wuzipu123/software/Electronic/battery_charger/parts.xlsx

ref | value5 | footprint | part | Link
C1 | 220pF | Capacitors_SMD:C_0805 | C | DigiKey
C10 | 4,7µF | Capacitors_SMD:C_0805 | C | Lagernd (geringe Anzahl)
C11 | 47nF | Capacitors_SMD:C_0805 | C | Schukat
C12 | 10nF | Capacitors_SMD:C_0805 | C | Schukat
C13 | 22pF | Capacitors_SMD:C_0805 | C | DigiKey
C14 | 1,8nF | Capacitors_SMD:C_0805 | C | DigiKey
C15 | 47nF | Capacitors_SMD:C_0805 | C | Schukat
C16 | 10nF | Capacitors_SMD:C_0805 | C | Schukat
C17 | 0,1µF | Capacitors_SMD:C_0805 | C | Lagernd
C18 | 0,1µF | Capacitors_SMD:C_0805 | C | Lagernd
C19 | 22µF | Capacitors_SMD:C_0805 | C | DigiKey
C2 | 1μF | Capacitors_SMD:C_0805 | C | Lagernd
C20 | 22µF | Capacitors_SMD:C_0805 | C | DigiKey
C21 | 10µF | Capacitors_SMD:C_0805 | C | Lagernd
C22 | 10µF | Capacitors_SMD:C_0805 | C | Lagernd
C23 | 22µF | Capacitors_SMD:C_0805 | C | DigiKey
C24 | 22µF | Capacitors_SMD:C_0805 | C | DigiKey
C3 | 0,47μF | Capacitors_SMD:C_0805 | C | DigiKey
C4 | 10µF | Capacitors_SMD:C_0805 | C | Lagernd
C5 | 10μF | Capacitors_SMD:C_0805 | C | Lagernd
C6 | 10μF | Capacitors_SMD:C_0805 | C | Lagernd
C7 | 0,33μF | Capacitors_SMD:C_0805 | C | DigiKey
C8 | 1μF | Capacitors_SMD:C_0805 | C | Lagernd
C9 | 22µF | Capacitors_SMD:C_0805 | C | DigiKey
D1 | MBRS340T3 | Diodes_SMD:D_SMC | D_Schottky | https://at.rs-online.com/web/p/gleichrichterdioden-und-schottky-dioden/5452080/
D2 | MBRS340T3 | Diodes_SMD:D_SMC | D_Schottky | https://at.rs-online.com/web/p/gleichrichterdioden-und-schottky-dioden/5452080/
D3 | MBRS340T3 | Diodes_SMD:D_SMC | D_Schottky | https://at.rs-online.com/web/p/gleichrichterdioden-und-schottky-dioden/5452080/
D4 | MBRS340T3 | Diodes_SMD:D_SMC | D_Schottky | https://at.rs-online.com/web/p/gleichrichterdioden-und-schottky-dioden/5452080/
D5 | LED | LEDs:LED_0603 | LED | Lagernd
D6 | LED | LEDs:LED_0603 | LED | Lagernd
D7 | LED | LEDs:LED_0603 | LED | Lagernd
D8 | LED | LEDs:LED_0603 | LED | Lagernd
D9 | BAT-54 | Diodes_SMD:D_SOT-23_ANK | D_Schottky | https://www.digikey.at/product-detail/de/diodes-incorporated/BAT54-7-F/BAT54-FDICT-ND/717819
J1 | Conn_01x02_Female | Connectors_Phoenix:PhoenixContact_MCV-G_02x5.08mm_Vertical | Conn_01x02_Female | Lagernd
J2 | Conn_01x04_Female | Connectors_Phoenix:PhoenixContact_MCV-G_04x5.08mm_Vertical | Conn_01x04_Female | Lagernd (2 Stück 01x02)
J3 | Conn_01x02_Female | Connectors_Phoenix:PhoenixContact_MCV-G_02x5.08mm_Vertical | Conn_01x02_Female | https://at.rs-online.com/web/p/leiterplatten-printklemmen/1930564/
L1 | 20μH | Inductors_SMD:L_Wuerth_WE-PDF_Handsoldering | L | https://at.rs-online.com/web/p/drahtgewickelte-smd-induktivitaten/7896962/
L2 | 3,3µH | Footprints:L_Wuerth_WE-PD-6033_Handsoldering | L | https://at.rs-online.com/web/p/products/7981552/
Q1 | Q_NMOS_GDS | TO_SOT_Packages_SMD:SOT-223-3_TabPin2 | Q_NMOS_GDS | https://at.rs-online.com/web/p/products/7931055/
R1 | 2,7k | Resistors_SMD:R_0805 | R | DigiKey
R10 | 220Ω | Resistors_SMD:R_0805 | R | Lagernd
R11 | 1k | Resistors_SMD:R_0805 | R | Lagernd
R12 | 820R | Resistors_SMD:R_0805 | R | DigiKey
R13 | 330Ω | Resistors_SMD:R_0805 | R | Lagernd
R14 | 4,7k | Resistors_SMD:R_0805 | R | Schukat
R15 | 47k | Resistors_SMD:R_0805 | R | Schukat
R16 | 0R | Resistors_SMD:R_0805 | R | Schukat
R17 | 330k | Resistors_SMD:R_0805 | R | Schukat
R18 | DNP | Resistors_SMD:R_0805 | R
R19 | 39k | Resistors_SMD:R_0805 | R | Schukat
R2 | 4,7k | Resistors_SMD:R_0805 | R | Schukat
R20 | 100k | Resistors_SMD:R_0805 | R | Lagernd
R21 | 390k | Resistors_SMD:R_0805 | R | Schukat
R22 | 820R | Resistors_SMD:R_0805 | R | DigiKey
R23 | 820R | Resistors_SMD:R_0805 | R | DigiKey
R24 | 820R | Resistors_SMD:R_0805 | R | DigiKey
R25 | 270k | Resistors_SMD:R_0805 | R | Lagernd
R26 | 56k | Resistors_SMD:R_0805 | R | Schukat
R27 | 100k | Resistors_SMD:R_0805 | R | Lagernd
R28 | 0R | Resistors_SMD:R_0805 | R | Schukat
R29 | 0R | Resistors_SMD:R_0805 | R | Schukat
R3 | 470Ω | Resistors_SMD:R_0805 | R | Lagernd
R30 | 0R | Resistors_SMD:R_0805 | R | Schukat
R31 | DNP | Resistors_SMD:R_0805 | R
R32 | 0,100Ω | Resistors_SMD:R_1206 | R | https://at.rs-online.com/web/p/products/0566058/
R33 | 0,100Ω | Resistors_SMD:R_1206 | R | https://at.rs-online.com/web/p/products/0566058/
R34 | 0,100Ω | Resistors_SMD:R_1206 | R | https://at.rs-online.com/web/p/products/0566058/
R35 | 0,100Ω | Resistors_SMD:R_1206 | R | https://at.rs-online.com/web/p/products/0566058/
R4 | 0,100Ω | Resistors_SMD:R_1206 | R | https://at.rs-online.com/web/p/products/0566058/
R5 | 180k | Resistors_SMD:R_0805 | R | Schukat
R6 | 0,100Ω | Resistors_SMD:R_1206 | R | https://at.rs-online.com/web/p/products/0566058/
R7 | 120k | Resistors_SMD:R_0805 | R | Schukat
R8 | 220Ω | Resistors_SMD:R_0805 | R | Lagernd
R9 | 220k | Resistors_SMD:R_0805 | R | Schukat
U1 | LT1511 | Footprints:TSOP-II-32_21.0x10.2mm_Pitch1.27mm | LT1511 | https://www.digikey.at/product-detail/de/linear-technology-analog-devices/LT1511CSW-PBF/LT1511CSW-PBF-ND/891021
U2 | LTC3118 | Housings_SSOP:TSSOP-28-1EP_4.4x9.7mm_Pitch0.65mm | LTC3118 | https://www.digikey.at/product-detail/de/linear-technology-analog-devices/LTC3118EFE-PBF/LTC3118EFE-PBF-ND/5171464
