wuzipu123/software/Electronic/Sensor_Node_LoRa_SPS30/BOM.xlsx

Sheet: SensMat_LoRa_SPS30_15Pcs.
Source: | SensMat/Electronic/Sensor_Node_LoRa_SPS30/Sensor_Node_LoRa_SPS30.sch
Date: | Do 10 May 2021 10:51:11
Tool: | Eeschema 5.1.8
Generator: | /usr/share/kicad/plugins/bom_csv_grouped_by_value_with_fp.py
Component Count: | 111
Ref | Qnty | Order | Value | Cmp name | Footprint | Description | Digikey Nr. | Digikey-Link
BT1, | 1 |  | Battery_Cell | Battery_Cell | Battery:BatteryHolder_Keystone_2998_1x6.8mm | Single-cell battery holder | 36-2998-ND | https://www.digikey.at/products/de?keywords=36-2998-ND
C1, C7, C8, C9, C10, C13, C14, C15, C16, C17, C18, C19, C20, C21, C23, C28, C29, C32, C33, | 19 |  | 100nF | C | Capacitor_SMD:C_0603_1608Metric_Pad1.05x0.95mm_HandSolder | Unpolarized capacitor | 1276-1857-1-ND | https://www.digikey.at/products/de?keywords=1276-1857-1-ND
C2, C3, C4, C5, | 4 |  | 15pF | C | Capacitor_SMD:C_0603_1608Metric_Pad1.05x0.95mm_HandSolder | Unpolarized capacitor | 1276-1296-1-ND | https://www.digikey.at/products/de?keywords=1276-1296-1-ND
C6, C11, | 2 |  | 4.7µF | C | Capacitor_SMD:C_0603_1608Metric_Pad1.05x0.95mm_HandSolder | Unpolarized capacitor | 1276-1907-1-ND | https://www.digikey.at/products/de?keywords=1276-1907-1-ND
C12, C34, C35, | 3 |  | 1uF | C | Capacitor_SMD:C_0603_1608Metric_Pad1.05x0.95mm_HandSolder | Unpolarized capacitor | 1276-1182-1-ND | https://www.digikey.at/products/de?keywords=1276-1182-1-ND
C22, | 1 |  | 0.47uF | C | Capacitor_SMD:C_0603_1608Metric_Pad1.05x0.95mm_HandSolder | Unpolarized capacitor | 1276-1895-1-ND | https://www.digikey.at/products/de?keywords=1276-1895-1-ND
C24, C36, C37, | 3 |  | 22uF | C | Capacitor_SMD:C_0603_1608Metric_Pad1.05x0.95mm_HandSolder | Unpolarized capacitor | 445-9077-1-ND | https://www.digikey.at/products/de?keywords=445-9077-1-ND
C25, C26, C27, | 3 |  | 10uF | C | Capacitor_SMD:C_0603_1608Metric_Pad1.05x0.95mm_HandSolder | Unpolarized capacitor | 587-6023-1-ND | https://www.digikey.at/products/de?keywords=587-6023-1-ND
C30, C31, | 2 |  | 6.8pF | C | Capacitor_SMD:C_0603_1608Metric_Pad1.05x0.95mm_HandSolder | Unpolarized capacitor | 1276-1793-1-ND | https://www.digikey.at/products/de?keywords=1276-1793-1-ND
D1, D2, D3, | 3 |  | LED (green) | LED | LED_SMD:LED_0603_1608Metric_Pad1.05x0.95mm_HandSolder | Light emitting diode green | 732-4980-1-ND | https://www.digikey.at/products/de?keywords=732-4980-1-ND
D4, | 1 |  | LED_Dual_red_green | LED_Dual_CCAA | LED_SMD:LED_WUERTH_WL-SBCD_0805 | Dual LED, cathodes on pins 1 and 2 | 732-150080RV54050CT-ND | https://www.digikey.at/products/de?keywords=732-150080RV54050CT-ND
D5, | 1 |  | LED (yellow) | LED | LED_SMD:LED_0603_1608Metric_Pad1.05x0.95mm_HandSolder | Light emitting diode yellow | 732-4981-6-ND | https://www.digikey.at/products/de?keywords=732-4981-6-ND
D6, D7, | 2 |  | B330 | B330 | Diode_SMD:D_SMB-SMC_Universal_Handsoldering | 30V 3A Schottky Barrier Rectifier Diode, SMC | B330-FDICT-ND | https://www.digikey.at/products/de?keywords=B330-FDICT-ND
D8, | 1 |  | SMAJ8.5A | 5KPxxA | Diode_SMD:D_SMA | 5000W unidirectional Transient Voltage Suppressor, P-600 | SMAJ8.5A-FDICT-ND | https://www.digikey.at/products/de?keywords=SMAJ8.5A-FDICT-ND
FB1, | 1 |  | Ferrite_Bead | Ferrite_Bead | Inductor_SMD:L_0805_2012Metric_Pad1.15x1.40mm_HandSolder | Ferrite bead | 541-4362-1-ND | https://www.digikey.at/products/de?keywords=541-4362-1-ND
J1, | 1 |  | Conn_01x06_Male | Conn_01x06_Male | Connector_PinHeader_2.54mm:PinHeader_1x06_P2.54mm_Vertical | Generic connector, single row, 01x06, |  | https://www.digikey.at/products/de?keywords=
J2, | 1 |  | Conn_01x03_Male | Conn_01x03_Male | Connector_PinHeader_2.54mm:PinHeader_1x03_P2.54mm_Vertical | Generic connector, single row, 01x03, |  | https://www.digikey.at/products/de?keywords=
J3, | 1 |  | USB_B_Micro | USB_B_Micro | Connector_USB:USB_Micro-B_GCT_USB3076-30-A | USB Micro Type B connector | 2073-USB3076-30-ACT-ND | https://www.digikey.at/products/de?keywords=2073-USB3076-30-ACT-ND
J4, | 1 |  | Conn_01x05 | Conn_01x05 | Connector_JST:JST_ZH_B5B-ZH-R_1x05_P1.50mm_Vertical | Generic connector, single row, 01x05, | 455-1660-ND | https://www.digikey.at/products/de?keywords=455-1660-ND
J5, | 1 |  | Micro_SD_Card_Det | Micro_SD_Card_Det | Connector_Card:microSD_HC_Hirose_DM3AT-SF-PEJM5 | Micro SD Card Socket with card detection pins | HR1964CT-ND | https://www.digikey.at/products/de?keywords=HR1964CT-ND
J6, | 1 |  | Barrel_Jack_Switch | Barrel_Jack_Switch | Connector_BarrelJack:BarrelJack_CUI_PJ-051A_Horizontal | DC Barrel Jack with an internal switch | CP-051A-ND | https://www.digikey.at/products/de?keywords=CP-051A-ND
J7, | 1 |  | Conn_01x02_Male | Conn_01x02_Male | Connector_PinSocket_2.54mm:PinSocket_1x02_P2.54mm_Vertical | Generic connector, single row, 01x02, | 900-0022053021-ND | https://www.digikey.at/products/de?keywords=900-0022053021-ND
JP1, JP2, JP3, | 3 |  | SolderJumper_2_Open | SolderJumper_2_Open | Jumper:SolderJumper-2_P1.3mm_Open_TrianglePad1.0x1.5mm | Solder Jumper, 2-pole, open |  | https://www.digikey.at/products/de?keywords=
L1, | 1 |  | 6.8uH | L | Inductor_SMD:L_Wuerth_LQS-6045 | Inductor | 732-5547-1-ND | https://www.digikey.at/products/de?keywords=732-5547-1-ND
L2, L3, | 2 |  | 10uH | L | Inductor_SMD:L_Wuerth_LQS-5040 | Inductor | 732-5519-1-ND | https://www.digikey.at/products/de?keywords=732-5519-1-ND
Q1, | 1 |  | BSS138 | BSS138 | Package_TO_SOT_SMD:SOT-23 | 50V Vds, 0.22A Id, N-Channel MOSFET, SOT-23 | BSS138CT-ND | https://www.digikey.at/products/de?keywords=BSS138CT-ND
Q2, Q3, | 2 |  | Si2343CDS | Si2343CDS | Package_TO_SOT_SMD:SOT-23 | -3.6A Id, -30V Vds, P-Channel MOSFET, SOT-23 | SI2343CDS-T1-GE3CT-ND | https://www.digikey.at/products/de?keywords=SI2343CDS-T1-GE3CT-ND
R1, R2, R3, | 3 |  | DNP | R | Resistor_SMD:R_0603_1608Metric_Pad1.05x0.95mm_HandSolder | Resistor |  | https://www.digikey.at/products/de?keywords=
R4, R8, R12, R18, R19, R20, R25, | 7 |  | 10k | R | Resistor_SMD:R_0603_1608Metric_Pad1.05x0.95mm_HandSolder | Resistor | 311-10.0KHRCT-ND | https://www.digikey.at/products/de?keywords=311-10.0KHRCT-ND
R5, R6, R7, R13, | 4 |  | 470R | R | Resistor_SMD:R_0603_1608Metric_Pad1.05x0.95mm_HandSolder | Resistor | 311-470HRCT-ND | https://www.digikey.at/products/de?keywords=311-470HRCT-ND
R9, R10, R11, | 3 |  | 22R | R | Resistor_SMD:R_0603_1608Metric_Pad1.05x0.95mm_HandSolder | Resistor | 311-22.0HRCT-ND | https://www.digikey.at/products/de?keywords=311-22.0HRCT-ND
R14, | 1 |  | 1k | R | Resistor_SMD:R_0603_1608Metric_Pad1.05x0.95mm_HandSolder | Resistor | 311-1.00KHRCT-ND | https://www.digikey.at/products/de?keywords=311-1.00KHRCT-ND
R15, R16, R17, | 3 |  | 4.7k | R | Resistor_SMD:R_0603_1608Metric_Pad1.05x0.95mm_HandSolder | Resistor | YAG3613CT-ND | https://www.digikey.at/products/de?keywords=YAG3613CT-ND
R21, R22, | 2 |  | 2.2k | R | Resistor_SMD:R_0603_1608Metric_Pad1.05x0.95mm_HandSolder | Resistor | 311-2.20KHRCT-ND | https://www.digikey.at/products/de?keywords=311-2.20KHRCT-ND
R23, R30, R32, R35, | 4 |  | 100k | R | Resistor_SMD:R_0603_1608Metric_Pad1.05x0.95mm_HandSolder | Resistor | 311-100KHRCT-ND | https://www.digikey.at/products/de?keywords=311-100KHRCT-ND
R24, | 1 |  | 20k | R | Resistor_SMD:R_0603_1608Metric_Pad1.05x0.95mm_HandSolder | Resistor | 311-20.0KHRCT-ND | https://www.digikey.at/products/de?keywords=311-20.0KHRCT-ND
R26, | 1 |  | 100m | R | Resistor_SMD:R_1206_3216Metric_Pad1.42x1.75mm_HandSolder | Resistor 1W, RS: ERJ8BWFR100V | P.10AUCT-ND | https://www.digikey.at/products/de?keywords=P.10AUCT-ND
R27, | 1 |  | 560k | R | Resistor_SMD:R_0603_1608Metric_Pad1.05x0.95mm_HandSolder | Resistor | 311-560KHRCT-ND | https://www.digikey.at/products/de?keywords=311-560KHRCT-ND
R28, | 1 |  | 130k | R | Resistor_SMD:R_0603_1608Metric_Pad1.05x0.95mm_HandSolder | Resistor | 311-130KHRCT-ND | https://www.digikey.at/products/de?keywords=311-130KHRCT-ND
R29, | 1 |  | 6.8M | R | Resistor_SMD:R_0603_1608Metric_Pad1.05x0.95mm_HandSolder | Resistor | 541-6.80MHCT-ND | https://www.digikey.at/products/de?keywords=541-6.80MHCT-ND
R31, | 1 |  | 560k | R | Resistor_SMD:R_0603_1608Metric_Pad1.05x0.95mm_HandSolder | Resistor | 311-560KHRCT-ND | https://www.digikey.at/products/de?keywords=311-560KHRCT-ND
R33, | 1 |  | 820k | R | Resistor_SMD:R_0603_1608Metric_Pad1.05x0.95mm_HandSolder | Resistor | 311-820KHRCT-ND | https://www.digikey.at/products/de?keywords=311-820KHRCT-ND
R34, | 1 |  | 91k | R | Resistor_SMD:R_0603_1608Metric_Pad1.05x0.95mm_HandSolder | Resistor | 311-91.0KHRCT-ND | https://www.digikey.at/products/de?keywords=311-91.0KHRCT-ND
SW1, SW2, | 2 |  | SW_Push | SW_Push | Button_Switch_THT:SW_Tactile_SPST_Angled_PTS645Vx58-2LFS | Push button switch, generic, two pins | SW410-ND | https://www.digikey.at/products/de?keywords=SW410-ND
SW3, | 1 |  | SW_SPDT | SW_SPDT | Button_Switch_THT:SW_CK_SK-12F17-G_7_SPDT_Angled | Switch, single pole double throw | CKN10393-ND | https://www.digikey.at/products/de?keywords=CKN10393-ND
TH1, | 1 |  | NTC 10k | Thermistor_NTC | Resistor_SMD:R_1206_3216Metric_Pad1.42x1.75mm_HandSolder | Temperature dependent resistor, negative temperature coefficient | 541-1150-1-ND | https://www.digikey.at/products/de?keywords=541-1150-1-ND
U1, | 1 |  | STM32L476RGTx | STM32L476RGTx | Package_QFP:LQFP-64_10x10mm_P0.5mm | ARM Cortex-M4 MCU, 1024KB flash, 128KB RAM, 80MHz, 1.71-3.6V, 51 GPIO, LQFP-64 | 497-19382-1-ND | https://www.digikey.at/products/de?keywords=497-19382-1-ND
U2, | 1 |  | USBLC6-2SC6 | USBLC6-2SC6 | Package_TO_SOT_SMD:SOT-23-6_Handsoldering | Very low capacitance ESD protection diode, 2 data-line, SOT-23-6 | 497-5235-1-ND | https://www.digikey.at/products/de?keywords=497-5235-1-ND
U3, | 1 |  | BME280 | BME280 | Package_LGA:Bosch_LGA-8_2.5x2.5mm_P0.65mm_ClockwisePinNumbering | 3-in-1 sensor, humidity, pressure, temperature, I2C and SPI interface, 1.71-3.6V, LGA-8 | 828-1063-1-ND | https://www.digikey.at/products/de?keywords=828-1063-1-ND
U4, | 1 |  | Lambda62-8S | Lambda62-8S | RF_Module:Lambda62-8S |  | LAMBDA62-8D-ND | https://www.digikey.at/products/de?keywords=LAMBDA62-8D-ND
U5, | 1 |  | LTC4002ES8-8.4 | LTC4002ES8-8.4 | Package_SO:SOIC-8_3.9x4.9mm_P1.27mm | Standalone Li-Ion Switch Mode Battery Charger, 8.9-22V input, double cell, SOIC-8 | LTC4002ES8-8.4#TRPBFCT-ND | https://www.digikey.at/products/de?keywords=LTC4002ES8-8.4#TRPBFCT-ND
U6, | 1 |  | TPS62050DGS | TPS62050DGS | Package_SO:MSOP-10_3x3mm_P0.5mm |  | 296-14392-1-ND | https://www.digikey.at/products/de?keywords=296-14392-1-ND
U7, | 1 |  | TPS62051DGS | TPS62051DGS | Package_SO:MSOP-10_3x3mm_P0.5mm |  | 296-41755-1-ND | https://www.digikey.at/products/de?keywords=296-41755-1-ND
Y1, | 1 |  | 32.768kHz | Crystal | Crystal:Crystal_SMD_3215-2Pin_3.2x1.5mm_HandSoldering | Two pin crystal | XC2127CT-ND | https://www.digikey.at/products/de?keywords=XC2127CT-ND
Y2, | 1 |  | 8MHz | Crystal | Crystal:Crystal_SMD_5032-2Pin_5.0x3.2mm_HandSoldering | Two pin crystal | 1253-1373-1-ND | https://www.digikey.at/products/de?keywords=1253-1373-1-ND
 | 5 |  |  | SLP3-150-250-R |  | Light Pipe | 492-2517-ND | https://www.digikey.at/products/de?keywords=492-2517-ND
 | 2 |  |  | B32-2010 |  | Cap for Button (black) | SW1139-ND | https://www.digikey.at/products/de?keywords=SW1139-ND
 | 1 |  |  | 1591CSBK |  | Case Hammond 1591CSBK | HM104-ND | https://www.digikey.at/products/de?keywords=HM104-ND
 | 1 |  |  | 1052620002 |  | PCB Antenna Molex 100mm wire | WM9669-ND | https://www.digikey.at/products/de?keywords=WM9669-ND
 | 1 |  |  | SPS30 |  | Particle Sensor SPS30 | 1649-1106-ND | https://www.digikey.at/products/de?keywords=1649-1106-ND
 | 1 |  |  | 377-376TZ |  | Coin cell battery | N110-ND | https://www.digikey.at/products/de?keywords=N110-ND
 | 1 |  |  | 22013027 |  | Battery Conn Case | 900-0022013027-ND | https://www.digikey.at/products/de?keywords=900-0022013027-ND
 | 2 |  |  | 8650804 |  | Battery Conn Crimp Contact | WM2756CT-ND | https://www.digikey.at/products/de?keywords=WM2756CT-ND
 | 1 |  |  | A05ZR05ZR28H102A |  | SPS30 Cable crossed 100mm | 455-4306-ND | https://www.digikey.at/products/de?keywords=455-4306-ND
 | 1 |  |  | 2337019-1 |  | U.FL Micro-Coax Connector | A144746CT-ND | https://www.digikey.at/products/de?keywords=A144746CT-ND
 | 3 |  |  | V5618A |  | Heatsink Assmann | AE10819-ND | https://www.digikey.at/products/de?keywords=AE10819-ND
 | 1 |  |  |  |  | Micro SD Card 8 GB | 1282-AF8GUD3-WAAIX-ND | https://www.digikey.at/products/de?keywords=1282-AF8GUD3-WAAIX-ND
 |  |  |  | SGA60E18-P1J |  | Netzteil 18V: SGA60E18-P1J | 1866-4545-ND | https://www.digikey.at/products/de?keywords=1866-4545-ND
 | 1 |  |  | PCB Board + 1 Stencil TOP | Multi-cb, 1 piece = 39.40€, 25 pcs. = 166.40€ | File: Sensor_Node_LoRa_SPS30.kicad_pcb |  | https://www.multi-circuit-boards.eu/index.html
 | 1 |  |  | Akkupack | Conrad, Ansmann: 25€ inkl. | Ansmann 2447-3030-03 |  | https://www.conrad.at/de/p/ansmann-2s1p-akkupack-2x-18650-kabel-li-ion-7-4-v-2600-mah-2227110.html
 |  |  |  | 8329TFS-25ML |  | Heatsink 2 component epoxy glue | 473-1363-ND | https://www.digikey.at/products/de?keywords=473-1363-ND
Number of different components: |  | 0

Sheet: SensMat_LoRa_SPS30
Source: | SensMat/Electronic/Sensor_Node_LoRa_SPS30/Sensor_Node_LoRa_SPS30.sch
Date: | Do 17 Dez 2020 10:51:11
Tool: | Eeschema 5.1.8
Generator: | /usr/share/kicad/plugins/bom_csv_grouped_by_value_with_fp.py
Component Count: | 111
Ref | Qnty | Qnty (x15) | existing | Value | Cmp name | Footprint | Description | Digikey Nr. | Link
BT1, | 1 | 15 |  | Battery_Cell | Battery_Cell | Battery:BatteryHolder_Keystone_2998_1x6.8mm | Single-cell battery holder | 36-2998-ND | https://www.digikey.at/products/de?keywords=36-2998-ND
C1, C7, C8, C9, C10, C13, C14, C15, C16, C17, C18, C19, C20, C21, C23, C28, C29, C32, C33, | 19 | 285 |  | 100nF | C | Capacitor_SMD:C_0603_1608Metric_Pad1.05x0.95mm_HandSolder | Unpolarized capacitor | 1276-1857-1-ND | https://www.digikey.at/products/de?keywords=1276-1857-1-ND
C2, C3, C4, C5, | 4 | 60 | 6 | 15pF | C | Capacitor_SMD:C_0603_1608Metric_Pad1.05x0.95mm_HandSolder | Unpolarized capacitor | 1276-1296-1-ND | https://www.digikey.at/products/de?keywords=1276-1296-1-ND
C6, C11, | 2 | 50 | 9 | 4.7µF | C | Capacitor_SMD:C_0603_1608Metric_Pad1.05x0.95mm_HandSolder | Unpolarized capacitor | 1276-1907-1-ND | https://www.digikey.at/products/de?keywords=1276-1907-1-ND
C12, C34, C35, | 3 |  |  | 1uF | C | Capacitor_SMD:C_0603_1608Metric_Pad1.05x0.95mm_HandSolder | Unpolarized capacitor | 1276-1182-1-ND | https://www.digikey.at/products/de?keywords=1276-1182-1-ND
C22, | 1 | 15 | 2 | 0.47uF | C | Capacitor_SMD:C_0603_1608Metric_Pad1.05x0.95mm_HandSolder | Unpolarized capacitor | 1276-1895-1-ND | https://www.digikey.at/products/de?keywords=1276-1895-1-ND
C24, C36, C37, | 3 | 50 | 2 | 22uF | C | Capacitor_SMD:C_0603_1608Metric_Pad1.05x0.95mm_HandSolder | Unpolarized capacitor | 445-9077-1-ND | https://www.digikey.at/products/de?keywords=445-9077-1-ND
C25, C26, C27, | 3 | 50 | 2 | 10uF | C | Capacitor_SMD:C_0603_1608Metric_Pad1.05x0.95mm_HandSolder | Unpolarized capacitor | 311-3494-1-ND | https://www.digikey.at/products/de?keywords=311-3494-1-ND
C30, C31, | 2 | 50 | 5 | 6.8pF | C | Capacitor_SMD:C_0603_1608Metric_Pad1.05x0.95mm_HandSolder | Unpolarized capacitor | 1276-1793-1-ND | https://www.digikey.at/products/de?keywords=1276-1793-1-ND
D1, D2, D3, | 3 | 50 | 1 | LED (green) | LED | LED_SMD:LED_0603_1608Metric_Pad1.05x0.95mm_HandSolder | Light emitting diode green | 732-4980-1-ND | https://www.digikey.at/products/de?keywords=732-4980-1-ND
D4, | 1 | 15 | 1 | LED_Dual_red_green | LED_Dual_CCAA | LED_SMD:LED_WUERTH_WL-SBCD_0805 | Dual LED, cathodes on pins 1 and 2 | 732-150080RV54050CT-ND | https://www.digikey.at/products/de?keywords=732-150080RV54050CT-ND
D5, | 1 | 15 | 1 | LED (yellow) | LED | LED_SMD:LED_0603_1608Metric_Pad1.05x0.95mm_HandSolder | Light emitting diode yellow | 732-4981-1-ND | https://www.digikey.at/products/de?keywords=732-4981-1-ND
D6, D7, | 2 | 30 | 2 | B330 | B330 | Diode_SMD:D_SMB-SMC_Universal_Handsoldering | 30V 3A Schottky Barrier Rectifier Diode, SMC | B330-FDICT-ND | https://www.digikey.at/products/de?keywords=B330-FDICT-ND
D8, | 1 |  | 49 | SMAJ8.5A | 5KPxxA | Diode_SMD:D_SMA | 5000W unidirectional Transient Voltage Suppressor, P-600 | SMAJ8.5A-FDICT-ND | https://www.digikey.at/products/de?keywords=SMAJ8.5A-FDICT-ND
FB1, | 1 | 15 | 1 | Ferrite_Bead | Ferrite_Bead | Inductor_SMD:L_0805_2012Metric_Pad1.15x1.40mm_HandSolder | Ferrite bead | 541-4362-1-ND | https://www.digikey.at/products/de?keywords=541-4362-1-ND
J1, | 1 |  |  | Conn_01x06_Male | Conn_01x06_Male | Connector_PinHeader_2.54mm:PinHeader_1x06_P2.54mm_Vertical | Generic connector, single row, 01x06, |  | https://www.digikey.at/products/de?keywords=
J2, | 1 |  |  | Conn_01x03_Male | Conn_01x03_Male | Connector_PinHeader_2.54mm:PinHeader_1x03_P2.54mm_Vertical | Generic connector, single row, 01x03, |  | https://www.digikey.at/products/de?keywords=
J3, | 1 | 15 |  | USB_B_Micro | USB_B_Micro | Connector_USB:USB_Micro-B_GCT_USB3076-30-A | USB Micro Type B connector | 2073-USB3076-30-ACT-ND | https://www.digikey.at/products/de?keywords=2073-USB3076-30-ACT-ND
J4, | 1 | 15 | 3 | Conn_01x05 | Conn_01x05 | Connector_JST:JST_ZH_B5B-ZH-R_1x05_P1.50mm_Vertical | Generic connector, single row, 01x05, | 455-1660-ND | https://www.digikey.at/products/de?keywords=455-1660-ND
J5, | 1 | 15 |  | Micro_SD_Card_Det | Micro_SD_Card_Det | Connector_Card:microSD_HC_Hirose_DM3AT-SF-PEJM5 | Micro SD Card Socket with card detection pins | HR1964CT-ND | https://www.digikey.at/products/de?keywords=HR1964CT-ND
J6, | 1 | 15 |  | Barrel_Jack_Switch | Barrel_Jack_Switch | Connector_BarrelJack:BarrelJack_CUI_PJ-051A_Horizontal | DC Barrel Jack with an internal switch | CP-051A-ND | https://www.digikey.at/products/de?keywords=CP-051A-ND
J7, | 1 | 15 | 4 | Conn_01x02_Male | Conn_01x02_Male | Connector_PinSocket_2.54mm:PinSocket_1x02_P2.54mm_Vertical | Generic connector, single row, 01x02, | 900-0022053021-ND | https://www.digikey.at/products/de?keywords=900-0022053021-ND
JP1, JP2, JP3, | 3 |  |  | SolderJumper_2_Open | SolderJumper_2_Open | Jumper:SolderJumper-2_P1.3mm_Open_TrianglePad1.0x1.5mm | Solder Jumper, 2-pole, open |  | https://www.digikey.at/products/de?keywords=
L1, | 1 | 15 |  | 6.8uH | L | Inductor_SMD:L_Wuerth_LQS-6045 | Inductor | 732-5547-1-ND | https://www.digikey.at/products/de?keywords=732-5547-1-ND
L2, L3, | 2 | 30 |  | 10uH | L | Inductor_SMD:L_Wuerth_LQS-5040 | Inductor | 732-5519-1-ND | https://www.digikey.at/products/de?keywords=732-5519-1-ND
Q1, | 1 | 15 | 1 | BSS138 | BSS138 | Package_TO_SOT_SMD:SOT-23 | 50V Vds, 0.22A Id, N-Channel MOSFET, SOT-23 | BSS138CT-ND | https://www.digikey.at/products/de?keywords=BSS138CT-ND
Q2, Q3, | 2 | 20 | 18 | Si2343CDS | Si2343CDS | Package_TO_SOT_SMD:SOT-23 | -3.6A Id, -30V Vds, P-Channel MOSFET, SOT-23 | SI2343CDS-T1-GE3CT-ND | https://www.digikey.at/products/de?keywords=SI2343CDS-T1-GE3CT-ND
R1, R2, R3, | 3 |  |  | DNP | R | Resistor_SMD:R_0603_1608Metric_Pad1.05x0.95mm_HandSolder | Resistor |  | https://www.digikey.at/products/de?keywords=
R4, R8, R12, R18, R19, R20, R25, | 7 |  |  | 10k | R | Resistor_SMD:R_0603_1608Metric_Pad1.05x0.95mm_HandSolder | Resistor | 311-10.0KHRCT-ND | https://www.digikey.at/products/de?keywords=311-10.0KHRCT-ND
R5, R6, R7, R13, | 4 |  |  | 470R | R | Resistor_SMD:R_0603_1608Metric_Pad1.05x0.95mm_HandSolder | Resistor | 311-470HRCT-ND | https://www.digikey.at/products/de?keywords=311-470HRCT-ND
R9, R10, R11, | 3 |  |  | 22R | R | Resistor_SMD:R_0603_1608Metric_Pad1.05x0.95mm_HandSolder | Resistor | 311-22.0HRCT-ND | https://www.digikey.at/products/de?keywords=311-22.0HRCT-ND
R14, | 1 |  |  | 1k | R | Resistor_SMD:R_0603_1608Metric_Pad1.05x0.95mm_HandSolder | Resistor | 311-1.00KHRCT-ND | https://www.digikey.at/products/de?keywords=311-1.00KHRCT-ND
R15, R16, R17, | 3 |  |  | 4.7k | R | Resistor_SMD:R_0603_1608Metric_Pad1.05x0.95mm_HandSolder | Resistor | YAG3613CT-ND | https://www.digikey.at/products/de?keywords=YAG3613CT-ND
R21, R22, | 2 |  |  | 2.2k | R | Resistor_SMD:R_0603_1608Metric_Pad1.05x0.95mm_HandSolder | Resistor | 311-2.20KHRCT-ND | https://www.digikey.at/products/de?keywords=311-2.20KHRCT-ND
R23, R30, R32, R35, | 4 | 100 |  | 100k | R | Resistor_SMD:R_0603_1608Metric_Pad1.05x0.95mm_HandSolder | Resistor | 311-100KHRCT-ND | https://www.digikey.at/products/de?keywords=311-100KHRCT-ND
R24, | 1 | 15 | 5 | 20k | R | Resistor_SMD:R_0603_1608Metric_Pad1.05x0.95mm_HandSolder | Resistor | 311-20.0KHRCT-ND | https://www.digikey.at/products/de?keywords=311-20.0KHRCT-ND
R26, | 1 | 15 | 5 | 100m | R | Resistor_SMD:R_1206_3216Metric_Pad1.42x1.75mm_HandSolder | Resistor 1W, RS: ERJ8BWFR100V | P.10AUCT-ND | https://www.digikey.at/products/de?keywords=P.10AUCT-ND
R27, | 1 |  | 49 | 510k | R | Resistor_SMD:R_0603_1608Metric_Pad1.05x0.95mm_HandSolder | Resistor | 311-510KHRCT-ND | https://www.digikey.at/products/de?keywords=311-510KHRCT-ND
R28, | 1 | 15 | 5 | 130k | R | Resistor_SMD:R_0603_1608Metric_Pad1.05x0.95mm_HandSolder | Resistor | 311-130KHRCT-ND | https://www.digikey.at/products/de?keywords=311-130KHRCT-ND
R29, | 1 |  | 49 | 3.9M | R | Resistor_SMD:R_0603_1608Metric_Pad1.05x0.95mm_HandSolder | Resistor | 541-3.90MHCT-ND | https://www.digikey.at/products/de?keywords=541-3.90MHCT-ND
R31, | 1 | 15 | 5 | 560k | R | Resistor_SMD:R_0603_1608Metric_Pad1.05x0.95mm_HandSolder | Resistor | 311-560KHRCT-ND | https://www.digikey.at/products/de?keywords=311-560KHRCT-ND
R33, | 1 | 15 | 5 | 820k | R | Resistor_SMD:R_0603_1608Metric_Pad1.05x0.95mm_HandSolder | Resistor | 311-820KHRCT-ND | https://www.digikey.at/products/de?keywords=311-820KHRCT-ND
R34, | 1 | 15 | 5 | 91k | R | Resistor_SMD:R_0603_1608Metric_Pad1.05x0.95mm_HandSolder | Resistor | 311-91.0KHRCT-ND | https://www.digikey.at/products/de?keywords=311-91.0KHRCT-ND
SW1, SW2, | 2 | 30 |  | SW_Push | SW_Push | Button_Switch_THT:SW_Tactile_SPST_Angled_PTS645Vx58-2LFS | Push button switch, generic, two pins | SW410-ND | https://www.digikey.at/products/de?keywords=SW410-ND
SW3, | 1 | 15 |  | SW_SPDT | SW_SPDT | Button_Switch_THT:SW_CK_SK-12F17-G_7_SPDT_Angled | Switch, single pole double throw | CKN10393-ND | https://www.digikey.at/products/de?keywords=CKN10393-ND
TH1, | 1 | 15 | 1 | NTC 10k | Thermistor_NTC | Resistor_SMD:R_1206_3216Metric_Pad1.42x1.75mm_HandSolder | Temperature dependent resistor, negative temperature coefficient | 541-1150-1-ND | https://www.digikey.at/products/de?keywords=541-1150-1-ND
U1, | 1 | 15 |  | STM32L476RGTx | STM32L476RGTx | Package_QFP:LQFP-64_10x10mm_P0.5mm | ARM Cortex-M4 MCU, 1024KB flash, 128KB RAM, 80MHz, 1.71-3.6V, 51 GPIO, LQFP-64 | 497-19382-1-ND | https://www.digikey.at/products/de?keywords=497-19382-1-ND
U2, | 1 | 16 |  | USBLC6-2SC6 | USBLC6-2SC6 | Package_TO_SOT_SMD:SOT-23-6_Handsoldering | Very low capacitance ESD protection diode, 2 data-line, SOT-23-6 | 497-5235-1-ND | https://www.digikey.at/products/de?keywords=497-5235-1-ND
U3, | 1 | 15 |  | BME280 | BME280 | Package_LGA:Bosch_LGA-8_2.5x2.5mm_P0.65mm_ClockwisePinNumbering | 3-in-1 sensor, humidity, pressure, temperature, I2C and SPI interface, 1.71-3.6V, LGA-8 | 828-1063-1-ND | https://www.digikey.at/products/de?keywords=828-1063-1-ND
U4, | 1 | 9 | 6 | Lambda62-8S | Lambda62-8S | RF_Module:Lambda62-8S |  | LAMBDA62-8D-ND | https://www.digikey.at/products/de?keywords=LAMBDA62-8D-ND
U5, | 1 | 25 | 2 | LTC4002ES8-8.4 | LTC4002ES8-8.4 | Package_SO:SOIC-8_3.9x4.9mm_P1.27mm | Standalone Li-Ion Switch Mode Battery Charger, 8.9-22V input, double cell, SOIC-8 | LTC4002ES8-8.4#PBF-ND | https://www.digikey.at/products/de?keywords=LTC4002ES8-8.4#PBF-ND
U6, | 1 | 16 |  | TPS62050DGS | TPS62050DGS | Package_SO:MSOP-10_3x3mm_P0.5mm |  | 296-14392-1-ND | https://www.digikey.at/products/de?keywords=296-14392-1-ND
U7, | 1 | 15 | 1 | TPS62051DGS | TPS62051DGS | Package_SO:MSOP-10_3x3mm_P0.5mm |  | 296-41755-1-ND | https://www.digikey.at/products/de?keywords=296-41755-1-ND
Y1, | 1 | 16 |  | 32.768kHz | Crystal | Crystal:Crystal_SMD_3215-2Pin_3.2x1.5mm_HandSoldering | Two pin crystal | XC2127CT-ND | https://www.digikey.at/products/de?keywords=XC2127CT-ND
Y2, | 1 | 16 |  | 8MHz | Crystal | Crystal:Crystal_SMD_5032-2Pin_5.0x3.2mm_HandSoldering | Two pin crystal | 1253-1373-1-ND | https://www.digikey.at/products/de?keywords=1253-1373-1-ND
 | 5 | 100 |  |  | SLP3-150-250-R |  | Light Pipe | 492-2517-ND | https://www.digikey.at/products/de?keywords=492-2517-ND
 | 2 | 32 |  |  | B32-2010 |  | Cap for Button (black) | SW1139-ND | https://www.digikey.at/products/de?keywords=SW1139-ND
 | 1 | 15 |  |  | 1591CSBK |  | Case Hammond 1591CSBK | HM104-ND | https://www.digikey.at/products/de?keywords=HM104-ND
 | 1 | 15 |  |  | 1052620002 |  | PCB Antenna Molex 100mm wire | WM9669-ND | https://www.digikey.at/products/de?keywords=WM9669-ND
 | 1 | 15 |  |  | SPS30 |  | Particle Sensor SPS30 | 1649-1106-ND | https://www.digikey.at/products/de?keywords=1649-1106-ND
 | 1 | 15 |  |  | 377-376TZ |  | Coin cell battery | N110-ND | https://www.digikey.at/products/de?keywords=N110-ND
 | 1 | 15 | 1 |  | 22013027 |  | Battery Conn Case | 900-0022013027-ND | https://www.digikey.at/products/de?keywords=900-0022013027-ND
 | 2 | 40 |  |  | 8650804 |  | Battery Conn Crimp Contact | WM2756CT-ND | https://www.digikey.at/products/de?keywords=WM2756CT-ND
 | 1 | 15 |  |  | A05ZR05ZR28H102A |  | SPS30 Cable crossed 100mm | 455-4306-ND | https://www.digikey.at/products/de?keywords=455-4306-ND
 | 1 | 15 | 1 |  | 2337019-1 |  | U.FL Micro-Coax Connector | A144746CT-ND | https://www.digikey.at/products/de?keywords=A144746CT-ND
 | 3 | 45 | 2 |  | V5618A |  | Heatsink Assmann | AE10819-ND | https://www.digikey.at/products/de?keywords=AE10819-ND
 | 1 | 15 |  |  |  |  | Micro SD Card 8 GB | 1282-AF8GUD3-WAAIX-ND | https://www.digikey.at/products/de?keywords=1282-AF8GUD3-WAAIX-ND
 | 1 | 15 |  |  | PCB Board + 1 Stencil TOP | Multi-cb, 1 piece = 39.40€, 25 pcs. = 166.40€ | File: Sensor_Node_LoRa_SPS30.kicad_pcb
 | 1 | 15 |  |  | Akkupack | Conrad, Ansmann: 25€ inkl. | Ansmann 2447-3030-03 |  | https://www.conrad.at/de/p/ansmann-2s1p-akkupack-2x-18650-kabel-li-ion-7-4-v-2600-mah-2227110.html
 |  |  |  |  | 8329TFS-25ML |  | Heatsink 2 component epoxy glue | 473-1363-ND | https://www.digikey.at/products/de?keywords=473-1363-ND
Number of different items: |  | 55

Sheet: Costs
Digikey | €2021.02
multi-cb | €177.85 | incl. delivery
Conrad | €520.62 | Ansmann battery pack, netto
 | €2719.49
per Node (netto): | €108.78
per Node (brutto): | €130.54

Sheet: Tabelle3
Menge | Herst.Teile-Nr. | RS Best.-Nr. | Link
10 Stk. (2 Pkg.) | ERJ8BWFR100V | 566-058 | https://at.rs-online.com/web/p/smd-widerstande/0566058/
50 Stk. (1 Pkg.) | CRCW06033M90FKEA | 679-0358 | https://at.rs-online.com/web/p/smd-widerstande/6790358/
50 Stk. (1 Pkg.) | CRCW0603510KFKEA | 679-0500 | https://at.rs-online.com/web/p/smd-widerstande/6790500/
20 Stk. (1 Pkg.) | SI2343CDS-T1-GE3 | 812-3120 | https://at.rs-online.com/web/p/mosfet/8123120/
20 Stk. (1 Pkg.) | PMEG6010CEH,115 | 508-933 | https://at.rs-online.com/web/p/gleichrichterdioden-und-schottky-dioden/0508933/
TVS Dioden
 | SMBJ8.5A-E3/52 | 710-3535 | https://at.rs-online.com/web/p/suppressordioden-tvs/7103535/
 | SMBJ8.0A-E3/52 | 819-3737 | https://at.rs-online.com/web/p/suppressordioden-tvs/8193737/
 | SMAJ8.5A-13-F | 822-8607 | https://at.rs-online.com/web/p/suppressordioden-tvs/8228607/ | smallest size, only 10uA Rest-Sperrstrom
