wuzipu123/software/Electronic/DC2045A/DC2045A-2-CF.XLS

Item | Qty | Reference | Part Description | Manufacturer / Part #
 |  | REQUIRED CIRCUIT COMPONENTS:
1 | 2 | C1, C4 | CAP CER 22UF 25V 20% X7R 1812 | TDK, C4532X7R1E226M
2 | 3 | C2, C5, C9 | CAP CER 1UF 25V 10% X7R 0603 | Ttdk, C1608X7R1E105K
3 | 2 | C7, C8 | CAP., 47UF, X5R, 10V, 20% 1812 | TDK, C4532X5R1A476M280KA | X
4 | 1 | C10 | CAP CER 1800PF 50V 5% C0G 0603 | TDK, CGJ3E2C0G1H182J080AA
5 | 1 | C11 | CAP., 22PF, NPO, 25V, 10% 0603 | KEMET, C0603C220K3GACTU | X
6 | 2 | C12, C13, | CAP CER 0.1UF 25V 10% X7R 0603 | TDK, C1608X7R1E104K
7 | 2 | C14, C17 | CAP CER 0.047UF 50V 10% X7R 0603 | TDK, C1608X7R1E473K | X
8 | 2 | C15, C16 | CAP CER 10000PF 25V 10% X7R 0603 | TDK, C1608X7R1E103K080AA
9 | 1 | C18 | CAP CER 4.7uF 6.3V X5R 20% 0603 | TDK, C1608X5R0J475M
10 | 1 | D1 | DIODE SCHOTTKY 30V 0.2A SOD523F | FAIRCHILD SEMI., BAT54XV2
11 | 1 | L1 | INDUCTOR, PWR., SHIELED, 3.3uH. XAL 40xx Series | COILCRAFT, XAL4030-332ME
12 | 1 | R1 | RES 402K OHM 1/16W 1% 0402 SMD | VISHAY, CRCW0402402KFKED
13 | 1 | R2 | RES 100K OHM 1/16W 1% 0402 SMD | VISHAY, CRCW0402100KFKED
14 | 1 | R3 | RES RES 40.2K OHM 1/16W 1% 0402 SMD | VISHAY, CRCW040240K2FKED
15 | 5 | R4, R6, R8, R9, R10 | RES, 1.00M OHM 1/16W 1% 0402 SMD | VISHAY, CRCW04021M00FKED
16 | 1 | R5 | RES 715K OHM 1/16W 1% 0402 SMD | VISHAY, CRCW0402715KFKED
17 | 1 | R7 | RES 374K OHM 1/16W 1% 0402 SMD | VISHAY, CRCW0402374KFKED
18 | 1 | R11 | RES 49.9 OHM 1/16W 1% 0402 SMD | VISHAY, CRCW040249R9FKED
19 | 1 | U1 | 18V, 2A BUCK-BOOST DC/DC CONVERTER WITH LOW-LOSS DUAL INPUT POWERPATH | LINEAR TECHNOLOGY, LTC3118EUFD
 |  | ADDITIONAL DEMO BOARD CIRCUIT COMPONENTS:
1 | 0 | C3, C6 | CAP ALUM 150uF 50V 20% RADIAL (OPT) | PANASONIC, EEU-FM1H151
2 | 0 | C19, C20,C21 | CAP CER 25V 10% X7R 0603 (OPT)
3 | 0 | R12 | RES 0402 (OPT)
 |  | HARDWARE-FOR DEMO BOARD ONLY:
1 | 12 | E1-E12 | TP, TURRET, 0.094", MTG. HOLE | MILL-MAX, 2501-2-00-80-00-00-07-0
2 | 2 | JP1, JP2 | JMP, 3PIN 1 ROW .079CC | SAMTEC, TMM-103-02-L-S
3 | 2 | XJP1,XJP2 | SHUNT, 2mm | SAMTEC, 2SN-BK-G
4 | 4 | STAND OFF | STAND-OFF, NYLON 0.625" TALL | KEYSTONE, 8834 (SNAP ON)
