wuzipu123/software/Docs/Sensorhub_Bauteile.xlsx

Sheet: Mutterplatine
Bezeichnung | Bauteil | Anzahl | Package | RS Best.-Nr. | DigiKey-Link
LTC3118-UFD | DC/DC Schaltregler | 1 | 24-QFN |  | https://www.digikey.at/products/de?keywords=LTC3118EUFD%23PBF-ND%20
MAX13432EESD+ | RS485 Treiber | 1 | 14-SOIC |  | https://www.digikey.at/products/de?keywords=MAX13432EESD%2B-ND
TPD2S017DBVR | ESD Protection | 1 | SOT-23-6 |  | https://www.digikey.at/product-detail/de/texas-instruments/TPD2S017DBVR/296-25216-1-ND/2172703
BAT54XV2T1G | Diode | 1 | SOD-523 |  | https://www.digikey.at/product-detail/de/on-semiconductor/BAT54XV2T1G/BAT54XV2T1GOSCT-ND/917815
PCMB053T-3R3MS | Spule | 1 | 1919 (4848 M) |  | https://www.digikey.at/product-detail/de/susumu/PCMB053T-3R3MS/408-1520-1-ND/3671988
USB - Micro-B | USB - Micro-B | 1 |  |  | https://www.digikey.at/product-detail/de/amphenol-icc-fci/10118192-0001LF/609-4613-1-ND/2785378
TERM BLOCK PLUG | Stecker | 1 | 6POS STR 5.08MM |  | https://www.digikey.at/products/de/connectors-interconnects/terminal-blocks-headers-plugs-and-sockets/370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
TERM BLOCK HDR | Header | 1 | 6POS VERT 5.08MM |  | https://www.digikey.at/products/de?keywords=1755778
MBRS340T3G | Diode | 3 | DO-214AB | 545-2080 | https://www.digikey.at/product-detail/de/on-semiconductor/MBRS340T3G/MBRS340T3GOSCT-ND/918009
Micro SD-Card Holder | Micro SD-Card Holder | 1 |  | 720-6072
NX3225GD-8MHZ | Quartz | 1 | 2 Pin 3,2 x 2,5 |  | https://www.digikey.at/product-detail/de/ndk-america-inc/NX3225GD-8MHZ-STD-CRA-3/644-1178-1-ND/3125567
QTC232.76812B2R | Quartz | 1 | 2 Pin 2 x 1,2 | 814-9346
SHT31 | Temp. & Feuchtesens. | 1 | 8-DFN | 876-5061 | https://www.digikey.at/product-detail/de/sensirion-ag/SHT31-ARP-B/1649-1012-1-ND/5872293
MAX3221ECPWR | RS-232 Transceiver | 1 | 16-TSSOP | 527-019 | https://www.digikey.at/product-detail/de/texas-instruments/MAX3221IPWR/296-9596-1-ND/379778
BQ7791500PWR | Battery Balancer | 1 | 24-TSSOP |  | https://www.digikey.at/product-detail/de/texas-instruments/BQ7791500PWR/296-50995-1-ND/9745359
MAX9063EUK+T | Komparator | 1 | SOT-23-5 |  | https://www.digikey.at/product-detail/de/maxim-integrated/MAX9063EUK-T/MAX9063EUK-TCT-ND/5821429
LT1511CSW#PBF | Power Charger | 1 | 24-SOIC | 545-6846 | https://www.digikey.at/product-detail/de/linear-technology-analog-devices/LT1511CSW-PBF/LT1511CSW-PBF-ND/891021
TPS22929DDBVT | Power Switch/Driver | 6 | SOT-23-6 |  | https://www.digikey.at/product-detail/de/texas-instruments/TPS22929DDBVT/296-30174-1-ND/2812728
LDK130M33RY | Spannungsregler | 1 | SOT-23-5 | 175-1743
STM32L476RGT6 | Mikrocontroller | 1 | 64-LQFP | 896-7692 | https://www.digikey.at/product-detail/de/stmicroelectronics/STM32L476RGT6/497-15877-ND/5344353
Battery Holder | Battery Holder | 1 |  | 364-4222
CSD18534Q5A | Transistor | 2 | 8-VSONP |  | https://www.digikey.at/product-detail/de/texas-instruments/CSD18534Q5A/296-35583-1-ND/3830024
7447714220 | Spule | 1 | 1010 M | 789-6962
Printklemme / Buchse | Stecker | 1 |  | 897-1219
Printklemme / Stecker | Header | 1 |  | 897-1238

Sheet: Tochterplatine OPC-N3
Bezeichnung | Bauteil | Anzahl | Package | RS Best.-Nr. | DigiKey-Link
LDK130M33RY | Spannungsregler | 1 | SOT-23-5 | 175-1743
MAX13432EESD+ | RS485 Treiber | 1 | 14-SOIC | 786-0893 | https://www.digikey.at/products/de?keywords=MAX13432EESD%2B-ND
74LVC1T45GW,125 | ESD-Schutz | 4 | 6-TSSOP | 816-8791 | https://www.digikey.at/product-detail/de/nexperia-usa-inc/74LVC1T45GW,125/1727-4560-1-ND/2530939
STM32L051K8T6 | Mikrocontroller | 1 | 32-LQFP |  | https://www.digikey.at/product-detail/de/stmicroelectronics/STM32L051K8T6/497-14901-ND/4935250

Sheet: Tochterplatine SPS30
Bezeichnung | Bauteil | Anzahl | Package | RS Best.-Nr. | DigiKey-Link
LDK130M33RY | Spannungsregler | 1 | SOT-23-5 | 175-1743
MAX13432EESD+ | RS485 Treiber | 1 | 14-SOIC | 786-0893 | https://www.digikey.at/products/de?keywords=MAX13432EESD%2B-ND
PESD2CAN,215 | ESD-Schutz | 4 | TO-236-3 | 508-462 | https://www.digikey.at/product-detail/de/nexperia-usa-inc/PESD2CAN215/1727-3891-1-ND/1589996
STM32L051K8T6 | Mikrocontroller | 1 | 32-LQFP |  | https://www.digikey.at/product-detail/de/stmicroelectronics/STM32L051K8T6/497-14901-ND/4935250

Sheet: Gehäuse & Komponenten
Bezeichnung | Teil | Anzahl | Link
Alubos ABP 1680-0150 | Gehäuseprofil | 1 | https://www.bopla.de/gehaeusetechnik/product/alubos/alubos-1680-gehaeuseprofile/abp-1680-0150.html
Alubos ABD 1680 | Abschlussdeckel | 2 | https://www.bopla.de/gehaeusetechnik/product/alubos/alubos-zubehoer/abd-1680.html
GQ16F-10/J/S | Drucktaster | 2 | https://www.conrad.at/de/p/tru-components-gq16f-10-j-s-vandalismusgeschuetzter-drucktaster-48-v-dc-2-a-1-x-aus-ein-ip65-tastend-1-st-701816.html
HR10-10R-C | Schutzkappe | 5 | https://at.rs-online.com/web/p/staubkappen-rundsteckverbinder/7645060/
HR10A-10P-12S(73) | Buchse (Kabel) | 2 | https://at.rs-online.com/web/p/industrie-automation-steckverbinder/5364905/
HR10-10R-12P(73) | Stecker (Panel) | 5 | https://at.rs-online.com/web/p/industrie-automation-steckverbinder/6080248/
721AFMS | DC Power Jack | 1 | https://www.mouser.at/ProductDetail/502-721AFMS
Q6F7BXXG02E | LED Grün | 1 | https://www.mouser.at/ProductDetail/Apem/Q6F7BXXG02E
Q6F7BXXR02 | LED Rot | 1 | https://www.mouser.at/ProductDetail/Apem/Q6F7BXXR02
Q6F7BXXY02E | LED Gelb | 1 | https://www.mouser.at/ProductDetail/Apem/Q6F7BXXY02E
H8800VAAAB | Wippschalter | 1 | https://www.mouser.at/ProductDetail/167-H8800VAAAB
