wuzipu123/software/Docs/Tutorials/Material_Git_Programming_mbed.txt

Git:
https://rogerdudler.github.io/git-guide/

C:
https://www.win.tue.nl/~mholende/automotive/introduction_to_c.pdf

C++:
https://www.kth.se/social/files/552f8783f2765478ba210e15/DH2323%202%20CppIntro.pdf

mbed:
https://os.mbed.com/docs/mbed-os/v5.12/introduction/index.html
