wuzipu123/software/Mechanical/Housing/Box.SLDASM

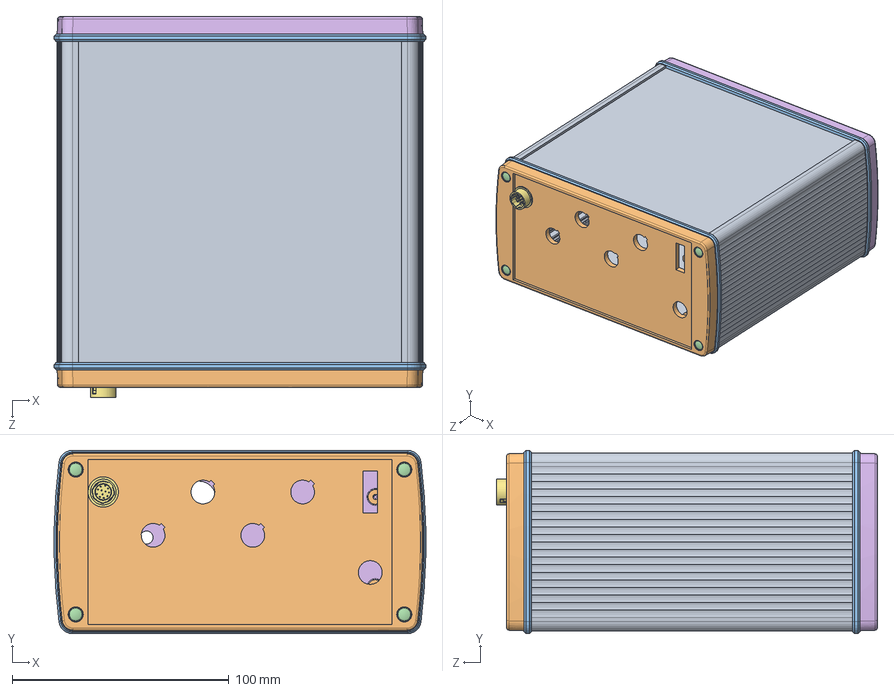
[picture p31: CAD file, 2024-06-28]
Mechanical/Housing/Box.SLDASM
171.4 x 84.6 x 175.8 mm
84680150_ABP-1680-0150
ABD 1680_1009800_3D_back
DI 1680_1008097_3DSYM x 2
1009410_3D x 8
SHR Z KT30X10 WN 1452 OG_3DSYM x 8
ABD 1680_1009800_3D_front
HR10-10R-12P
