wuzipu123/software/Electronic/Mutterplatine_V2/Components/usb_609-4613-1-ND.stp

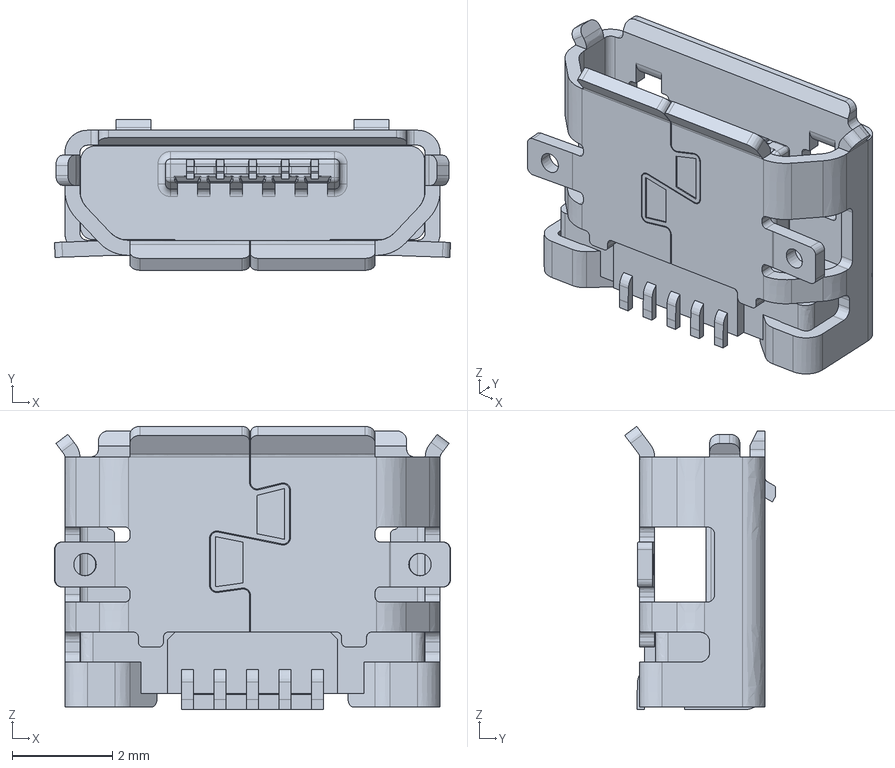
[picture p32: CAD file, 2024-06-28]
Electronic/Mutterplatine_V2/Components/usb_609-4613-1-ND.stp
7.91 x 3.01 x 5.66 mm
