wuzipu123/software/Mechanical/3D_printed/akkuholder.SLDPRT

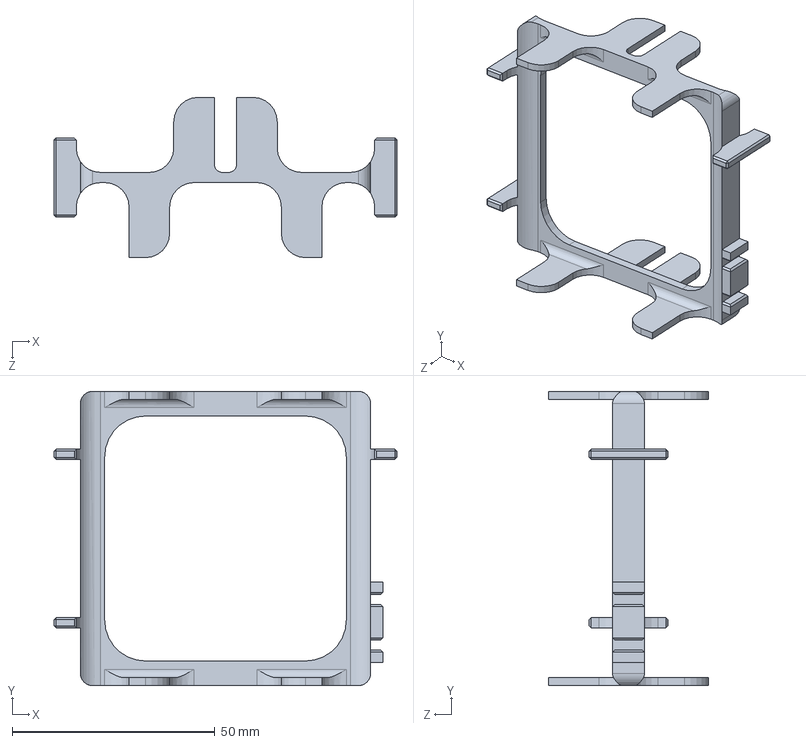
[picture p33: CAD file, 2024-06-28]
Mechanical/3D_printed/akkuholder.SLDPRT
84.5 x 72.5 x 39.5 mm
