wuzipu123/software/Mechanical/Connectors/HR10-10R-12P.SLDPRT

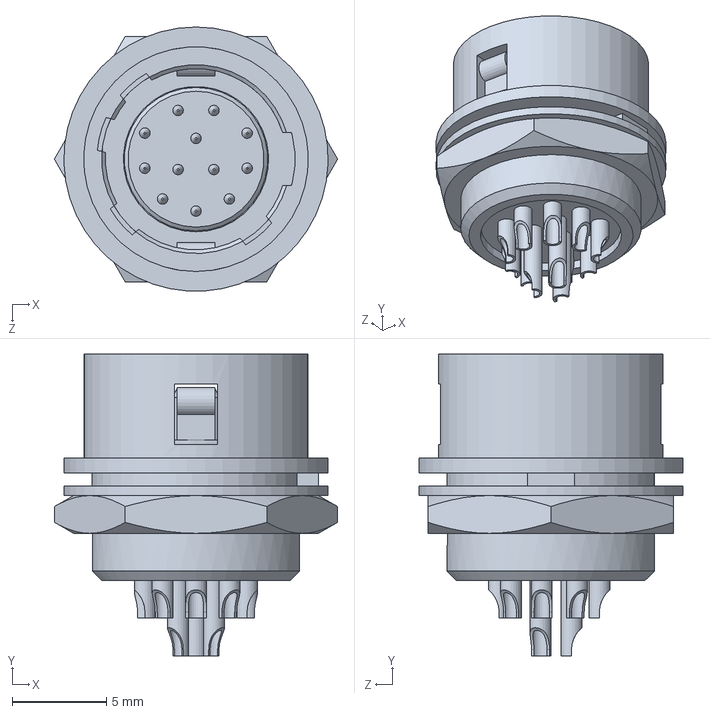
[picture p34: CAD file, 2024-06-28]
Mechanical/Connectors/HR10-10R-12P.SLDPRT
15.0 x 16.0 x 14.0 mm
