wuzipu123/software/Mechanical/Particle_Sensor/downloaded_3D_models/Inductor_WE-LQS-5040.stp

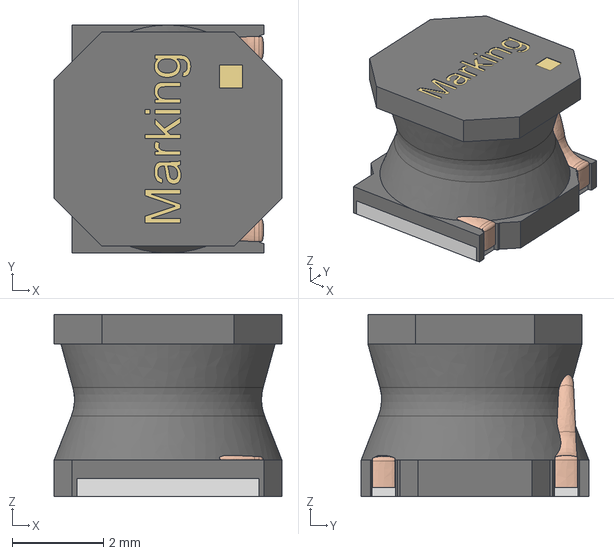
[picture p35: CAD file, 2024-06-28]
Mechanical/Particle_Sensor/downloaded_3D_models/Inductor_WE-LQS-5040.stp
5.00 x 5.00 x 4.00 mm
