wuzipu123/software/Simulation/CETMA/Simple_case/geometry.stp

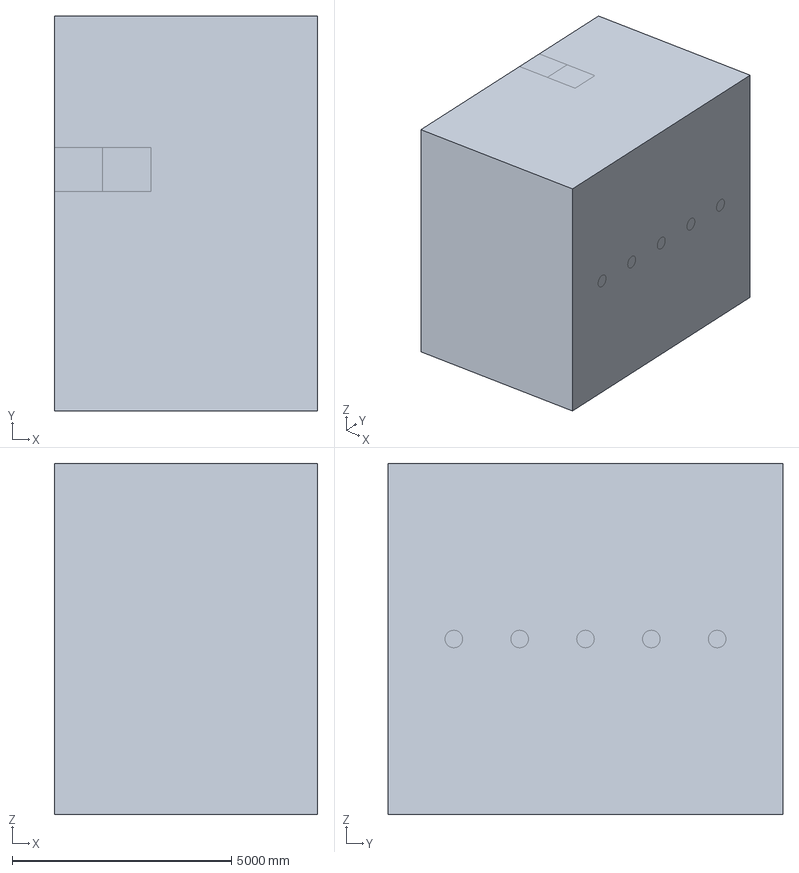
[picture p36: CAD file, 2024-06-28]
Simulation/CETMA/Simple_case/geometry.stp
6000.0 x 9000.0 x 8000.0 mm
