wuzipu123/software/Simulation/IUAV/SIM 01.dxf

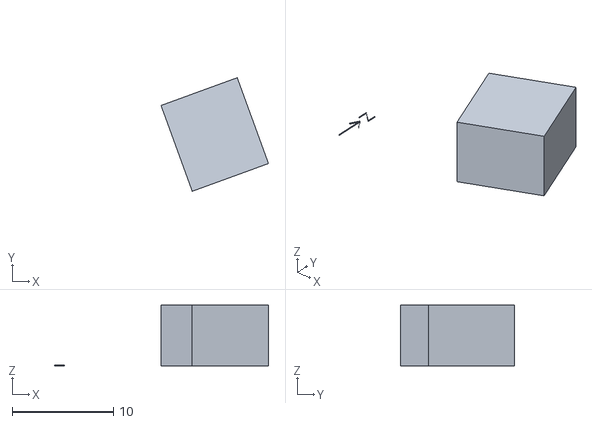
[picture p37: CAD file, 2024-06-28]
Simulation/IUAV/SIM 01.dxf
21.1 x 11.2 x 6.00
