wuzipu123/software/Mechanical/3D_printed/akkuholder_endpart.SLDPRT

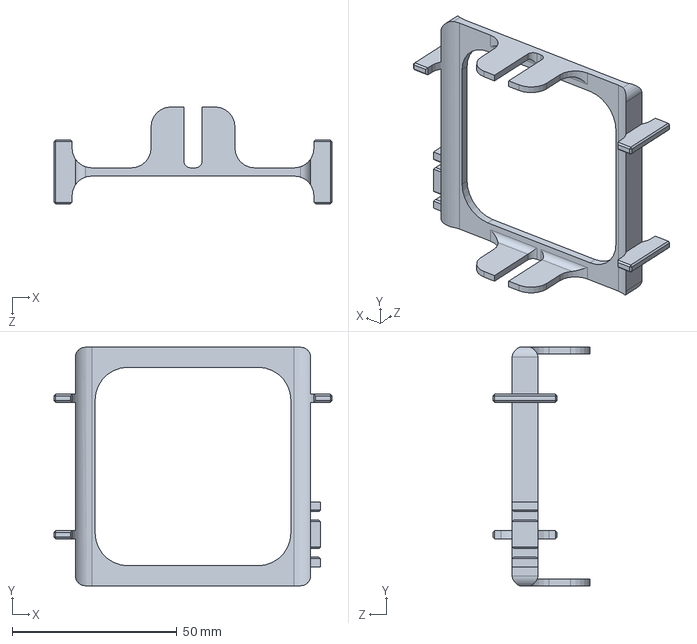
[picture p38: CAD file, 2024-06-28]
Mechanical/3D_printed/akkuholder_endpart.SLDPRT
84.5 x 72.5 x 29.5 mm
