wuzipu123/software/Mechanical/Particle_Sensor/downloaded_3D_models/Inductor_WE-LQS-6045.stp

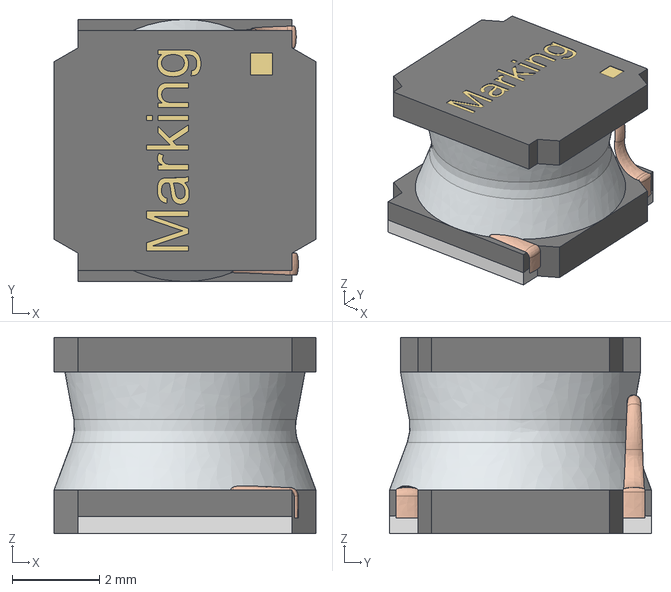
[picture p39: CAD file, 2024-06-28]
Mechanical/Particle_Sensor/downloaded_3D_models/Inductor_WE-LQS-6045.stp
6.00 x 6.00 x 4.50 mm
