wuzipu123/software/Mechanical/3D_printed/connector_plug.SLDPRT

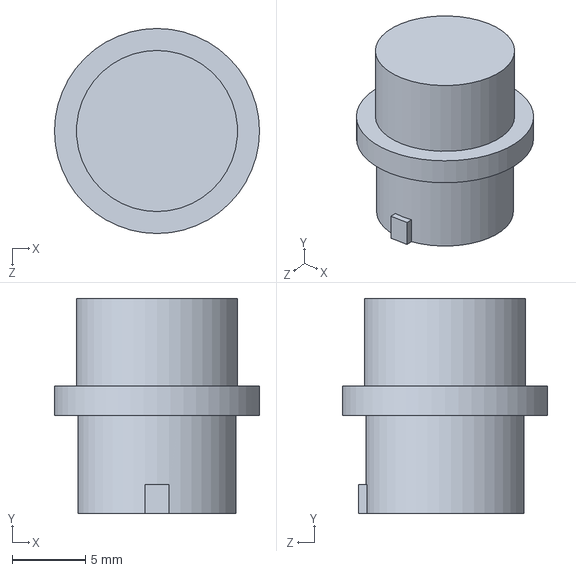
[picture p40: CAD file, 2024-06-28]
Mechanical/3D_printed/connector_plug.SLDPRT
14.0 x 14.7 x 14.0 mm
