wuzipu123/software/Mechanical/Particle_Sensor/downloaded_3D_models/Case_1591CSBK.stp

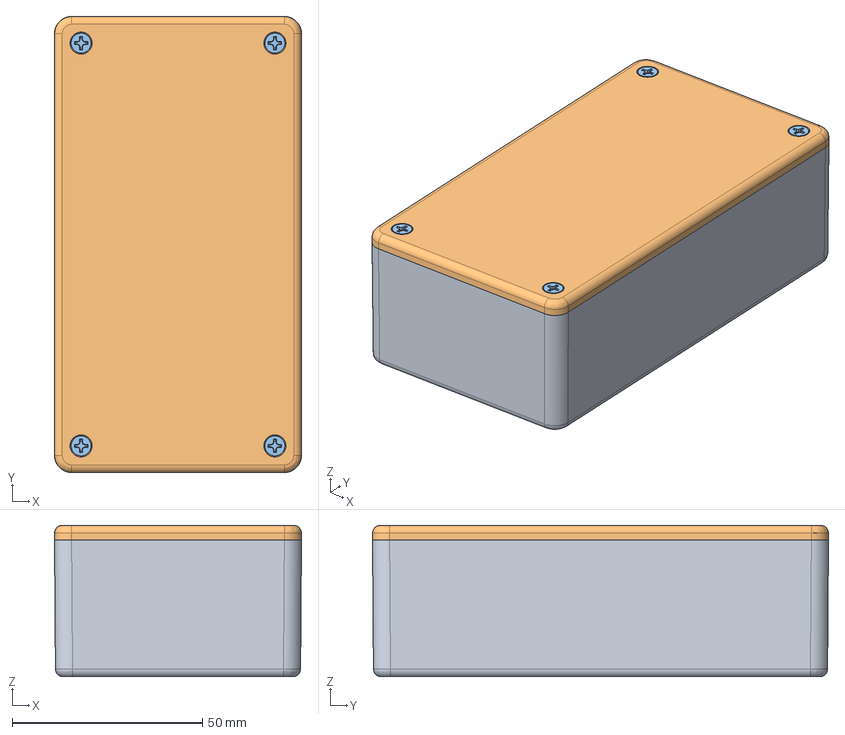
[picture p41: CAD file, 2024-06-28]
Mechanical/Particle_Sensor/downloaded_3D_models/Case_1591CSBK.stp
65.0 x 120.0 x 39.8 mm
1591CS Box
1591C Lid
