wuzipu123/software/Mechanical/3D_printed/sdcard_panel.SLDPRT

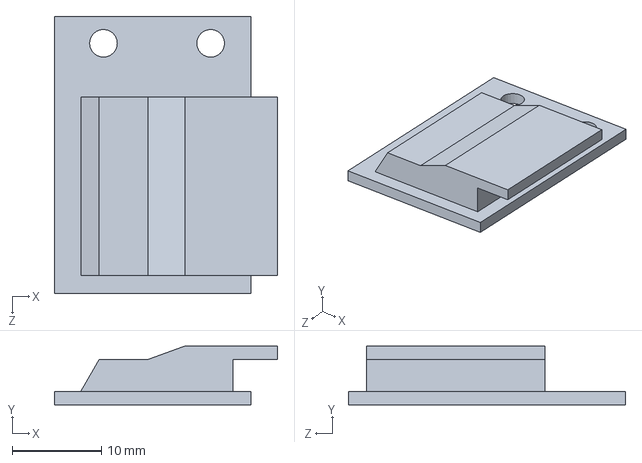
[picture p42: CAD file, 2024-06-28]
Mechanical/3D_printed/sdcard_panel.SLDPRT
25.0 x 6.60 x 31.0 mm
