wuzipu123/software/Mechanical/Particle_Sensor/downloaded_3D_models/Micro_USB_Connector_USB3076-30-A.stp

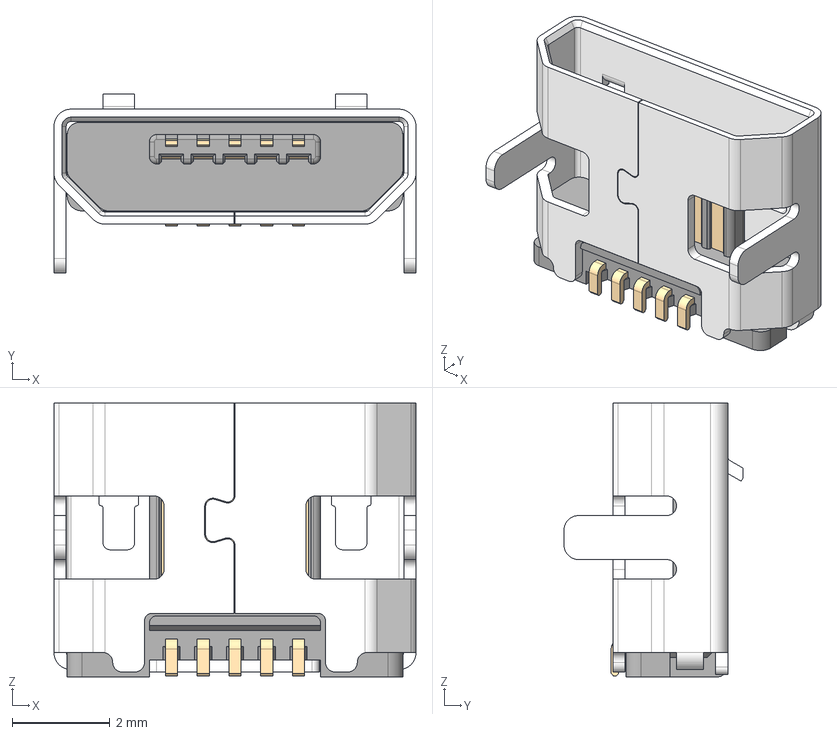
[picture p43: CAD file, 2024-06-28]
Mechanical/Particle_Sensor/downloaded_3D_models/Micro_USB_Connector_USB3076-30-A.stp
7.40 x 3.66 x 5.60 mm
圆角1
Imported1
