wuzipu123/software/Mechanical/Particle_Sensor/downloaded_3D_models/Push_button_B3F_3152.step

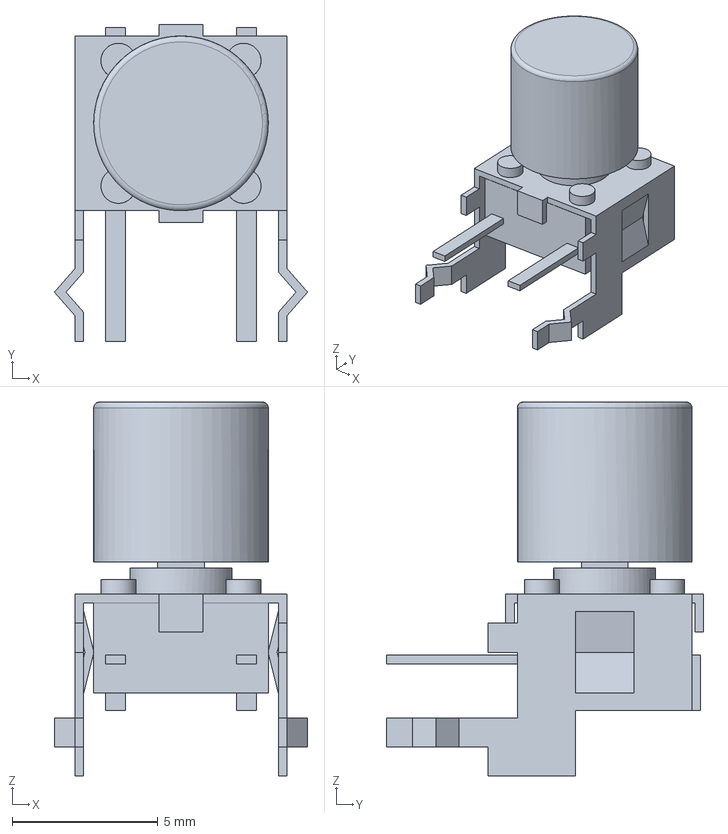
[picture p44: CAD file, 2024-06-28]
Mechanical/Particle_Sensor/downloaded_3D_models/Push_button_B3F_3152.step
8.70 x 10.9 x 12.9 mm
