wuzipu123/software/Mechanical/Particle_Sensor/downloaded_3D_models/Power_Connector_CUI_PJ-051A.step

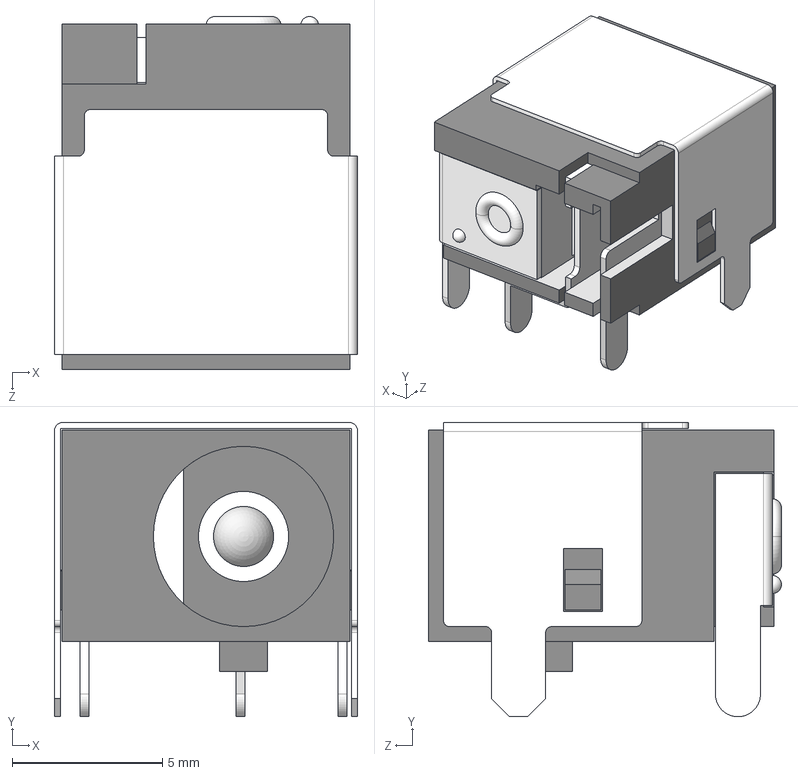
[picture p46: CAD file, 2024-06-28]
Mechanical/Particle_Sensor/downloaded_3D_models/Power_Connector_CUI_PJ-051A.step
10.1 x 9.80 x 11.8 mm
