wuzipu123/software/Mechanical/Particle_Sensor/downloaded_3D_models/Light_Pipe_SLP3-150-250-F.IGS

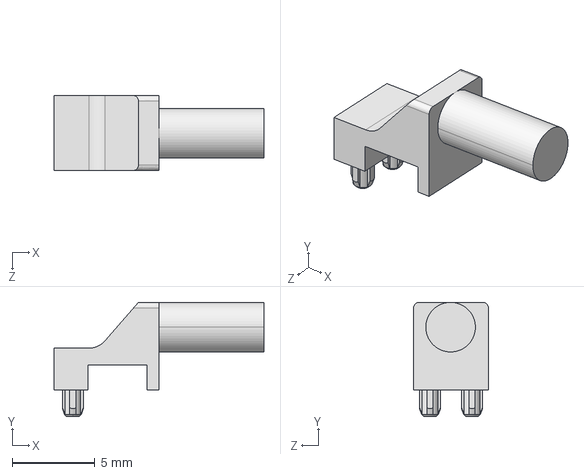
[picture p47: CAD file, 2024-06-28]
Mechanical/Particle_Sensor/downloaded_3D_models/Light_Pipe_SLP3-150-250-F.IGS
12.7 x 6.91 x 4.52 mm
