wuzipu123/software/Mechanical/Housing/ABD 1680_1009800_3D_back.sldprt

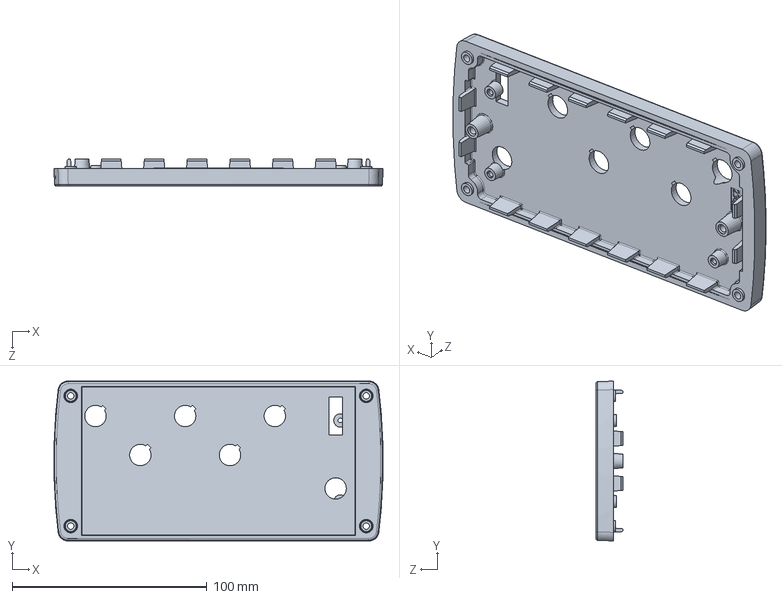
[picture p48: CAD file, 2024-06-28]
Mechanical/Housing/ABD 1680_1009800_3D_back.sldprt
168.8 x 82.0 x 14.0 mm
