wuzipu123/software/Mechanical/Particle_Sensor/downloaded_3D_models/Battery_Connector_Molex_022053021.stp

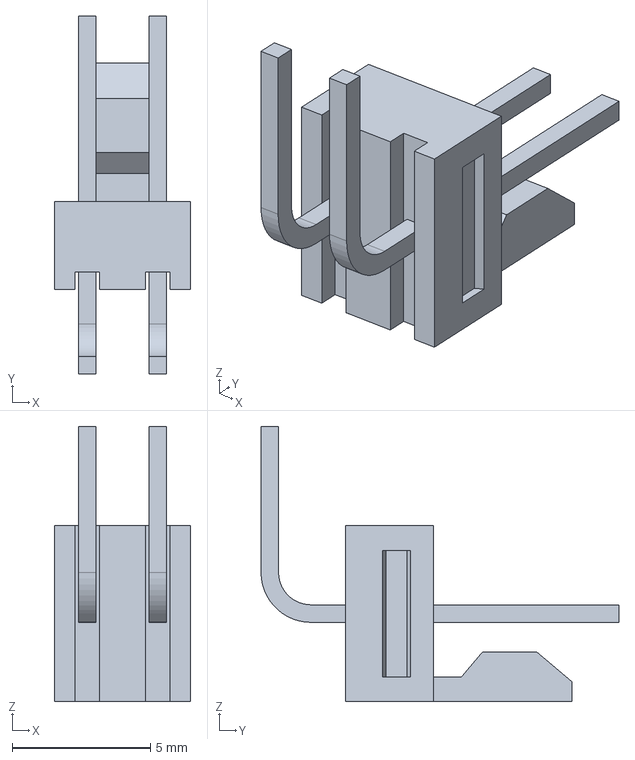
[picture p49: CAD file, 2024-06-28]
Mechanical/Particle_Sensor/downloaded_3D_models/Battery_Connector_Molex_022053021.stp
4.93 x 12.9 x 9.93 mm
