wuzipu123/software/Mechanical/Particle_Sensor/downloaded_3D_models/Power_Switch_SK-12F17-G_7.stp

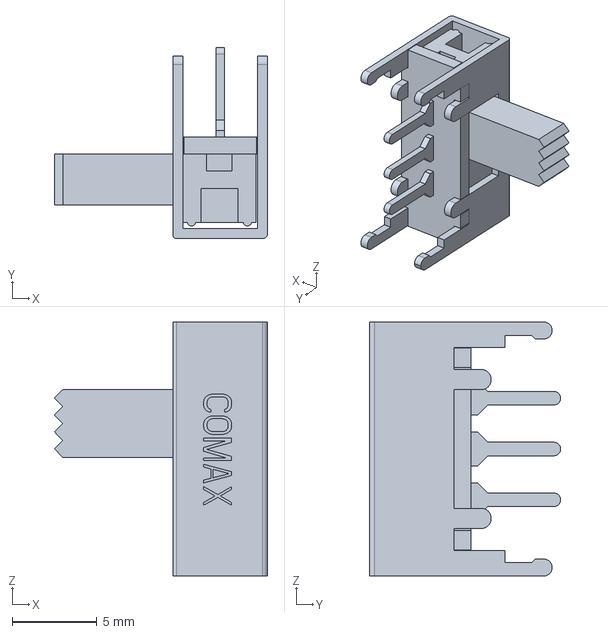
[picture p50: CAD file, 2024-06-28]
Mechanical/Particle_Sensor/downloaded_3D_models/Power_Switch_SK-12F17-G_7.stp
12.6 x 11.3 x 15.0 mm
