wuzipu123/software/Mechanical/Particle_Sensor/downloaded_3D_models/SD_Card_Slot_DM3AT-SF-PEJM5.stp

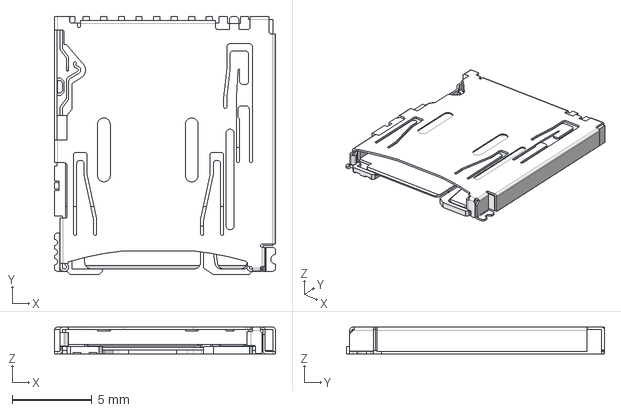
[picture p51: CAD file, 2024-06-28]
Mechanical/Particle_Sensor/downloaded_3D_models/SD_Card_Slot_DM3AT-SF-PEJM5.stp
13.8 x 16.2 x 1.68 mm
