wuzipu123/software/(list of files, cad)

Other CAD files:
Mechanical/Housing/SHR Z KT30X10 WN 1452 OG_3DSYM.sldprt
Mechanical/Particle_Sensor/Holders/SolidWorks_files/All_holder_parts.sldprt
Mechanical/Particle_Sensor/Holders/SolidWorks_files/Battery_Sensor_Holder.sldprt
Mechanical/Particle_Sensor/Holders/SolidWorks_files/Sensor_Holder.sldprt
Mechanical/Housing/DI 1680_1008097_3DSYM.sldprt
Mechanical/Particle_Sensor/Holders/SolidWorks_files/Edge_BME280_not_covered.sldprt
Mechanical/Particle_Sensor/Holders/SolidWorks_files/Edge_Coin_Cell.sldprt
Mechanical/Particle_Sensor/Holders/SolidWorks_files/Edge_BME280.sldprt
Mechanical/Particle_Sensor/Holders/SolidWorks_files/Battery_Holder.sldprt
Mechanical/Particle_Sensor/Holders/SolidWorks_files/Edge_LEDs.sldprt
Mechanical/Particle_Sensor/Holders/SolidWorks_files/Edge_Power_Switch.sldprt
Mechanical/3D_printed/akkuholder.STL
Mechanical/3D_printed/akkuholder_endpart.STL
Mechanical/3D_printed/connector_plug.STL
Mechanical/3D_printed/sdcard_panel.STL
Mechanical/Housing/1009410_3D.sldprt
Mechanical/Housing/84168100_ABD-1680_back.SLDASM
Mechanical/Housing/84168100_ABD-1680_front.SLDASM
Mechanical/Housing/84680150_ABP-1680-0150.SLDPRT
Mechanical/Housing/ABD 1680_1009800_3D_back.SLDDRW
Mechanical/Housing/ABD 1680_1009800_3D_front.SLDDRW
Mechanical/Particle_Sensor/Holders/stl_files/Battery_Holder.stl
Mechanical/Particle_Sensor/Holders/stl_files/Battery_Sensor_Holder.stl
Mechanical/Particle_Sensor/Holders/stl_files/Edge_BME280.stl
Mechanical/Particle_Sensor/Holders/stl_files/Edge_BME280_not_covered.stl
Mechanical/Particle_Sensor/Holders/stl_files/Edge_Coin_Cell.stl
Mechanical/Particle_Sensor/Holders/stl_files/Edge_LEDs.stl
Mechanical/Particle_Sensor/Holders/stl_files/Edge_Power_Switch.stl
Mechanical/Particle_Sensor/Holders/stl_files/Sensor_Holder.stl
