wuzipu123/software/Measurement/Sensorboxen_Start_Zeit_und_Ort_fuer_jede_Messung.xlsx

 |  | Sensor |  |  | Real
Messung | Sensor | Datum Start | Zeit Start | Matlab Format | Datum Start | Zeit Start | Matlab Format | Ort
Zeughaus | 1 | 2019-12-10 | 12:56:54 | 2019,12,10,12,56,54 | 2019-12-30 | 11:53:00 | 2019,30,12,11,53,00 | Zeughaus Graz, 1. Stock nahe dem Aufgang, ca. 2 m Höhe zwischen den Gewehren.
 | 2 | 2019-12-10 | 12:56:54 | 2019,12,10,12,56,54 | 2019-12-30 | 12:00:00 | 2019,30,12,12,00,00 | Zeughaus Graz, 2. Stock nahe einem Fenster zur Herrengasse auf ca. 2 m Höhe zwischen zwei Helmen
 | 3 | 2019-12-10 | 12:56:54 | 2019,12,10,12,56,54 | 2019-12-30 | 12:07:00 | 2019,30,12,12,07,00 | Zeughaus Graz, 3. Stock in der Mitte des Raumes auf ca. 20 cm Höhe
Kalibration Weiz 1 | alle | 2019-12-10 | 12:59:15 | 2019,12,10,12,59,15 | 2020-02-27 | 11:40:00 | 2020,02,27,11,40,00 | Bahnhof Weiz, Dach
Kalibration Weiz 2 | alle | 2019-12-10 | 12:56:54 | 2019,12,10,12,56,54 | 2020-03-10 | 10:40:00 | 2020,03,10,10,40,00 | Bahnhof Weiz, Dach
