wuzipu123/software/Docs/Sensors/OPC_N3/calibration_sheet_OPCN3.csv

Bin number | Particle Size | Average volume [æm3] | Density/weighting [g/cm3] | Respiratory Factor PM 1 | Respiratory Factor PM 2.5 | Respiratory Factor PM 10 | Volume Particle more accurately
0 | 0.35-0.46 | 0.04 | 1.65 | 97.53 | 98.8 | 98.8 | 0.0348
1 | 0.46-0.66 | 0.09 | 1.65 | 90.84 | 98.8 | 98.35 | 0.092
2 | 0.66-1.0 | 0.3 | 1.65 | 66.06 | 97.25 | 97.57 | 0.2994
3 | 1.0-1.3 | 0.8 | 1.65 | 35.3 | 93.99 | 96.67 | 0.7963
4 | 1.3-1.7 | 1.77 | 1.65 | 15.18 | 85.76 | 95.7 | 18
5 | 1.7-2.3 | 4.19 | 1.65 | 4.12 | 66.89 | 94.34 | 42
6 | 2.3-3.0 | 9.74 | 1.65 | 0.75 | 41.03 | 92.6 | 9.744
7 | 3.0-4.0 | 22.45 | 1.65 | 0.09 | 18.41 | 90.09 | 22.4493
8 | 4.0-5.2 | 50.97 | 1.65 | 7.88E-03 | 5.83 | 85.5 | 50.965
9 | 5.2-6.5 | 104.83 | 1.65 | 7.11E-04 | 1.53 | 77.27 | 104.8253
10 | 6.5-8 | 199.53 | 1.65 | 7.25E-05 | 0.36 | 64.75 | 199.532
11 | 8.0-10 | 381.7 | 1.65 | 6.72E-06 | 0.06 | 47.68 | 381.7035
12 | 10-12 | 696.91 | 1.65 | 7.18E-07 | 0.01 | 30.87 | 696.91
13 | 12-14 | 1150.35 | 1.65 | 1.12E-07 | 2.00E-03 | 18.87 | 1150.3465
14 | 14-16 | 1767.15 | 1.65 | 2.30E-08 | 4.53E-04 | 11.16 | 1767.1459
15 | 16-18 | 2572.44 | 1.65 | 7.37E-11 | 3.98E-05 | 1.21 | 2572.4408
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
