wuzipu123/software/Measurement/Data/Weiz_Kalibrierung_200227_200310/Sensor 1/Data_SPS30_10_12_2019_12_58.csv

Data Measurement of Sensor: SPS30
Start Time: 10.12.2019 12:58:40
Sensortype: Particle Sensor
Timestamp |  | Mass PM1.0 [ug/m^3] | Mass PM2.5 [ug/m^3] | Mass PM4.0 [ug/m^3] | Mass PM10.0 [ug/m^3] | Number PM0.5 [#/cm^3] | Number PM1.0 [#/cm^3] | Number PM2.5 [#/cm^3] | Number PM4.0 [#/cm^3] | Number PM10.0 [#/cm^3] | Typical Particle Size [um]
10.12.2019 | 12:59:15 | 7.802478671e-01 | 1.504842520e+00 | 2.019999027e+00 | 2.126955748e+00 | 3.514829874e+00 | 5.287180901e+00 | 6.023615360e+00 | 6.115545750e+00 | 6.130840778e+00 | 7.768992186e-01
10.12.2019 | 13:14:15 | 9.177218080e-01 | 1.907523632e+00 | 2.615144491e+00 | 2.762061119e+00 | 3.728638411e+00 | 6.001967430e+00 | 7.009890079e+00 | 7.136121273e+00 | 7.157107353e+00 | 1.033767104e+00
10.12.2019 | 13:29:15 | 1.015702367e+00 | 2.415485144e+00 | 3.423661947e+00 | 3.632979631e+00 | 3.229602098e+00 | 6.163146496e+00 | 7.592267513e+00 | 7.772031307e+00 | 7.801886559e+00 | 1.095246553e+00
10.12.2019 | 13:44:15 | 2.309199095e+00 | 5.258965015e+00 | 7.379037380e+00 | 7.819208145e+00 | 8.028346062e+00 | 1.437858009e+01 | 1.738794899e+01 | 1.776601791e+01 | 1.782882881e+01 | 1.275184274e+00
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
