wuzipu123/software/Measurement/Data/Weiz_Kalibrierung_200227_200310/Sensor 2/Data_SPS30_10_12_2019_12_57.csv

Data Measurement of Sensor: SPS30
Start Time: 10.12.2019 12:57:46
Sensortype: Particle Sensor
Timestamp |  | Mass PM1.0 [ug/m^3] | Mass PM2.5 [ug/m^3] | Mass PM4.0 [ug/m^3] | Mass PM10.0 [ug/m^3] | Number PM0.5 [#/cm^3] | Number PM1.0 [#/cm^3] | Number PM2.5 [#/cm^3] | Number PM4.0 [#/cm^3] | Number PM10.0 [#/cm^3] | Typical Particle Size [um]
10.12.2019 | 12:58:28 | 8.117274046e-01 | 1.868729949e+00 | 2.686436176e+00 | 2.849976540e+00 | 3.470213890e+00 | 5.473925114e+00 | 6.412683487e+00 | 6.589421749e+00 | 6.615941048e+00 | 9.071673155e-01
10.12.2019 | 13:13:28 | 1.051211119e+00 | 1.469789982e+00 | 1.759668708e+00 | 1.817644477e+00 | 6.488927364e+00 | 8.009047508e+00 | 8.366303444e+00 | 8.431695938e+00 | 8.442658424e+00 | 4.093976915e-01
10.12.2019 | 13:28:28 | 1.193161130e+00 | 1.457538009e+00 | 1.616015911e+00 | 1.647711277e+00 | 7.807527065e+00 | 9.294590950e+00 | 9.509723663e+00 | 9.547689438e+00 | 9.554948807e+00 | 5.043266416e-01
10.12.2019 | 13:43:28 | 6.657416224e-01 | 1.136950254e+00 | 1.487349272e+00 | 1.557428956e+00 | 3.676791430e+00 | 4.872616291e+00 | 5.285074711e+00 | 5.361950397e+00 | 5.373964310e+00 | 6.917297840e-01
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
