wuzipu123/software/Measurement/Data/Weiz_Kalibrierung_200227_200310/Sensor 3/Data_OPC-N3_10_12_2019_12_57.csv

Data Measurement of Sensor: OPC-N3
Start Time: 10.12.2019 12:57:31
Sensortype: Particle Sensor
Timestamp |  | Bin0 350nm [#/s] | Bin1 460nm [#/s] | Bin2 660nm [#/s] | Bin3 1000nm [#/s] | Bin4 1300nm [#/s] | Bin5 1700nm [#/s] | Bin6 2300nm [#/s] | Bin7 3000nm [#/s] | Bin8 4000nm [#/s] | Bin9 5200nm [#/s] | Bin10 6500nm [#/s] | Bin11 8000nm [#/s] | Bin12 10000nm [#/s] | Bin13 12000nm [#/s] | Bin14 14000nm [#/s] | Bin15 16000nm [#/s] | Bin16 18000nm [#/s] | Bin17 20000nm [#/s] | Bin18 22000nm [#/s] | Bin19 25000nm [#/s] | Bin20 28000nm [#/s] | Bin21 31000nm [#/s] | Bin22 34000nm [#/s] | Bin23 37000nm [#/s] | t [C_raw] | h [%_raw] | flow rate [ml/s]
10.12.2019 | 12:58:08 | 5.400000000e+01 | 7.000000000e+00 | 6.000000000e+00 | 3.000000000e+00 | 4.000000000e+00 | 0.000000000e+00 | 0.000000000e+00 | 0.000000000e+00 | 0.000000000e+00 | 0.000000000e+00 | 0.000000000e+00 | 0.000000000e+00 | 0.000000000e+00 | 0.000000000e+00 | 0.000000000e+00 | 0.000000000e+00 | 0.000000000e+00 | 0.000000000e+00 | 0.000000000e+00 | 0.000000000e+00 | 0.000000000e+00 | 0.000000000e+00 | 0.000000000e+00 | 0.000000000e+00 | 2.162100000e+04 | 1.444500000e+04 | 3.000000000e+02
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
