wuzipu123/software/Measurement/Data/Weiz_Kalibrierung_200227_200310/Sensor 3/Data_SPS30_10_12_2019_12_57.csv

Data Measurement of Sensor: SPS30
Start Time: 10.12.2019 12:57:31
Sensortype: Particle Sensor
Timestamp |  | Mass PM1.0 [ug/m^3] | Mass PM2.5 [ug/m^3] | Mass PM4.0 [ug/m^3] | Mass PM10.0 [ug/m^3] | Number PM0.5 [#/cm^3] | Number PM1.0 [#/cm^3] | Number PM2.5 [#/cm^3] | Number PM4.0 [#/cm^3] | Number PM10.0 [#/cm^3] | Typical Particle Size [um]
10.12.2019 | 12:58:08 | 2.471965551e+00 | 2.712502718e+00 | 2.792215824e+00 | 2.808158159e+00 | 1.685058022e+01 | 1.954803467e+01 | 1.972198486e+01 | 1.974810219e+01 | 1.975588036e+01 | 4.053077996e-01
10.12.2019 | 13:13:08 | 1.641089678e+00 | 3.330842257e+00 | 4.622074604e+00 | 4.880320549e+00 | 7.982939720e+00 | 1.148315144e+01 | 1.299371433e+01 | 1.327006054e+01 | 1.331408978e+01 | 9.380556941e-01
10.12.2019 | 13:28:07 | 8.374833465e-01 | 1.722663403e+00 | 2.400110006e+00 | 2.535600185e+00 | 4.023962498e+00 | 5.837767601e+00 | 6.629486084e+00 | 6.774381161e+00 | 6.797432899e+00 | 7.469890714e-01
10.12.2019 | 13:43:08 | 7.744191289e-01 | 1.296246648e+00 | 1.682558656e+00 | 1.759821177e+00 | 4.346819401e+00 | 5.687952995e+00 | 6.149533272e+00 | 6.233293056e+00 | 6.247071743e+00 | 7.489730716e-01
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
