wuzipu123/software/Simulation/Results/Outside stream/BeispielraumStreamOutsideStreamline1.png

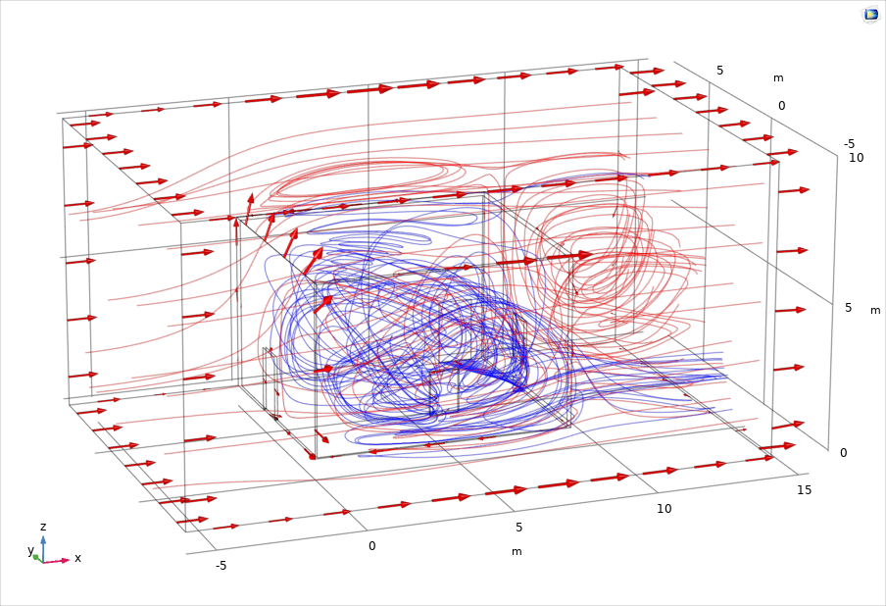
Simulation/Results/Outside stream/BeispielraumStreamOutsideStreamline1.png
