wuzipu123/software/Simulation/Results/Outside stream/BeispielraumStreamOutsideStreamline2.png

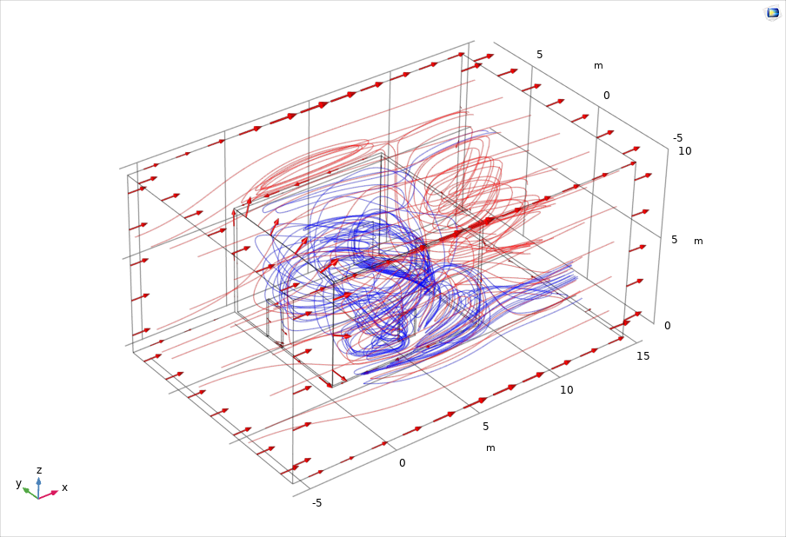
Simulation/Results/Outside stream/BeispielraumStreamOutsideStreamline2.png
