wuzipu123/software/Simulation/Results/Outside stream/BeispielraumStreamOutsideStreamline.png

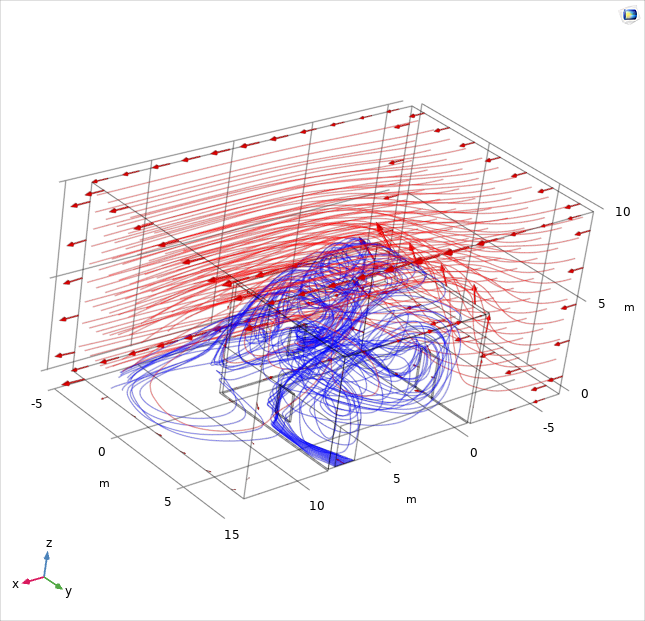
Simulation/Results/Outside stream/BeispielraumStreamOutsideStreamline.png
