wuzipu123/software/Simulation/Results/Outside stream/BeispielraumStreamOutsideStreamlinexy.png

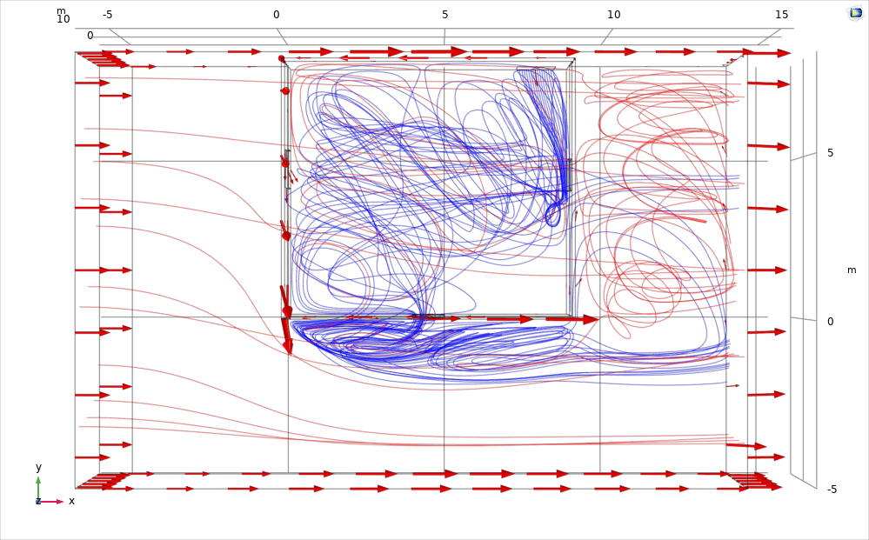
Simulation/Results/Outside stream/BeispielraumStreamOutsideStreamlinexy.png
