wuzipu123/software/Simulation/Results/Outside stream/BeispielraumStreamOutsideStreamlinexz.png

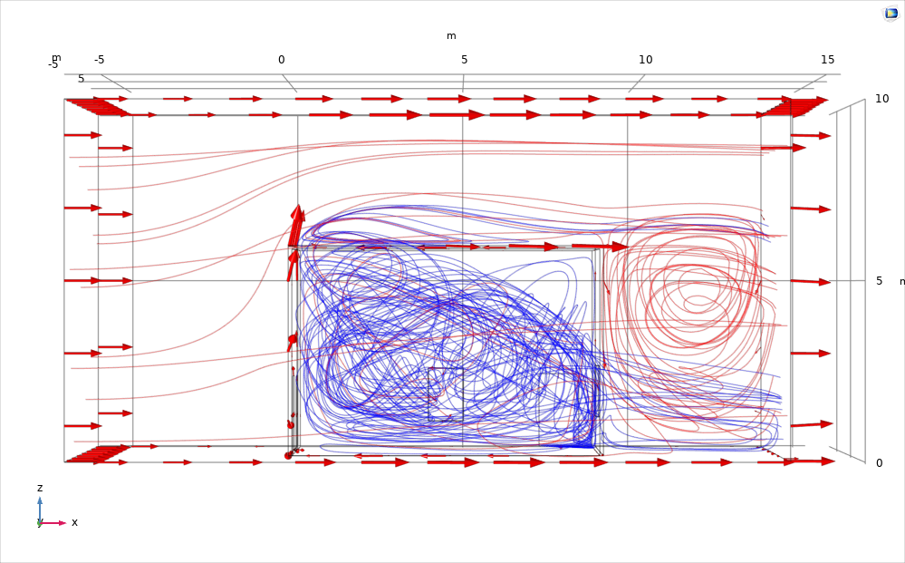
Simulation/Results/Outside stream/BeispielraumStreamOutsideStreamlinexz.png
