wuzipu123/software/Simulation/Results/Outside stream/BeispielraumStreamOutsideStreamlineyz.png

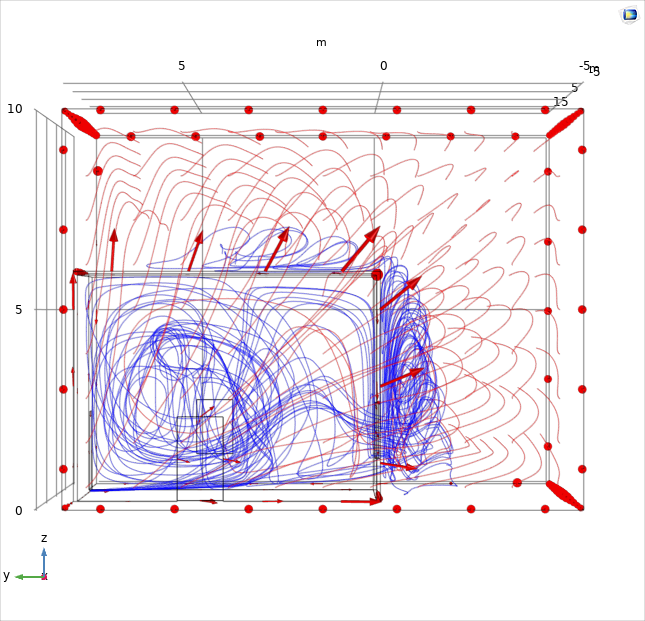
Simulation/Results/Outside stream/BeispielraumStreamOutsideStreamlineyz.png
