wuzipu123/software/Simulation/Results/Sample room/Doors closed/Inlet Velocity 0,04 ms/DP 0,1/Particles 0.png

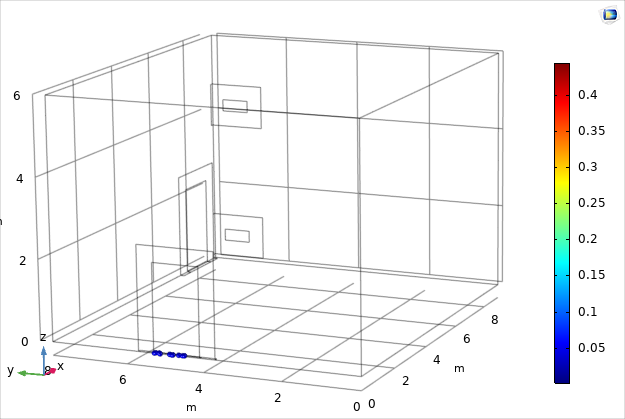
Simulation/Results/Sample room/Doors closed/Inlet Velocity 0,04 ms/DP 0,1/Particles 0.png
