wuzipu123/software/Simulation/Results/Sample room/Doors closed/Inlet Velocity 0,04 ms/DP 1/Particles 3000.png

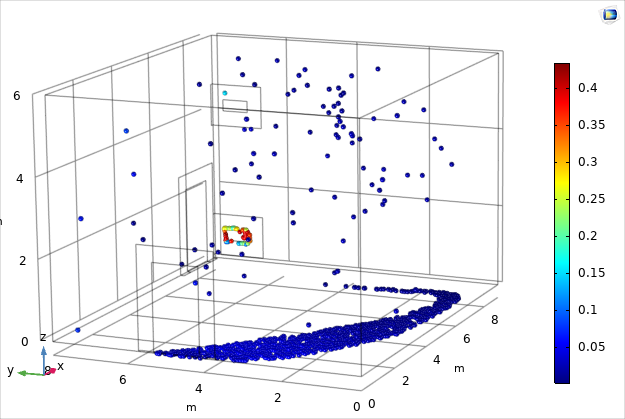
Simulation/Results/Sample room/Doors closed/Inlet Velocity 0,04 ms/DP 1/Particles 3000.png
