wuzipu123/software/Simulation/Results/Sample room/Doors closed/Inlet Velocity 0,8 ms/DP 0,1/Particles 200.png

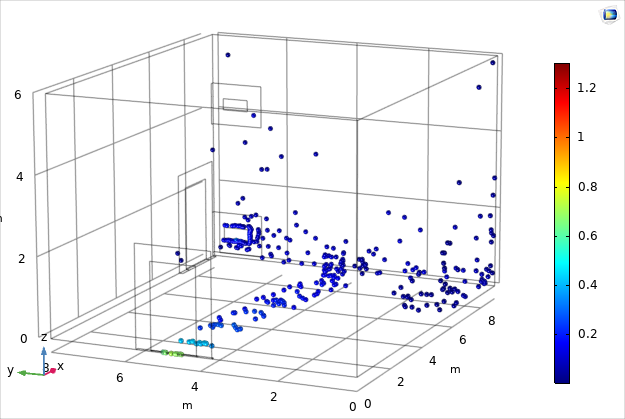
Simulation/Results/Sample room/Doors closed/Inlet Velocity 0,8 ms/DP 0,1/Particles 200.png
