wuzipu123/software/Simulation/Results/Sample room/Doors closed/Inlet Velocity 0,8 ms/DP 1/Particles 2200.png

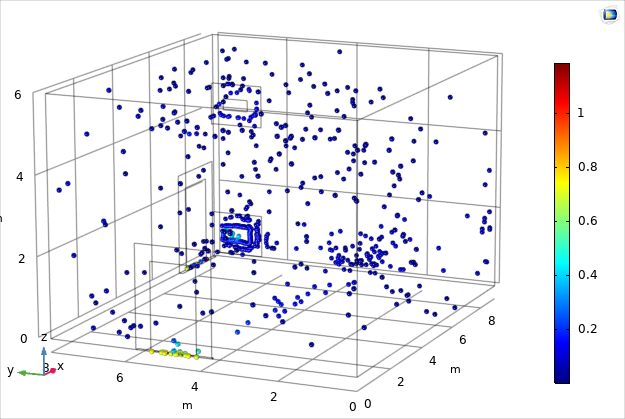
Simulation/Results/Sample room/Doors closed/Inlet Velocity 0,8 ms/DP 1/Particles 2200.png
