wuzipu123/software/Simulation/Results/Sample room/Doors closed/Inlet Velocity 0,8 ms/Velocity_yz.png

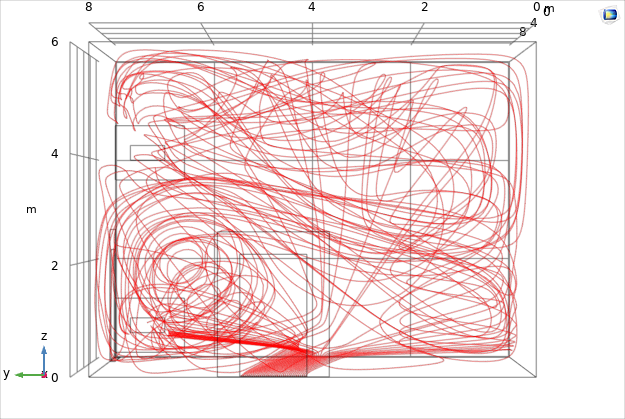
Simulation/Results/Sample room/Doors closed/Inlet Velocity 0,8 ms/Velocity_yz.png
