wuzipu123/software/Simulation/Results/Sample room/Doors open/Inlet Velocity 0,04 ms/DP 1/Particles 1000.png

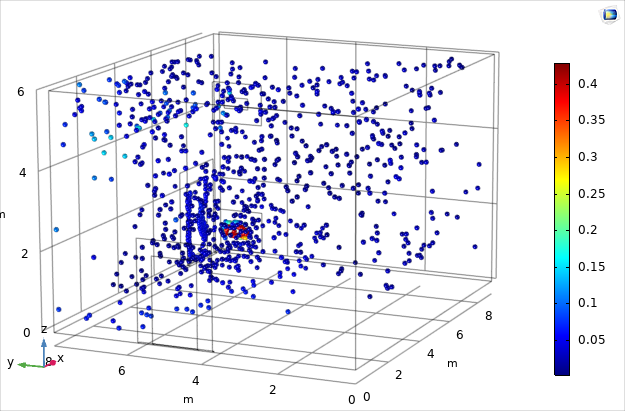
Simulation/Results/Sample room/Doors open/Inlet Velocity 0,04 ms/DP 1/Particles 1000.png
