wuzipu123/software/Simulation/Results/Sample room/Doors open/Inlet Velocity 0,04 ms/DP 2,5/Particles 2500.png

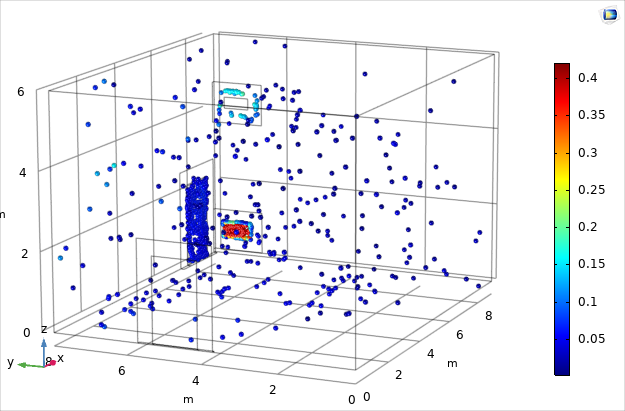
Simulation/Results/Sample room/Doors open/Inlet Velocity 0,04 ms/DP 2,5/Particles 2500.png
