wuzipu123/software/Simulation/Results/Sample room/Doors open/Inlet Velocity 0,04 ms/DP 10/Particles 200.png

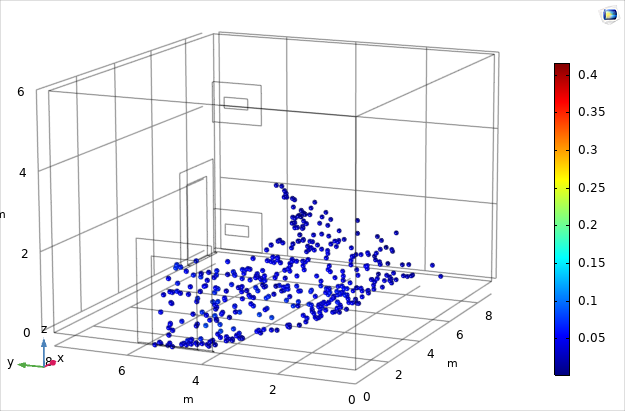
Simulation/Results/Sample room/Doors open/Inlet Velocity 0,04 ms/DP 10/Particles 200.png
