wuzipu123/software/Simulation/Results/Sample room/Doors open/Inlet Velocity 0,04 ms/Velocity_yz.png

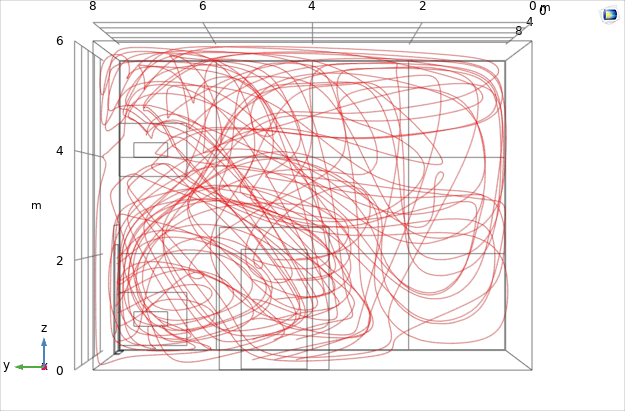
Simulation/Results/Sample room/Doors open/Inlet Velocity 0,04 ms/Velocity_yz.png
