wuzipu123/software/Simulation/Results/Sample room/Doors open/Inlet Velocity 0,8 ms/DP 10/Particles 600.png

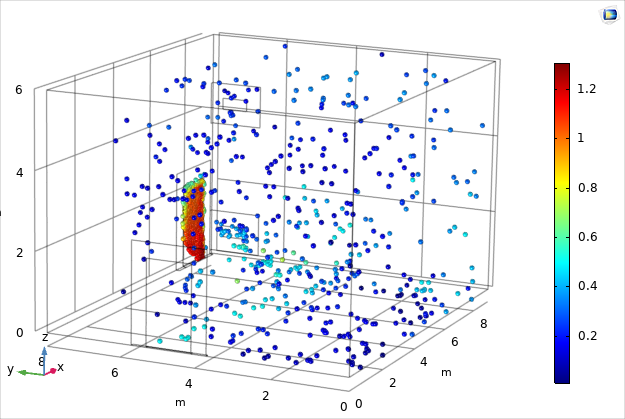
Simulation/Results/Sample room/Doors open/Inlet Velocity 0,8 ms/DP 10/Particles 600.png
