wuzipu123/software/Simulation/Results/Sample room/Doors open/Inlet Velocity 0,8 ms/Velocity_xz.png

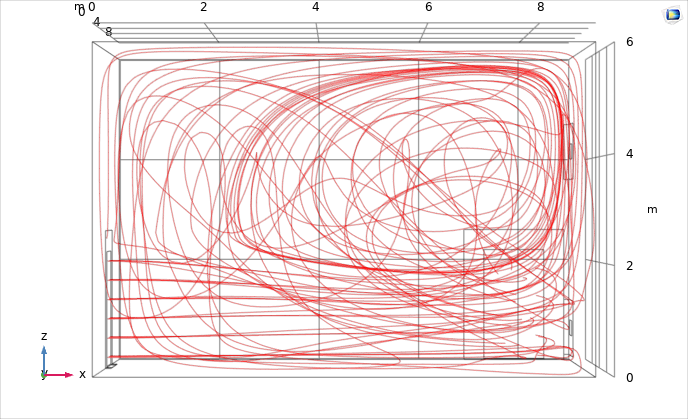
Simulation/Results/Sample room/Doors open/Inlet Velocity 0,8 ms/Velocity_xz.png
