wuzipu123/software/Simulation/Results/Sample room/Geometry.png

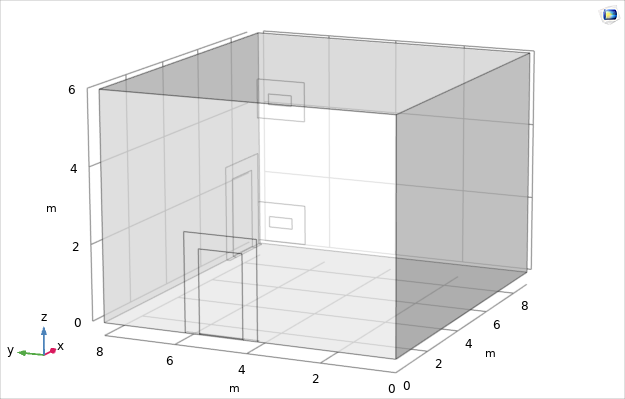
Simulation/Results/Sample room/Geometry.png
