wuzipu123/software/Simulation/Results/Ventilation floor doors changed/Doors closed/Velocity 0,04/PM 1/Particles 600.png

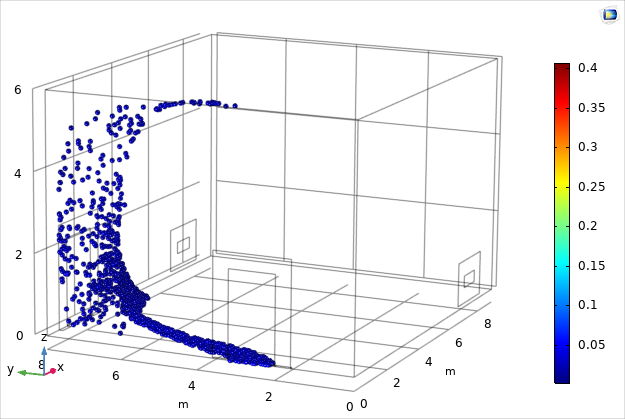
Simulation/Results/Ventilation floor doors changed/Doors closed/Velocity 0,04/PM 1/Particles 600.png
