wuzipu123/software/Simulation/Results/Ventilation floor doors changed/Doors closed/Velocity 0,8/Particles 1800.png

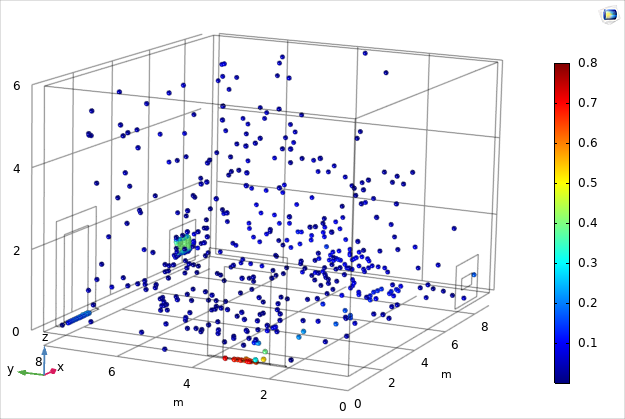
Simulation/Results/Ventilation floor doors changed/Doors closed/Velocity 0,8/Particles 1800.png
