wuzipu123/software/Simulation/Results/Ventilation floor doors changed/Doors closed/Velocity 0,8/Velocity_xy.png

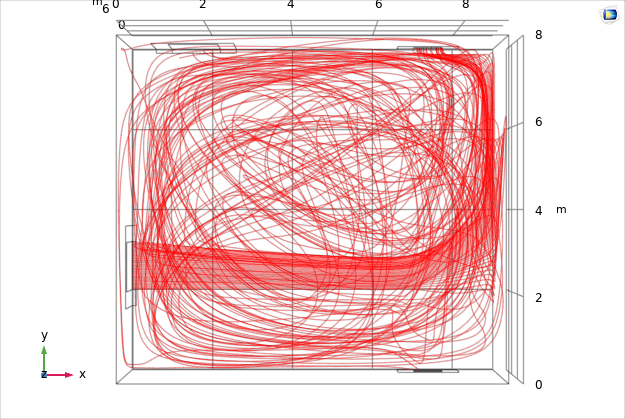
Simulation/Results/Ventilation floor doors changed/Doors closed/Velocity 0,8/Velocity_xy.png
