wuzipu123/software/Simulation/Results/Ventilation floor/Doors closed/Velocity 0,04/Particles 0.png

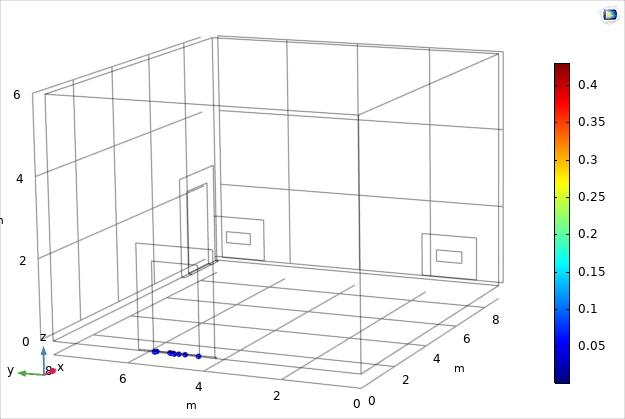
Simulation/Results/Ventilation floor/Doors closed/Velocity 0,04/Particles 0.png
