wuzipu123/software/Simulation/Results/Ventilation floor/Doors closed/Velocity 0,04/Velocity_xz.png

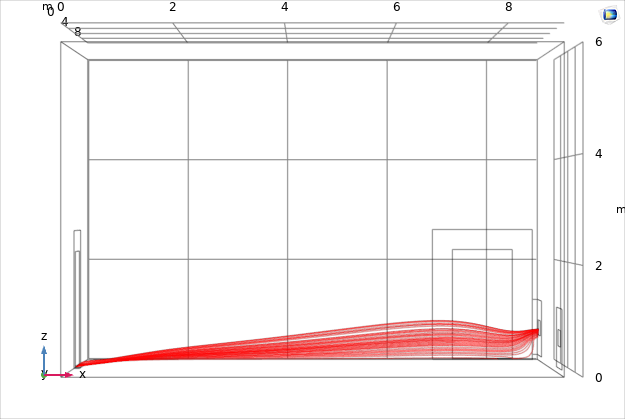
Simulation/Results/Ventilation floor/Doors closed/Velocity 0,04/Velocity_xz.png
