wuzipu123/software/Simulation/Results/Ventilation floor/Doors closed/Velocity 0,8/Particles 3000.png

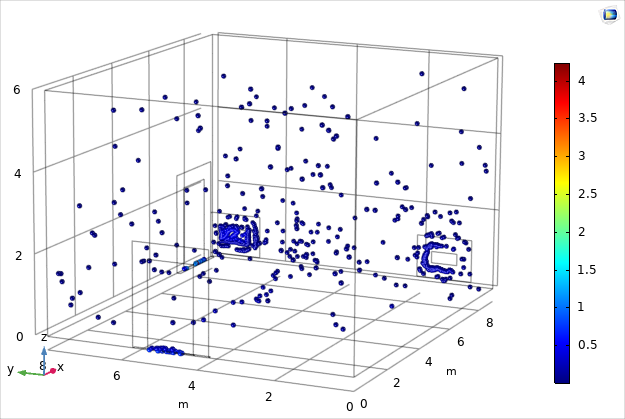
Simulation/Results/Ventilation floor/Doors closed/Velocity 0,8/Particles 3000.png
