wuzipu123/software/Simulation/Results/Ventilation floor/Doors open/Velocity 0,04/Particles 200_other_view.png

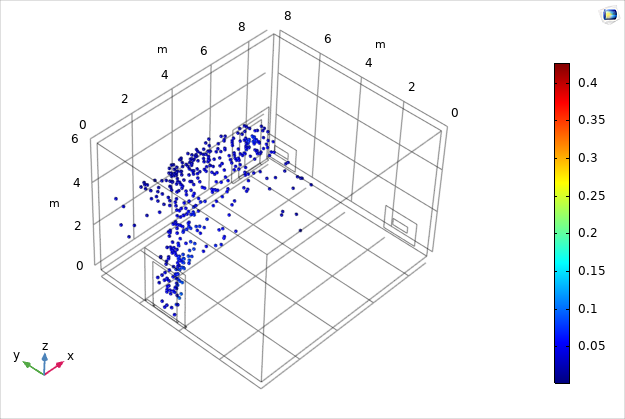
Simulation/Results/Ventilation floor/Doors open/Velocity 0,04/Particles 200_other_view.png
