wuzipu123/software/Simulation/Results/Ventilation floor/Doors open/Velocity 0,04/Particles 600.png

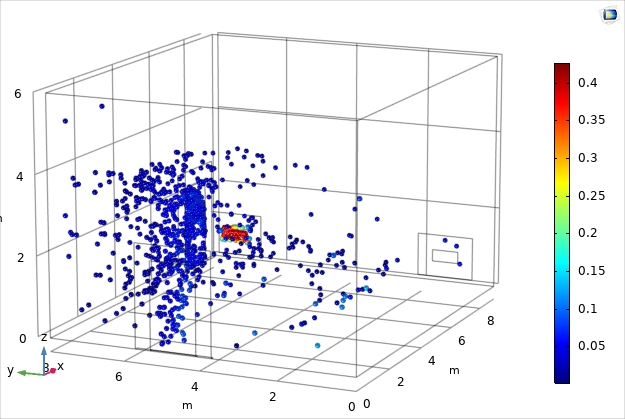
Simulation/Results/Ventilation floor/Doors open/Velocity 0,04/Particles 600.png
