wuzipu123/software/Simulation/Results/Ventilation floor/Doors open/Velocity 0,04/Particles 1200.png

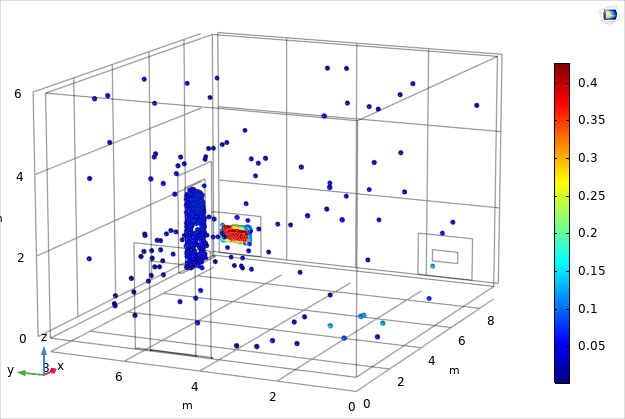
Simulation/Results/Ventilation floor/Doors open/Velocity 0,04/Particles 1200.png
