wuzipu123/software/Simulation/Results/Ventilation floor/Doors open/Velocity 0,04/Velocity_yz.png

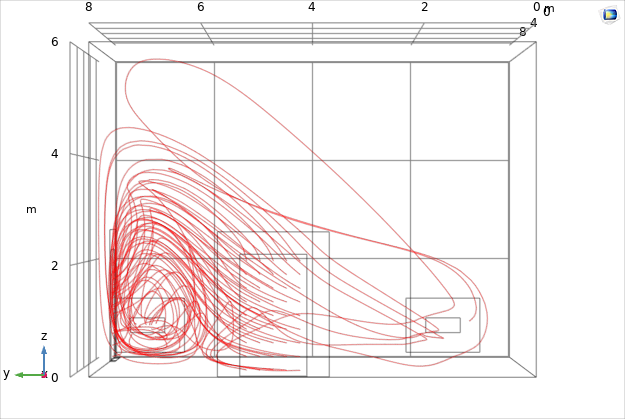
Simulation/Results/Ventilation floor/Doors open/Velocity 0,04/Velocity_yz.png
