wuzipu123/software/Simulation/Results/Windows/Doors closed/Velocity 0.8/Particles 200.png

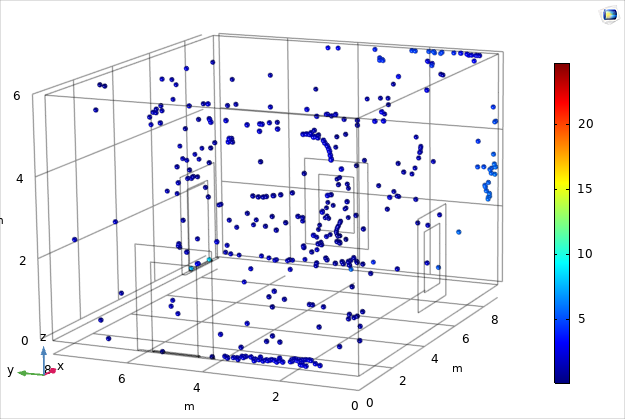
Simulation/Results/Windows/Doors closed/Velocity 0.8/Particles 200.png
