wuzipu123/software/Simulation/Results/Windows/Doors closed/Velocity 0.8/Particles 400.png

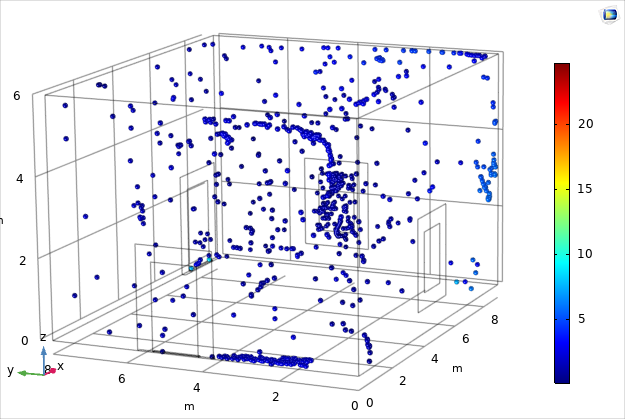
Simulation/Results/Windows/Doors closed/Velocity 0.8/Particles 400.png
