wuzipu123/software/Simulation/Results/Windows/Doors closed/Velocity 0.8/Velocity_xz.png

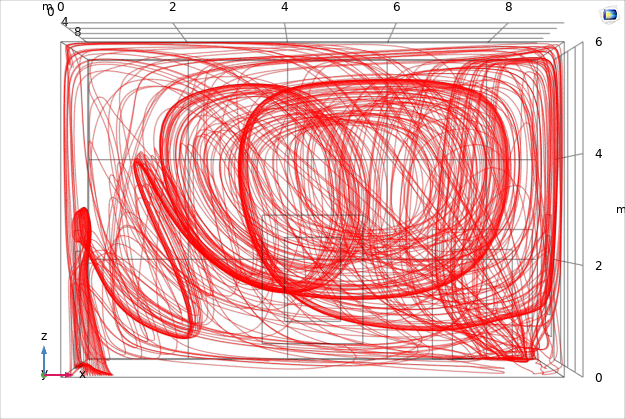
Simulation/Results/Windows/Doors closed/Velocity 0.8/Velocity_xz.png
