wuzipu123/software/Simulation/Results/Windows/Doors open/Velocity 0,8/Velocity_xz.png

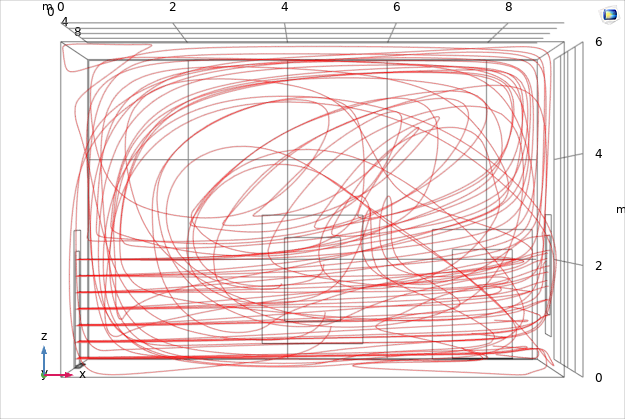
Simulation/Results/Windows/Doors open/Velocity 0,8/Velocity_xz.png
