wuzipu123/software/Docs/Software/Flow Chart Programm.pdf

### Power ON

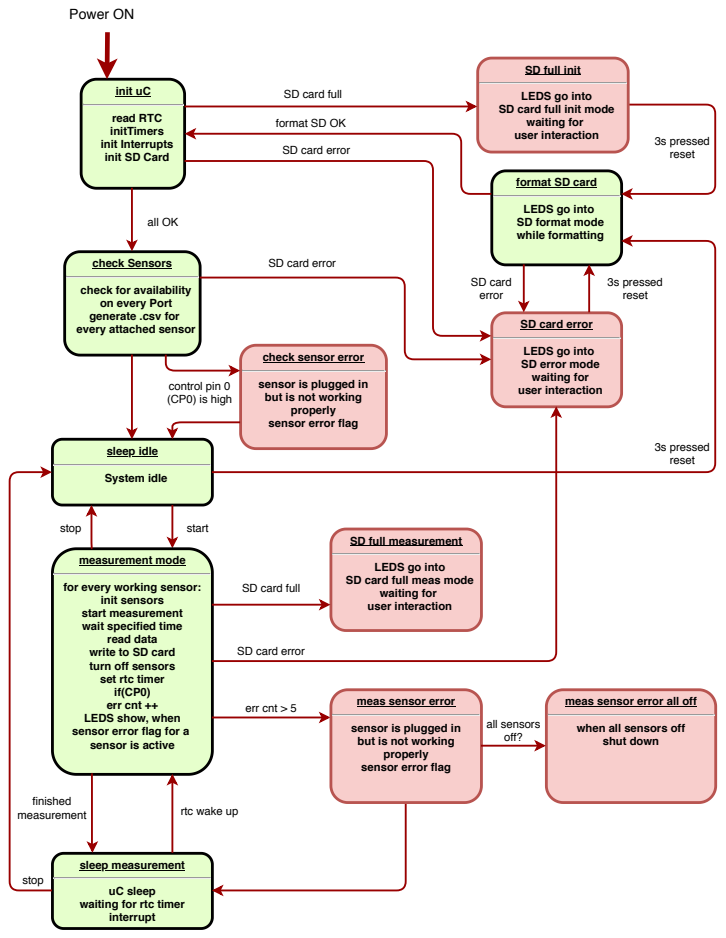
[picture p212: page 1]
init uC; check Sensors; sleep measurement; sleep idle; System idle; control pin 0 (CP0) is high; 3s pressed; start; measurement mode; stop; SD card error; 3s pressed reset; finished measurement; all OK; err cnt > 5; meas sensor error; waiting for user interaction; all sensors off?

SD full init

SD card full

LEDS go into
SD card full init mode
waiting for
user interaction

read RTC
initTimers
init Interrupts
init SD Card

format SD OK

reset SD card error

format SD card

SD format mode
while formatting

SD card error

check for availability
on every Port
generate .csv for
every attached sensor

check sensor error

SD error mode

sensor is plugged in
but is not working
properly
sensor error flag

SD full measurement

SD card full meas mode

for every working sensor:

init sensors
start measurement
wait specified time
read data
write to SD card
turn off sensors
set rtc timer
err cnt ++
LEDS show, when
sensor error flag for a
sensor is active

meas sensor error all off

when all sensors off
shut down

rtc wake up

uC sleep
waiting for rtc timer
interrupt

states | LED red | LED green
init controller | off | on
check sensors | off | on
sleep idle | off/blink | blink every 5 s
measurement mode | off/blink | blink every 15 s
sleep measurement | off/blink | blink every 15 s
sensor errors | set from off to blink | x
SD card error | blink every second | off
format SD card | toggle every second | !toggle every second
SD full init | on | off
SD full measurement | blink every second | blink every second
