wuzipu123/software/Electronic/DC2045A/DC2045A-2-PDF/DC2045A-2-BOTT ASSY.pdf

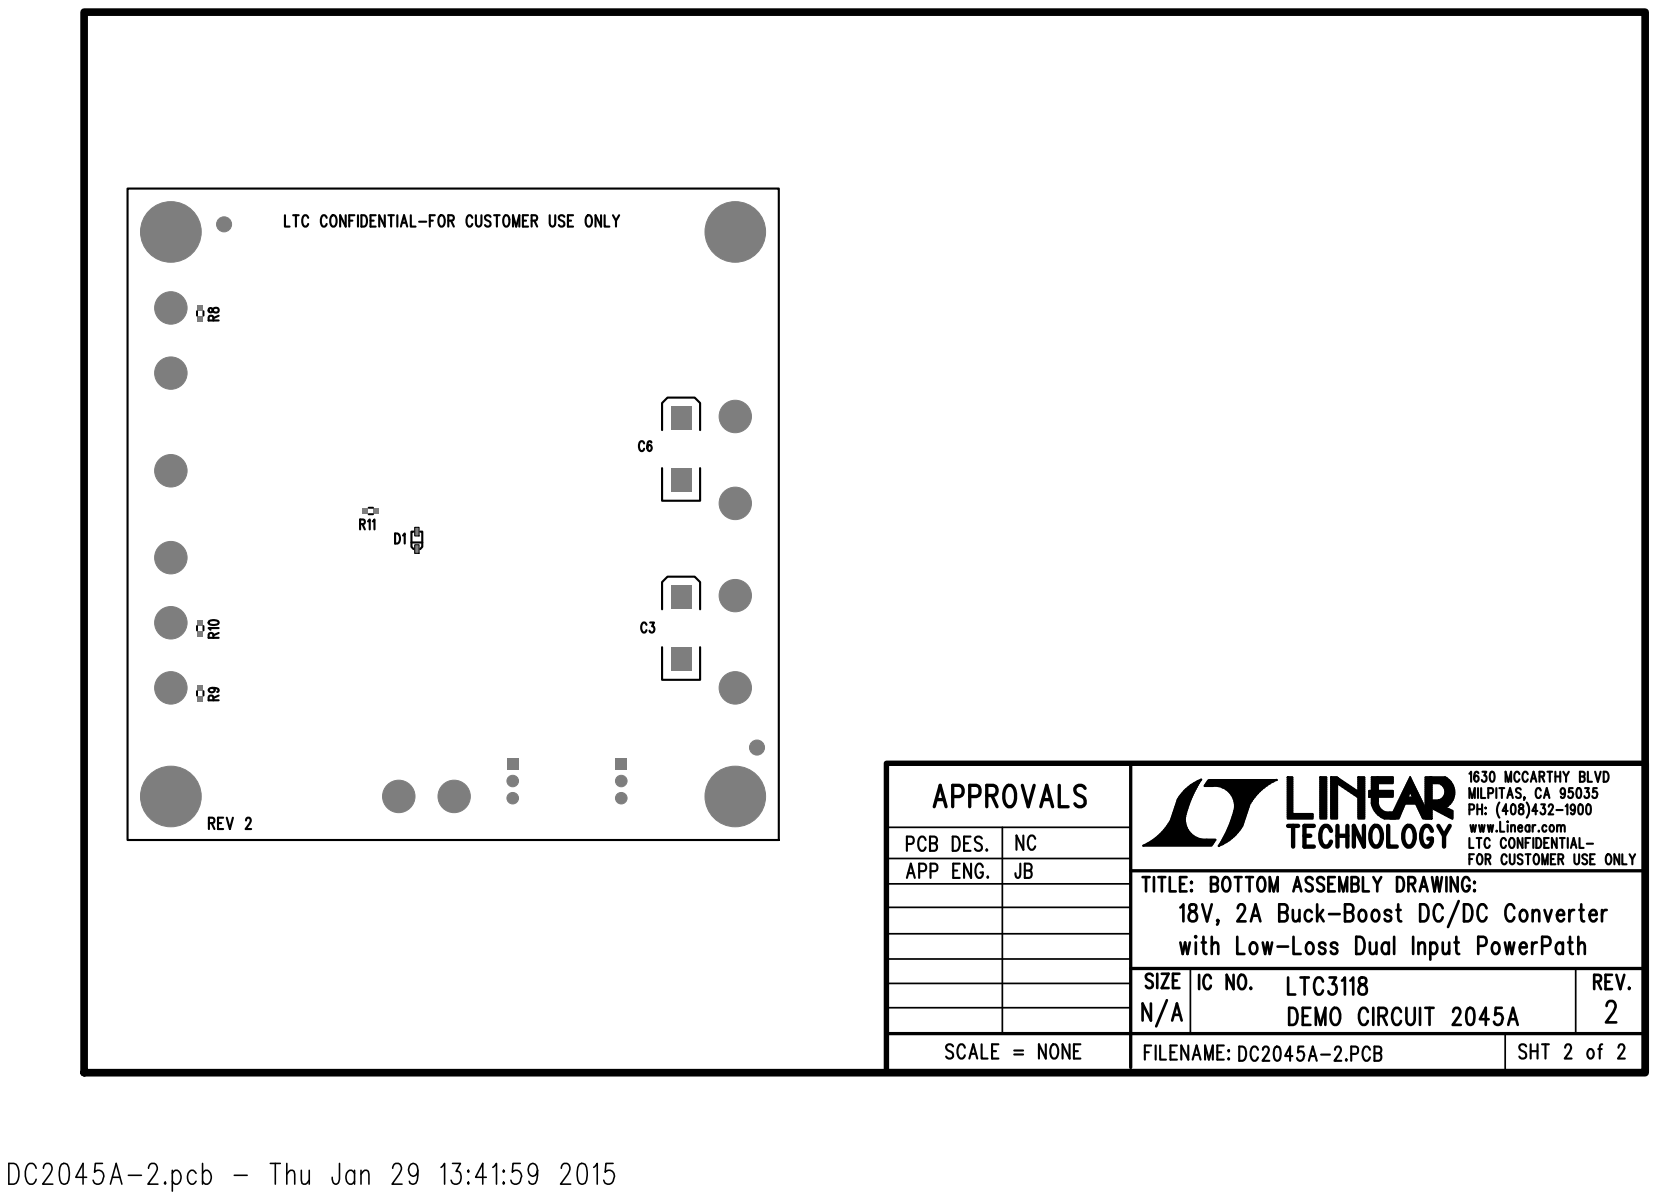
[picture p213: page 1]
