wuzipu123/software/Electronic/DC2045A/DC2045A-2-PDF/DC2045A-2-BOTT PMASK.pdf

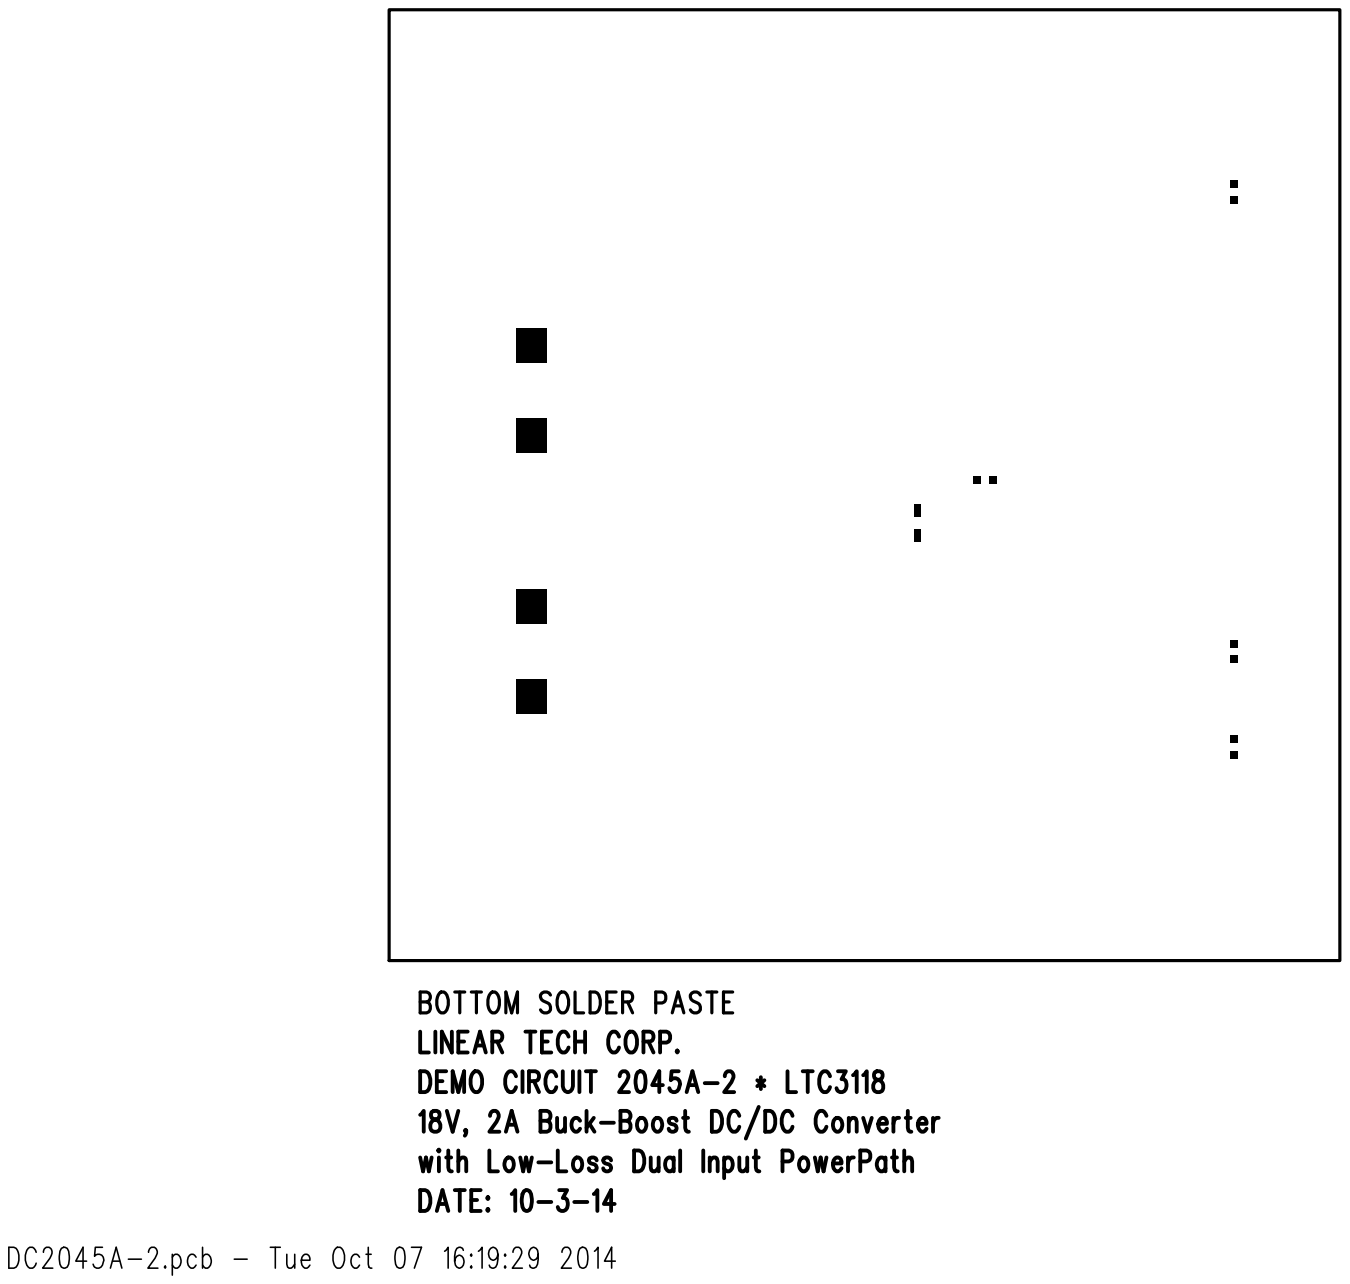
[picture p214: page 1]
