wuzipu123/software/Electronic/DC2045A/DC2045A-2-PDF/DC2045A-2-BOTT SILK.pdf

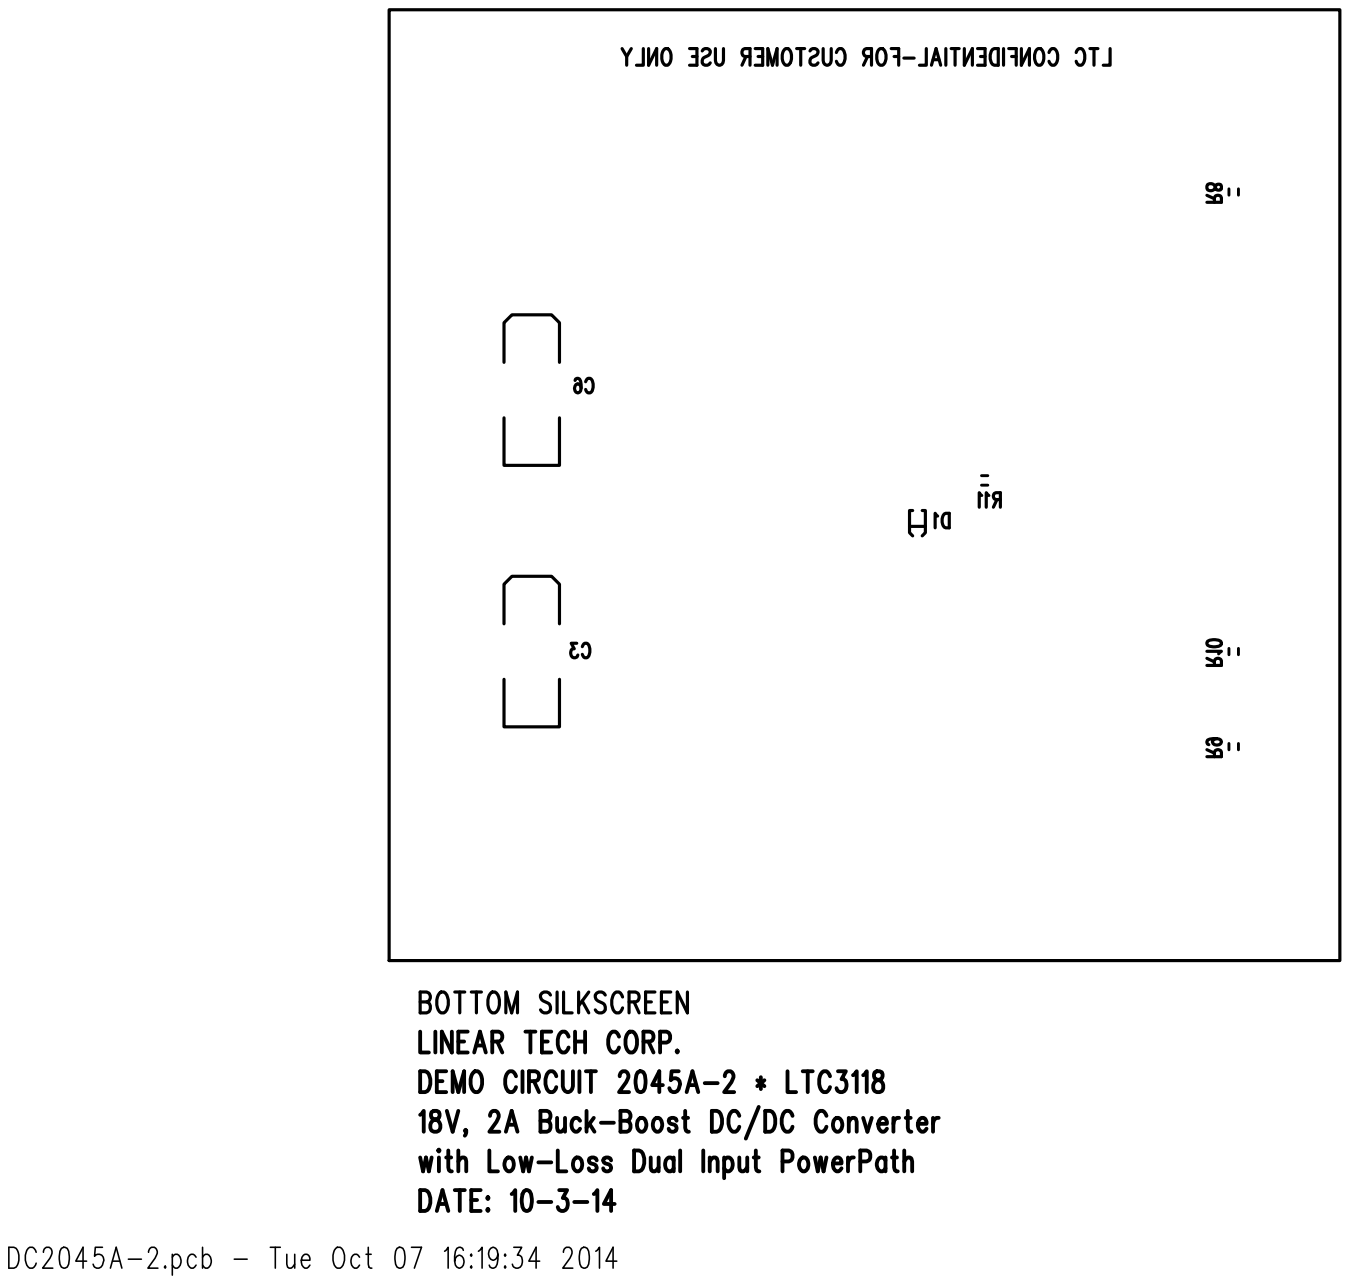
[picture p215: page 1]
