wuzipu123/software/Electronic/DC2045A/DC2045A-2-PDF/DC2045A-2-BOTT SMASK.pdf

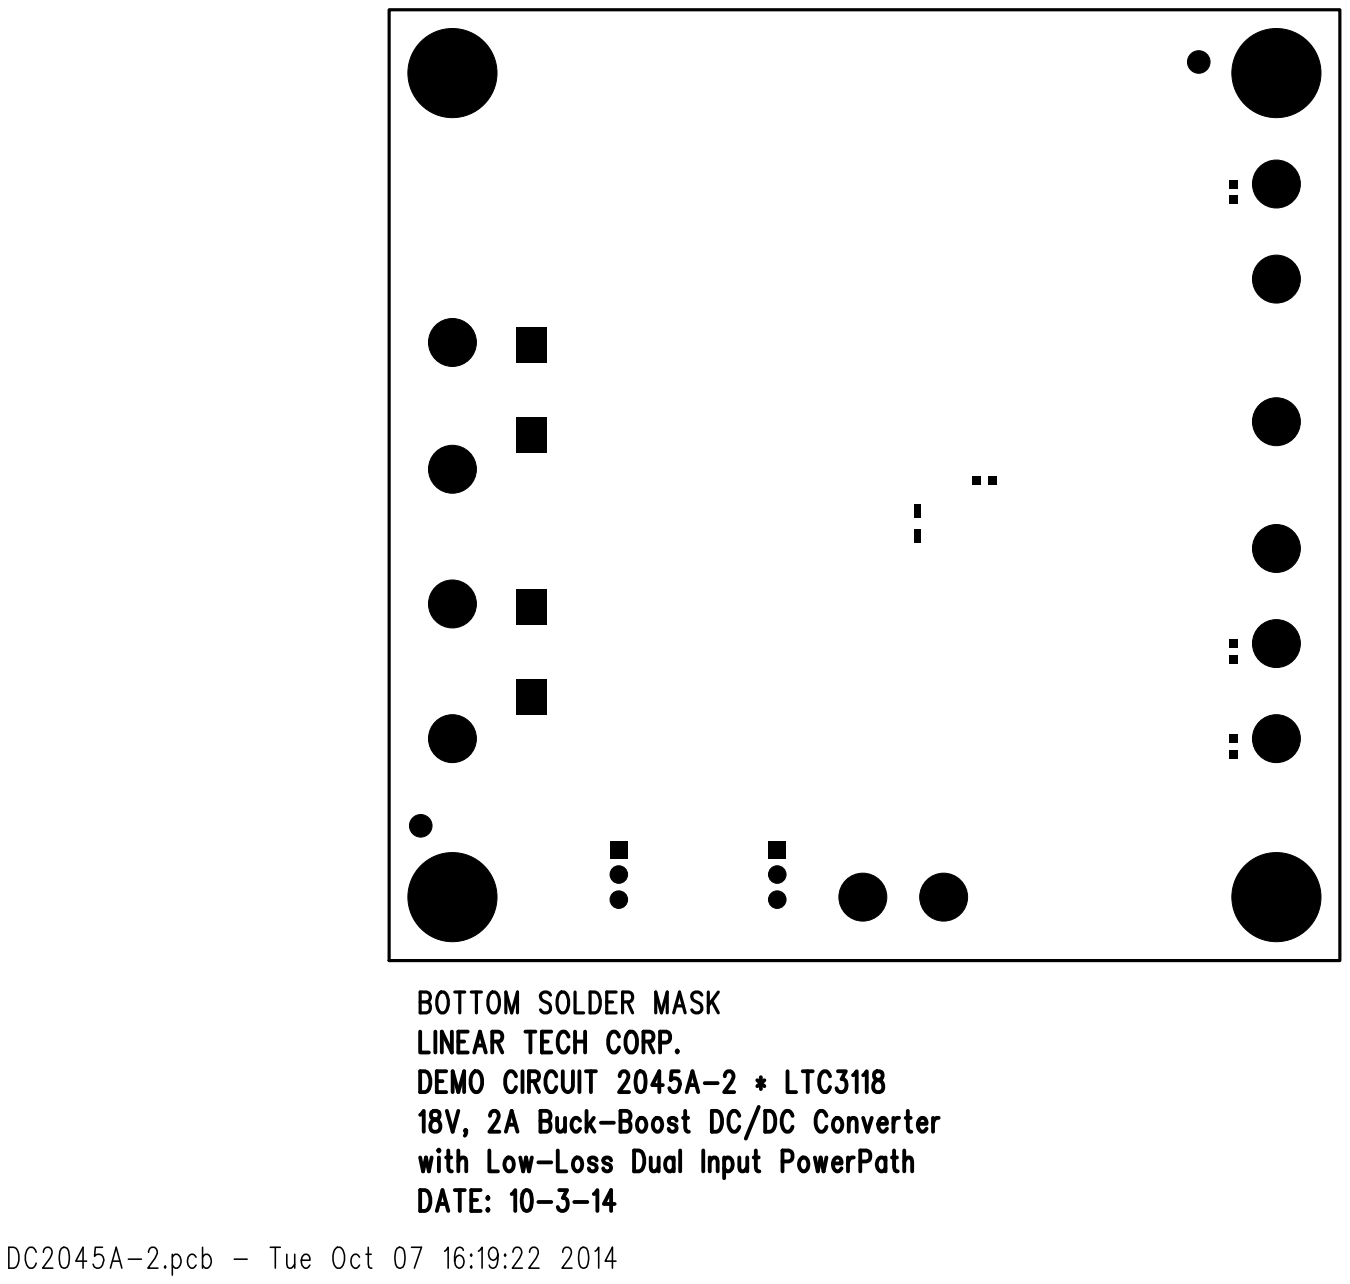
[picture p216: page 1]
