wuzipu123/software/Electronic/DC2045A/DC2045A-2-PDF/DC2045A-2-FAB DRW.pdf

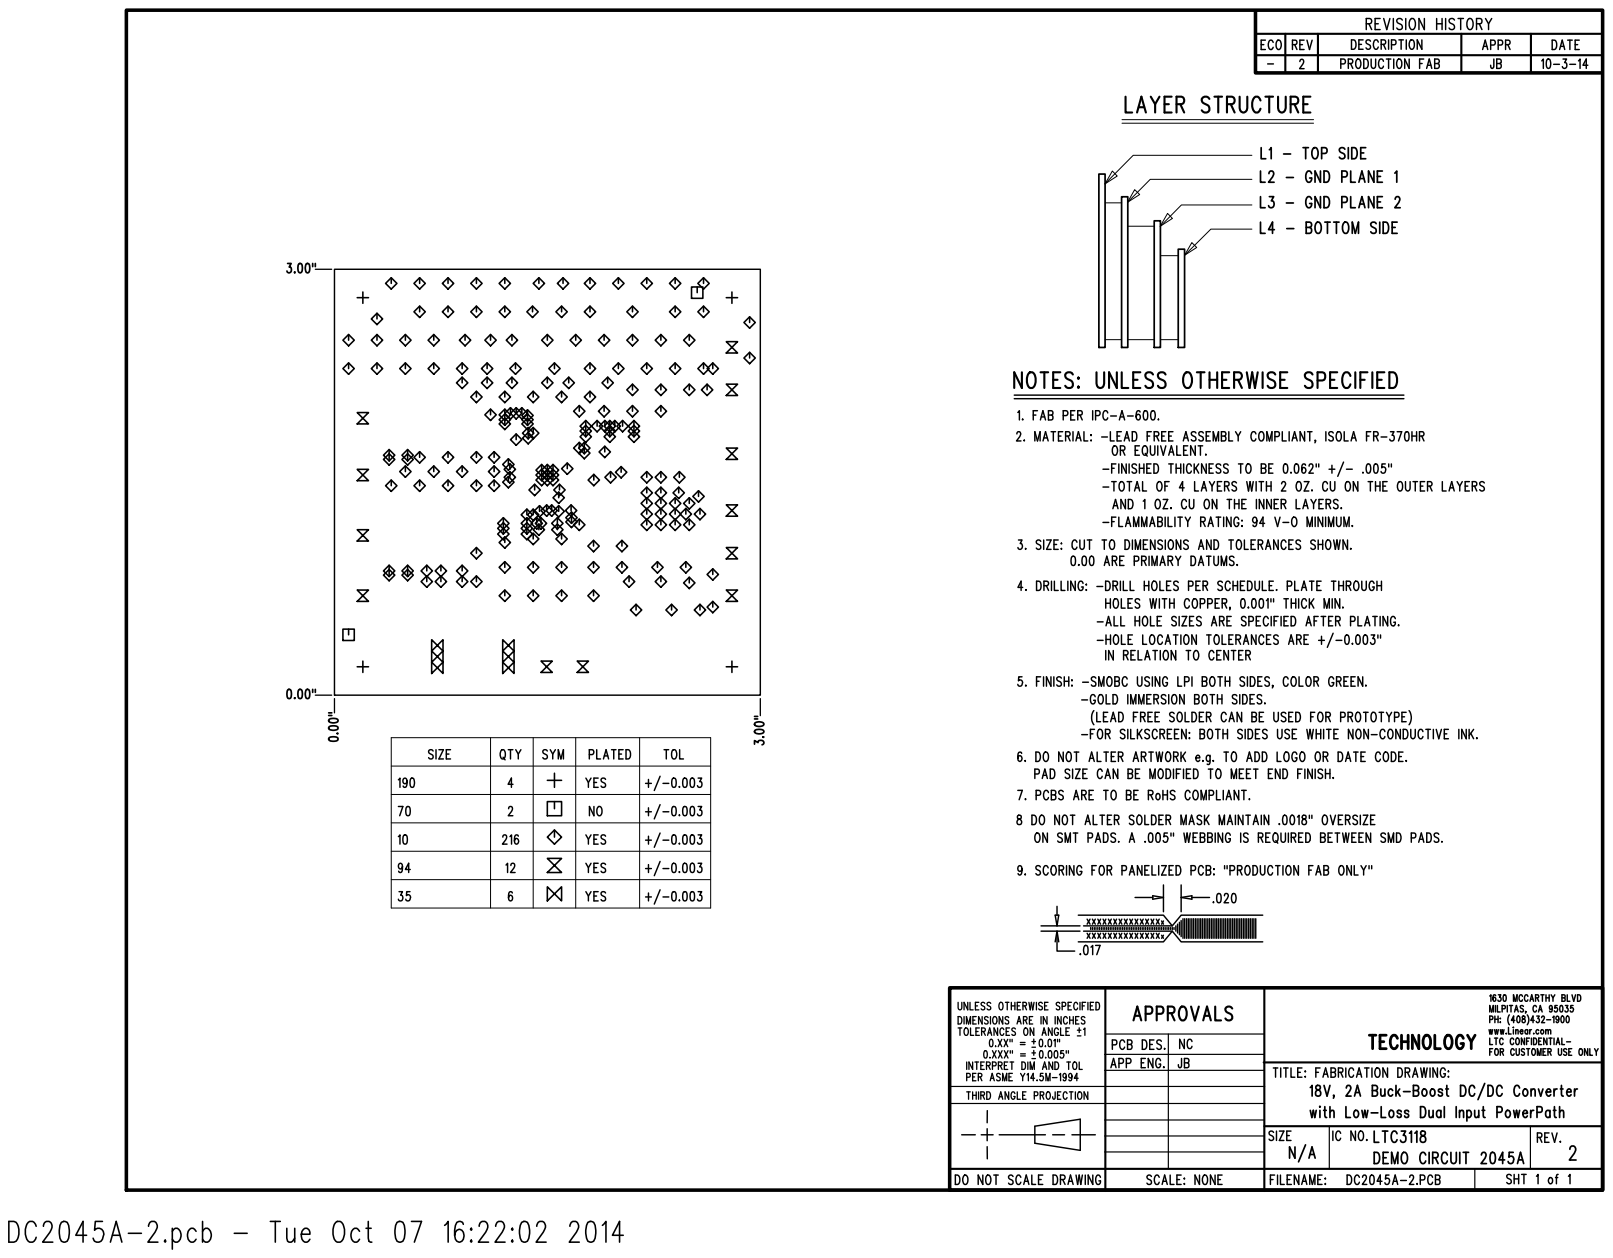
[picture p217: page 1]
