wuzipu123/software/Electronic/DC2045A/DC2045A-2-PDF/DC2045A-2-L1.pdf

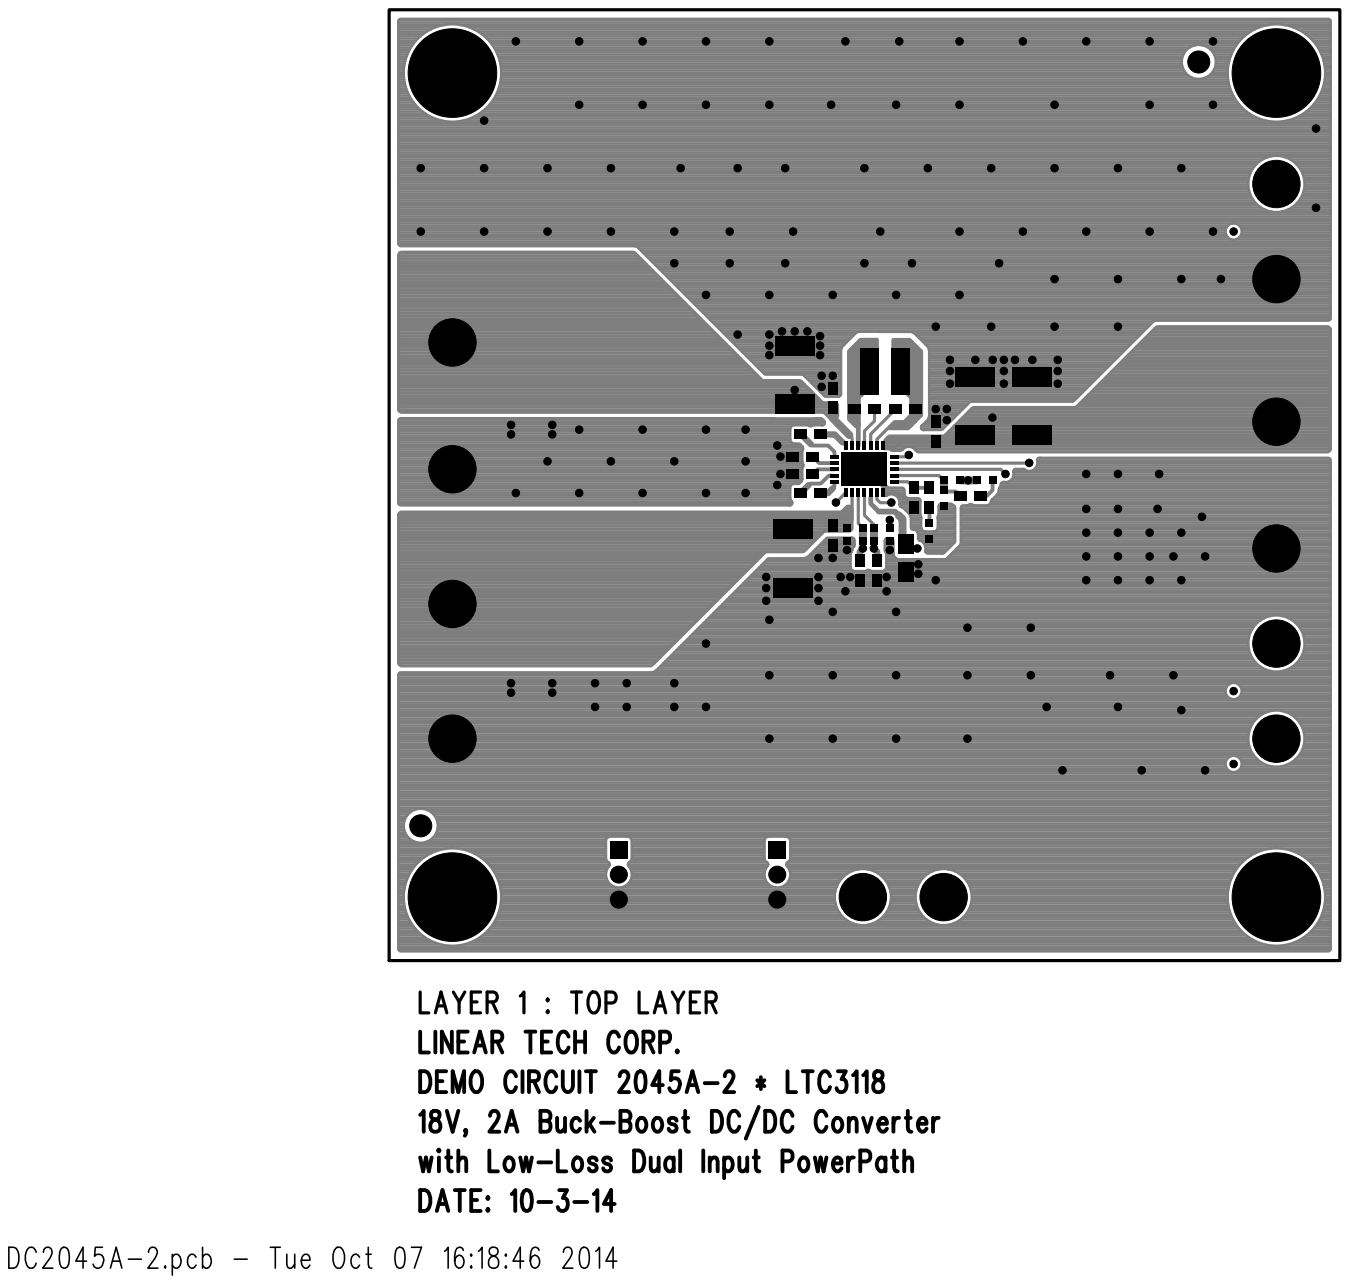
[picture p218: page 1]
