wuzipu123/software/Electronic/DC2045A/DC2045A-2-PDF/DC2045A-2-L2.pdf

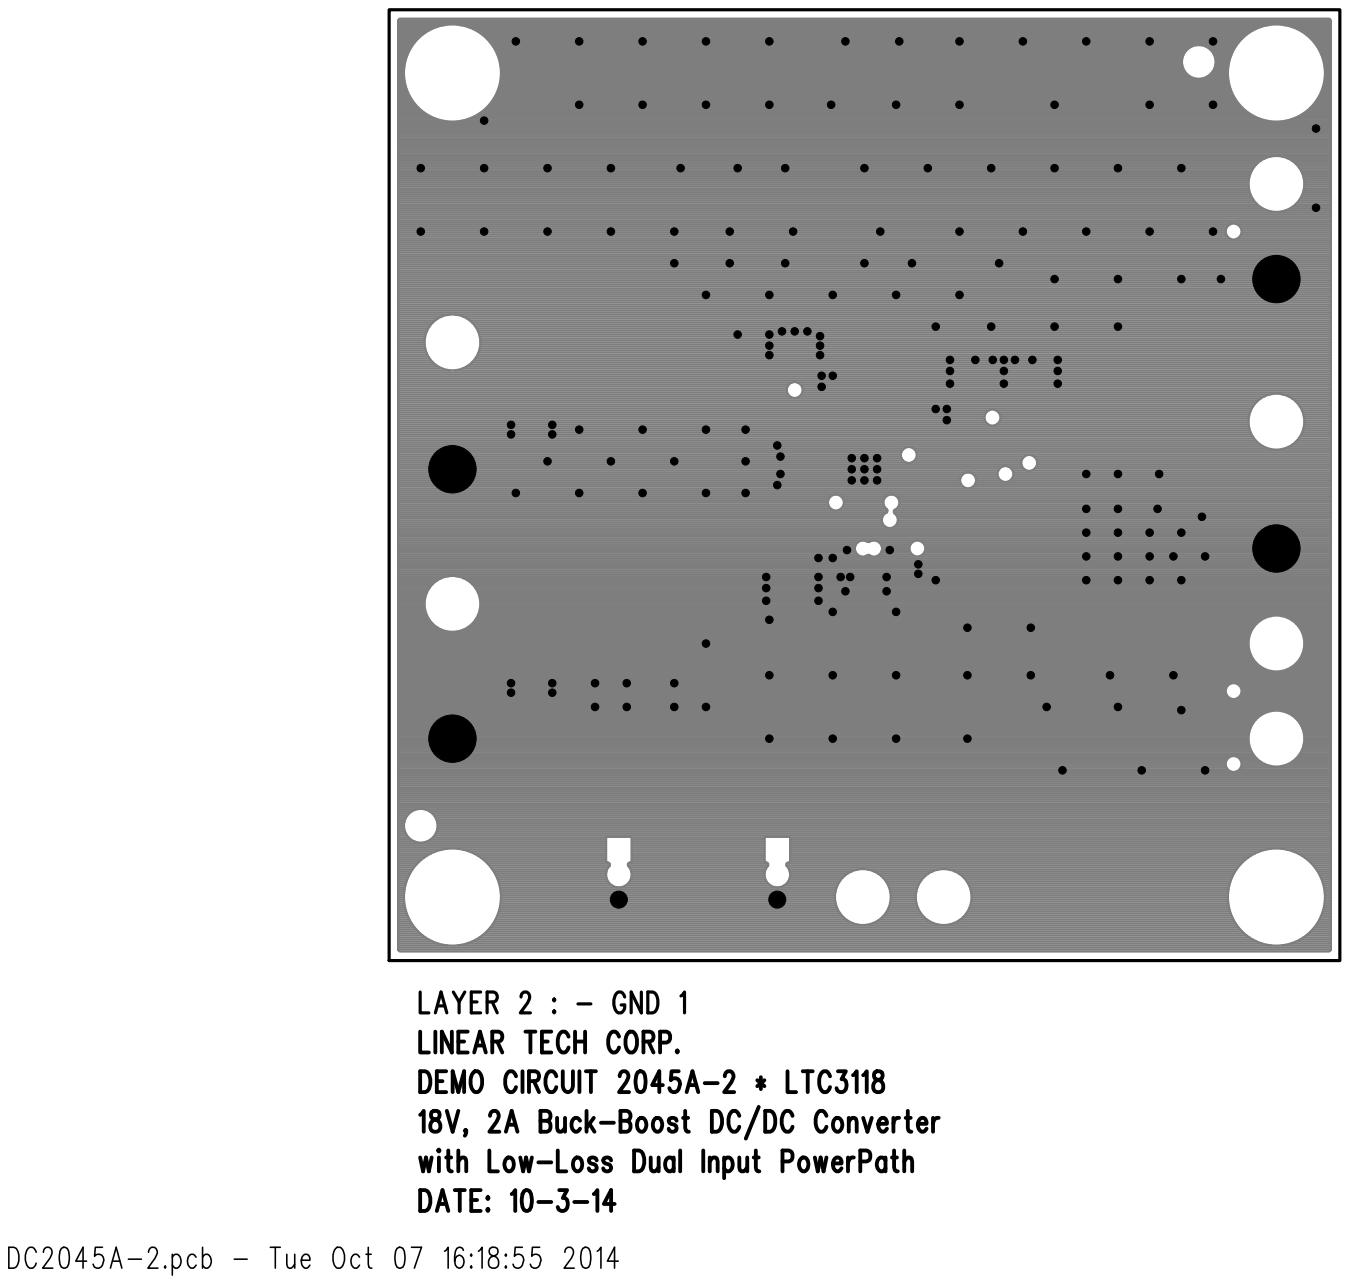
[picture p219: page 1]
