wuzipu123/software/Electronic/DC2045A/DC2045A-2-PDF/DC2045A-2-L3.pdf

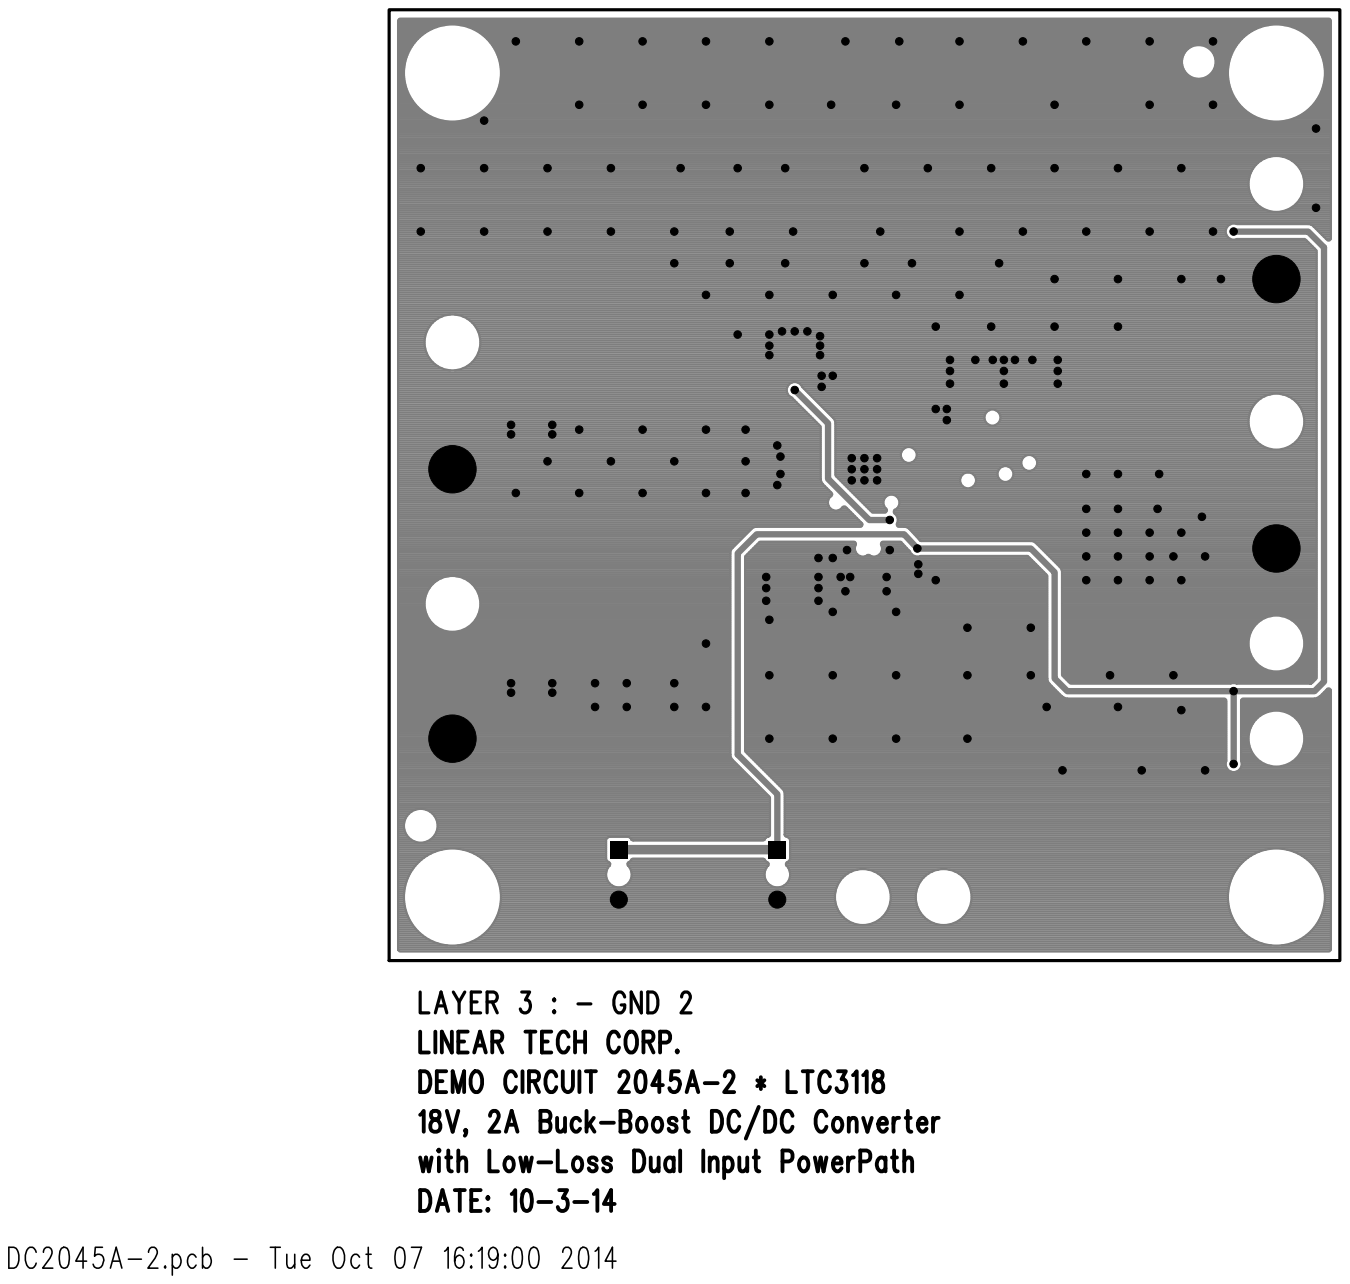
[picture p220: page 1]
