wuzipu123/software/Electronic/DC2045A/DC2045A-2-PDF/DC2045A-2-L4.pdf

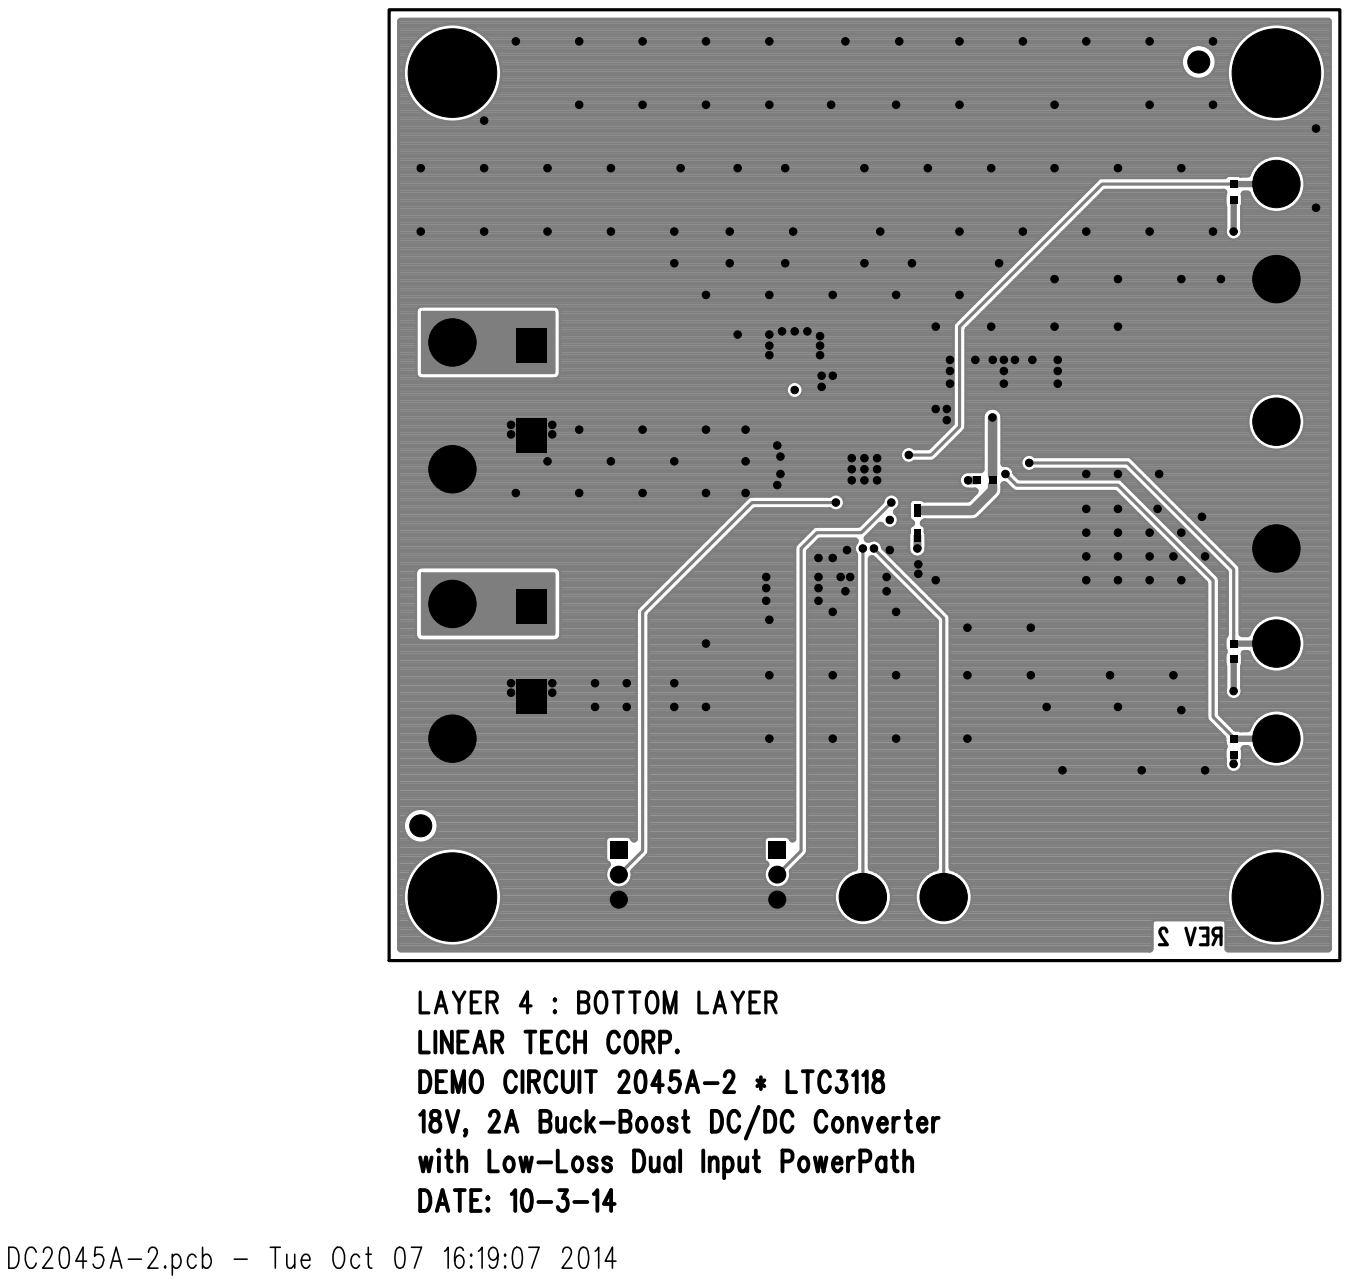
[picture p221: page 1]
