wuzipu123/software/Electronic/DC2045A/DC2045A-2-PDF/DC2045A-2-TOP ASSY.pdf

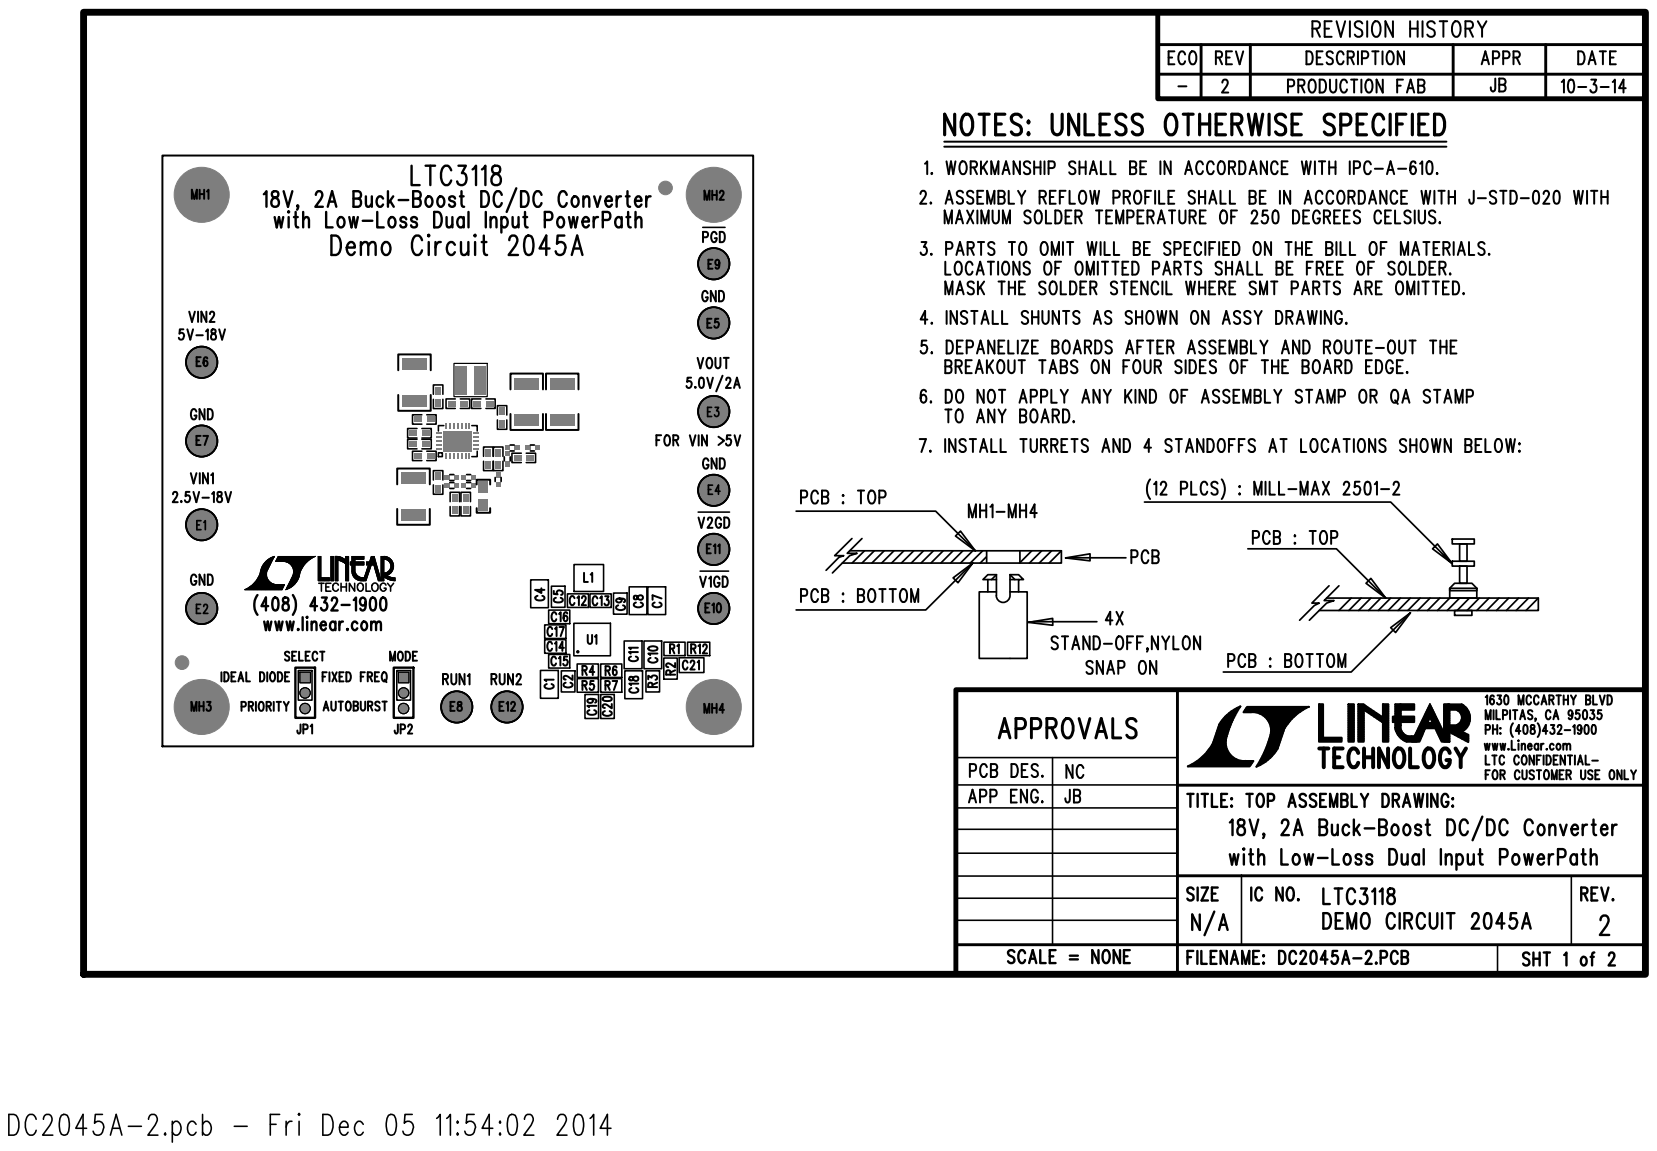
[picture p222: page 1]
