wuzipu123/software/Electronic/DC2045A/DC2045A-2-PDF/DC2045A-2-TOP PMASK.pdf

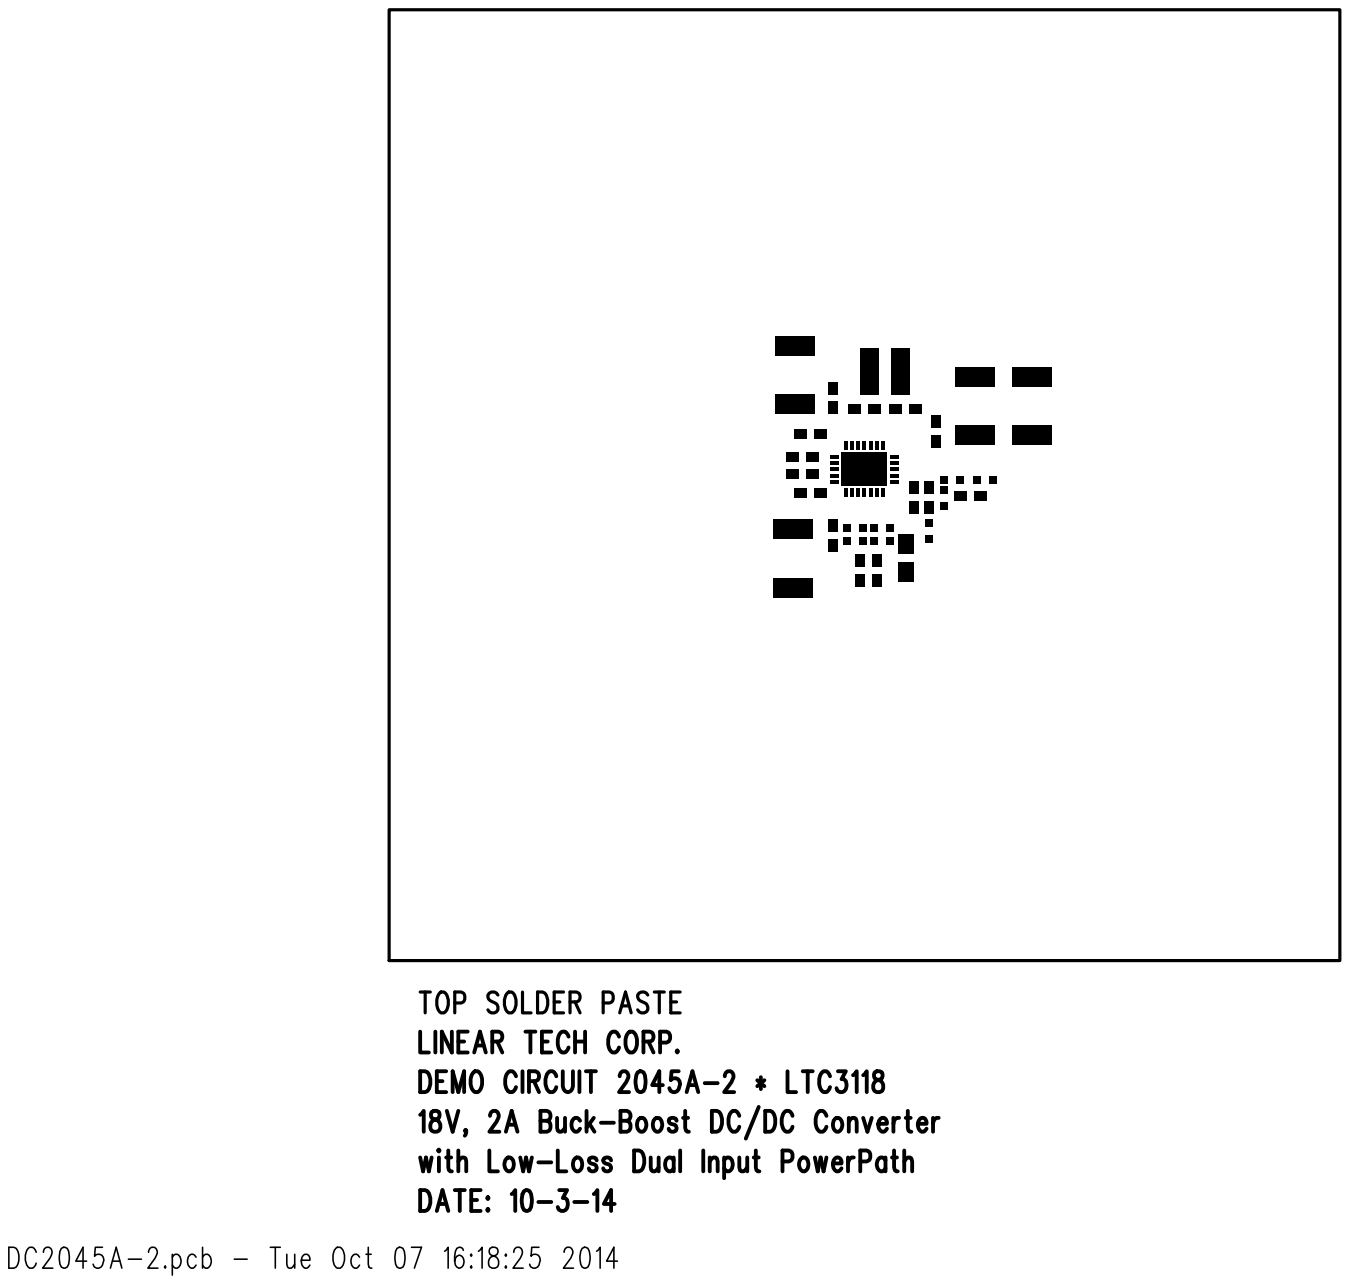
[picture p223: page 1]
