wuzipu123/software/Electronic/DC2045A/DC2045A-2-PDF/DC2045A-2-TOP SILK.pdf

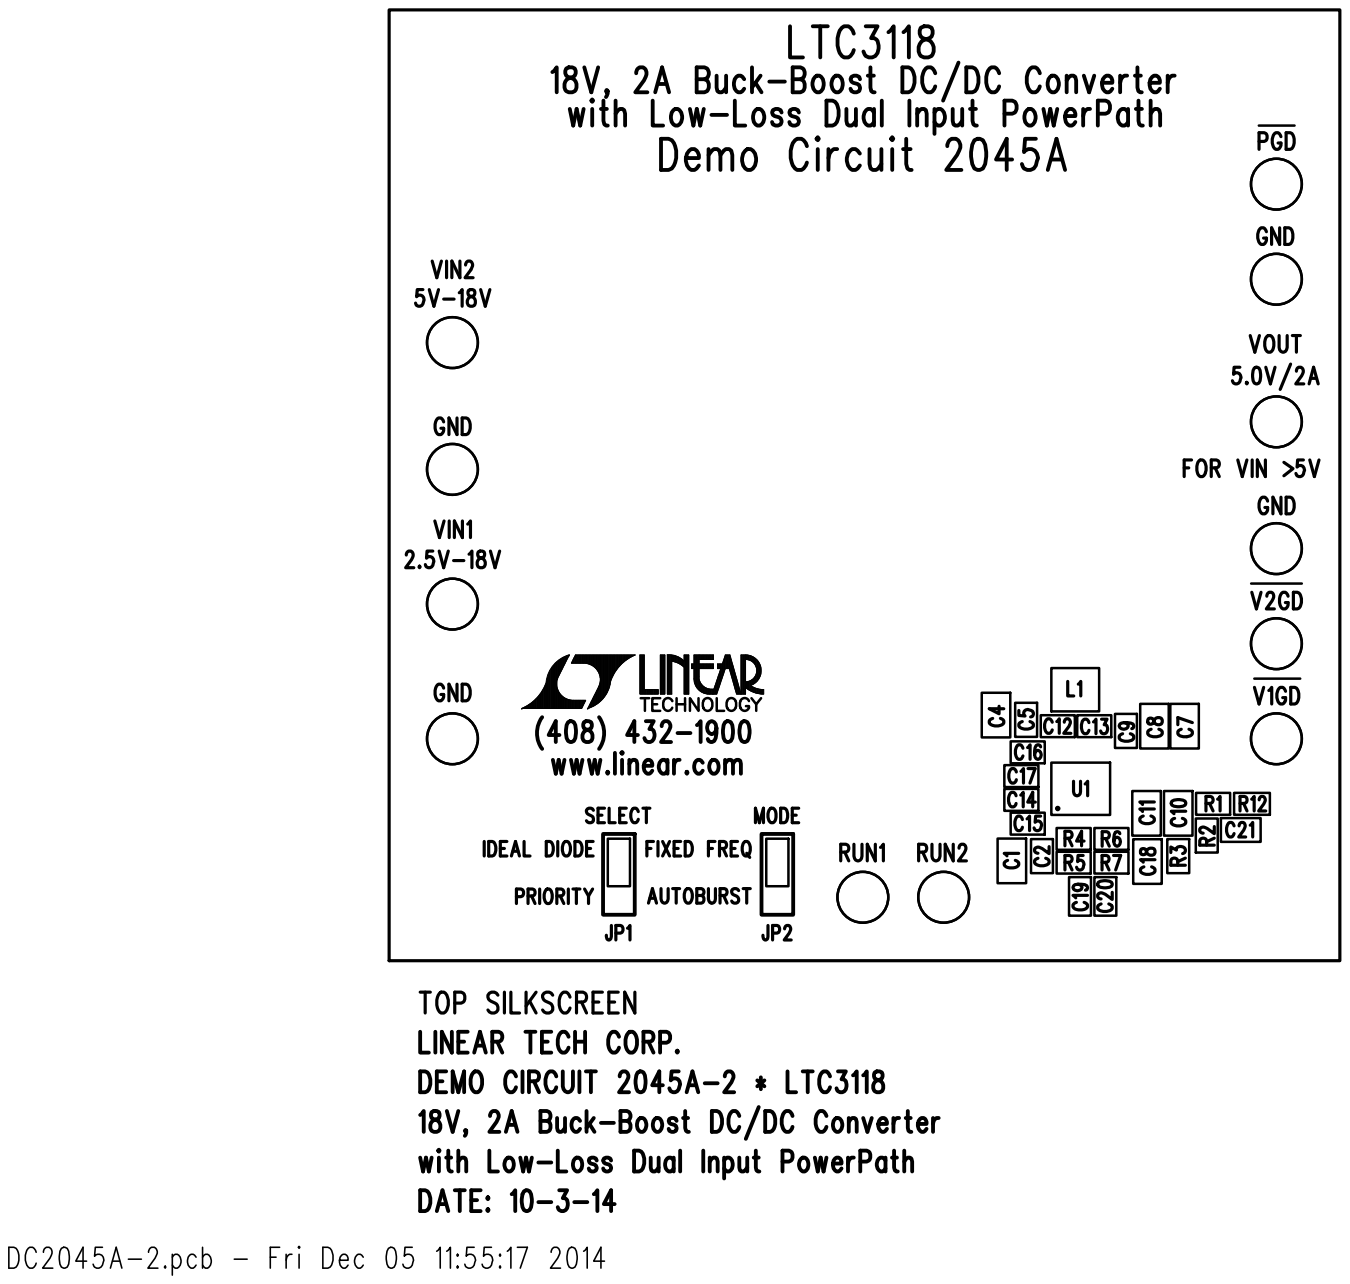
[picture p224: page 1]
