wuzipu123/software/Electronic/DC2045A/DC2045A-2-PDF/DC2045A-2-TOP SMASK.pdf

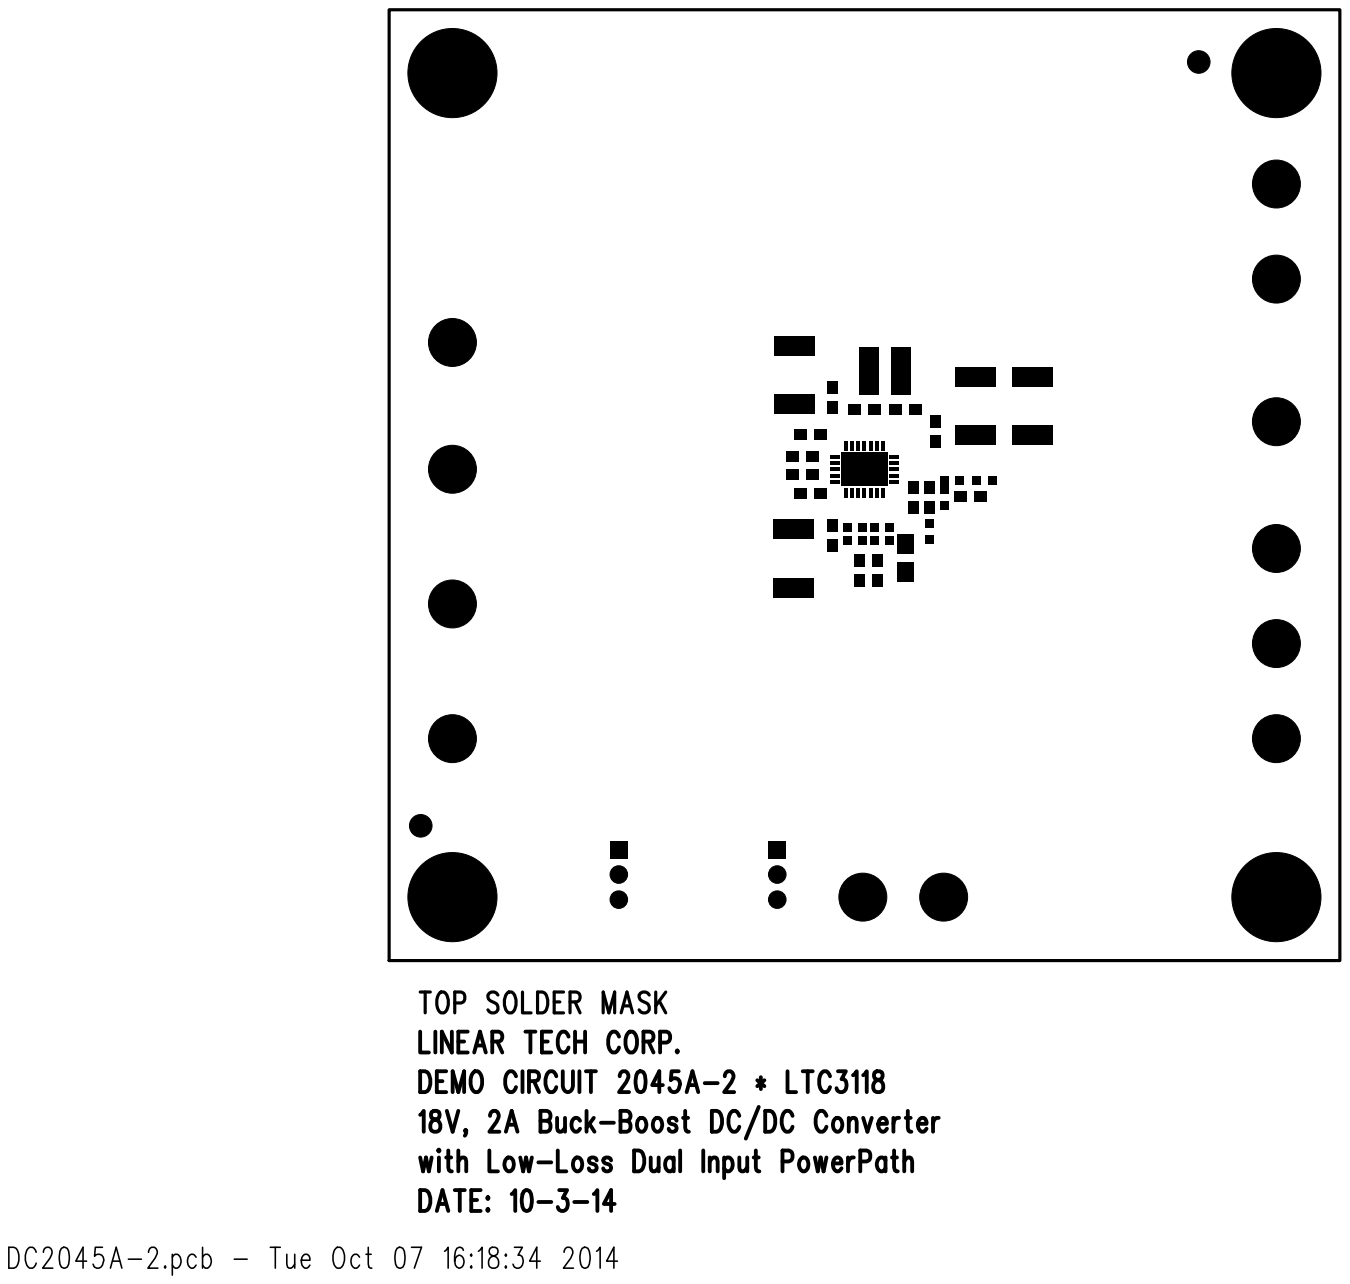
[picture p225: page 1]
