wuzipu123/software/Mechanical/Particle_Sensor/Cutouts_2D_drawings/SensMat_Particle_Sensor_Case_Drawing.pdf

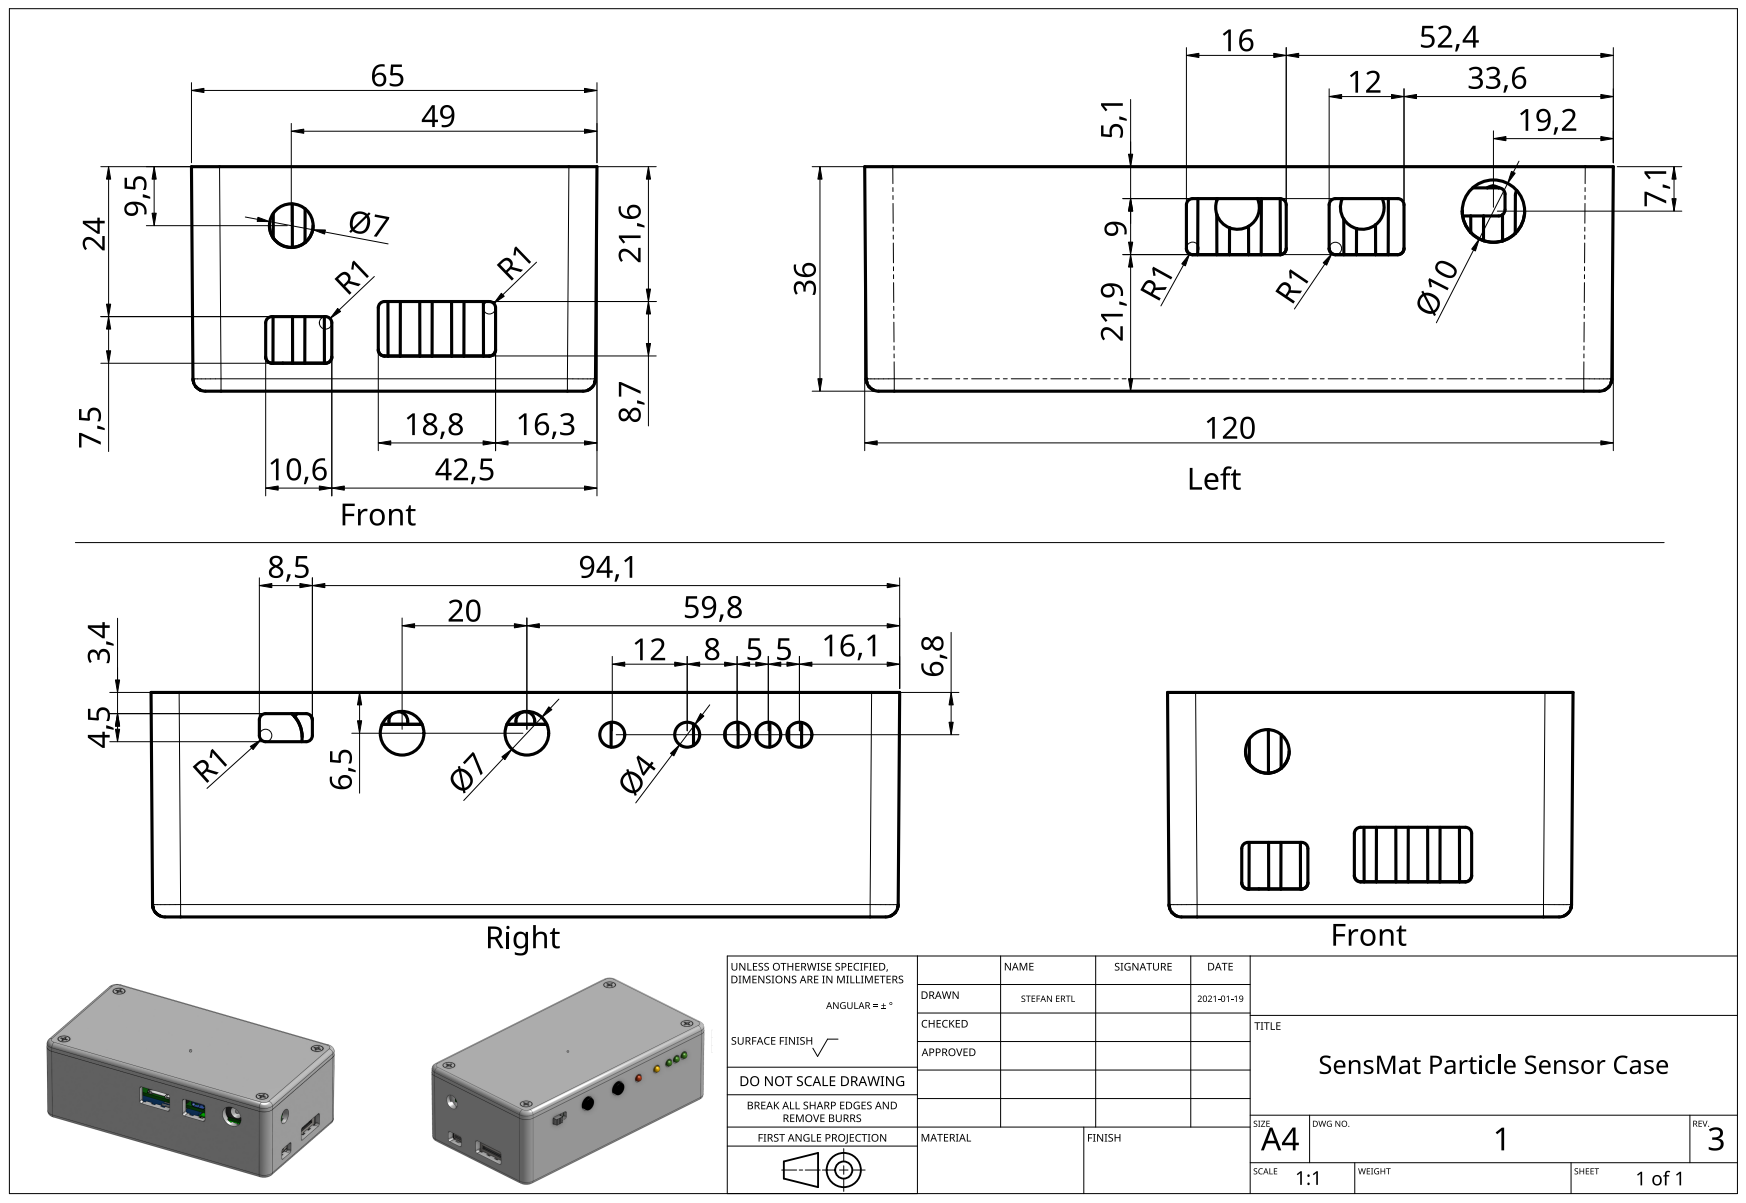
[picture p226: page 1]
