wuzipu123/software/(list of files, drawings)

Other design files:
Electronic/DC2045A/DC2045A-2.DSN
Electronic/DC2045A/DC2045A-2.PCB
