wuzipu123/software/Electronic/RF_LoRa_Mini_V1/RF_LoRa/RF_LoRa.kicad_pcb

## KiCad design Electronic/RF_LoRa_Mini_V1/RF_LoRa/RF_LoRa.kicad_pcb (2024-06-28)

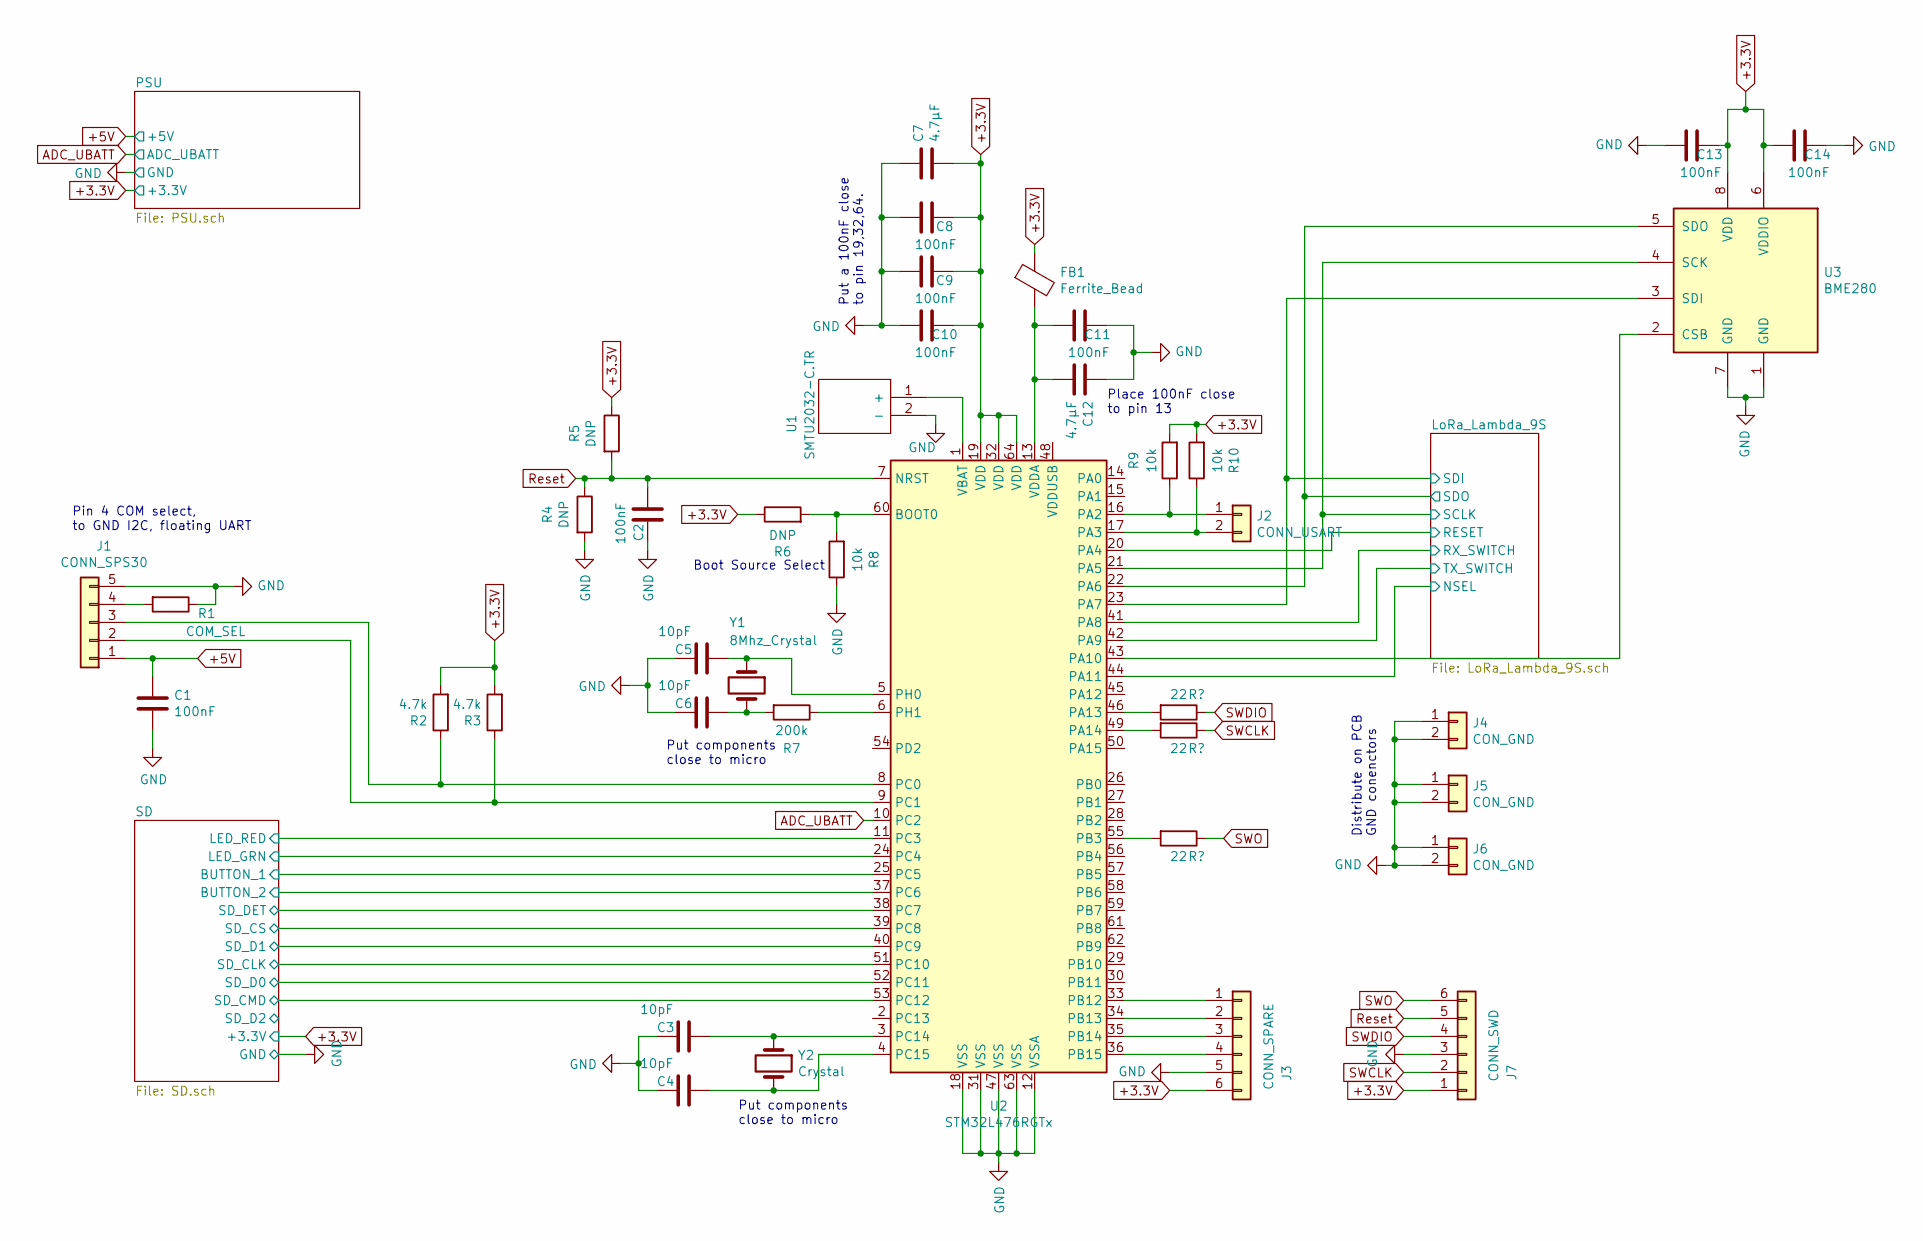
[picture p227: schematic RF_LoRa.sch]

Parts:
C1: 100nF; C_0201_0603Metric
C2, C8, C9, C10, C11, C13, C14: 100nF; C_0603_1608Metric
C3, C4, C5, C6: 10pF; C_0603_1608Metric
C7: 4.7µF; R_0201_0603Metric
C12: 4.7µF; C_0805_2012Metric
FB1: Ferrite_Bead; L_0201_0603Metric
J1: CONN_SPS30; JST_XH_B05B-XH-A_1x05_P2.50mm_Vertical
J2: CONN_USART; JST_XH_B02B-XH-A_1x02_P2.50mm_Vertical
J3: CONN_SPARE; JST_XH_B06B-XH-A_1x06_P2.50mm_Vertical
J4, J5, J6: CON_GND; JST_XH_B02B-XH-A_1x02_P2.50mm_Vertical
J7: CONN_SWD; JST_XH_B06B-XH-A_1x06_P2.50mm_Vertical
R1: COM_SEL; R_0603_1608Metric
R2, R3: 4.7k; R_0603_1608Metric
R4, R5, R6: DNP; R_0603_1608Metric
R7: 200k; R_0603_1608Metric
R8, R9, R10: 10k; R_0603_1608Metric
U1: SMTU2032-C.TR; SMTU2032CTR; Mouser Part Number 614-SMTU2032-C.TR
U2: STM32L476RGTx; LQFP-64_10x10mm_P0.5mm
U3: BME280; Bosch_LGA-8_2.5x2.5mm_P0.65mm_ClockwisePinNumbering
Y1: 8Mhz_Crystal; Crystal_SMD_0603-2Pin_6.0x3.5mm_HandSoldering
Y2: Crystal; Crystal_SMD_0603-2Pin_6.0x3.5mm_HandSoldering

Connections:
+3.3V: C7.1, C8.2, C9.2, C10.2, C13.2, C14.1, FB1.1, J3.6, J7.1, R2.2, R3.2, R5.1, R6.1, R9.2, R10.2, U2.19 (VDD), U2.32 (VDD), U2.64 (VDD), U3.6 (VDDIO), U3.8 (VDD); also elsewhere on the board
+5V: C1.1, J1.1; also elsewhere on the board
/LoRa_Lambda_9S/NSEL: U2.44 (PA11); also elsewhere on the board
/LoRa_Lambda_9S/RESET: U2.20 (PA4); also elsewhere on the board
/LoRa_Lambda_9S/RX_SWITCH: U2.41 (PA8); also elsewhere on the board
/LoRa_Lambda_9S/SCLK: U2.21 (PA5), U3.4 (SCK); also elsewhere on the board
/LoRa_Lambda_9S/SDI: U2.23 (PA7), U3.3 (SDI); also elsewhere on the board
/LoRa_Lambda_9S/SDO: U2.22 (PA6), U3.5 (SDO); also elsewhere on the board
/LoRa_Lambda_9S/TX_SWITCH: U2.42 (PA9); also elsewhere on the board
/SD/BUTTON_1: U2.25 (PC5); also elsewhere on the board
/SD/BUTTON_2: U2.37 (PC6); also elsewhere on the board
/SD/LED_GRN: U2.24 (PC4); also elsewhere on the board
/SD/LED_RED: U2.11 (PC3); also elsewhere on the board
/SD/SD_CLK: U2.51 (PC10); also elsewhere on the board
/SD/SD_CMD: U2.53 (PC12); also elsewhere on the board
/SD/SD_CS: U2.39 (PC8); also elsewhere on the board
/SD/SD_D0: U2.52 (PC11); also elsewhere on the board
/SD/SD_D1: U2.40 (PC9); also elsewhere on the board
/SD/SD_DET: U2.38 (PC7); also elsewhere on the board
ADC_UBATT: U2.10 (PC2); also elsewhere on the board
GND: C1.2, C2.2, C3.2, C4.2, C5.2, C6.2, C7.2, C8.1, C9.1, C10.1, C11.2, C12.2, C13.1, C14.2, J1.5, J3.5, J4.1, J4.2, J5.1, J5.2, J6.1, J6.2, J7.3, R1.1, R4.2, R8.1, U1.2 (-), U2.12 (VSSA), U2.18 (VSS), U2.31 (VSS), U2.47 (VSS), U2.63 (VSS), U3.1 (GND), U3.7 (GND); also elsewhere on the board
unnamed: C3.1, U2.3 (PC14), Y2.1
unnamed: C4.1, U2.4 (PC15), Y2.2
unnamed: C5.1, U2.5 (PH0), Y1.1
unnamed: C6.1, R7.2, Y1.2
unnamed: C11.1, C12.1, FB1.2, U2.13 (VDDA)
unnamed: J1.2, R3.1, U2.9 (PC1)
unnamed: J1.3, R2.1, U2.8 (PC0)
unnamed: J1.4, R1.2
unnamed: J2.1, R9.1, U2.16 (PA2)
unnamed: J2.2, R10.1, U2.17 (PA3)
unnamed: J3.1, U2.33 (PB12)
unnamed: J3.2, U2.34 (PB13)
unnamed: J3.3, U2.35 (PB14)
unnamed: J3.4, U2.36 (PB15)
unnamed: R6.2, R8.2, U2.60 (BOOT0)
unnamed: R7.1, U2.6 (PH1)
unnamed 53: U2.46 (PA13); also elsewhere on the board
unnamed 54: U2.49 (PA14); also elsewhere on the board
unnamed 55: U2.55 (PB3); also elsewhere on the board
unnamed: U1.1 (+), U2.1 (VBAT)
unnamed: U2.43 (PA10), U3.2 (CSB)
Reset: C2.1, J7.5, R4.1, R5.2, U2.7 (NRST)
SWCLK: J7.2; also elsewhere on the board
SWDIO: J7.4; also elsewhere on the board
SWO: J7.6; also elsewhere on the board

Notes on the sheet:
Put a 100nF close to pin 19,32,64.
Put components close to micro
Boot Source Select
Place 100nF close to pin 13
Distribute on PCB GND conenctors
Pin 4 COM select, to GND I2C, floating UART

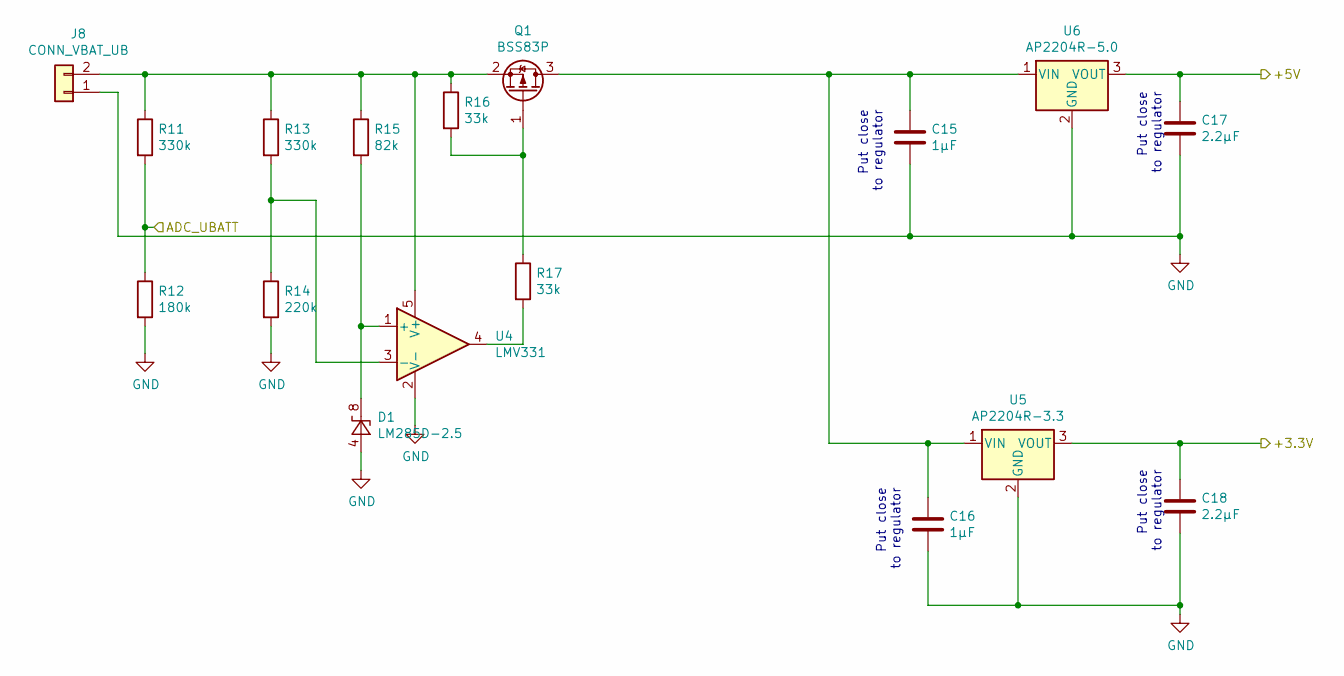
[picture p228: schematic PSU.sch]

Parts:
C15, C16: 1µF; C_0603_1608Metric
C17, C18: 2.2µF; C_0603_1608Metric
D1: LM285D-2.5; SOIC-8_3.9x4.9mm_P1.27mm
J8: CONN_VBAT_UB; JST_XH_B02B-XH-A_1x02_P2.50mm_Vertical
Q1: BSS83P; SOT-23
R11, R13: 330k; R_0603_1608Metric
R12: 180k; R_0603_1608Metric
R14: 220k; R_0603_1608Metric
R15: 82k; R_0603_1608Metric
R16, R17: 33k; R_0603_1608Metric
U4: LMV331; SOT-23-5_HandSoldering
U5: AP2204R-3.3; SOT-89-3
U6: AP2204R-5.0; SOT-89-3

Connections:
+3.3V: C18.1, U5.3 (VOUT); also elsewhere on the board
+5V: C17.1, U6.3 (VOUT); also elsewhere on the board
ADC_UBATT: R11.2, R12.1; also elsewhere on the board
GND: C15.2, C16.2, C17.2, C18.2, D1.4 (A), J8.1, R12.2, R14.2, U4.2 (V-), U5.2 (GND), U6.2 (GND); also elsewhere on the board
unnamed: C15.1, C16.1, Q1.3 (D), U5.1 (VIN), U6.1 (VIN)
unnamed: D1.8 (K), R15.2, U4.1 (+)
unnamed: J8.2, Q1.2 (S), R11.1, R13.1, R15.1, R16.1, U4.5 (V+)
unnamed: Q1.1 (G), R16.2, R17.1
unnamed: R13.2, R14.1, U4.3 (-)
unnamed: R17.2, U4.4

Notes on the sheet:
Put close to regulator
Put close to regulator

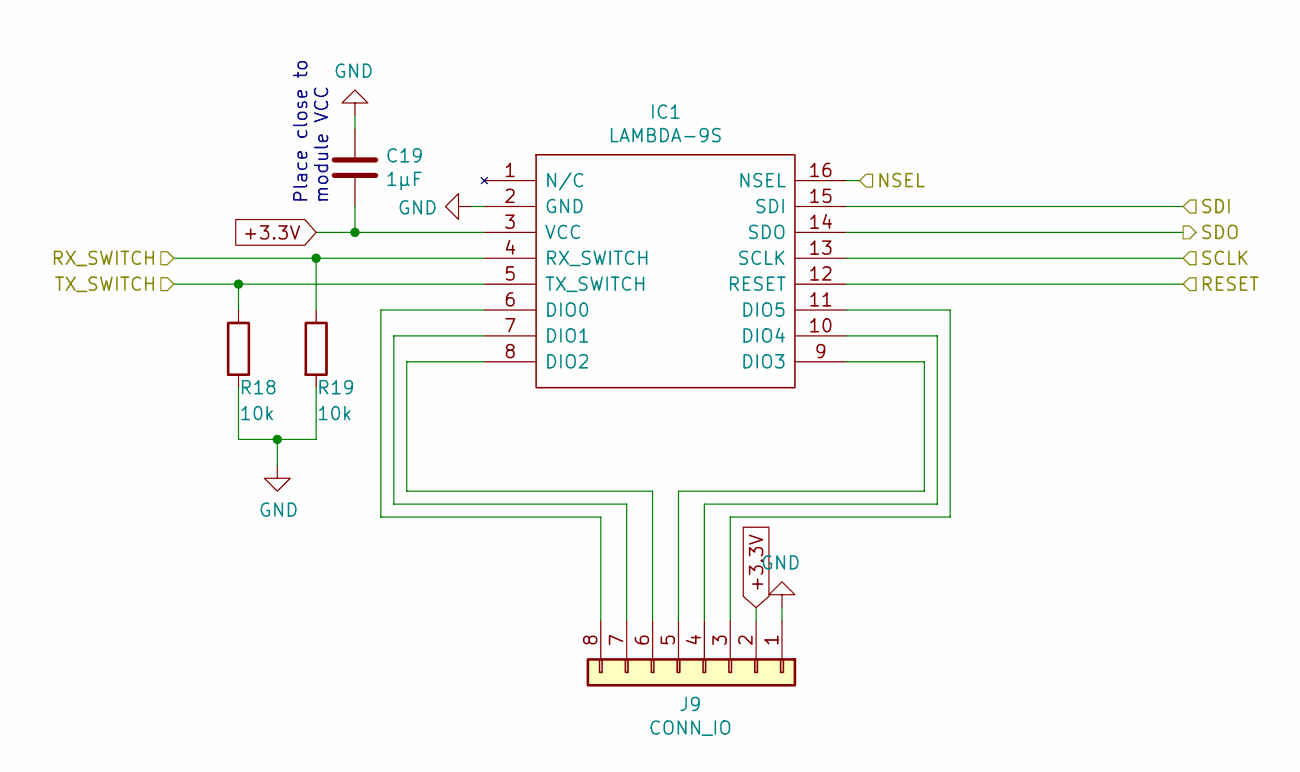
[picture p229: schematic LoRa_Lambda_9S.sch]

Parts:
C19: 1µF; C_0603_1608Metric
IC1: LAMBDA-9S; LAMBDA9S; Mouser Part Number 223-LAMBDA-9S
J9: CONN_IO; JST_XH_B08B-XH-A_1x08_P2.50mm_Vertical
R18, R19: 10k; R_0603_1608Metric

Connections:
+3.3V: C19.2, IC1.3 (VCC), J9.2; also elsewhere on the board
/LoRa_Lambda_9S/NSEL: IC1.16 (NSEL); also elsewhere on the board
/LoRa_Lambda_9S/RESET: IC1.12 (RESET); also elsewhere on the board
/LoRa_Lambda_9S/RX_SWITCH: IC1.4 (RX_SWITCH), R19.1; also elsewhere on the board
/LoRa_Lambda_9S/SCLK: IC1.13 (SCLK); also elsewhere on the board
/LoRa_Lambda_9S/SDI: IC1.15 (SDI); also elsewhere on the board
/LoRa_Lambda_9S/SDO: IC1.14 (SDO); also elsewhere on the board
/LoRa_Lambda_9S/TX_SWITCH: IC1.5 (TX_SWITCH), R18.1; also elsewhere on the board
GND: C19.1, IC1.2 (GND), J9.1, R18.2, R19.2; also elsewhere on the board
unnamed: IC1.6 (DIO0), J9.8
unnamed: IC1.7 (DIO1), J9.7
unnamed: IC1.8 (DIO2), J9.6
unnamed: IC1.9 (DIO3), J9.5
unnamed: IC1.10 (DIO4), J9.4
unnamed: IC1.11 (DIO5), J9.3

Notes on the sheet:
Place close to module VCC

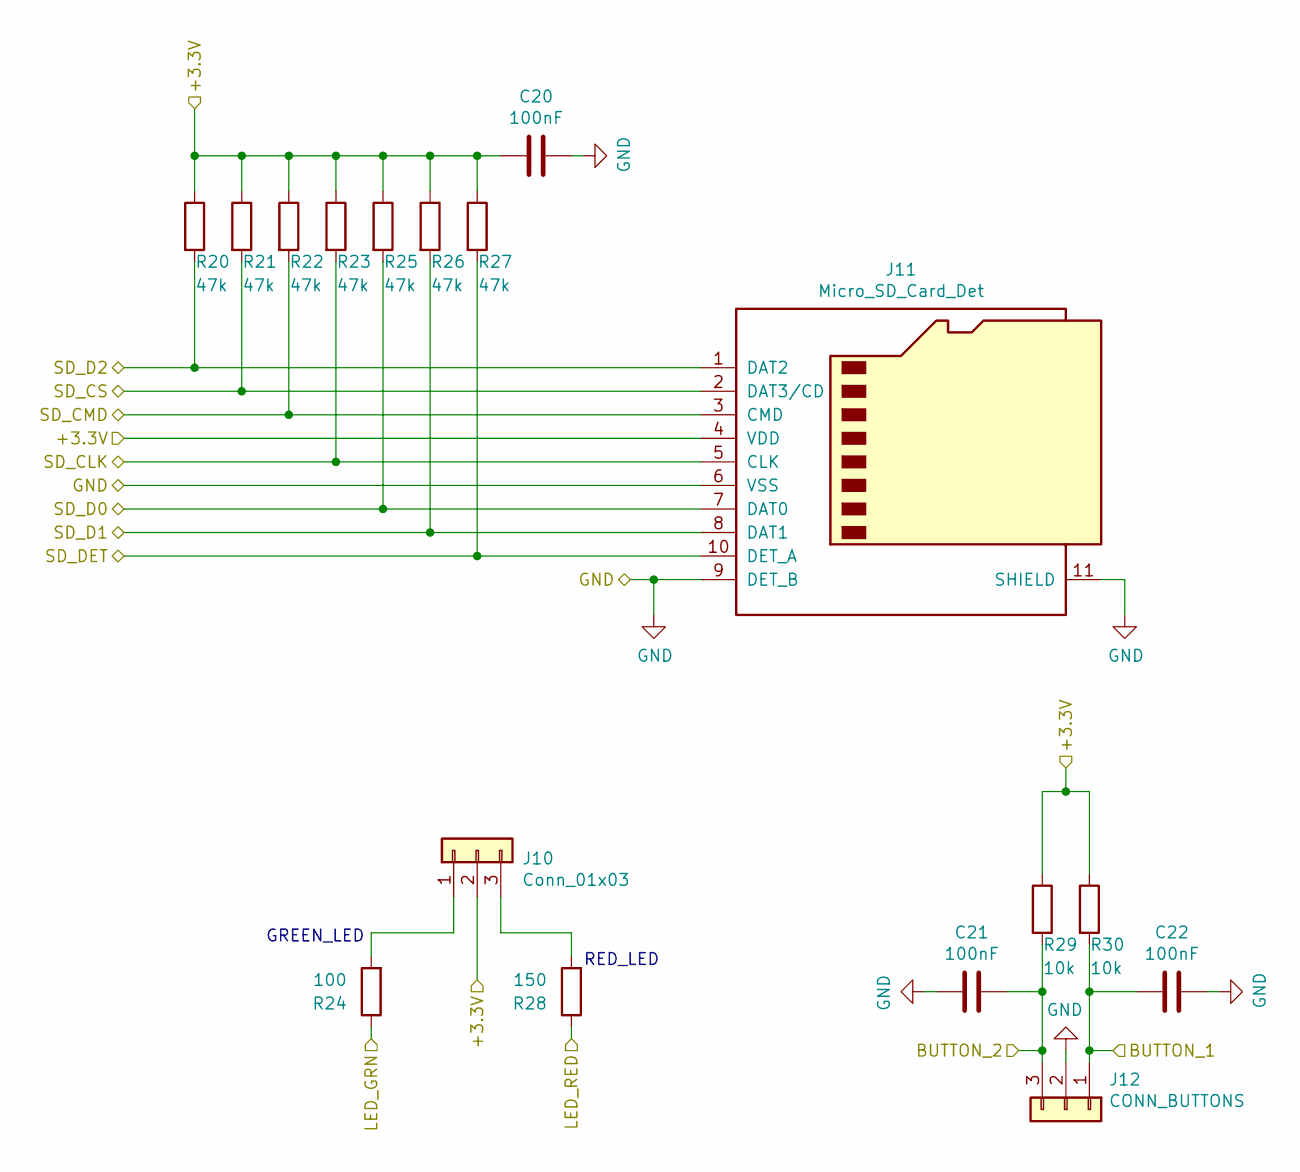
[picture p230: schematic SD.sch]

Parts:
C20, C21, C22: 100nF; C_0201_0603Metric
J10: Conn_01x03; JST_XH_B03B-XH-AM_1x03_P2.50mm_Vertical
J11: Micro_SD_Card_Det; microSD_HC_Hirose_DM3AT-SF-PEJM5
J12: CONN_BUTTONS; JST_XH_B03B-XH-A_1x03_P2.50mm_Vertical
R20, R21, R22, R23, R25, R26, R27: 47k; R_0603_1608Metric
R24: 100; R_0603_1608Metric
R28: 150; R_0603_1608Metric
R29, R30: 10k; R_0603_1608Metric

Connections:
+3.3V: C20.2, J10.2, J11.4 (VDD), R20.1, R21.1, R22.1, R23.1, R25.1, R26.1, R27.1, R29.1, R30.1; also elsewhere on the board
/SD/BUTTON_1: C22.2, J12.1, R30.2; also elsewhere on the board
/SD/BUTTON_2: C21.1, J12.3, R29.2; also elsewhere on the board
/SD/LED_GRN: R24.1; also elsewhere on the board
/SD/LED_RED: R28.1; also elsewhere on the board
/SD/SD_CLK: J11.5 (CLK), R23.2; also elsewhere on the board
/SD/SD_CMD: J11.3 (CMD), R22.2; also elsewhere on the board
/SD/SD_CS: J11.2 (DAT3/CD), R21.2; also elsewhere on the board
/SD/SD_D0: J11.7 (DAT0), R25.2; also elsewhere on the board
/SD/SD_D1: J11.8 (DAT1), R26.2; also elsewhere on the board
/SD/SD_D2: J11.1 (DAT2), R20.2
/SD/SD_DET: J11.10 (DET_A), R27.2; also elsewhere on the board
GND: C20.1, C21.2, C22.1, J11.6 (VSS), J11.9 (DET_B), J11.11 (SHIELD), J12.2; also elsewhere on the board
unnamed: J10.1, R24.2
unnamed: J10.3, R28.2

Notes on the sheet:
RED_LED
GREEN_LED

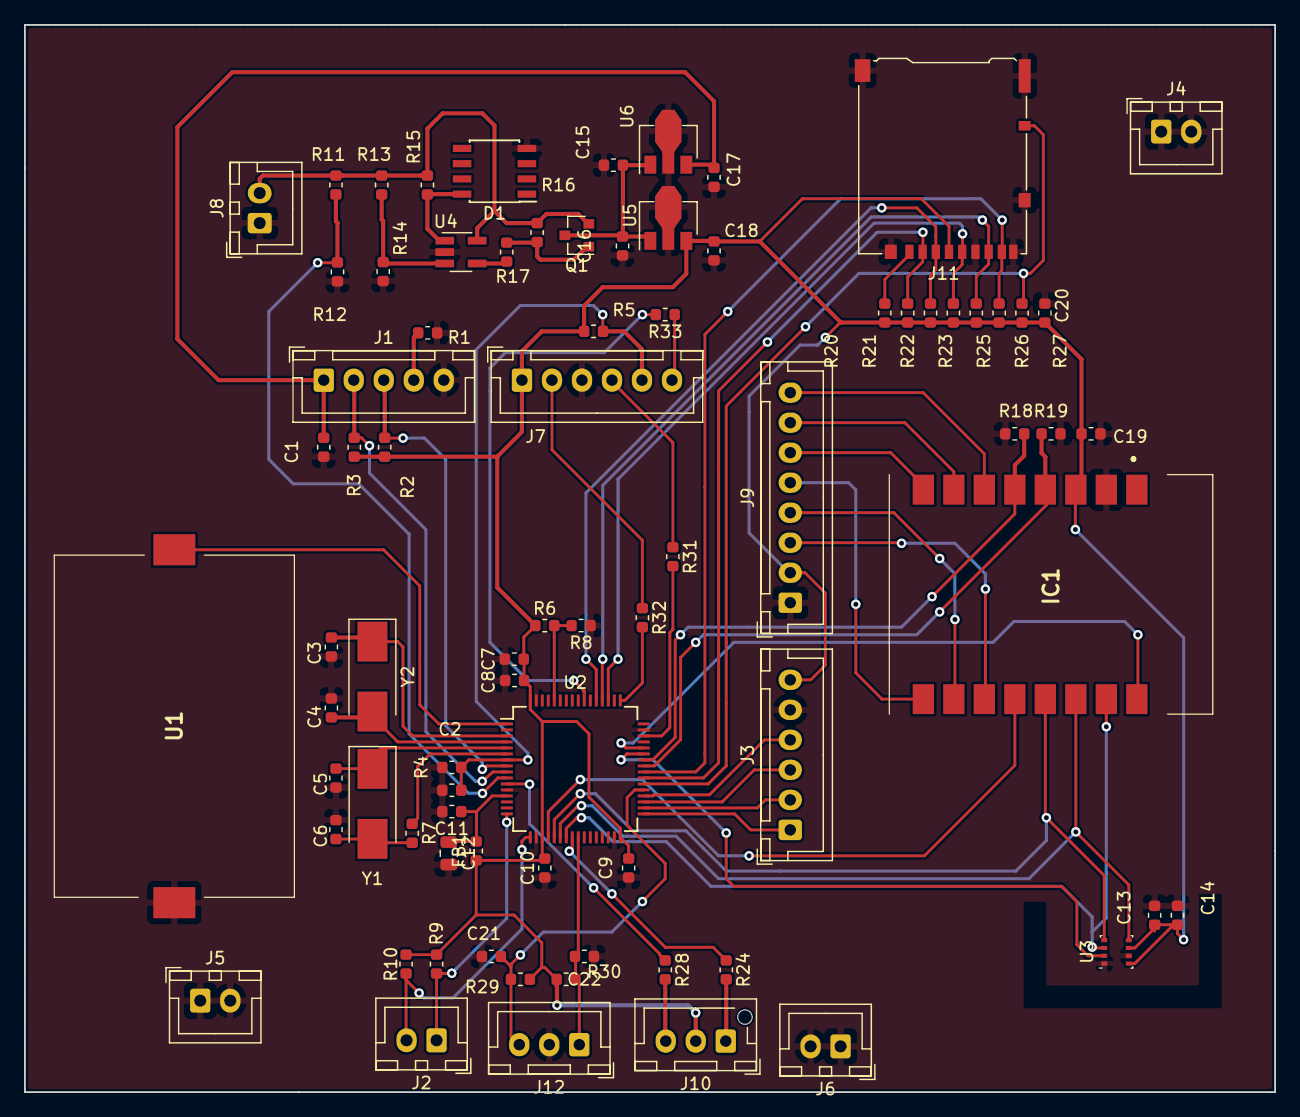
[picture p231: board RF_LoRa.kicad_pcb from above]

Board: 2 copper layers, 104.1 x 88.9 mm, 79 parts (0 on the bottom side), 61 nets.

Other parts of the board:
R31, R32, R33: 22; R_0603_1608Metric

Their connections:
unnamed 53: R31.2; also elsewhere on the board
unnamed 54: R32.2; also elsewhere on the board
unnamed 55: R33.2; also elsewhere on the board
SWCLK: R32.1; also elsewhere on the board
SWDIO: R31.1; also elsewhere on the board
SWO: R33.1; also elsewhere on the board
