wuzipu123/software/Electronic/Tochterplatine_BME280/Tochterplatine_BME280.kicad_pcb

## KiCad design Electronic/Tochterplatine_BME280/Tochterplatine_BME280.kicad_pcb (2024-06-28)

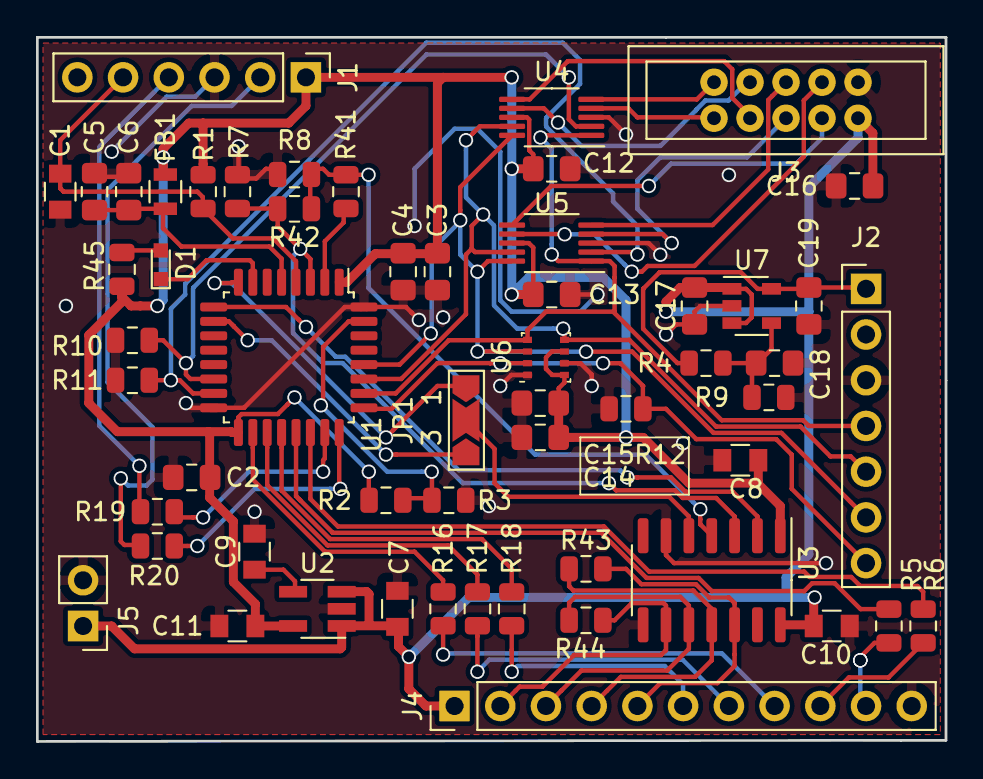
[picture p232: board Tochterplatine_BME280.kicad_pcb from above]

Board: 2 copper layers, 50.5 x 39.1 mm, 56 parts (0 on the bottom side), 50 nets.

Parts:
C1, C8, C10: 100n; C_0805
C2, C3, C5, C12, C13, C14, C15, C16, C17: 100n; C_0805_2012Metric_Pad1.15x1.40mm_HandSolder
C4, C6: 1u; C_0805_2012Metric_Pad1.15x1.40mm_HandSolder
C7, C11: 1u; C_0805
C9: 10n; C_0805
C18: 470pF; C_0805_2012Metric_Pad1.15x1.40mm_HandSolder
C19: 2.2uF; C_0805_2012Metric_Pad1.15x1.40mm_HandSolder
D1: LED; LED_0603
FB1: Ferrite_Bead; L_0805
J1: Conn_01x06_Male; PinHeader_1x06_P2.54mm_Vertical
J2: Conn_01x07; PinHeader_1x07_P2.54mm_Vertical
J3: Conn_02x05_Row_Letter_First; TOBYA05
J4: Conn_01x11; PinHeader_1x11_P2.54mm_Vertical
J5: Conn_01x02; PinHeader_1x02_P2.54mm_Vertical
JP1: SolderJumper_3_Open; SolderJumper-3_P2.0mm_Open_TrianglePad1.0x1.5mm_NumberLabels
R1, R2, R7, R41, R42: DNP; R_0805_2012Metric
R3, R8, R10, R11, R12: 10k; R_0805_2012Metric
R4: 360k; R_0805_2012Metric
R5, R6, R19, R20: 22R; R_0805_2012Metric
R9: 180k; R_0805_2012Metric
R16, R17, R18: 100R; R_0805_2012Metric
R43, R44: 120R; R_0805_2012Metric
R45: 480R; R_0805_2012Metric
U1: STM32L021K4Tx; LQFP-32_7x7mm_P0.8mm
U2: LDK130-33_SOT23_SOT353; SOT-23-5_HandSoldering
U3: MAX13432EESD; SOIC-14_3.9x8.7mm_P1.27mm
U4, U5: ADS1118IDGS; VSSOP-10_3x3mm_P0.5mm
U6: BME280; Bosch_LGA-8_2.5x2.5mm_P0.65mm_ClockwisePinNumbering
U7: MIC5205YM5; SOT-23-5

Connections:
+3V3: C2.1, C3.1, C4.1, C8.2, C11.2, C12.1, C13.1, C14.1, C15.1, FB1.1, J1.1, R1.1, R2.1, R45.1, U1.1, U1.17, U2.5, U3.1, U4.8, U5.8, U6.6, U6.8
+5V: C7.2, C10.1, C16.1, C17.1, J3.a5, J4.1, J5.1, U2.1, U2.3, U3.14, U7.1, U7.3
/3.8V: C19.1, J2.1, R4.2, U7.5
/AIN0_0: J3.a1, U4.4
/AIN0_1: J3.a3, U5.4
/AIN1_0: J3.b1, U4.5
/AIN1_1: J3.b3, U5.5
/AIN2_0: J3.a2, U4.6
/AIN2_1: J3.a4, U5.6
/AIN3_0: J3.b2, U4.7
/AIN3_1: J3.b4, U5.7
/Adr0: J4.8, R16.1
/Adr1: J4.7, R17.1
/Adr2: J4.6, R18.1
/CP0: J4.10, R5.2
/CP1: J4.9, R6.2
/LPUART1_TX_STM32L021: JP1.3, U1.10
/Main_Connection/RS485_A: J4.2, R44.1, U3.9
/Main_Connection/RS485_B: J4.3, R44.2, U3.10
/Main_Connection/RS485_Y: J4.5, R43.1, U3.12
/Main_Connection/RS485_Z: J4.4, R43.2, U3.11
/NRST: C1.1, J1.5, R1.2, U1.4
/SPI_MISO: J2.5, U1.27, U4.9, U5.9, U6.5
/SPI_MOSI: J2.6, U1.28, U4.10, U5.10, U6.3
/SPI_NSS_ADC_1: R10.1, U1.14, U4.2
/SPI_NSS_ADC_2: R11.1, U1.15, U5.2
/SPI_NSS_BME280: J2.7, R12.1, U1.25, U6.2
/SPI_SCK: J2.4, U1.26, U4.1, U5.1, U6.4
/SWCLK: J1.2, R20.1
/SWDIO: J1.4, R19.1
/UART_DE: R7.1, R42.1, U1.3, U3.3
/UART_RE: R41.1, U1.2
/UART_RX: U1.9, U3.2
/UART_TX: JP1.2, U3.5
/USART2_TX_STM32L051: JP1.1, U1.8
GND: C1.2, C2.2, C3.2, C4.2, C5.2, C6.2, C7.1, C8.1, C9.1, C10.2, C11.1, C12.2, C13.2, C14.2, C15.2, C16.2, C17.2, C18.2, C19.2, J1.3, J2.3, J3.b5, J4.11, J5.2, R3.2, R7.2, R8.2, R9.2, R10.2, R11.2, R12.2, U1.16, U1.32, U2.2, U3.6, U3.8, U4.3, U5.3, U6.1, U6.7, U7.2
unnamed: C5.1, C6.1, FB1.2, U1.5
unnamed: C9.2, U2.4
unnamed: C18.1, R4.1, R9.1, U7.4
unnamed: D1.1, U1.7
unnamed: D1.2, R45.2
unnamed: R2.2, R3.1, U1.31
unnamed: R5.1, U1.21
unnamed: R6.1, U1.22
unnamed: R16.2, U1.18
unnamed: R17.2, U1.19
unnamed: R18.2, U1.20
unnamed: R19.2, U1.23
unnamed: R20.2, U1.24
unnamed: R8.1, R41.2, R42.2, U3.4
