wuzipu123/software/Electronic/Mutterplatine/Mutterplatine.kicad_pcb

## KiCad design Electronic/Mutterplatine/Mutterplatine.kicad_pcb (2024-06-28)

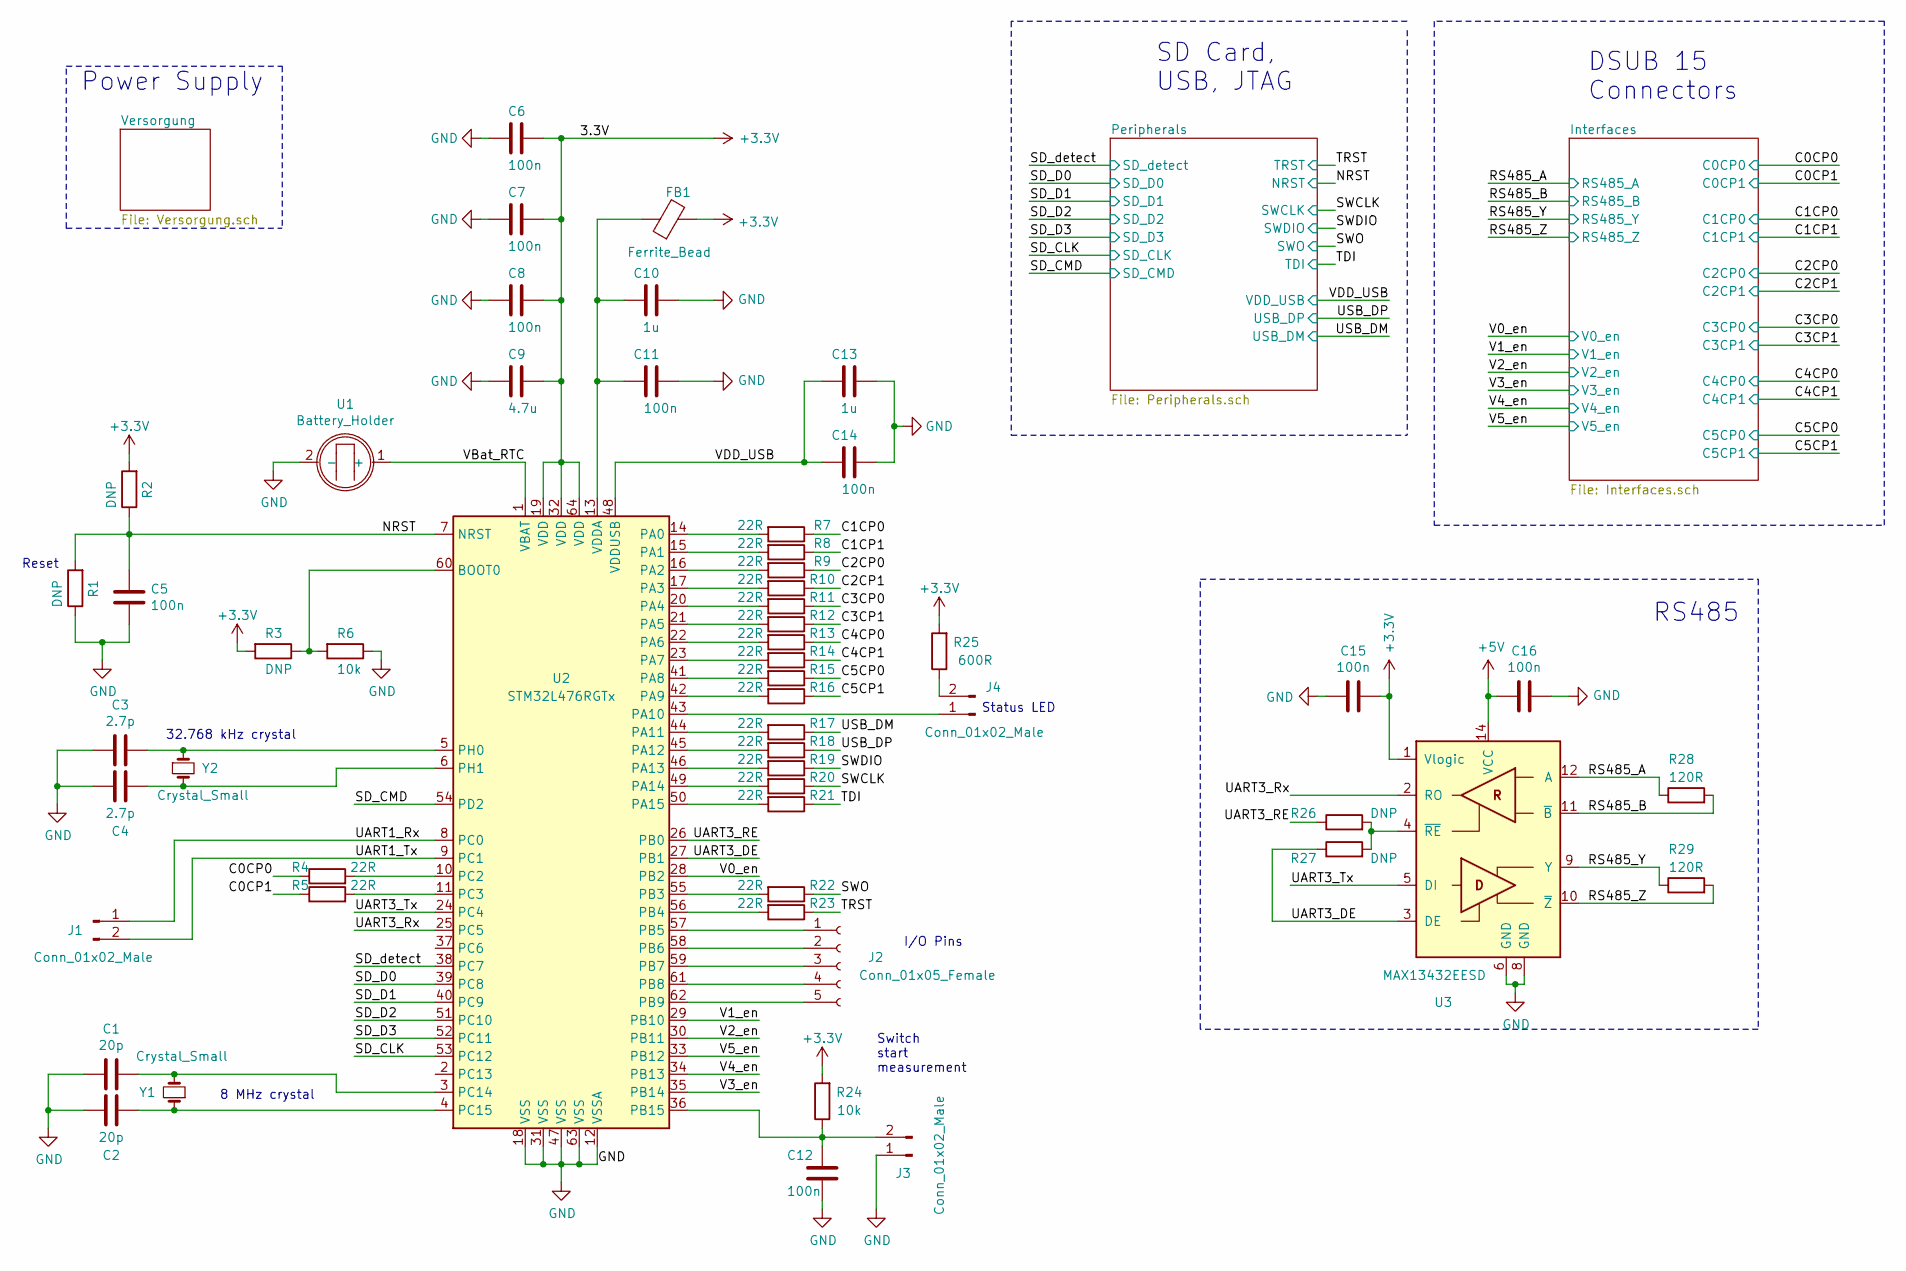
[picture p233: schematic Mutterplatine.sch]

Parts:
C1, C2: 20p; C_0805_2012Metric_Pad1.15x1.40mm_HandSolder
C3, C4: 2.7p; C_0805_2012Metric_Pad1.15x1.40mm_HandSolder
C5, C6, C7, C8, C11, C12, C14, C15, C16: 100n; C_0805_2012Metric_Pad1.15x1.40mm_HandSolder
C9: 4.7u; C_0805_2012Metric_Pad1.15x1.40mm_HandSolder
C10, C13: 1u; C_0805_2012Metric_Pad1.15x1.40mm_HandSolder
FB1: Ferrite_Bead; L_0805_2012Metric_Pad1.15x1.40mm_HandSolder
J1, J3, J4: Conn_01x02_Male; PinHeader_1x02_P2.54mm_Vertical
J2: Conn_01x05_Female; PinSocket_1x05_P2.54mm_Vertical
R1, R2, R3, R26, R27: DNP; R_0805_2012Metric_Pad1.15x1.40mm_HandSolder
R4, R5, R7, R8, R9, R10, R11, R12, R13, R14, R15, R16, R17, R18, R19, R20, R21, R22, R23: 22R; R_0805_2012Metric_Pad1.15x1.40mm_HandSolder
R6, R24: 10k; R_0805_2012Metric_Pad1.15x1.40mm_HandSolder
R25: 600R; R_0805_2012Metric_Pad1.15x1.40mm_HandSolder
R28, R29: 120R; R_0805_2012Metric_Pad1.15x1.40mm_HandSolder
U1: Battery_Holder; BatteryHolder_Keystone_1060_1x2032
U2: STM32L476RGTx; LQFP-64_10x10mm_P0.5mm
U3: MAX13432EESD; SOIC-14_3.9x8.7mm_P1.27mm
Y1: Crystal_Small; Crystal_SMD_3225-4Pin_3.2x2.5mm_HandSoldering
Y2: Crystal_Small; Crystal_SMD_2012-2Pin_2.0x1.2mm_HandSoldering

Connections:
+3V3: C6.2, C7.2, C8.2, C9.2, C15.2, FB1.2, R2.2, R3.2, R24.2, R25.2, U2.19 (VDD), U2.32 (VDD), U2.64 (VDD), U3.1 (Vlogic); also elsewhere on the board
+5V: C16.1, U3.14 (VCC); also elsewhere on the board
/C0CP0: R4.1; also elsewhere on the board
/C0CP1: R5.1; also elsewhere on the board
/C1CP1: R8.1; also elsewhere on the board
/C2CP1: R10.1; also elsewhere on the board
/C3CP0: R11.1; also elsewhere on the board
/C3CP1: R12.1; also elsewhere on the board
/C4CP0: R13.1; also elsewhere on the board
/C4CP1: R14.1; also elsewhere on the board
/C5CP0: R15.1; also elsewhere on the board
/C5CP1: R16.1; also elsewhere on the board
/NRST: C5.1, R1.2, R2.1, U2.7 (NRST); also elsewhere on the board
/RS485_A: R28.1, U3.12 (A); also elsewhere on the board
/RS485_B: R28.2, U3.11 (~B); also elsewhere on the board
/RS485_Y: R29.1, U3.9 (Y); also elsewhere on the board
/RS485_Z: R29.2, U3.10 (~Z~); also elsewhere on the board
/SD_CLK: U2.53 (PC12); also elsewhere on the board
/SD_CMD: U2.54 (PD2); also elsewhere on the board
/SD_D0: U2.39 (PC8); also elsewhere on the board
/SD_D1: U2.40 (PC9); also elsewhere on the board
/SD_D2: U2.51 (PC10); also elsewhere on the board
/SD_D3: U2.52 (PC11); also elsewhere on the board
/SD_detect: U2.38 (PC7); also elsewhere on the board
/SWCLK: R20.1; also elsewhere on the board
/SWDIO: R19.1; also elsewhere on the board
/SWO: R22.1; also elsewhere on the board
/TDI: R21.1; also elsewhere on the board
/TRST: R23.1; also elsewhere on the board
/UART1_Rx: J1.1, U2.8 (PC0)
/UART1_Tx: J1.2, U2.9 (PC1)
/UART3_DE: R27.1, U2.27 (PB1), U3.3 (DE)
/UART3_RE: R26.1, U2.26 (PB0)
/UART3_Rx: U2.25 (PC5), U3.2 (RO)
/UART3_Tx: U2.24 (PC4), U3.5 (DI)
/USB_DM: R17.1; also elsewhere on the board
/USB_DP: R18.1; also elsewhere on the board
/V0_en: U2.28 (PB2); also elsewhere on the board
/V1_en: U2.29 (PB10); also elsewhere on the board
/V2_en: U2.30 (PB11); also elsewhere on the board
/V3_en: U2.35 (PB14); also elsewhere on the board
/V4_en: U2.34 (PB13); also elsewhere on the board
/V5_en: U2.33 (PB12); also elsewhere on the board
/VBat_RTC: U1.1 (+), U2.1 (VBAT)
/VDD_USB: C13.2, C14.2, U2.48 (VDDUSB); also elsewhere on the board
unnamed: C1.2, U2.3 (PC14), Y1.2
unnamed: C2.2, U2.4 (PC15), Y1.1
unnamed: C3.2, U2.5 (PH0), Y2.1
unnamed: C10.2, C11.2, FB1.1, U2.13 (VDDA)
unnamed: C12.1, J3.2, R24.1, U2.36 (PB15)
unnamed: J2.1, U2.57 (PB5)
unnamed: J2.2, U2.58 (PB6)
unnamed: J2.3, U2.59 (PB7)
unnamed: J2.4, U2.61 (PB8)
unnamed: J2.5, U2.62 (PB9)
unnamed: J4.1, U2.43 (PA10)
unnamed: J4.2, R25.1
unnamed: R3.1, R6.2, U2.60 (BOOT0)
unnamed: R4.2, U2.10 (PC2)
unnamed: R5.2, U2.11 (PC3)
unnamed: R8.2, U2.15 (PA1)
unnamed: R10.2, U2.17 (PA3)
unnamed: R11.2, U2.20 (PA4)
unnamed: R12.2, U2.21 (PA5)
unnamed: R13.2, U2.22 (PA6)
unnamed: R14.2, U2.23 (PA7)
unnamed: R15.2, U2.41 (PA8)
unnamed: R16.2, U2.42 (PA9)
unnamed: R17.2, U2.44 (PA11)
unnamed: R18.2, U2.45 (PA12)
unnamed: R19.2, U2.46 (PA13)
unnamed: R20.2, U2.49 (PA14)
unnamed: R21.2, U2.50 (PA15)
unnamed: R22.2, U2.55 (PB3)
unnamed: R23.2, U2.56 (PB4)
unnamed: R26.2, R27.2, U3.4 (~RE)

Notes on the sheet:
32.768 kHz crystal
8 MHz crystal
Reset
RS485
DSUB 15 Connectors
SD Card, USB, JTAG
Power Supply
Status LED
Switch start measurement
I/O Pins

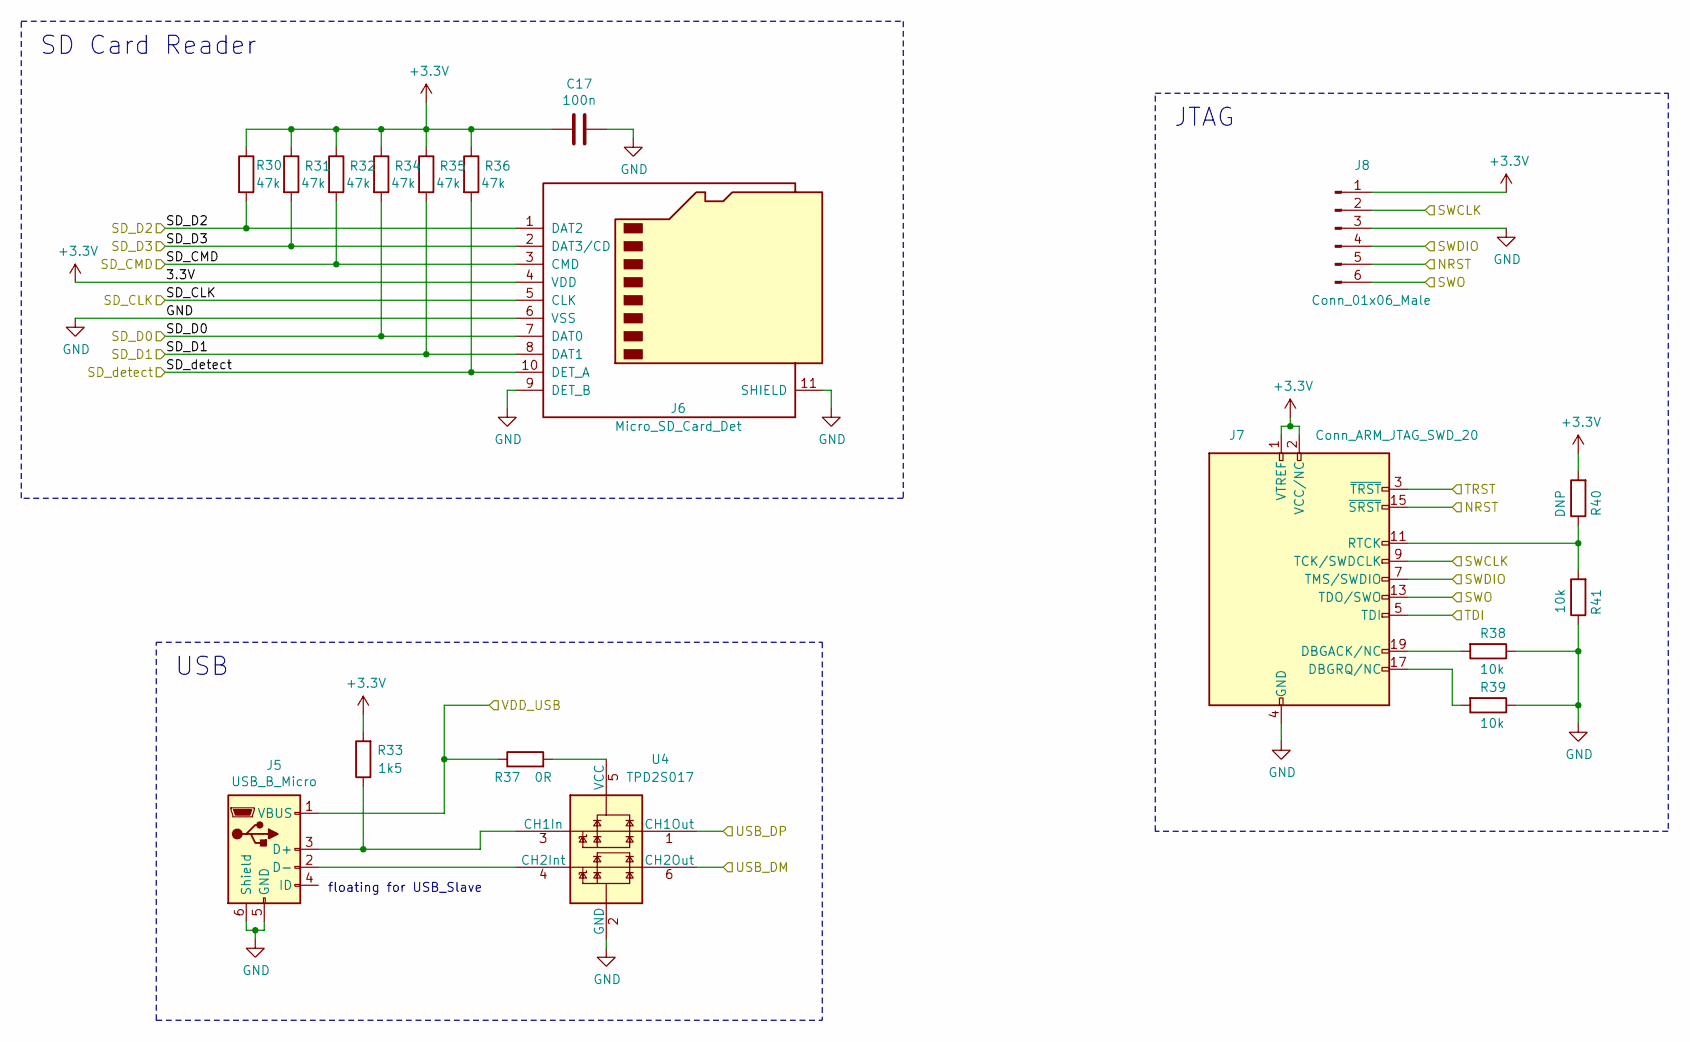
[picture p234: schematic Peripherals.sch]

Parts:
C17: 100n; C_0805_2012Metric_Pad1.15x1.40mm_HandSolder
J5: USB_B_Micro; USB_Micro-B_GCT_USB3076-30-A
J6: Micro_SD_Card_Det; microSD_HC_Hirose_DM3D-SF
J7: Conn_ARM_JTAG_SWD_20; PinHeader_2x10_P2.54mm_Vertical
J8: Conn_01x06_Male; PinHeader_1x06_P2.54mm_Vertical
R30, R31, R32, R34, R35, R36: 47k; R_0805_2012Metric_Pad1.15x1.40mm_HandSolder
R33: 1k5; R_0805_2012Metric_Pad1.15x1.40mm_HandSolder
R37: 0R; R_0805_2012Metric_Pad1.15x1.40mm_HandSolder
R38, R39, R41: 10k; R_0805_2012Metric_Pad1.15x1.40mm_HandSolder
R40: DNP; R_0805_2012Metric_Pad1.15x1.40mm_HandSolder
U4: TPD2S017; SOT-23-6

Connections:
+3V3: C17.2, J6.4 (VDD), J7.1 (VTREF), J7.2 (VCC/NC), J8.1, R30.1, R31.1, R32.1, R33.2, R34.1, R35.1, R36.1, R40.2; also elsewhere on the board
/NRST: J7.15 (~SRST~), J8.5; also elsewhere on the board
/SD_CLK: J6.5 (CLK); also elsewhere on the board
/SD_CMD: J6.3 (CMD), R32.2; also elsewhere on the board
/SD_D0: J6.7 (DAT0), R34.2; also elsewhere on the board
/SD_D1: J6.8 (DAT1), R35.2; also elsewhere on the board
/SD_D2: J6.1 (DAT2), R30.2; also elsewhere on the board
/SD_D3: J6.2 (DAT3/CD), R31.2; also elsewhere on the board
/SD_detect: J6.10 (DET_A), R36.2; also elsewhere on the board
/SWCLK: J7.9 (TCK/SWDCLK), J8.2; also elsewhere on the board
/SWDIO: J7.7 (TMS/SWDIO), J8.4; also elsewhere on the board
/SWO: J7.13 (TDO/SWO), J8.6; also elsewhere on the board
/TDI: J7.5 (TDI); also elsewhere on the board
/TRST: J7.3 (~TRST~); also elsewhere on the board
/USB_DM: U4.6 (CH2Out); also elsewhere on the board
/USB_DP: U4.1 (CH1Out); also elsewhere on the board
/VDD_USB: J5.1 (VBUS), R37.1; also elsewhere on the board
unnamed: J5.2 (D-), U4.4 (CH2Int)
unnamed: J5.3 (D+), R33.1, U4.3 (CH1In)
unnamed: J7.11 (RTCK), R40.1, R41.2
unnamed: J7.17 (DBGRQ/NC), R39.2
unnamed: J7.19 (DBGACK/NC), R38.2
unnamed: R37.2, U4.5 (VCC)

Notes on the sheet:
floating for USB_Slave
SD Card Reader
JTAG
USB
