wuzipu123/software/Electronic/Mutterplatine/Mutterplatine.kicad_pcb

## KiCad design Electronic/Mutterplatine/Mutterplatine.kicad_pcb (continued)

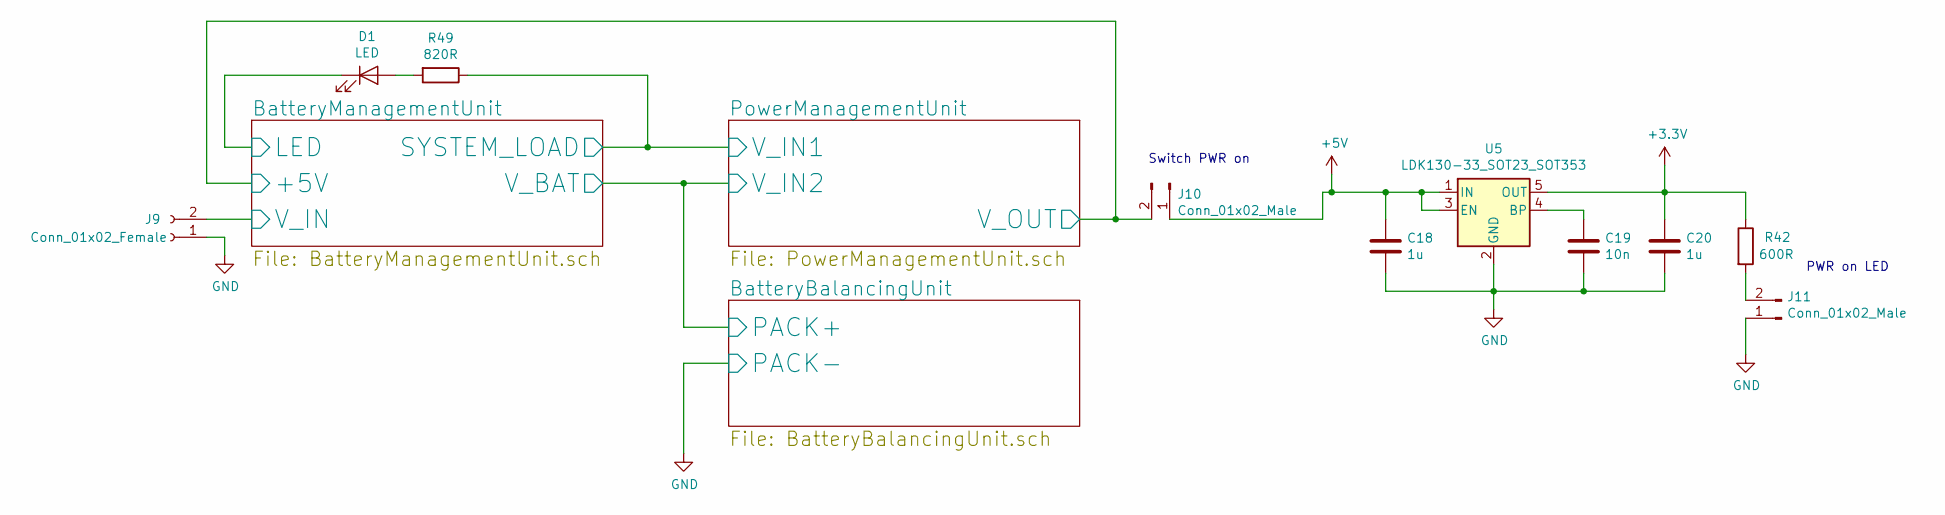
[picture p235: schematic Versorgung.sch]

Parts:
C18, C20: 1u; C_0805_2012Metric_Pad1.15x1.40mm_HandSolder
C19: 10n; C_0805_2012Metric_Pad1.15x1.40mm_HandSolder
D1: LED; Pin_Header_Straight_1x02_Pitch2.54mm
J9: Conn_01x02_Female; PhoenixContact_MCV-G_02x5.08mm_Vertical
J10, J11: Conn_01x02_Male; PinHeader_1x02_P2.54mm_Vertical
R42: 600R; R_0805_2012Metric_Pad1.15x1.40mm_HandSolder
R49: 820R; R_0805
U5: LDK130-33_SOT23_SOT353; SOT-23-5_HandSoldering

Connections:
+3V3: C20.2, R42.1, U5.5 (OUT); also elsewhere on the board
+5V: C18.2, J10.1, U5.1 (IN), U5.3 (EN); also elsewhere on the board
/Versorgung/BatteryManagementUnit/+5V: J10.2; also elsewhere on the board
/Versorgung/BatteryManagementUnit/LED: D1.1 (K); also elsewhere on the board
/Versorgung/BatteryManagementUnit/V_IN: J9.2; also elsewhere on the board
unnamed: C19.2, U5.4 (BP)
unnamed: D1.2 (A), R49.2
unnamed: J11.2, R42.2

Notes on the sheet:
PWR on LED
Switch PWR on

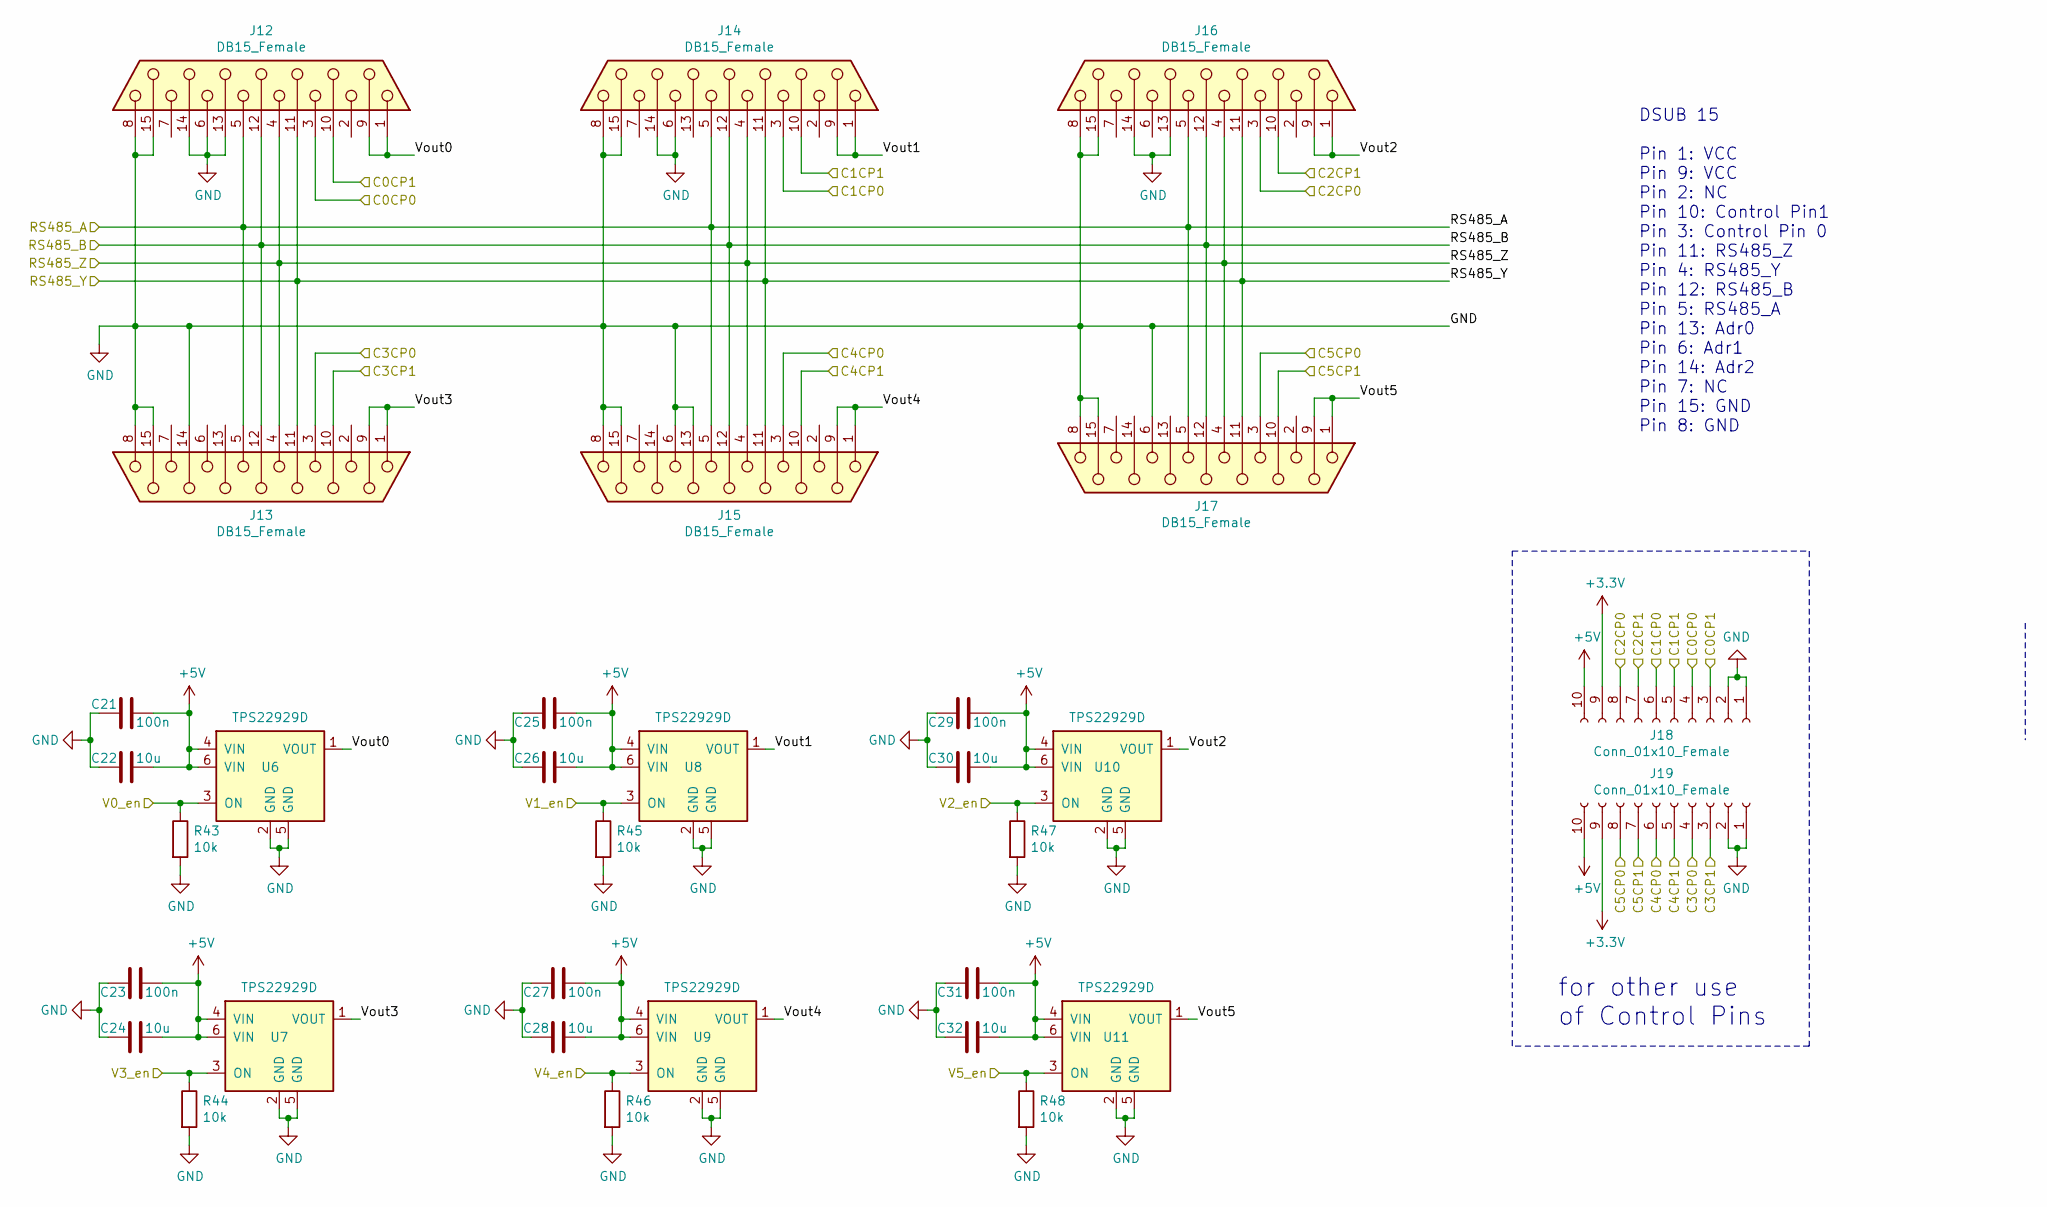
[picture p236: schematic Interfaces.sch]

Parts:
C21, C23, C25, C27, C29, C31: 100n; C_0805_2012Metric_Pad1.15x1.40mm_HandSolder
C22, C24, C26, C28, C30, C32: 10u; C_0805_2012Metric_Pad1.15x1.40mm_HandSolder
J12, J13, J14, J15, J16, J17: DB15_Female; DSUB-15_Female_Vertical_P2.77x2.84mm_MountingHoles
J18, J19: Conn_01x10_Female; PinSocket_1x10_P2.54mm_Vertical
R43, R44, R45, R46, R47, R48: 10k; R_0805_2012Metric_Pad1.15x1.40mm_HandSolder
U6, U7, U8, U9, U10, U11: TPS22929D; SOT-23-6

Connections:
+3V3: J18.9, J19.9; also elsewhere on the board
+5V: C21.2, C22.2, C23.2, C24.2, C25.2, C26.2, C27.2, C28.2, C29.2, C30.2, C31.2, C32.2, J18.10, J19.10, U6.4 (VIN), U6.6 (VIN), U7.4 (VIN), U7.6 (VIN), U8.4 (VIN), U8.6 (VIN), U9.4 (VIN), U9.6 (VIN), U10.4 (VIN), U10.6 (VIN), U11.4 (VIN), U11.6 (VIN); also elsewhere on the board
/C0CP0: J12.3, J18.4; also elsewhere on the board
/C0CP1: J12.10, J18.3; also elsewhere on the board
/C1CP1: J14.10, J18.5; also elsewhere on the board
/C2CP1: J16.10, J18.7; also elsewhere on the board
/C3CP0: J13.3, J19.4; also elsewhere on the board
/C3CP1: J13.10, J19.3; also elsewhere on the board
/C4CP0: J15.3, J19.6; also elsewhere on the board
/C4CP1: J15.10, J19.5; also elsewhere on the board
/C5CP0: J17.3, J19.8; also elsewhere on the board
/C5CP1: J17.10, J19.7; also elsewhere on the board
/Interfaces/Vout0: J12.1, J12.9, U6.1 (VOUT)
/Interfaces/Vout1: J14.1, J14.9, U8.1 (VOUT)
/Interfaces/Vout2: J16.1, J16.9, U10.1 (VOUT)
/Interfaces/Vout3: J13.1, J13.9, U7.1 (VOUT)
/Interfaces/Vout4: J15.1, J15.9, U9.1 (VOUT)
/Interfaces/Vout5: J17.1, J17.9, U11.1 (VOUT)
/RS485_A: J12.5, J13.5, J14.5, J15.5, J16.5, J17.5; also elsewhere on the board
/RS485_B: J12.12, J13.12, J14.12, J15.12, J16.12, J17.12; also elsewhere on the board
/RS485_Y: J12.11 (P111), J13.11 (P111), J14.11 (P111), J15.11 (P111), J16.11 (P111), J17.11 (P111); also elsewhere on the board
/RS485_Z: J12.4, J13.4, J14.4, J15.4, J16.4, J17.4; also elsewhere on the board
/V0_en: R43.1, U6.3 (ON); also elsewhere on the board
/V1_en: R45.1, U8.3 (ON); also elsewhere on the board
/V2_en: R47.1, U10.3 (ON); also elsewhere on the board
/V3_en: R44.1, U7.3 (ON); also elsewhere on the board
/V4_en: R46.1, U9.3 (ON); also elsewhere on the board
/V5_en: R48.1, U11.3 (ON); also elsewhere on the board

Notes on the sheet:
DSUB 15 Pin 1: VCC Pin 9: VCC Pin 2: NC Pin 10: Control Pin1 Pin 3: Control Pin 0 Pin 11: RS485_Z Pin 4: RS485_Y Pin 12: RS485_B Pin 5: RS485_A Pin 13: Adr0 Pin 6: Adr1 Pin 14: Adr2 Pin 7: NC Pin 15: GND Pin 8: GND
for other use of Control Pins

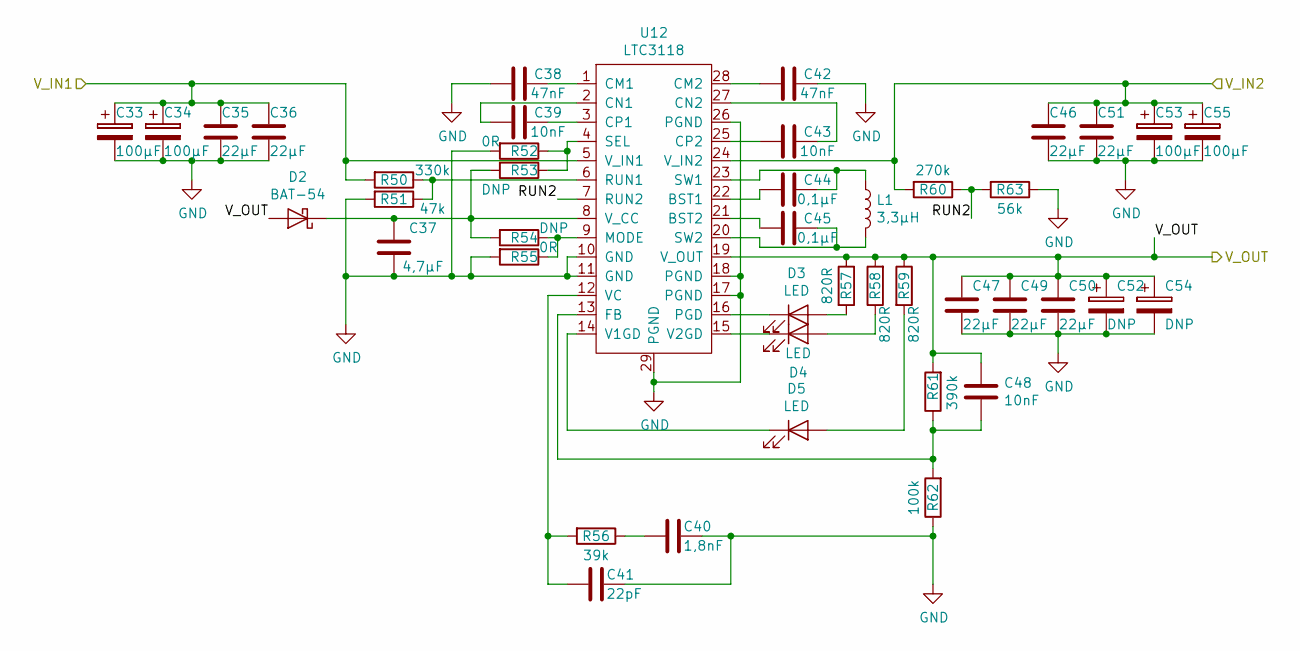
[picture p237: schematic PowerManagementUnit.sch]

Parts:
C33, C34, C53, C55: 100µF; CP_Tantalum_Case-X_EIA-7343-43_Wave
C35, C36, C46, C47, C49, C50, C51: 22µF; C_0805
C37: 4,7µF; C_0805
C38, C42: 47nF; C_0805
C39, C43, C48: 10nF; C_0805
C40: 1,8nF; C_0805
C41: 22pF; C_0805
C44, C45: 0,1µF; C_0805
C52, C54: DNP; CP_Tantalum_Case-D_EIA-7343-31_Wave
D2: BAT-54; D_SOT-23_ANK
D3, D4, D5: LED; LED_0603
L1: 3,3µH; L_Wuerth_WE-PD-6033_Handsoldering
R50: 330k; R_0805
R51: 47k; R_0805
R52, R55: 0R; R_0805
R53, R54: DNP; R_0805
R56: 39k; R_0805
R57, R58, R59: 820R; R_0805
R60: 270k; R_0805
R61: 390k; R_0805
R62: 100k; R_0805
R63: 56k; R_0805
U12: LTC3118; TSSOP-28-1EP_4.4x9.7mm_Pitch0.65mm

Connections:
/Versorgung/BatteryManagementUnit/+5V: C47.1, C48.1, C49.1, C50.1, C52.1, C54.1, D2.2 (A), R57.1, R58.2, R59.1, R61.2, U12.19 (V_OUT); also elsewhere on the board
/Versorgung/PowerManagementUnit/RUN2: R60.1, R63.2, U12.7 (RUN2)
unnamed: C37.2, D2.1 (K), R53.2, R54.2, U12.8 (V_CC)
unnamed: C38.1, U12.1 (CM1)
unnamed: C39.1, U12.3 (CP1)
unnamed: C39.2, U12.2 (CN1)
unnamed: C40.2, R56.1
unnamed: C41.2, R56.2, U12.12 (VC)
unnamed: C42.2, U12.28 (CM2)
unnamed: C43.1, U12.27 (CN2)
unnamed: C43.2, U12.25 (CP2)
unnamed: C44.1, U12.22 (BST1)
unnamed: C44.2, L1.1, U12.23 (SW1)
unnamed: C45.1, L1.2, U12.20 (SW2)
unnamed: C45.2, U12.21 (BST2)
unnamed: C48.2, R61.1, R62.2, U12.13 (FB)
unnamed 94: D3.1 (K), U12.16 (PGD); also elsewhere on the board
unnamed 95: D3.2 (A), R57.2; also elsewhere on the board
unnamed 96: D4.1 (K), U12.15 (V2GD); also elsewhere on the board
unnamed 97: D4.2 (A), R58.1; also elsewhere on the board
unnamed 98: D5.1 (K), U12.14 (V1GD); also elsewhere on the board
unnamed 99: D5.2 (A), R59.2; also elsewhere on the board
unnamed: R50.1, R51.1, U12.6 (RUN1)
unnamed: R52.1, R53.1, U12.4 (SEL)
unnamed: R54.1, R55.1, U12.9 (MODE)

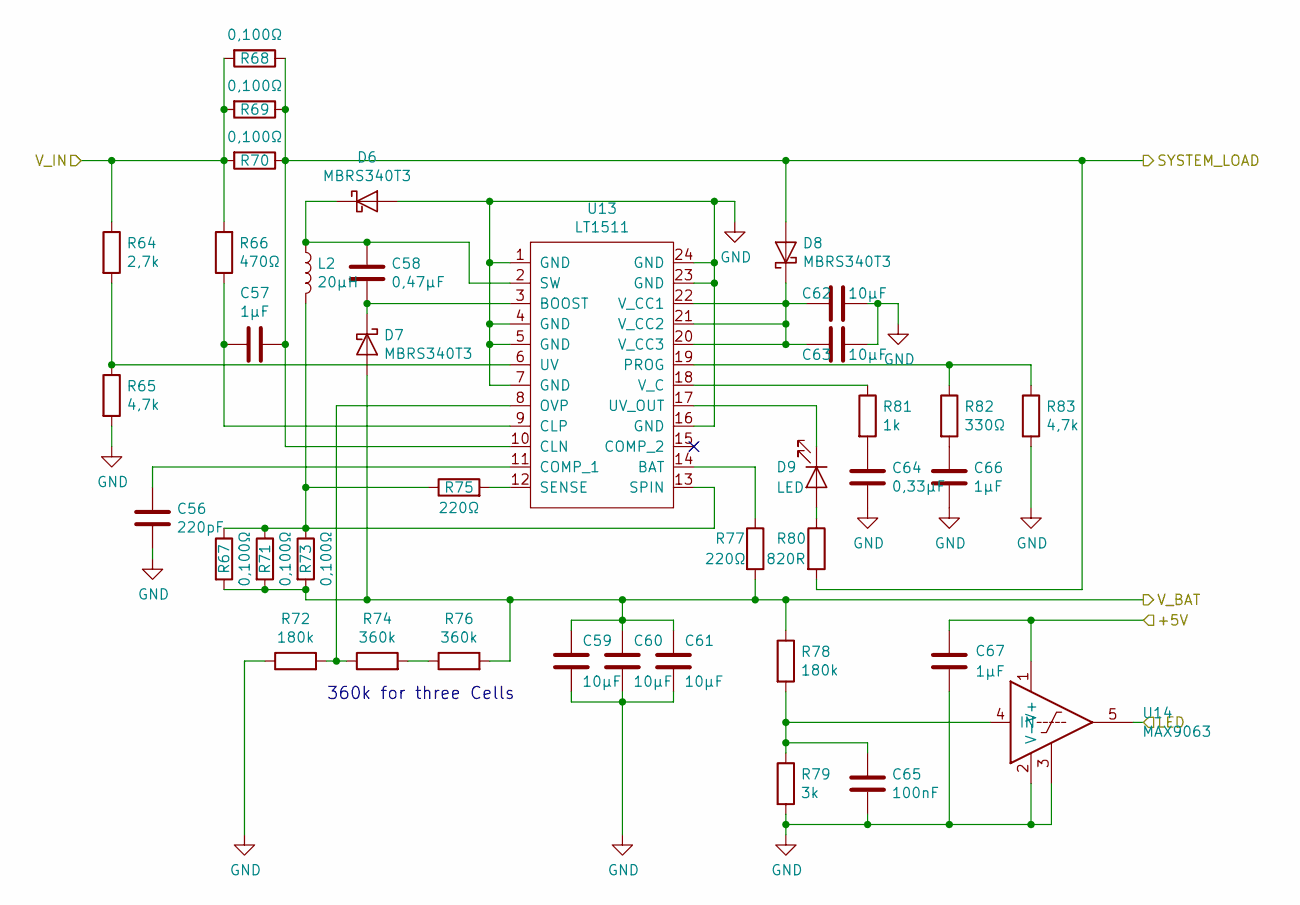
[picture p238: schematic BatteryManagementUnit.sch]

Parts:
C56: 220pF; C_0805
C57, C66: 1μF; C_0805
C58: 0,47μF; C_0805
C59, C60, C61: 10µF; C_0805
C62, C63: 10μF; C_0805
C64: 0,33μF; C_0805
C65: 100nF; C_0805
C67: 1µF; C_0805
D6, D7, D8: MBRS340T3; D_SMC
D9: LED; LED_0603
L2: 20μH; L_Wuerth_WE-PDF_Handsoldering
R7, R9: 360k; R_0805
R64: 2,7k; R_0805
R65, R83: 4,7k; R_0805
R66: 470Ω; R_0805
R67, R68, R69, R70, R71, R73: 0,100Ω; R_1206
R72, R78: 180k; R_0805
R75, R77: 220Ω; R_0805
R79: 3k; R_0805
R80: 820R; R_0805
R81: 1k; R_0805
R82: 330Ω; R_0805
U13: LT1511; TSOP-II-32_21.0x10.2mm_Pitch1.27mm
U14: MAX9063; SOT-23-5

Connections:
/Versorgung/BatteryManagementUnit/+5V: C67.2, U14.1 (V+); also elsewhere on the board
/Versorgung/BatteryManagementUnit/LED: U14.5; also elsewhere on the board
/Versorgung/BatteryManagementUnit/V_IN: R64.1, R66.2, R68.2, R69.2, R70.2; also elsewhere on the board
unnamed: C56.2, U13.11 (COMP_1)
unnamed: C57.1, R66.1, U13.9 (CLP)
unnamed: C58.1, D7.1 (K), U13.3 (BOOST)
unnamed: C58.2, D6.1 (K), L2.1, U13.2 (SW)
unnamed: C62.2, C63.2, D8.1 (K), U13.20 (V_CC3), U13.21 (V_CC2), U13.22 (V_CC1)
unnamed: C64.2, R81.2
unnamed: C65.1, R78.2, R79.1, U14.4 (IN)
unnamed: C66.2, R82.2
unnamed 100: D9.1 (K), U13.17 (UV_OUT); also elsewhere on the board
unnamed 101: D9.2 (A), R80.1; also elsewhere on the board
unnamed: L2.2, R67.1, R71.1, R73.1, R75.1, U13.13 (SPIN)
unnamed: R64.2, R65.1, U13.6 (UV)
unnamed: R75.2, U13.12 (SENSE)
unnamed: R77.1, U13.14 (BAT)
unnamed: R81.1, U13.18 (V_C)
unnamed: R82.1, R83.1, U13.19 (PROG)

Notes on the sheet:
360k for three Cells

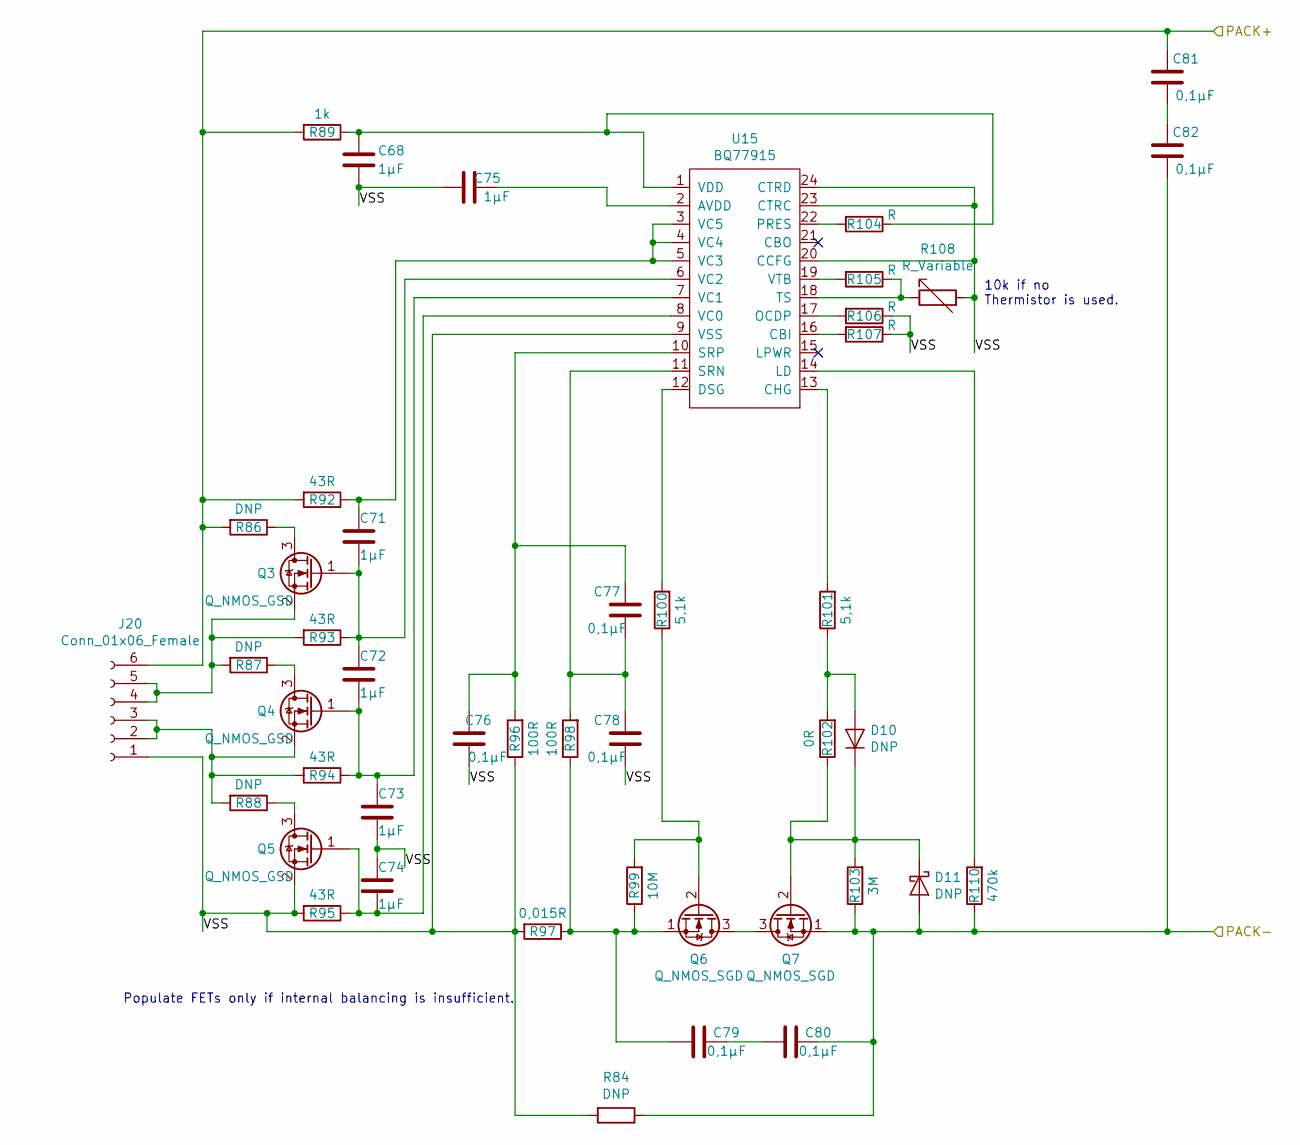
[picture p239: schematic BatteryBalancingUnit.sch]

Parts:
C4, C68, C72, C73, C74, C75: 1µF; C_0805
C76, C77, C78, C79, C80, C81, C82: 0,1µF; C_0805
D10, D11: DNP; D_0805
J20: Conn_01x06_Female; PhoenixContact_MCV-G_06x5.08mm_Vertical
Q3, Q4, Q5: Q_NMOS_GSD; TSOT-23
Q6, Q7: Q_NMOS_SGD; VSONP-8-1EP_5x6_Pitch1.27mm
R84: DNP; R_1206
R86, R87, R88: DNP; R_0805
R89: 1k; R_0805
R92, R93, R94, R95: 43R; R_0805
R96, R98: 100R; R_0805
R97: 0,015R; R_1206
R99: 10M; R_0805
R100, R101: 5,1k; R_0805
R102: 0R; R_0805
R103: 3M; R_0805
R104, R105, R106, R107: R; R_0805
R108: R_Variable; R_0805
R110: 470k; R_0805
U15: BQ77915; TSSOP-24_4.4x7.8mm_Pitch0.65mm

Connections:
/Versorgung/BatteryBalancingUnit/VSS: C68.1, C73.1, C74.2, C75.2, C76.1, C78.1, J20.1, Q5.2 (S), R84.2, R95.2, R96.1, R97.2, R106.1, R107.1, R108.2, U15.9 (VSS), U15.20 (CCFG), U15.23 (CTRC), U15.24 (CTRD)
unnamed: C68.2, R89.1, R104.1, U15.1 (VDD)
unnamed: C72.1, C73.2, Q4.1 (G), R94.1, U15.7 (VC1)
unnamed: C74.1, Q5.1 (G), R95.1, U15.8 (VC0)
unnamed: C75.1, U15.2 (AVDD)
unnamed: C76.2, C77.2, R96.2, U15.10 (SRP)
unnamed: C77.1, C78.2, R98.2, U15.11 (SRN)
unnamed: C79.1, C80.2
unnamed: C79.2, Q6.1 (S), R97.1, R98.1, R99.1
unnamed: C81.1, C82.2
unnamed: D10.1 (K), D11.1 (K), Q7.2 (G), R102.1, R103.2
unnamed: D10.2 (A), R101.1, R102.2
unnamed: J20.2, J20.3, Q4.2 (S), R88.2, R94.2
unnamed: J20.4, J20.5, Q3.2 (S), R87.2, R93.2
unnamed: Q3.3 (D), R86.1
unnamed: Q4.3 (D), R87.1
unnamed: Q5.3 (D), R88.1
unnamed: Q6.2 (G), R99.2, R100.1
unnamed: Q6.3 (D), Q7.3 (D)
unnamed: R100.2, U15.12 (DSG)
unnamed: R101.2, U15.13 (CHG)
unnamed: R104.2, U15.22 (PRES)
unnamed: R105.1, R108.1, U15.18 (TS)
unnamed: R105.2, U15.19 (VTB)
unnamed: R106.2, U15.17 (OCDP)
unnamed: R107.2, U15.16 (CBI)
unnamed: R110.2, U15.14 (LD)

Notes on the sheet:
Populate FETs only if internal balancing is insufficient.
10k if no Thermistor is used.

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
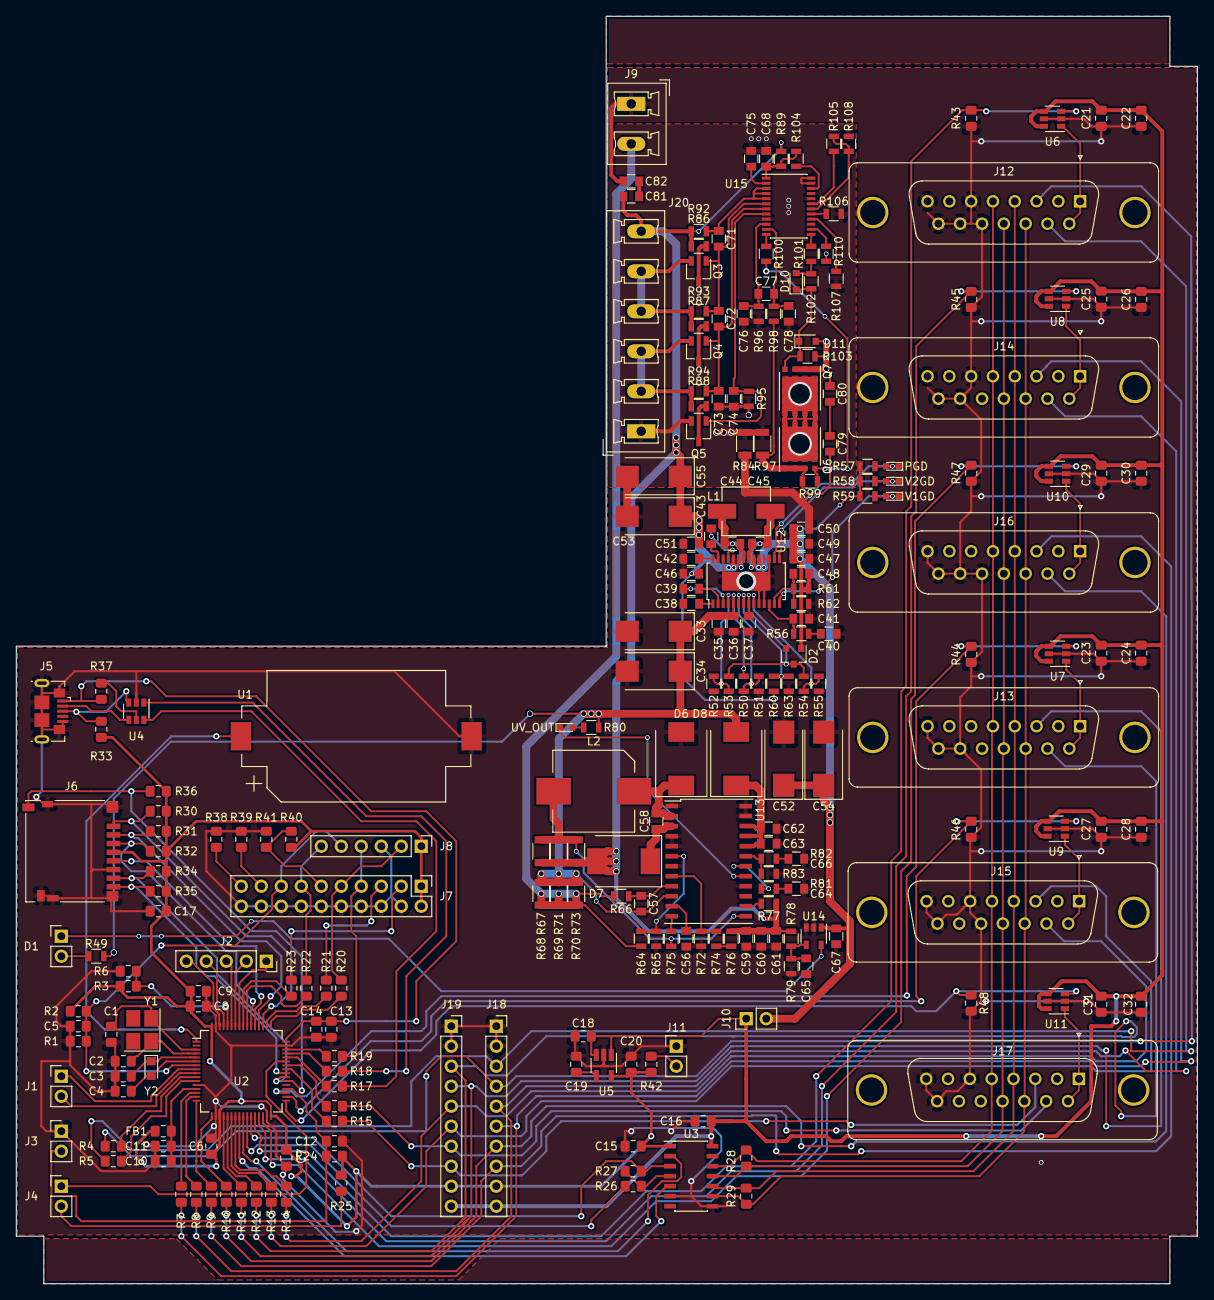
[picture p240: board Mutterplatine.kicad_pcb from above]

Board: 2 copper layers, 150.0 x 161.0 mm, 242 parts (0 on the bottom side), 173 nets.

Other parts of the board:
C71: 1µF; C_0805
PGD: LED; LED_0603
R74, R76: 360k; R_0805
UV_OUT: LED; LED_0603
V1GD, V2GD: LED; LED_0603

Their connections:
unnamed 94: PGD.1; also elsewhere on the board
unnamed 95: PGD.2; also elsewhere on the board
unnamed 96: V2GD.1; also elsewhere on the board
unnamed 97: V2GD.2; also elsewhere on the board
unnamed 98: V1GD.1; also elsewhere on the board
unnamed 99: V1GD.2; also elsewhere on the board
unnamed 100: UV_OUT.1; also elsewhere on the board
unnamed 101: UV_OUT.2; also elsewhere on the board
unnamed: R74.2, R76.1
