wuzipu123/software/Electronic/battery_charger/battery_charger.kicad_pcb

## KiCad design Electronic/battery_charger/battery_charger.kicad_pcb (2024-06-28)

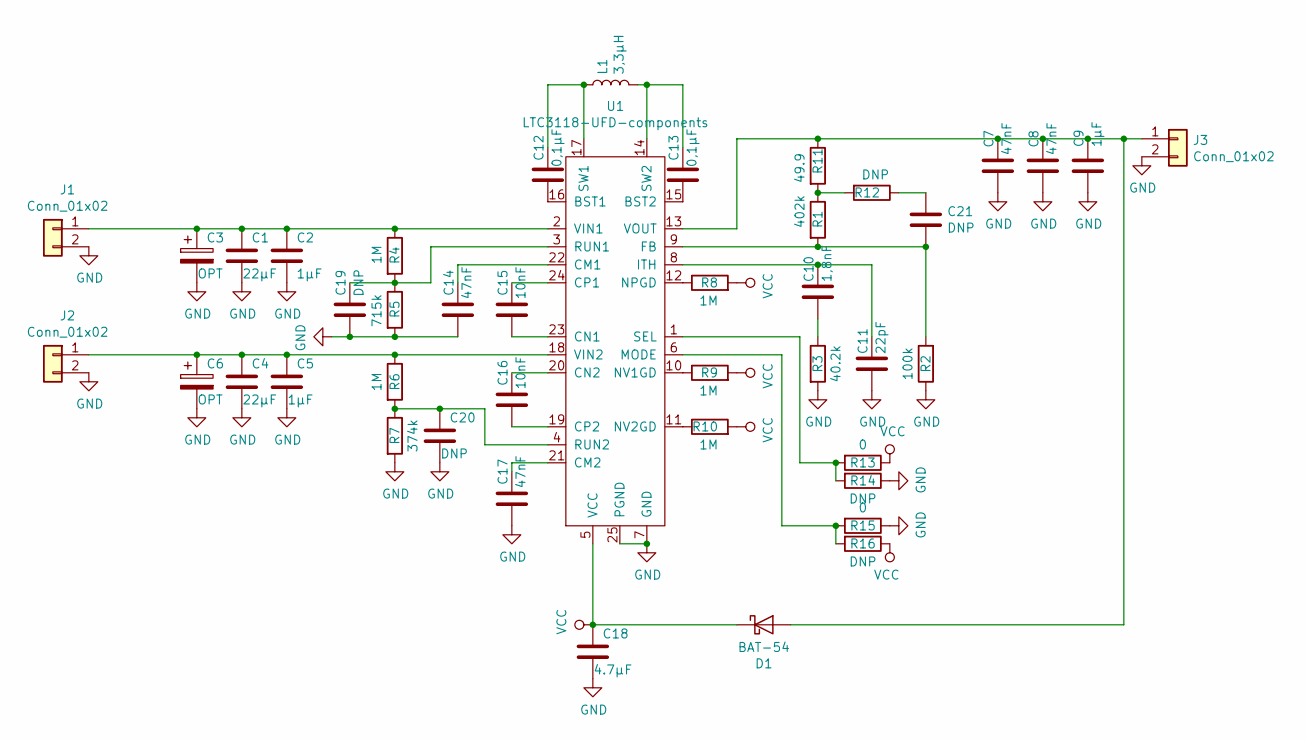
[picture p241: schematic battery_charger.sch]

Parts:
C1, C4: 22µF; C_1812_4532Metric
C2, C5, C9: 1µF; C_0603_1608Metric_Pad1.05x0.95mm_HandSolder
C3, C6: OPT; C_0603_1608Metric_Pad1.05x0.95mm_HandSolder
C7, C8: 47nF; C_1812_4532Metric
C10: 1,8nF; C_0603_1608Metric_Pad1.05x0.95mm_HandSolder
C11: 22pF; C_0603_1608Metric_Pad1.05x0.95mm_HandSolder
C12, C13: 0,1µF; C_0603_1608Metric_Pad1.05x0.95mm_HandSolder
C14, C17: 47nF; C_0603_1608Metric
C15, C16: 10nF; C_0603_1608Metric
C18: 4.7µF; C_0805_2012Metric_Pad1.15x1.40mm_HandSolder
C19, C20, C21: DNP; C_0603_1608Metric_Pad1.05x0.95mm_HandSolder
D1: BAT-54; D_SOD-523
J1, J2, J3: Conn_01x02; PinHeader_1x02_P2.54mm_Vertical
L1: 3,3µH; L_Wuerth_WE-PD-6033_Handsoldering
R1: 402k; R_0603_1608Metric
R2: 100k; R_0603_1608Metric
R3: 40.2k; R_0603_1608Metric
R4, R6, R8, R9, R10: 1M; R_0603_1608Metric
R5: 715k; R_0603_1608Metric
R7: 374k; R_0603_1608Metric
R11: 49.9; R_0603_1608Metric
R12, R14, R16: DNP; R_0603_1608Metric
R13, R15: 0; R_0603_1608Metric
U1: LTC3118-UFD-components; QFN-24-1EP_4x5mm_P0.5mm_EP2.65x3.65mm_ThermalVias

Connections:
GND: C1.2, C2.1, C3.2, C4.2, C5.2, C6.2, C7.2, C8.2, C9.2, C11.2, C14.2, C17.2, C18.2, C19.1, C20.2, J1.2, J2.2, J3.2, R2.1, R3.2, R5.2, R7.2, R14.1, R15.1, U1.7 (GND), U1.25 (PGND)
unnamed: C1.1, C2.2, C3.1, J1.1, R4.1, U1.2 (VIN1)
unnamed: C4.1, C5.1, C6.1, J2.1, R6.1, U1.18 (VIN2)
unnamed: C7.1, C8.1, C9.1, D1.2 (A), J3.1, R11.1, U1.13 (VOUT)
unnamed: C10.1, C11.1, U1.8 (ITH)
unnamed: C10.2, R3.1
unnamed: C12.1, U1.16 (BST1)
unnamed: C12.2, L1.1, U1.17 (SW1)
unnamed: C13.1, L1.2, U1.14 (SW2)
unnamed: C13.2, U1.15 (BST2)
unnamed: C14.1, U1.22 (CM1)
unnamed: C15.1, U1.24 (CP1)
unnamed: C15.2, U1.23 (CN1)
unnamed: C16.1, U1.20 (CN2)
unnamed: C16.2, U1.19 (CP2)
unnamed: C17.1, U1.21 (CM2)
unnamed: C19.2, R4.2, R5.1, U1.3 (RUN1)
unnamed: C20.1, R6.2, R7.1, U1.4 (RUN2)
unnamed: C21.1, R12.1
unnamed: C21.2, R1.2, R2.2, U1.9 (FB)
unnamed: R1.1, R11.2, R12.2
unnamed: R8.1, U1.12 (NPGD)
unnamed: R9.1, U1.10 (NV1GD)
unnamed: R10.1, U1.11 (NV2GD)
unnamed: R13.2, R14.2, U1.1 (SEL)
unnamed: R15.2, R16.2, U1.6 (MODE)
VCC: C18.1, D1.1 (K), R8.2, R9.2, R10.2, R13.1, R16.1, U1.5 (VCC)

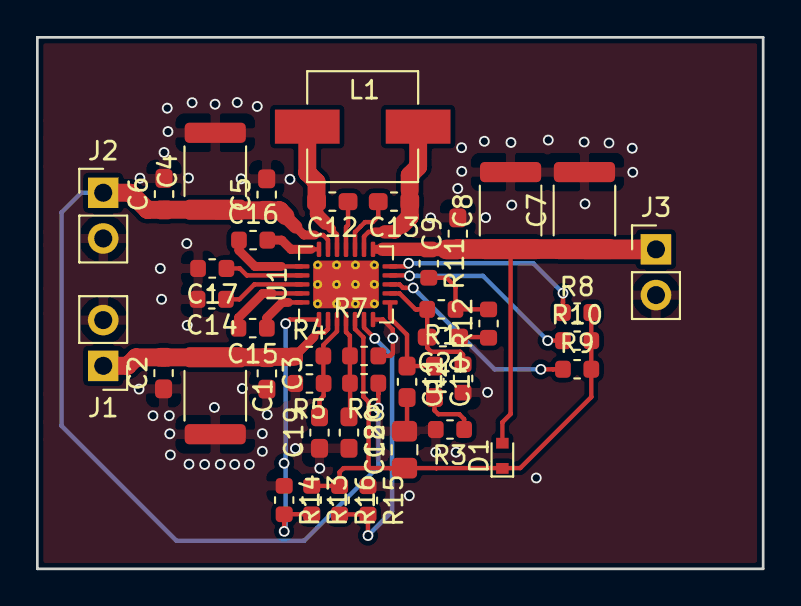
[picture p242: board battery_charger.kicad_pcb from above]

Board: 2 copper layers, 40.3 x 29.5 mm, 43 parts (0 on the bottom side), 27 nets.
