wuzipu123/software/Electronic/Tochterplatine_sensirion_SPS30/Tochterplatine_sensirion_SPS30.kicad_pcb

## KiCad design Electronic/Tochterplatine_sensirion_SPS30/Tochterplatine_sensirion_SPS30.kicad_pcb (2024-06-28)

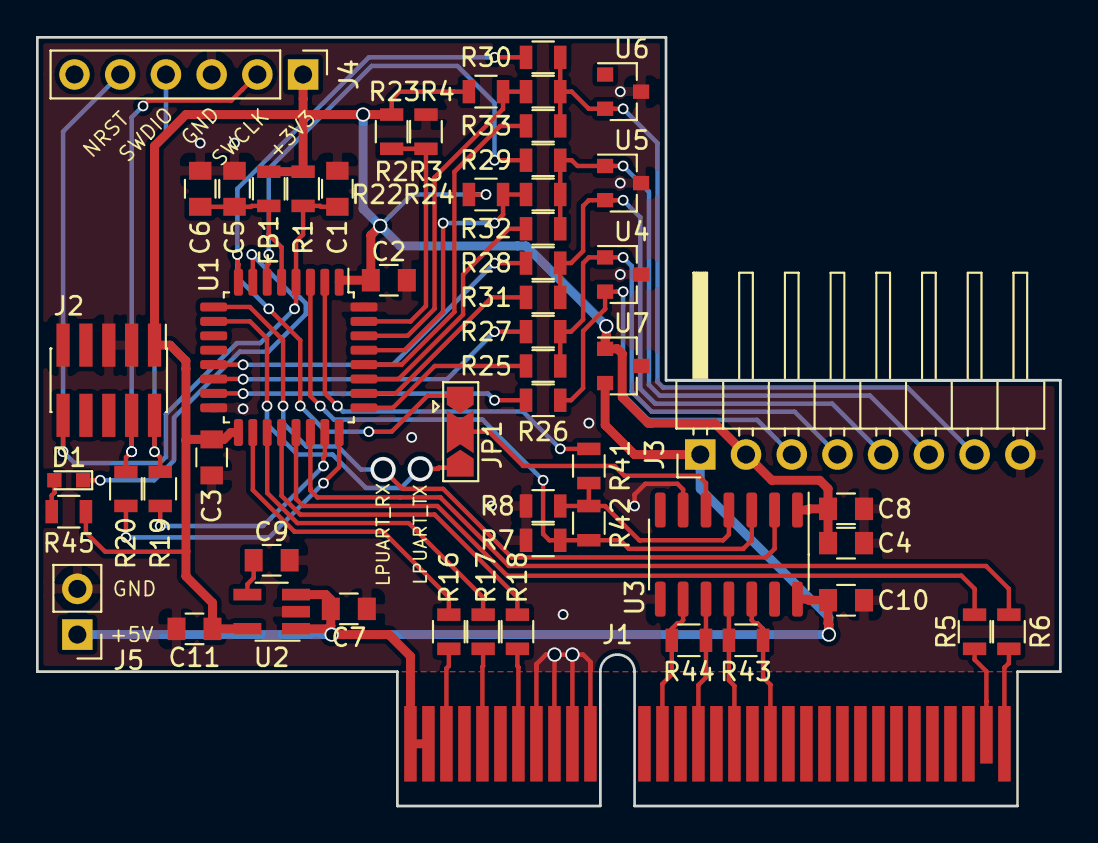
[picture p243: board Tochterplatine_sensirion_SPS30.kicad_pcb from above]

Board: 2 copper layers, 56.8 x 42.7 mm, 56 parts (0 on the bottom side), 49 nets.

Parts:
C1, C2, C3, C5, C8, C10: 100n; C_0805
C4, C6, C7, C11: 1u; C_0805
C9: 10n; C_0805
D1: LED; LED_0603
FB1: Ferrite_Bead; L_0805
J1: PCIE-064-02-F-D-TH-tochter; SAMTEC_PCIE_064-02-F-D-TH-Tochter
J2: Conn_ARM_JTAG_SWD_10; PinHeader_2x05_P1.27mm_Vertical_SMD
J3: Conn_01x08_Male; PinHeader_1x08_P2.54mm_Horizontal
J4: Conn_01x06_Male; PinHeader_1x06_P2.54mm_Vertical
J5: Conn_01x02_Male; PinHeader_1x02_P2.54mm_Vertical
JP1: SolderJumper_3_Open; SolderJumper-3_P2.0mm_Open_TrianglePad1.0x1.5mm
R1, R2, R25, R26, R27, R28, R29, R30, R31, R32, R33, R41, R42: DNP; R_0805
R3, R7, R8: 10k; R_0805
R4, R5, R6, R19, R20, R24: 22R; R_0805
R16, R17, R18: 100R; R_0805
R22, R23: 4k7; R_0805
R43, R44: 120R; R_0805
R45: 480R; R_0805
U1: STM32L021K4Tx; LQFP-32_7x7mm_P0.8mm
U2: LDK130-33_SOT23_SOT353; SOT-23-5_HandSoldering
U3: MAX13432EESD; SOIC-14_3.9x8.7mm_P1.27mm
U4, U5, U6, U7: PESD2CAN; SOT-23

Connections:
+3V3: C2.1, C3.1, C4.1, C8.2, C11.2, FB1.1, J2.1, J3.2, J4.1, R1.1, R2.1, R22.1, R23.1, R45.1, U1.1, U1.17, U2.5, U3.1, U7.1
+5V: C7.2, C10.1, J1.B1, J1.B2, J3.1, J5.1, U2.1, U2.3, U3.14, U7.2
/Adr0: J1.B3, R16.1
/Adr1: J1.B5, R17.1
/Adr2: J1.B7, R18.1
/CP0: J1.B31, R5.2
/CP1: J1.B32, R6.2
/I2C_SCL: R22.2, R24.1, U1.29
/I2C_SDA: R4.1, R23.2, U1.30
/LPUART1_DE: R7.1, R42.1, U1.3, U3.3
/LPUART1_RE: R41.1, U1.2
/LPUART1_RX: U1.9, U3.2
/LPUART1_TX: JP1.2, U3.5
/LPUART1_TX_STM32L04: JP1.3, U1.10
/Main_Connection/RS485_A: J1.B19, R43.1, U3.12
/Main_Connection/RS485_B: J1.B17, R43.2, U3.11
/Main_Connection/RS485_Y: J1.B13, R44.1, U3.9
/Main_Connection/RS485_Z: J1.B15, R44.2, U3.10
/NRST: C1.1, J2.10, J4.5, R1.2, U1.4
/SPI_MISO: R32.1, U1.27
/SPI_MOSI: R33.1, U1.28
/SPI_NSS: R25.1, U1.25
/SPI_SCK: R31.1, U1.26
/SWCLK: J2.4, J4.2, R20.1
/SWDIO: J2.2, J4.4, R19.1
/USART2_CK: R26.1, U1.15
/USART2_CTS: R28.1, U1.13
/USART2_RTS_DE: R27.1, U1.14
/USART2_RX: R29.1, U1.6
/USART2_TX_STM32L051: JP1.1, R30.1, U1.8
GND: C1.2, C2.2, C3.2, C4.2, C5.2, C6.2, C7.1, C8.1, C9.1, C10.2, C11.1, J1.B8, J1.B9, J1.B10, J1.B11, J2.3, J2.5, J2.9, J3.8, J4.3, J5.2, R3.2, R7.2, R8.2, U1.16, U1.32, U2.2, U3.6, U3.8, U4.3, U5.3, U6.3, U7.3
unnamed: C5.1, C6.1, FB1.2, U1.5
unnamed: C9.2, U2.4
unnamed: D1.1, U1.7
unnamed: D1.2, R45.2
unnamed: J3.3, R26.2, U4.2
unnamed: J3.4, R25.2, R27.2, U4.1
unnamed: J3.5, R28.2, R31.2, U5.2
unnamed: J3.6, R24.2, R29.2, R32.2, U5.1
unnamed: J3.7, R4.2, R30.2, R33.2, U6.2
unnamed: R2.2, R3.1, U1.31
unnamed: R5.1, U1.21
unnamed: R6.1, U1.22
unnamed: R16.2, U1.18
unnamed: R17.2, U1.19
unnamed: R18.2, U1.20
unnamed: R19.2, U1.23
unnamed: R20.2, U1.24
unnamed: R8.1, R41.2, R42.2, U3.4
