wuzipu123/software/Electronic/Sensor_Node_LoRa_SPS30/Sensor_Node_LoRa_SPS30.kicad_pcb

## KiCad design Electronic/Sensor_Node_LoRa_SPS30/Sensor_Node_LoRa_SPS30.kicad_pcb (2024-06-28)

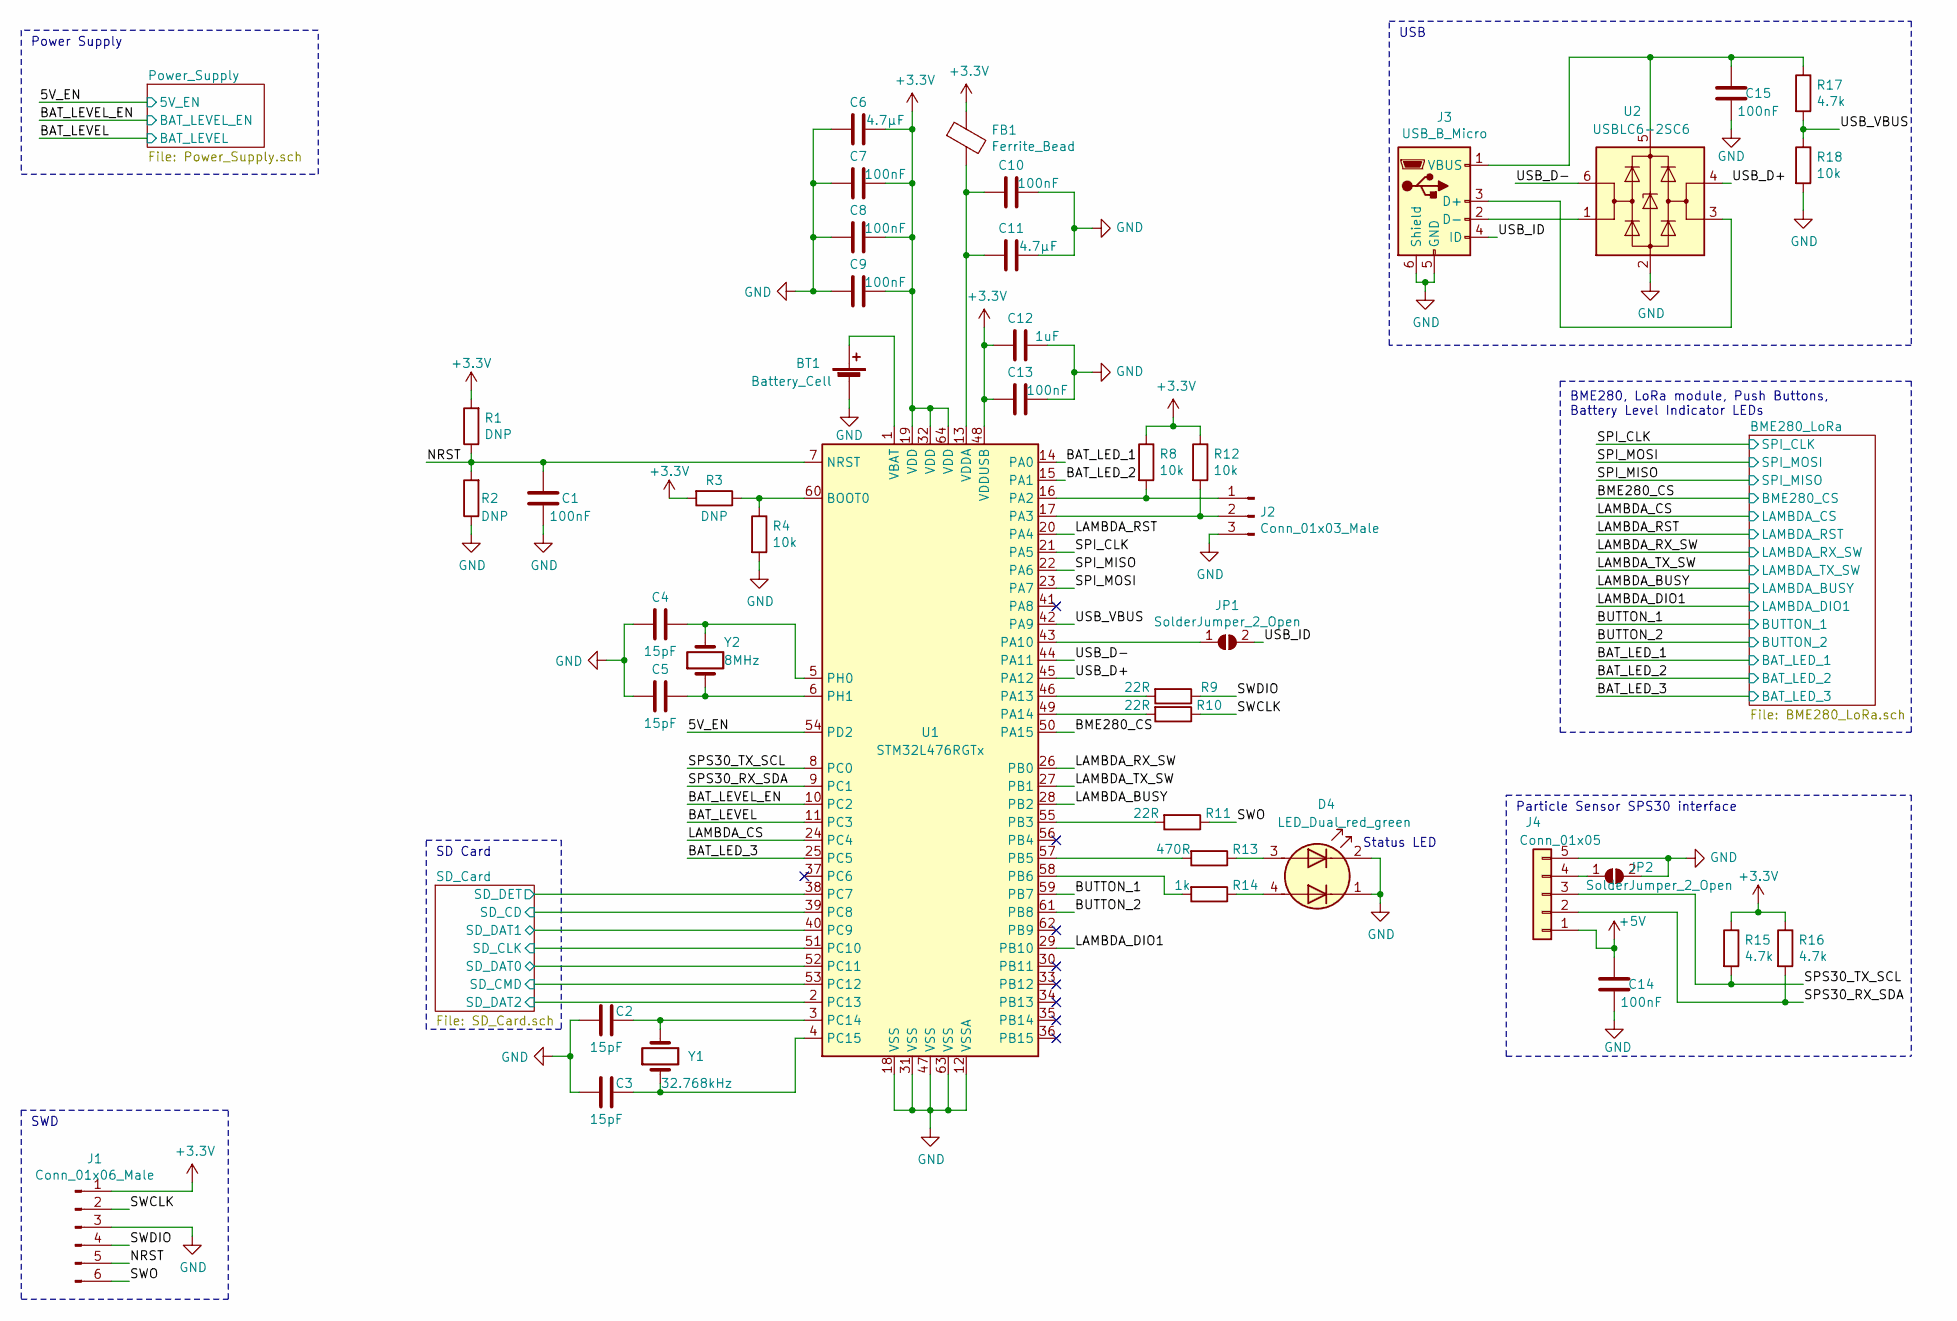
[picture p244: schematic Sensor_Node_LoRa_SPS30.sch, SensMat Particle Sensor]

Parts:
BT1: Battery_Cell; BatteryHolder_Keystone_2998_1x6.8mm
C1, C7, C8, C9, C13, C14, C15: 100nF; C_0603_1608Metric_Pad1.05x0.95mm_HandSolder
C2, C3, C4, C5: 15pF; C_0603_1608Metric_Pad1.05x0.95mm_HandSolder
C6, C11: 4.7µF; C_0603_1608Metric_Pad1.05x0.95mm_HandSolder
C10: 100nF; C_0603_1608Metric_Pad1.05x0.95mm_HandSolder; Digi-Key_PN test
C12: 1uF; C_0603_1608Metric_Pad1.05x0.95mm_HandSolder
D4: LED_Dual_red_green; LED_WUERTH_WL-SBCD_0805
FB1: Ferrite_Bead; L_0805_2012Metric_Pad1.15x1.40mm_HandSolder
J1: Conn_01x06_Male; PinHeader_1x06_P2.54mm_Vertical
J2: Conn_01x03_Male; PinHeader_1x03_P2.54mm_Vertical
J3: USB_B_Micro; USB_Micro-B_GCT_USB3076-30-A
J4: Conn_01x05; JST_ZH_B5B-ZH-R_1x05_P1.50mm_Vertical
JP1, JP2: SolderJumper_2_Open; SolderJumper-2_P1.3mm_Open_TrianglePad1.0x1.5mm
R1, R2, R3: DNP; R_0603_1608Metric_Pad1.05x0.95mm_HandSolder
R4, R8, R12, R18: 10k; R_0603_1608Metric_Pad1.05x0.95mm_HandSolder
R9, R10, R11: 22R; R_0603_1608Metric_Pad1.05x0.95mm_HandSolder
R13: 470R; R_0603_1608Metric_Pad1.05x0.95mm_HandSolder
R14: 1k; R_0603_1608Metric_Pad1.05x0.95mm_HandSolder
R15, R16, R17: 4.7k; R_0603_1608Metric_Pad1.05x0.95mm_HandSolder
U1: STM32L476RGTx; LQFP-64_10x10mm_P0.5mm
U2: USBLC6-2SC6; SOT-23-6_Handsoldering
Y1: 32.768kHz; Crystal_SMD_3215-2Pin_3.2x1.5mm_HandSoldering
Y2: 8MHz; Crystal_SMD_5032-2Pin_5.0x3.2mm_HandSoldering

Connections:
+3V3: C6.1, C7.1, C8.1, C9.1, C12.2, C13.2, FB1.1, J1.1, R1.2, R3.2, R8.1, R12.1, R15.1, R16.1, U1.19 (VDD), U1.32 (VDD), U1.48 (VDDUSB), U1.64 (VDD); also elsewhere on the board
+5V: C14.2, J4.1; also elsewhere on the board
/5V_EN: U1.54 (PD2); also elsewhere on the board
/BAT_LED_1: U1.14 (PA0); also elsewhere on the board
/BAT_LED_2: U1.15 (PA1); also elsewhere on the board
/BAT_LED_3: U1.25 (PC5); also elsewhere on the board
/BAT_LEVEL: U1.11 (PC3); also elsewhere on the board
/BAT_LEVEL_EN: U1.10 (PC2); also elsewhere on the board
/BME280_CS: U1.50 (PA15); also elsewhere on the board
/BUTTON_1: U1.59 (PB7); also elsewhere on the board
/BUTTON_2: U1.61 (PB8); also elsewhere on the board
/LAMBDA_BUSY: U1.28 (PB2); also elsewhere on the board
/LAMBDA_CS: U1.24 (PC4); also elsewhere on the board
/LAMBDA_DIO1: U1.29 (PB10); also elsewhere on the board
/LAMBDA_RST: U1.20 (PA4); also elsewhere on the board
/LAMBDA_RX_SW: U1.26 (PB0); also elsewhere on the board
/LAMBDA_TX_SW: U1.27 (PB1); also elsewhere on the board
/NRST: C1.2, J1.5, R1.1, R2.2, U1.7 (NRST)
/SD_Card/SD_CD: U1.39 (PC8); also elsewhere on the board
/SD_Card/SD_CLK: U1.51 (PC10); also elsewhere on the board
/SD_Card/SD_CMD: U1.53 (PC12); also elsewhere on the board
/SD_Card/SD_DAT0: U1.52 (PC11); also elsewhere on the board
/SD_Card/SD_DAT1: U1.40 (PC9); also elsewhere on the board
/SD_Card/SD_DAT2: U1.2 (PC13); also elsewhere on the board
/SD_Card/SD_DET: U1.38 (PC7); also elsewhere on the board
/SPI_CLK: U1.21 (PA5); also elsewhere on the board
/SPI_MISO: U1.22 (PA6); also elsewhere on the board
/SPI_MOSI: U1.23 (PA7); also elsewhere on the board
/SPS30_RX_SDA: J4.2, R16.2, U1.9 (PC1)
/SPS30_TX_SCL: J4.3, R15.2, U1.8 (PC0)
/SWCLK: J1.2, R10.1
/SWDIO: J1.4, R9.1
/SWO: J1.6, R11.1
/USB_D+: U1.45 (PA12), U2.4 (I/O2)
/USB_D-: U1.44 (PA11), U2.6 (I/O1)
/USB_ID: J3.4 (ID), JP1.2 (B)
/USB_VBUS: R17.2, R18.1, U1.42 (PA9)
GND: BT1.2 (-), C1.1, C2.1, C3.1, C4.1, C5.1, C6.2, C7.2, C8.2, C9.2, C10.1, C11.1, C12.1, C13.1, C14.1, C15.1, D4.1 (K2), D4.2 (K1), J1.3, J2.3, J3.5 (GND), J3.6 (Shield), J4.5, JP2.2 (B), R2.1, R4.2, R18.2, U1.12 (VSSA), U1.18 (VSS), U1.31 (VSS), U1.47 (VSS), U1.63 (VSS), U2.2 (GND); also elsewhere on the board
unnamed: BT1.1 (+), U1.1 (VBAT)
unnamed: C2.2, U1.3 (PC14), Y1.2
unnamed: C3.2, U1.4 (PC15), Y1.1
unnamed: C4.2, U1.5 (PH0), Y2.2
unnamed: C5.2, U1.6 (PH1), Y2.1
unnamed: C10.2, C11.2, FB1.2, U1.13 (VDDA)
unnamed: C15.2, J3.1 (VBUS), R17.1, U2.5 (VBUS)
unnamed: D4.3 (A1), R13.1
unnamed: D4.4 (A2), R14.1
unnamed: J2.1, R8.2, U1.16 (PA2)
unnamed: J2.2, R12.2, U1.17 (PA3)
unnamed: J3.2 (D-), U2.1 (I/O1)
unnamed: J3.3 (D+), U2.3 (I/O2)
unnamed: J4.4, JP2.1 (A)
unnamed: JP1.1 (A), U1.43 (PA10)
unnamed: R3.1, R4.1, U1.60 (BOOT0)
unnamed: R9.2, U1.46 (PA13)
unnamed: R10.2, U1.49 (PA14)
unnamed: R11.2, U1.55 (PB3)
unnamed: R13.2, U1.57 (PB5)
unnamed: R14.2, U1.58 (PB6)

Notes on the sheet:
SWD
BME280, LoRa module, Push Buttons, Battery Level Indicator LEDs
SD Card
Particle Sensor SPS30 interface
USB
Power Supply
Status LED

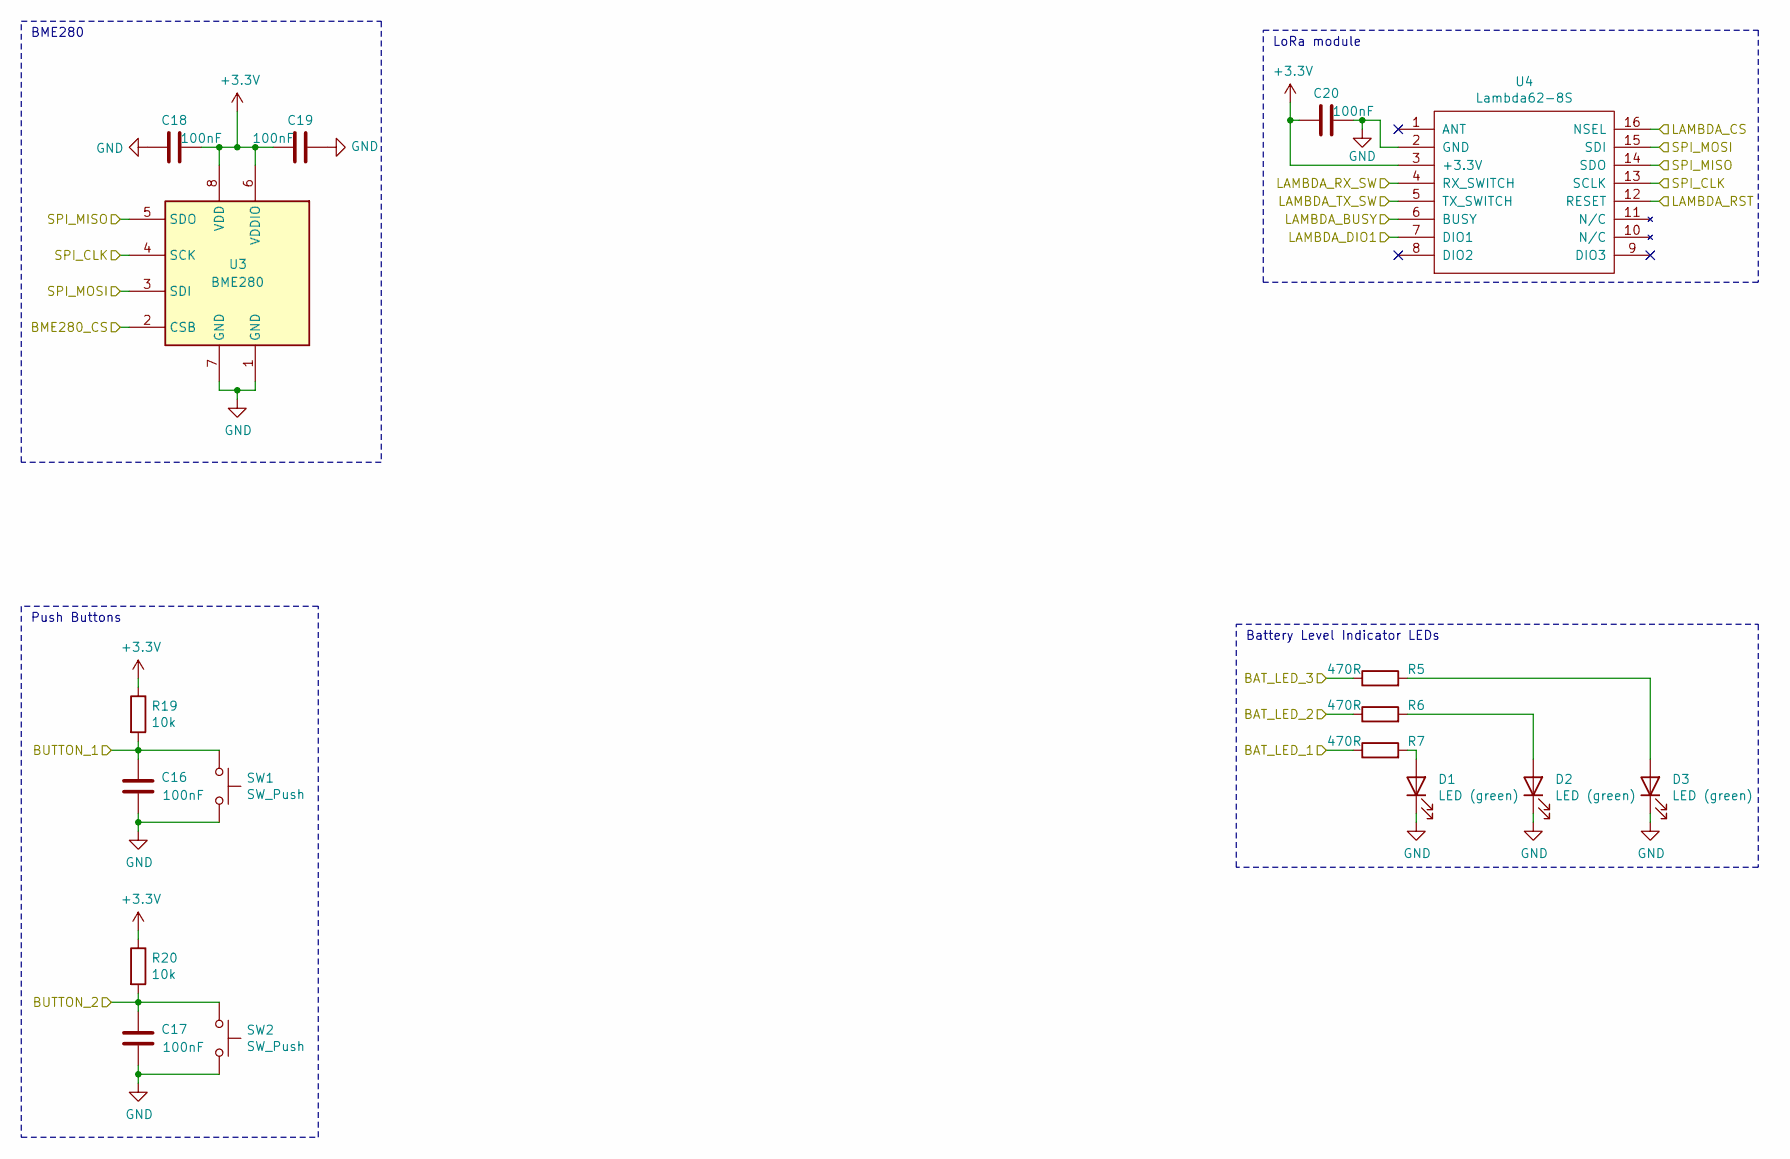
[picture p245: schematic BME280_LoRa.sch, SensMat Particle Sensor]

Parts:
C16, C17, C18, C19, C20: 100nF; C_0603_1608Metric_Pad1.05x0.95mm_HandSolder
D1, D2, D3: LED (green); LED_0603_1608Metric_Pad1.05x0.95mm_HandSolder
R5, R6, R7: 470R; R_0603_1608Metric_Pad1.05x0.95mm_HandSolder
R19, R20: 10k; R_0603_1608Metric_Pad1.05x0.95mm_HandSolder
SW1, SW2: SW_Push; SW_Tactile_SPST_Angled_PTS645Vx58-2LFS
U3: BME280; Bosch_LGA-8_2.5x2.5mm_P0.65mm_ClockwisePinNumbering
U4: Lambda62-8S

Connections:
+3V3: C18.1, C19.2, C20.2, R19.1, R20.1, U3.6 (VDDIO), U3.8 (VDD), U4.3 (+3.3V); also elsewhere on the board
/BAT_LED_1: R7.1; also elsewhere on the board
/BAT_LED_2: R6.1; also elsewhere on the board
/BAT_LED_3: R5.1; also elsewhere on the board
/BME280_CS: U3.2 (CSB); also elsewhere on the board
/BUTTON_1: C16.2, R19.2, SW1.1; also elsewhere on the board
/BUTTON_2: C17.2, R20.2, SW2.1; also elsewhere on the board
/LAMBDA_BUSY: U4.6 (BUSY); also elsewhere on the board
/LAMBDA_CS: U4.16 (NSEL); also elsewhere on the board
/LAMBDA_DIO1: U4.7 (DIO1); also elsewhere on the board
/LAMBDA_RST: U4.12 (RESET); also elsewhere on the board
/LAMBDA_RX_SW: U4.4 (RX_SWITCH); also elsewhere on the board
/LAMBDA_TX_SW: U4.5 (TX_SWITCH); also elsewhere on the board
/SPI_CLK: U3.4 (SCK), U4.13 (SCLK); also elsewhere on the board
/SPI_MISO: U3.5 (SDO), U4.14 (SDO); also elsewhere on the board
/SPI_MOSI: U3.3 (SDI), U4.15 (SDI); also elsewhere on the board
GND: C16.1, C17.1, C18.2, C19.1, C20.1, D1.1 (K), D2.1 (K), D3.1 (K), SW1.2, SW2.2, U3.1 (GND), U3.7 (GND), U4.2 (GND); also elsewhere on the board
unnamed: D1.2 (A), R7.2
unnamed: D2.2 (A), R6.2
unnamed: D3.2 (A), R5.2

Notes on the sheet:
LoRa module
BME280
Push Buttons
Battery Level Indicator LEDs

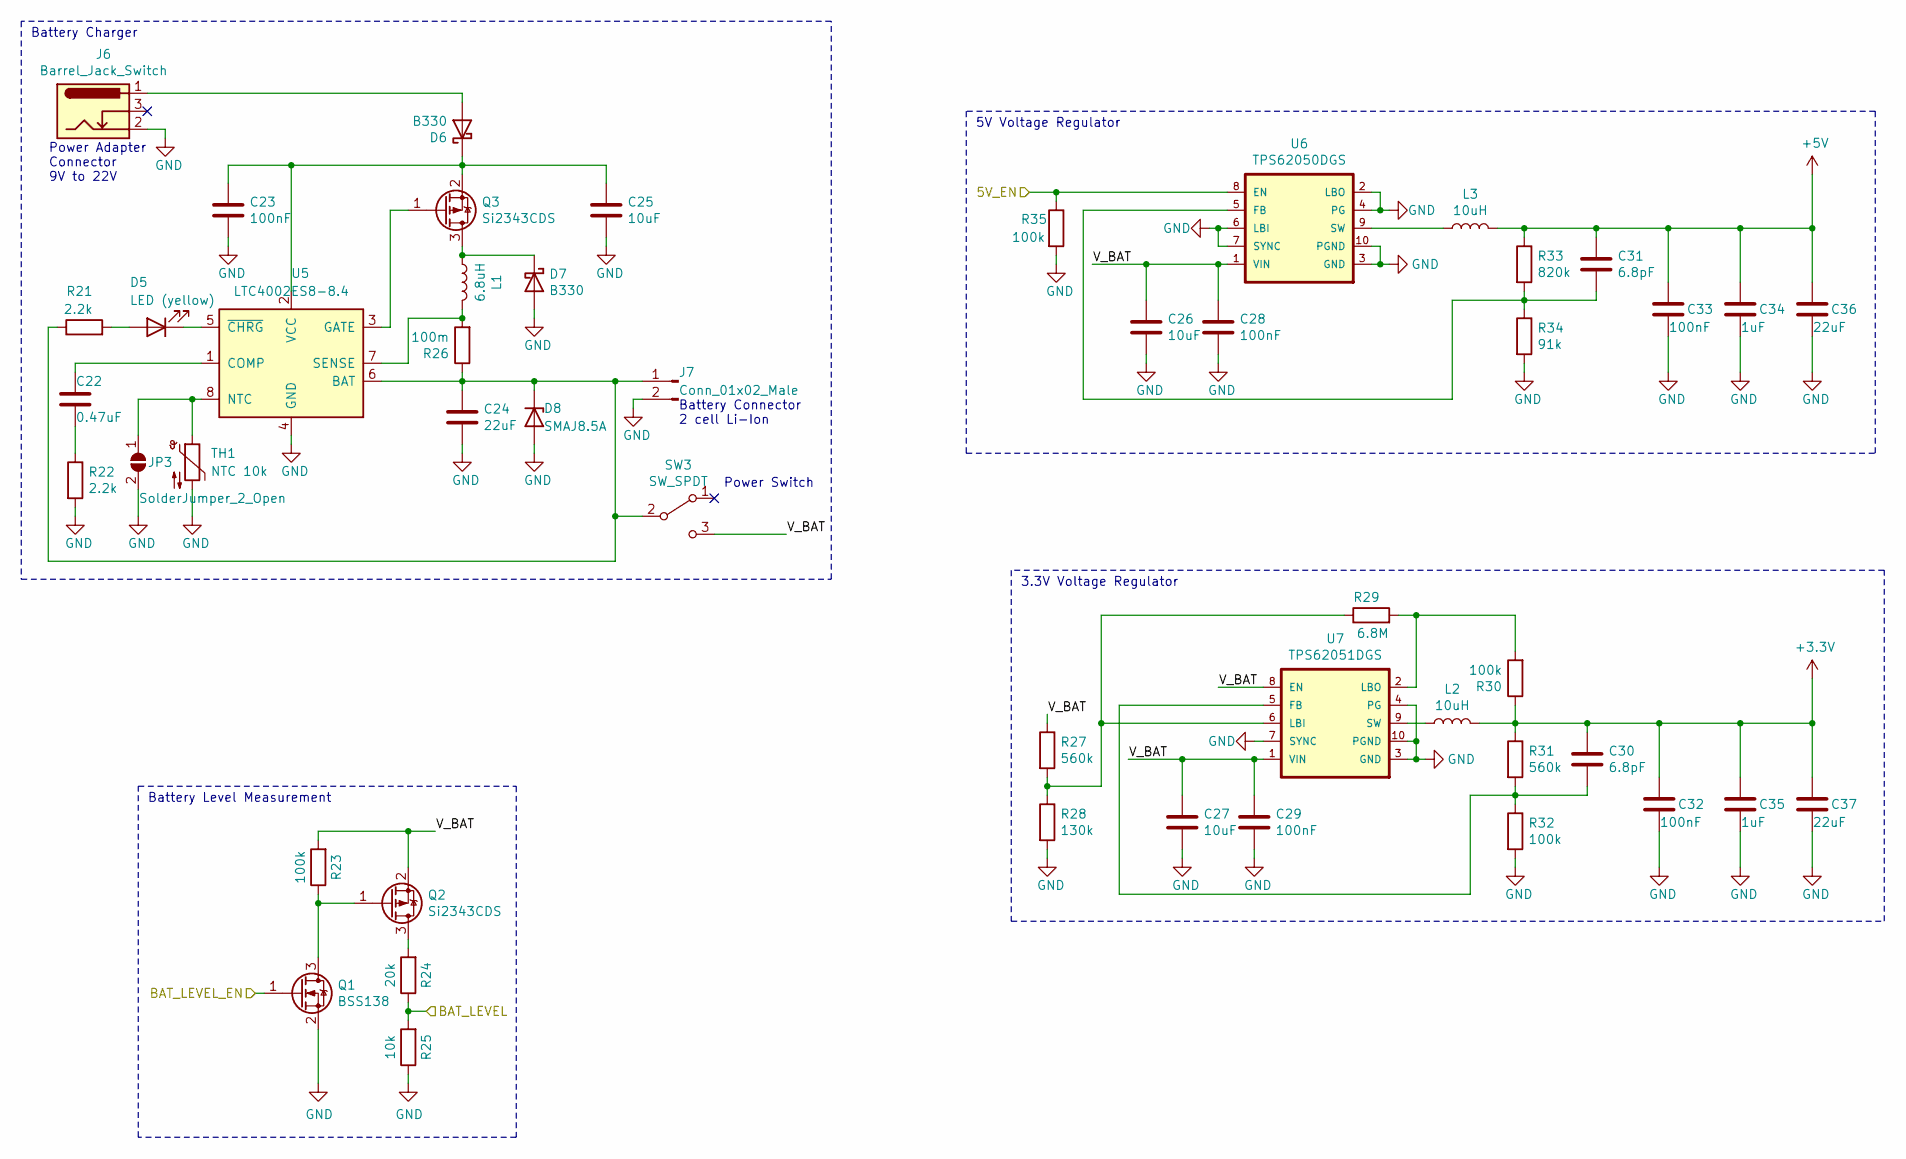
[picture p246: schematic Power_Supply.sch, SensMat Particle Sensor]

Parts:
C22: 0.47uF; C_0603_1608Metric_Pad1.05x0.95mm_HandSolder
C23, C28, C29, C32, C33: 100nF; C_0603_1608Metric_Pad1.05x0.95mm_HandSolder
C24, C36, C37: 22uF; C_0603_1608Metric_Pad1.05x0.95mm_HandSolder
C25, C26, C27: 10uF; C_0603_1608Metric_Pad1.05x0.95mm_HandSolder
C30, C31: 6.8pF; C_0603_1608Metric_Pad1.05x0.95mm_HandSolder
C34, C35: 1uF; C_0603_1608Metric_Pad1.05x0.95mm_HandSolder
D5: LED (yellow); LED_0603_1608Metric_Pad1.05x0.95mm_HandSolder
D6, D7: B330; D_SMB-SMC_Universal_Handsoldering
D8: SMAJ8.5A; D_SMA
J6: Barrel_Jack_Switch; BarrelJack_CUI_PJ-051A_Horizontal
J7: Conn_01x02_Male; PinSocket_1x02_P2.54mm_Vertical
JP3: SolderJumper_2_Open; SolderJumper-2_P1.3mm_Open_TrianglePad1.0x1.5mm
L1: 6.8uH; L_Wuerth_LQS-6045
L2, L3: 10uH; L_Wuerth_LQS-5040
Q1: BSS138; SOT-23
Q2, Q3: Si2343CDS; SOT-23
R21, R22: 2.2k; R_0603_1608Metric_Pad1.05x0.95mm_HandSolder
R23, R30, R32, R35: 100k; R_0603_1608Metric_Pad1.05x0.95mm_HandSolder
R24: 20k; R_0603_1608Metric_Pad1.05x0.95mm_HandSolder
R25: 10k; R_0603_1608Metric_Pad1.05x0.95mm_HandSolder
R26: 100m; R_1206_3216Metric_Pad1.42x1.75mm_HandSolder
R27, R31: 560k; R_0603_1608Metric_Pad1.05x0.95mm_HandSolder
R28: 130k; R_0603_1608Metric_Pad1.05x0.95mm_HandSolder
R29: 6.8M; R_0603_1608Metric_Pad1.05x0.95mm_HandSolder
R33: 820k; R_0603_1608Metric_Pad1.05x0.95mm_HandSolder
R34: 91k; R_0603_1608Metric_Pad1.05x0.95mm_HandSolder
SW3: SW_SPDT; SW_CK_SK-12F17-G_7_SPDT_Angled
TH1: NTC 10k; R_1206_3216Metric_Pad1.42x1.75mm_HandSolder
U5: LTC4002ES8-8.4; SOIC-8_3.9x4.9mm_P1.27mm
U6: TPS62050DGS; MSOP-10_3x3mm_P0.5mm
U7: TPS62051DGS; MSOP-10_3x3mm_P0.5mm

Connections:
+3V3: C30.1, C32.1, C35.1, C37.1, L2.2, R30.1, R31.1; also elsewhere on the board
+5V: C31.1, C33.1, C34.1, C36.1, L3.2, R33.1; also elsewhere on the board
/5V_EN: R35.1, U6.8 (EN); also elsewhere on the board
/BAT_LEVEL: R24.1, R25.2; also elsewhere on the board
/BAT_LEVEL_EN: Q1.1 (G); also elsewhere on the board
/Power_Supply/V_BAT: C26.1, C27.1, C28.1, C29.1, Q2.2 (S), R23.2, R27.1, SW3.3 (C), U6.1 (VIN), U7.1 (VIN), U7.8 (EN)
GND: C23.2, C24.2, C25.2, C26.2, C27.2, C28.2, C29.2, C32.2, C33.2, C34.2, C35.2, C36.2, C37.2, D7.2 (A), D8.2 (A2), J6.2, J7.2, JP3.2 (B), Q1.2 (S), R22.2, R25.1, R28.2, R32.2, R34.2, R35.2, TH1.2, U5.4 (GND), U6.2 (LBO), U6.3 (GND), U6.4 (PG), U6.6 (LBI), U6.7 (SYNC), U6.10 (PGND), U7.3 (GND), U7.4 (PG), U7.7 (SYNC), U7.10 (PGND); also elsewhere on the board
unnamed: C22.1, U5.1 (COMP)
unnamed: C22.2, R22.1
unnamed: C23.1, C25.1, D6.1 (K), Q3.2 (S), U5.2 (VCC)
unnamed: C24.1, D8.1 (A1), J7.1, R21.1, R26.1, SW3.2 (B), U5.6 (BAT)
unnamed: C30.2, R31.2, R32.1, U7.5 (FB)
unnamed: C31.2, R33.2, R34.1, U6.5 (FB)
unnamed: D5.1 (K), U5.5 (~CHRG~)
unnamed: D5.2 (A), R21.2
unnamed: D6.2 (A), J6.1
unnamed: D7.1 (K), L1.1, Q3.3 (D)
unnamed: JP3.1 (A), TH1.1, U5.8 (NTC)
unnamed: L1.2, R26.2, U5.7 (SENSE)
unnamed: L2.1, U7.9 (SW)
unnamed: L3.1, U6.9 (SW)
unnamed: Q1.3 (D), Q2.1 (G), R23.1
unnamed: Q2.3 (D), R24.2
unnamed: Q3.1 (G), U5.3 (GATE)
unnamed: R27.2, R28.1, R29.1, U7.6 (LBI)
unnamed: R29.2, R30.2, U7.2 (LBO)

Notes on the sheet:
Battery Connector 2 cell Li-Ion
Power Switch
Power Adapter Connector 9V to 22V
5V Voltage Regulator
3.3V Voltage Regulator
Battery Level Measurement
Battery Charger

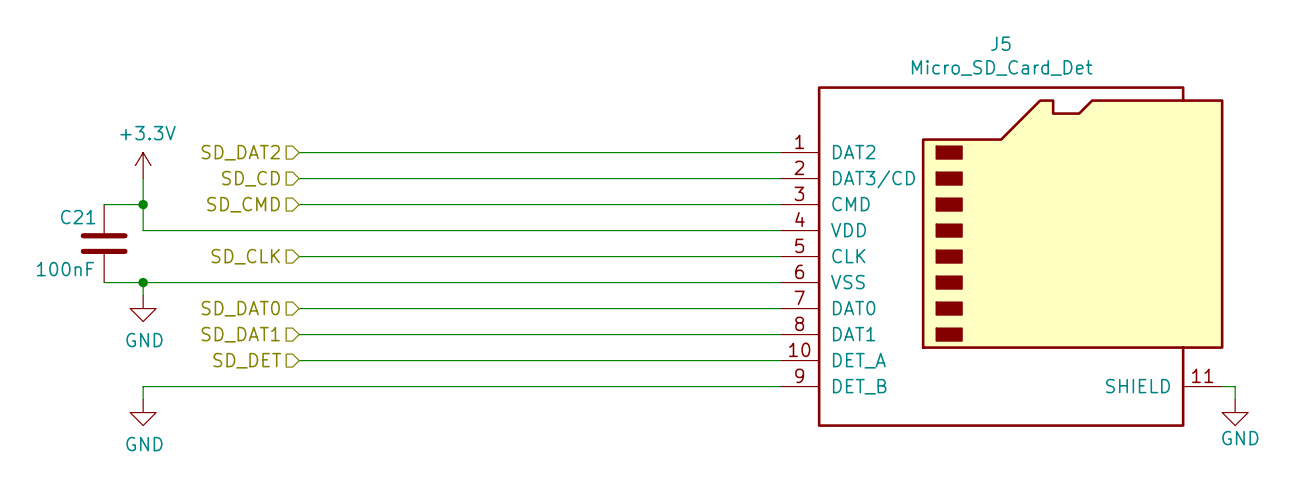
[picture p247: schematic SD_Card.sch, SensMat Particle Sensor]

Parts:
C21: 100nF; C_0603_1608Metric_Pad1.05x0.95mm_HandSolder
J5: Micro_SD_Card_Det; microSD_HC_Hirose_DM3AT-SF-PEJM5

Connections:
+3V3: C21.1, J5.4 (VDD); also elsewhere on the board
/SD_Card/SD_CD: J5.2 (DAT3/CD); also elsewhere on the board
/SD_Card/SD_CLK: J5.5 (CLK); also elsewhere on the board
/SD_Card/SD_CMD: J5.3 (CMD); also elsewhere on the board
/SD_Card/SD_DAT0: J5.7 (DAT0); also elsewhere on the board
/SD_Card/SD_DAT1: J5.8 (DAT1); also elsewhere on the board
/SD_Card/SD_DAT2: J5.1 (DAT2); also elsewhere on the board
/SD_Card/SD_DET: J5.10 (DET_A); also elsewhere on the board
GND: C21.2, J5.6 (VSS), J5.9 (DET_B), J5.11 (SHIELD); also elsewhere on the board

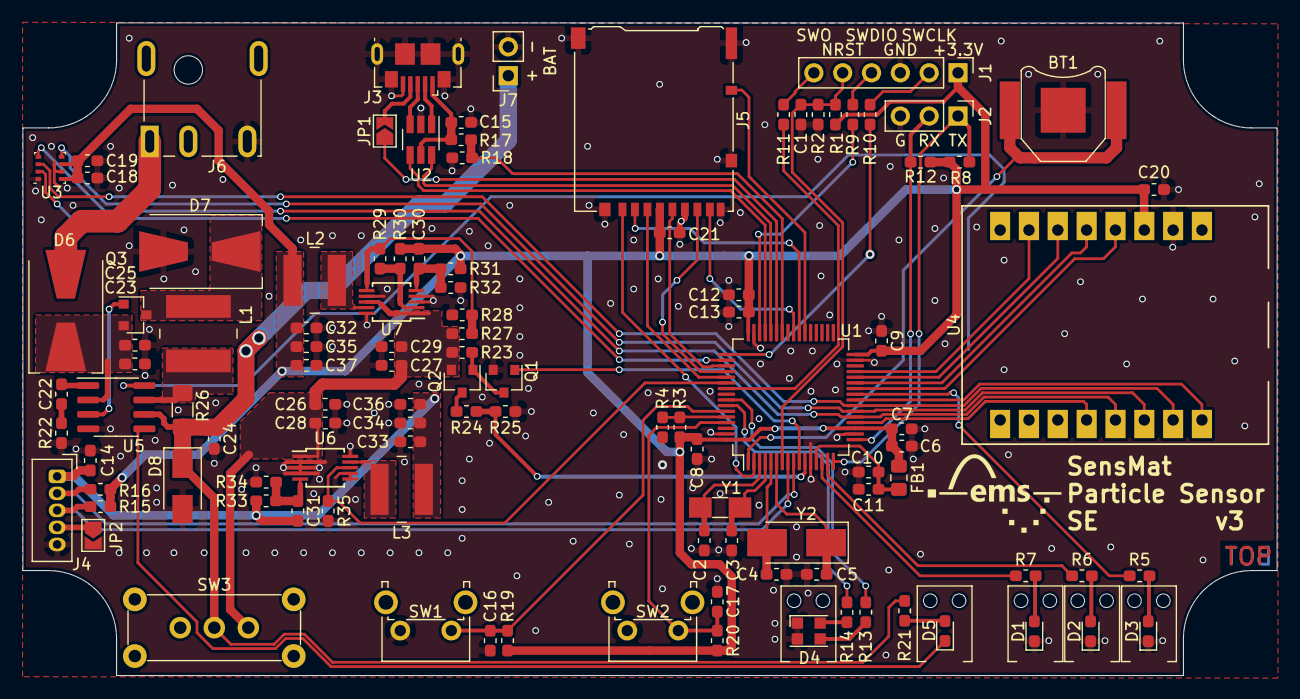
[picture p248: board Sensor_Node_LoRa_SPS30.kicad_pcb from above]

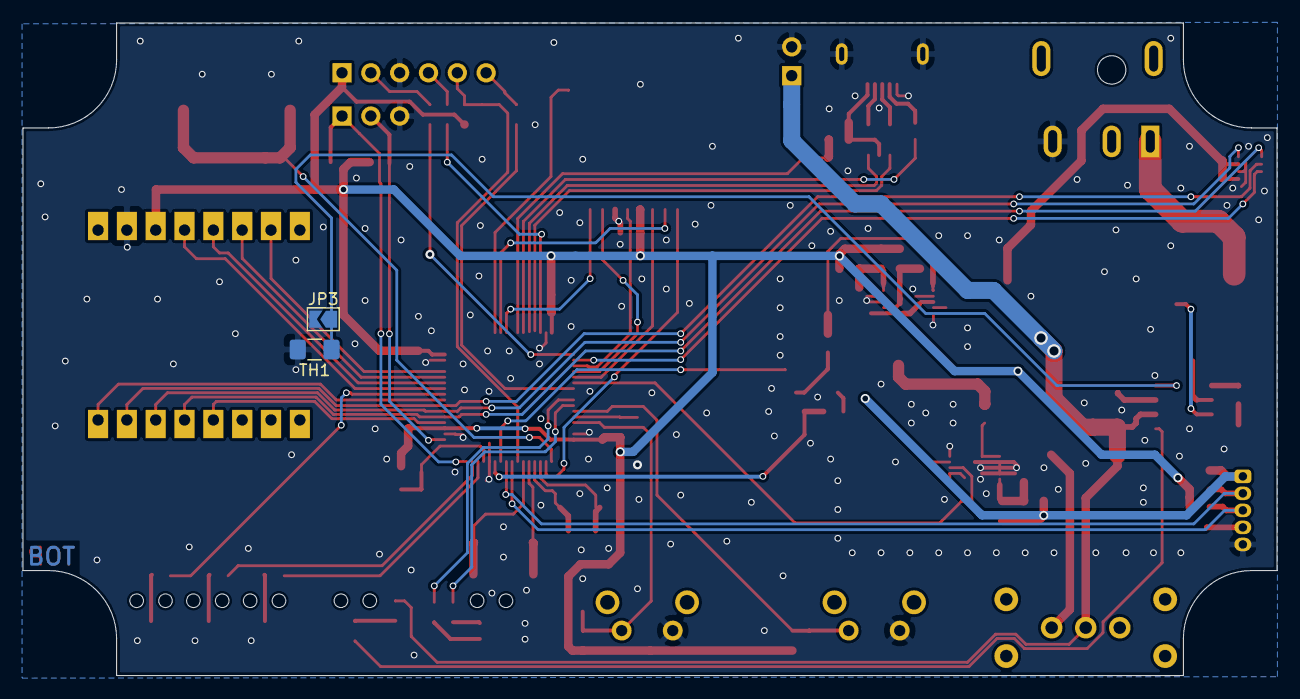
[picture p249: board Sensor_Node_LoRa_SPS30.kicad_pcb from below]

Board: 2 copper layers, 110.5 x 57.5 mm, 111 parts (2 on the bottom side), 82 nets.
