wuzipu123/software/Software/Controller/src/constant/constants.h

#define CONTROLLER_CONSTANTS_H
#include "PinNames.h"
#define VERSION_MAJOR              0U //!< Major version
#define VERSION_MINOR              5U //!< Minor version
#define VERSION_BUILD              0U //!< Build version
struct version_number_s {
  uint8_t major;
  uint8_t minor;
  uint16_t build;
};
const struct version_number_s version = {VERSION_MAJOR, VERSION_MINOR, VERSION_BUILD};
const char *const build_date = __DATE__;
const char *const build_time = __TIME__;
#define NUM_SENSOR_SLOTS                                  sizeof(sensor_io_configs) / sizeof(io_config_t) //6U
#define CONTROL_FLAG_SENSOR_DATA_READY(slave_address)     (1UL << (slave_address))
#define CONTROL_FLAG_DO_MEASUREMENT(slave_address)        (1UL << ((slave_address) + NUM_SENSOR_SLOTS))
#define CONTROL_FLAG_SENSOR_BOARD_STARTED(slave_address)  (1UL << ((slave_address) + (2U * NUM_SENSOR_SLOTS)))
#define CONTROL_FLAG_START_STOP                           (1UL << 30U)
#define CONTROL_FLAG_RESET                                (1UL << 29U)
#define CONTROL_FLAG_FORMAT_SD                            (1UL << 28U)
#define CONTROL_FLAG_COMMAND                              (1UL << 27U)
#define CONTROL_FLAG_RECEIVED_COMMAND                     (1UL << 26U)
#define STORAGE_ADDR_CONFIG                               POST_APPLICATION_ADDR
#define STORAGE_ADDR_LOG_LEVELS                           POST_APPLICATION_ADDR + FLASH_PAGE_SIZE
#define BUTTON_DEBOUNCE_TIME                              200
#define FORMAT_SD_MIN_BUTTON_PRESS_DURATION               3000
#define COMMAND_MIN_BUTTON_PRESS_DURATION                 3000
#define COMMAND_HANDLER_MAX_BUF_SIZE                      1024
const char *const time_command_name = "time";
const char *const time_command_description =
    "Usage: time [OPTIONS]\n"
    "Options:\n"
    "    <none>                    Print current time\n"
    "    set YYYY-MM-DD HH:MM:SS   Set time in specified format\n";
const char *const config_command_name = "config";
const char *const config_command_description =
    "Usage: config [OPTIONS]\n"
    "Options:\n"
    "    <none>                        Print current configuration\n"
    "    sensor=<slave address(es)>    Specify sensor or multiple sensors,\n"
    "                                  if comma separated list of addresses is given (e.g. sensor=2,4,1)\n"
    "    keep_alive=<true|false>       Set keep alive. Possible values are true and false\n"
    "    sample_time=<seconds>         Set sample time in seconds (integer)";
const char *const log_command_name = "log";
const char *const log_command_description =
    "Usage: log [OPTIONS]\n"
    "Options:\n"
    "    <none>                      Print current log settings\n"
    "    global=<log level>          Set log level globally for all modules (e.g. global=INFO)\n"
    "    <log module>=<log level>    Set log level for specified module (e.g. Sensor=INFO)\n";
#define LOG_LEVEL_NAME_MAX_SIZE   5
#define LOG_MODULE_NAME_MAX_SIZE  8
const char *const logger_level_names[] = {
    "SUPPR",
    "ERROR",
    "INFO",
    "DEBUG"
};
const constexpr char *const logger_module_names[] = {
    "Logger",
    "Main",
    "SDCard",
    "Command",
    "TimeCmd",
    "ConfCmd",
    "LogCmd",
    "CmdHandl",
    "Sensor",
    "SBSerial",
    "Protocol",
    "JsonProt",
    "BinProt",
    "SensData",
    "CheckSt",
    "InitSt",
    "IdleSt",
    "FormatSt",
    "CmdSt",
    "MeasSt",
    "SDErrSt",
    "ShutdoSt"
};
#define SENSOR_SERIAL_RXBUF_SIZE              1500
#define SENSOR_SERIAL_TXBUF_SIZE              1024
#define SENSOR_SERIAL_INTER_CMD_TIMEOUT_MS    100 // Minimum timeout between two sensor commands
#define SENSOR_MAX_ERRORS                     3
#define SENSOR_MAX_READ_ATTEMPTS              3
#define DEFAULT_SAMPLE_TIME_SEC               600
#define DEFAULT_KEEP_ALIVE                    false
#define SENSOR_BOARD_STARTUP_TIME_MS          3000
struct io_config_s {
  uint8_t address;           //!< slave address of the sensor slot (0 to #NUM_SENSOR_SLOTS - 1)
  PinName supply_enable_pin; //!< Pin name for the supply enable pin
  PinName error_pin;         //!< Pin name for the error pin
  PinName data_ready_pin;    //!< Pin name for the data ready pin
};
typedef struct io_config_s io_config_t;
const io_config_t sensor_io_configs[] = MBED_CONF_APP_SENSOR_BOARD_IO_MAPPING;
#define FILE_CREATION_INTERVAL_SEC (24 * 60 * 60)
