wuzipu123/software/Software/Particle_Sensor/mbed_config.h

/*
 * mbed SDK
 * Copyright (c) 2017 ARM Limited
 *
 * Licensed under the Apache License, Version 2.0 (the "License");
 * you may not use this file except in compliance with the License.
 * You may obtain a copy of the License at
 *
 * http://www.apache.org/licenses/LICENSE-2.0
 *
 * Unless required by applicable law or agreed to in writing, software
 * distributed under the License is distributed on an "AS IS" BASIS,
 * WITHOUT WARRANTIES OR CONDITIONS OF ANY KIND, either express or implied.
 * See the License for the specific language governing permissions and
 * limitations under the License.
 */

// Automatically generated configuration file.
// DO NOT EDIT, content will be overwritten.

#ifndef __MBED_CONFIG_DATA__
#define __MBED_CONFIG_DATA__

// Configuration parameters
#define CLOCK_SOURCE                                                      USE_PLL_HSE_XTAL                                                                                 // set by application[PART_SENS_V1]
#define LPTICKER_DELAY_TICKS                                              0                                                                                                // set by target:MCU_STM32L4
#define MBED_CONF_APP_BATTERY_LED_1                                       PA_0                                                                                             // set by application[PART_SENS_V1]
#define MBED_CONF_APP_BATTERY_LED_2                                       PA_1                                                                                             // set by application[PART_SENS_V1]
#define MBED_CONF_APP_BATTERY_LED_3                                       PC_5                                                                                             // set by application[PART_SENS_V1]
#define MBED_CONF_APP_BATTERY_LEVEL                                       PC_3                                                                                             // set by application[PART_SENS_V1]
#define MBED_CONF_APP_BATTERY_LEVEL_EN                                    PC_2                                                                                             // set by application[PART_SENS_V1]
#define MBED_CONF_APP_BME280_CHIP_SELECT                                  PA_15                                                                                            // set by application[PART_SENS_V1]
#define MBED_CONF_APP_BUTTON_1                                            PB_7                                                                                             // set by application[PART_SENS_V1]
#define MBED_CONF_APP_BUTTON_2                                            PB_8                                                                                             // set by application[PART_SENS_V1]
#define MBED_CONF_APP_LORA_ANTENNA_SWITCH                                 PB_1                                                                                             // set by application[PART_SENS_V1]
#define MBED_CONF_APP_LORA_BUSY                                           PB_2                                                                                             // set by application[PART_SENS_V1]
#define MBED_CONF_APP_LORA_CHIP_SELECT                                    PC_4                                                                                             // set by application[PART_SENS_V1]
#define MBED_CONF_APP_LORA_DEVICE_SELECT                                  PA_1                                                                                             // set by application[PART_SENS_V1]
#define MBED_CONF_APP_LORA_DIO1                                           PB_10                                                                                            // set by application[PART_SENS_V1]
#define MBED_CONF_APP_LORA_FREQUENCY_SELECT                               PA_0                                                                                             // set by application[PART_SENS_V1]
#define MBED_CONF_APP_LORA_RESET                                          PA_4                                                                                             // set by application[PART_SENS_V1]
#define MBED_CONF_APP_LORA_RX_SWITCH                                      PB_0                                                                                             // set by application[PART_SENS_V1]
#define MBED_CONF_APP_LORA_TX_SWITCH                                      PB_1                                                                                             // set by application[PART_SENS_V1]
#define MBED_CONF_APP_LORA_XTAL_SELECT                                    NC                                                                                               // set by application[PART_SENS_V1]
#define MBED_CONF_APP_SDCARD_SPI_FREQUENCY                                5000000                                                                                          // set by application[PART_SENS_V1]
#define MBED_CONF_APP_SD_CARD_DETECT                                      PC_7                                                                                             // set by application[PART_SENS_V1]
#define MBED_CONF_APP_SPI_CLK                                             PA_5                                                                                             // set by application[PART_SENS_V1]
#define MBED_CONF_APP_SPI_MISO                                            PA_6                                                                                             // set by application[PART_SENS_V1]
#define MBED_CONF_APP_SPI_MOSI                                            PA_7                                                                                             // set by application[PART_SENS_V1]
#define MBED_CONF_APP_SPS30_RX_SDA                                        PC_1                                                                                             // set by application[PART_SENS_V1]
#define MBED_CONF_APP_SPS30_SUPPLY_ENABLE                                 PD_2                                                                                             // set by application[PART_SENS_V1]
#define MBED_CONF_APP_SPS30_TX_SCL                                        PC_0                                                                                             // set by application[PART_SENS_V1]
#define MBED_CONF_APP_STATUS_LED_GREEN                                    PB_5                                                                                             // set by application[PART_SENS_V1]
#define MBED_CONF_APP_STATUS_LED_RED                                      PB_6                                                                                             // set by application[PART_SENS_V1]
#define MBED_CONF_DRIVERS_OSPI_CSN                                        OSPI_FLASH1_CSN                                                                                  // set by library:drivers
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
#define MBED_CONF_FLASHIAP_BLOCK_DEVICE_BASE_ADDRESS                      0xFFFFFFFF                                                                                       // set by library:flashiap-block-device
#define MBED_CONF_FLASHIAP_BLOCK_DEVICE_SIZE                              0                                                                                                // set by library:flashiap-block-device
#define MBED_CONF_LORA_ADR_ON                                             1                                                                                                // set by library:lora
#define MBED_CONF_LORA_APPLICATION_EUI                                    {0x00, 0x00, 0x00, 0x00, 0x00, 0x00, 0x00, 0x00}                                                 // set by library:lora
#define MBED_CONF_LORA_APPLICATION_KEY                                    {0x00, 0x00, 0x00, 0x00, 0x00, 0x00, 0x00, 0x00, 0x00, 0x00, 0x00, 0x00, 0x00, 0x00, 0x00, 0x00} // set by library:lora
#define MBED_CONF_LORA_APPSKEY                                            {0x00, 0x00, 0x00, 0x00, 0x00, 0x00, 0x00, 0x00, 0x00, 0x00, 0x00, 0x00, 0x00, 0x00, 0x00, 0x00} // set by library:lora
#define MBED_CONF_LORA_APP_PORT                                           15                                                                                               // set by library:lora
#define MBED_CONF_LORA_AUTOMATIC_UPLINK_MESSAGE                           1                                                                                                // set by library:lora
#define MBED_CONF_LORA_DEVICE_ADDRESS                                     0x00000000                                                                                       // set by library:lora
#define MBED_CONF_LORA_DEVICE_EUI                                         {0x00, 0x00, 0x00, 0x00, 0x00, 0x00, 0x00, 0x00}                                                 // set by library:lora
#define MBED_CONF_LORA_DOWNLINK_PREAMBLE_LENGTH                           5                                                                                                // set by library:lora
#define MBED_CONF_LORA_DUTY_CYCLE_ON                                      1                                                                                                // set by library:lora
#define MBED_CONF_LORA_DUTY_CYCLE_ON_JOIN                                 1                                                                                                // set by library:lora
#define MBED_CONF_LORA_FSB_MASK                                           {0xFFFF, 0xFFFF, 0xFFFF, 0xFFFF, 0x00FF}                                                         // set by library:lora
#define MBED_CONF_LORA_FSB_MASK_CHINA                                     {0xFFFF, 0xFFFF, 0xFFFF, 0xFFFF, 0xFFFF, 0xFFFF}                                                 // set by library:lora
#define MBED_CONF_LORA_LBT_ON                                             0                                                                                                // set by library:lora
#define MBED_CONF_LORA_MAX_SYS_RX_ERROR                                   5                                                                                                // set by library:lora
#define MBED_CONF_LORA_NB_TRIALS                                          12                                                                                               // set by library:lora
#define MBED_CONF_LORA_NWKSKEY                                            {0x00, 0x00, 0x00, 0x00, 0x00, 0x00, 0x00, 0x00, 0x00, 0x00, 0x00, 0x00, 0x00, 0x00, 0x00, 0x00} // set by library:lora
#define MBED_CONF_LORA_OVER_THE_AIR_ACTIVATION                            1                                                                                                // set by library:lora
#define MBED_CONF_LORA_PHY                                                EU868                                                                                            // set by library:lora
#define MBED_CONF_LORA_PUBLIC_NETWORK                                     0                                                                                                // set by application[PART_SENS_V1]
#define MBED_CONF_LORA_TX_MAX_SIZE                                        64                                                                                               // set by library:lora
#define MBED_CONF_LORA_UPLINK_PREAMBLE_LENGTH                             8                                                                                                // set by library:lora
#define MBED_CONF_LORA_WAKEUP_TIME                                        5                                                                                                // set by library:lora
#define MBED_CONF_NANOSTACK_LIBSERVICE_PRESENT                            1                                                                                                // set by library:nanostack-libservice
#define MBED_CONF_PLATFORM_CALLBACK_COMPARABLE                            1                                                                                                // set by library:platform
#define MBED_CONF_PLATFORM_CALLBACK_NONTRIVIAL                            0                                                                                                // set by library:platform
#define MBED_CONF_PLATFORM_CRASH_CAPTURE_ENABLED                          1                                                                                                // set by library:platform[NUCLEO_L476RG]
#define MBED_CONF_PLATFORM_CTHUNK_COUNT_MAX                               8                                                                                                // set by library:platform
#define MBED_CONF_PLATFORM_DEFAULT_SERIAL_BAUD_RATE                       115200                                                                                           // set by application[PART_SENS_V1]
#define MBED_CONF_PLATFORM_ERROR_ALL_THREADS_INFO                         0                                                                                                // set by library:platform
#define MBED_CONF_PLATFORM_ERROR_FILENAME_CAPTURE_ENABLED                 0                                                                                                // set by library:platform
#define MBED_CONF_PLATFORM_ERROR_HIST_ENABLED                             0                                                                                                // set by library:platform
#define MBED_CONF_PLATFORM_ERROR_HIST_SIZE                                4                                                                                                // set by library:platform
#define MBED_CONF_PLATFORM_ERROR_REBOOT_MAX                               5                                                                                                // set by application[PART_SENS_V1]
#define MBED_CONF_PLATFORM_FATAL_ERROR_AUTO_REBOOT_ENABLED                1                                                                                                // set by library:platform[NUCLEO_L476RG]
#define MBED_CONF_PLATFORM_MAX_ERROR_FILENAME_LEN                         16                                                                                               // set by library:platform
#define MBED_CONF_PLATFORM_MINIMAL_PRINTF_ENABLE_64_BIT                   1                                                                                                // set by library:platform
#define MBED_CONF_PLATFORM_MINIMAL_PRINTF_ENABLE_FLOATING_POINT           0                                                                                                // set by library:platform
#define MBED_CONF_PLATFORM_MINIMAL_PRINTF_SET_FLOATING_POINT_MAX_DECIMALS 6                                                                                                // set by library:platform
#define MBED_CONF_PLATFORM_POLL_USE_LOWPOWER_TIMER                        0                                                                                                // set by library:platform
#define MBED_CONF_PLATFORM_STDIO_BAUD_RATE                                115200                                                                                           // set by application[PART_SENS_V1]
#define MBED_CONF_PLATFORM_STDIO_BUFFERED_SERIAL                          0                                                                                                // set by library:platform
#define MBED_CONF_PLATFORM_STDIO_CONVERT_NEWLINES                         1                                                                                                // set by application[PART_SENS_V1]
#define MBED_CONF_PLATFORM_STDIO_CONVERT_TTY_NEWLINES                     1                                                                                                // set by application[PART_SENS_V1]
#define MBED_CONF_PLATFORM_STDIO_FLUSH_AT_EXIT                            1                                                                                                // set by library:platform
#define MBED_CONF_PLATFORM_STDIO_MINIMAL_CONSOLE_ONLY                     0                                                                                                // set by library:platform
#define MBED_CONF_PLATFORM_USE_MPU                                        1                                                                                                // set by library:platform
#define MBED_CONF_RTOS_API_PRESENT                                        1                                                                                                // set by library:rtos-api
#define MBED_CONF_RTOS_EVFLAGS_NUM                                        0                                                                                                // set by library:rtos
#define MBED_CONF_RTOS_IDLE_THREAD_STACK_SIZE                             512                                                                                              // set by library:rtos
#define MBED_CONF_RTOS_IDLE_THREAD_STACK_SIZE_DEBUG_EXTRA                 128                                                                                              // set by library:rtos[STM]
#define MBED_CONF_RTOS_IDLE_THREAD_STACK_SIZE_TICKLESS_EXTRA              512                                                                                              // set by application[PART_SENS_V1]
#define MBED_CONF_RTOS_MAIN_THREAD_STACK_SIZE                             16384                                                                                            // set by application[PART_SENS_V1]
#define MBED_CONF_RTOS_MSGQUEUE_DATA_SIZE                                 0                                                                                                // set by library:rtos
#define MBED_CONF_RTOS_MSGQUEUE_NUM                                       0                                                                                                // set by library:rtos
#define MBED_CONF_RTOS_MUTEX_NUM                                          0                                                                                                // set by library:rtos
#define MBED_CONF_RTOS_PRESENT                                            1                                                                                                // set by library:rtos
#define MBED_CONF_RTOS_SEMAPHORE_NUM                                      0                                                                                                // set by library:rtos
#define MBED_CONF_RTOS_THREAD_NUM                                         0                                                                                                // set by library:rtos
#define MBED_CONF_RTOS_THREAD_STACK_SIZE                                  4096                                                                                             // set by library:rtos
#define MBED_CONF_RTOS_THREAD_USER_STACK_SIZE                             0                                                                                                // set by library:rtos
#define MBED_CONF_RTOS_TIMER_NUM                                          0                                                                                                // set by library:rtos
#define MBED_CONF_RTOS_TIMER_THREAD_STACK_SIZE                            768                                                                                              // set by library:rtos
#define MBED_CONF_SD_CMD0_IDLE_STATE_RETRIES                              5                                                                                                // set by library:sd
#define MBED_CONF_SD_CMD_TIMEOUT                                          10000                                                                                            // set by library:sd
#define MBED_CONF_SD_CRC_ENABLED                                          0                                                                                                // set by library:sd
#define MBED_CONF_SD_FSFAT_SDCARD_INSTALLED                               1                                                                                                // set by library:sd
#define MBED_CONF_SD_INIT_FREQUENCY                                       100000                                                                                           // set by library:sd
#define MBED_CONF_SD_SPI_CLK                                              PC_10                                                                                            // set by application[PART_SENS_V1]
#define MBED_CONF_SD_SPI_CS                                               PC_8                                                                                             // set by application[PART_SENS_V1]
#define MBED_CONF_SD_SPI_MISO                                             PC_11                                                                                            // set by application[PART_SENS_V1]
#define MBED_CONF_SD_SPI_MOSI                                             PC_12                                                                                            // set by application[PART_SENS_V1]
#define MBED_CONF_SD_TEST_BUFFER                                          8192                                                                                             // set by library:sd
#define MBED_CONF_SD_TRX_FREQUENCY                                        1000000                                                                                          // set by library:sd
#define MBED_CONF_SX126X_LORA_DRIVER_BOOST_RX                             0                                                                                                // set by library:SX126X-lora-driver
#define MBED_CONF_SX126X_LORA_DRIVER_BUFFER_SIZE                          255                                                                                              // set by library:SX126X-lora-driver
#define MBED_CONF_SX126X_LORA_DRIVER_REGULATOR_MODE                       0                                                                                                // set by application[PART_SENS_V1]
#define MBED_CONF_SX126X_LORA_DRIVER_SLEEP_MODE                           0                                                                                                // set by application[PART_SENS_V1]
#define MBED_CONF_SX126X_LORA_DRIVER_SPI_FREQUENCY                        16000000                                                                                         // set by library:SX126X-lora-driver
#define MBED_CONF_SX126X_LORA_DRIVER_STANDBY_MODE                         0                                                                                                // set by application[PART_SENS_V1]
#define MBED_CONF_TARGET_BOOT_STACK_SIZE                                  0x400                                                                                            // set by library:rtos[*]
#define MBED_CONF_TARGET_CONSOLE_UART                                     1                                                                                                // set by target:Target
#define MBED_CONF_TARGET_DEEP_SLEEP_LATENCY                               4                                                                                                // set by target:MCU_STM32
#define MBED_CONF_TARGET_DEFAULT_ADC_VREF                                 9.9                                                                                              // set by application[PART_SENS_V1]
#define MBED_CONF_TARGET_INIT_US_TICKER_AT_BOOT                           1                                                                                                // set by target:MCU_STM32
#define MBED_CONF_TARGET_INTERNAL_FLASH_UNIFORM_SECTORS                   1                                                                                                // set by target:Target
#define MBED_CONF_TARGET_LPTICKER_LPTIM                                   1                                                                                                // set by target:MCU_STM32L4
#define MBED_CONF_TARGET_LPTICKER_LPTIM_CLOCK                             1                                                                                                // set by target:MCU_STM32
#define MBED_CONF_TARGET_LPUART_CLOCK_SOURCE                              USE_LPUART_CLK_LSE|USE_LPUART_CLK_PCLK1                                                          // set by target:MCU_STM32
#define MBED_CONF_TARGET_LSE_AVAILABLE                                    1                                                                                                // set by application[PART_SENS_V1]
#define MBED_CONF_TARGET_MPU_ROM_END                                      0x0fffffff                                                                                       // set by target:Target
#define MBED_CONF_TARGET_TICKLESS_FROM_US_TICKER                          0                                                                                                // set by target:Target
#define MBED_CONF_TARGET_XIP_ENABLE                                       0                                                                                                // set by target:Target
#define MBED_CRC_TABLE_SIZE                                               16                                                                                               // set by library:drivers
#define MBED_LFS2_BLOCK_CYCLES                                            1024                                                                                             // set by library:littlefs2
#define MBED_LFS2_BLOCK_SIZE                                              512                                                                                              // set by library:littlefs2
#define MBED_LFS2_CACHE_SIZE                                              64                                                                                               // set by library:littlefs2
#define MBED_LFS2_ENABLE_INFO                                             0                                                                                                // set by library:littlefs2
#define MBED_LFS2_INTRINSICS                                              1                                                                                                // set by library:littlefs2
#define MBED_LFS2_LOOKAHEAD_SIZE                                          64                                                                                               // set by library:littlefs2
#define MBED_LFS_BLOCK_SIZE                                               512                                                                                              // set by library:littlefs
#define MBED_LFS_ENABLE_INFO                                              0                                                                                                // set by library:littlefs
#define MBED_LFS_INTRINSICS                                               1                                                                                                // set by library:littlefs
#define MBED_LFS_LOOKAHEAD                                                512                                                                                              // set by library:littlefs
#define MBED_LFS_PROG_SIZE                                                64                                                                                               // set by library:littlefs
#define MBED_LFS_READ_SIZE                                                64                                                                                               // set by library:littlefs
#define MBED_STACK_DUMP_ENABLED                                           0                                                                                                // set by library:platform
#define MEM_ALLOC                                                         malloc                                                                                           // set by library:mbed-trace
#define MEM_FREE                                                          free                                                                                             // set by library:mbed-trace
// Macros
#define _RTE_                                                                                                                                                              // defined by library:rtos

#endif
