wuzipu123/software/Software/Sensor/SPS30/inc/main.h

/*
 * main.h
 *
 *  Created on: 06.06.2019
 *      Author: mknoll
 */

#ifndef MAIN_H_
#define MAIN_H_

//#include "stm32_hal_legacy.h"
#include "stm32l0xx_hal.h"
//#include "stm32l021xx.h"
//#include "stm32l0xx.h"

#endif /* MAIN_H_ */
