wuzipu123/software/Software/Sensor/BME280-A4/src/BME280_SPI_functions.c

#include "BME280_SPI_functions.h"
#include "stm32l0xx.h"
#include "HW_init.h"
#include "defines.h"
#include "stdbool.h"
#include "stdint.h"

extern SPI_HandleTypeDef SpiHandle;

int8_t user_spi_write(uint8_t dev_id, uint8_t reg_addr, uint8_t *reg_data, uint16_t len)
{
    int8_t rslt = 0; /* Return 0 for Success, non-zero for failure */

    /*
     * The parameter dev_id can be used as a variable to select which Chip Select pin has
     * to be set low to activate the relevant device on the SPI bus
     */

    /*
     * Data on the bus should be like
     * |---------------------+--------------+-------------|
     * | MOSI                | MISO         | Chip Select |
     * |---------------------+--------------|-------------|
     * | (don't care)        | (don't care) | HIGH        |
     * | (reg_addr)          | (don't care) | LOW         |
     * | (reg_data[0])       | (don't care) | LOW         |
     * | (....)              | (....)       | LOW         |
     * | (reg_data[len - 1]) | (don't care) | LOW         |
     * | (don't care)        | (don't care) | HIGH        |
     * |---------------------+--------------|-------------|
     */

    //uint8_t SPIMode=0;
    //HW_init_set_SPI(&SpiHandle, SPIMode);
    HAL_GPIO_WritePin(GPIOA, GPIO_PIN_15, GPIO_PIN_RESET); //select active low BME280 NSS
    HAL_SPI_Transmit(&SpiHandle, &reg_addr, 1, HAL_MAX_DELAY);
    HAL_SPI_Transmit(&SpiHandle, reg_data, len, HAL_MAX_DELAY);
    HAL_GPIO_WritePin(GPIOA, GPIO_PIN_15, GPIO_PIN_SET); //reset active low BME280 NSS

    return rslt;
}

void user_delay_ms(uint32_t period)
{
    /*
     * Return control or wait,
     * for a period amount of milliseconds
     */
	HAL_Delay(period);
}

int8_t user_spi_read(uint8_t dev_id, uint8_t reg_addr, uint8_t *reg_data, uint16_t len)
{
    int8_t rslt = 0; /* Return 0 for Success, non-zero for failure */

    /*
     * The parameter dev_id can be used as a variable to select which Chip Select pin has
     * to be set low to activate the relevant device on the SPI bus
     */

    /*
     * Data on the bus should be like
     * |----------------+---------------------+-------------|
     * | MOSI           | MISO                | Chip Select |
     * |----------------+---------------------|-------------|
     * | (don't care)   | (don't care)        | HIGH        |
     * | (reg_addr)     | (don't care)        | LOW         |
     * | (don't care)   | (reg_data[0])       | LOW         |
     * | (....)         | (....)              | LOW         |
     * | (don't care)   | (reg_data[len - 1]) | LOW         |
     * | (don't care)   | (don't care)        | HIGH        |
     * |----------------+---------------------|-------------|
     */

    //uint8_t SPIMode=0;
    //HW_init_set_SPI(&SpiHandle, SPIMode);
    HAL_GPIO_WritePin(GPIOA, GPIO_PIN_15, GPIO_PIN_RESET); //select active low BME280 NSS
    HAL_SPI_Transmit(&SpiHandle, &reg_addr, 1, HAL_MAX_DELAY);
    HAL_SPI_Receive(&SpiHandle, reg_data, len, HAL_MAX_DELAY);
    HAL_GPIO_WritePin(GPIOA, GPIO_PIN_15, GPIO_PIN_SET); //reset active low BME280 NSS
    return rslt;
}
