wuzipu123/software/Software/Sensor/BME280-A4/inc/Error_Handler.h

/*
 * Error_Handler.h
 *
 *  Created on: 09.10.2019
 *      Author: fsommer
 */

#ifndef ERROR_HANDLER_H
#define ERROR_HANDLER_H

#include "stm32l0xx.h"
#include "stm32l0xx_hal.h"
#include "defines.h"


void Error_Handler(void);


#endif /* ERROR_HANDLER_H */
