wuzipu123/software/Software/Particle_Sensor_Hardware_Test/src/lora.h

//
// Created by stefan on 10.09.20.
//

#ifndef SENSOR_NODE_LORA_SPS30_HW_TEST_LORA_H
#define SENSOR_NODE_LORA_SPS30_HW_TEST_LORA_H

int ping_pong();
void button_pressed();
void radio_sleep();

#endif //SENSOR_NODE_LORA_SPS30_HW_TEST_LORA_H
