wuzipu123/software/(notices)

Notices in the files:
Mechanical/Particle_Sensor/downloaded_3D_models/Micro_USB_Connector_USB3076-30-A.stp:
FILE_NAME( 'p:/temp/worker_1012/temp/exporttempdir_2080_7_kd3xe/format_0/USB3076-30-A.stp', '2020-08-20T12:48:50', ( 'License CC BY-ND 4.0' ), ( 'CADENAS' ), ' ', 'PARTsolutions', ' ' );
